PabloSoage/kv260-ias2rf/README.md

# KV260-IAS2RF — an RF front-end carrier for the AMD Kria KV260

**Status (12 November 2026): schematic and layout complete, on 8 layers. The board is fully routed, with zero
DRC errors and zero schematic-parity problems. It has not been fabricated, and no hardware has
been validated.** A few review items remain before an order (see [Status](#status)).

> **Rev06 (14 November 2026), now on `main`; Rev05 is tag `rev05`.** Rev06 gives Gigabit Ethernet its own FPGA pins, so the IAS1 link keeps
> both uplink lanes and its downlink and Ethernet adds about 1 Gb/s on top: either path works alone, both
> together carry about 3 Gb/s, with failover in the gateware ([CONTROL_SPEC §8](docs/CONTROL_SPEC.md),
> [fpga/eth/REV06.md](fpga/eth/REV06.md)). It also adds a 5 V fan header for enclosure v2
> ([ENCLOSURE §6](docs/ENCLOSURE.md)). Routed with zero DRC errors and zero parity problems. The full pre-order
> review (RF, power, ESD, thermal, routing, the enclosure's 3-D FEA with the boards, and the two-FPGA system
> simulation) is [docs/REV06_REVIEW.md](docs/REV06_REVIEW.md).

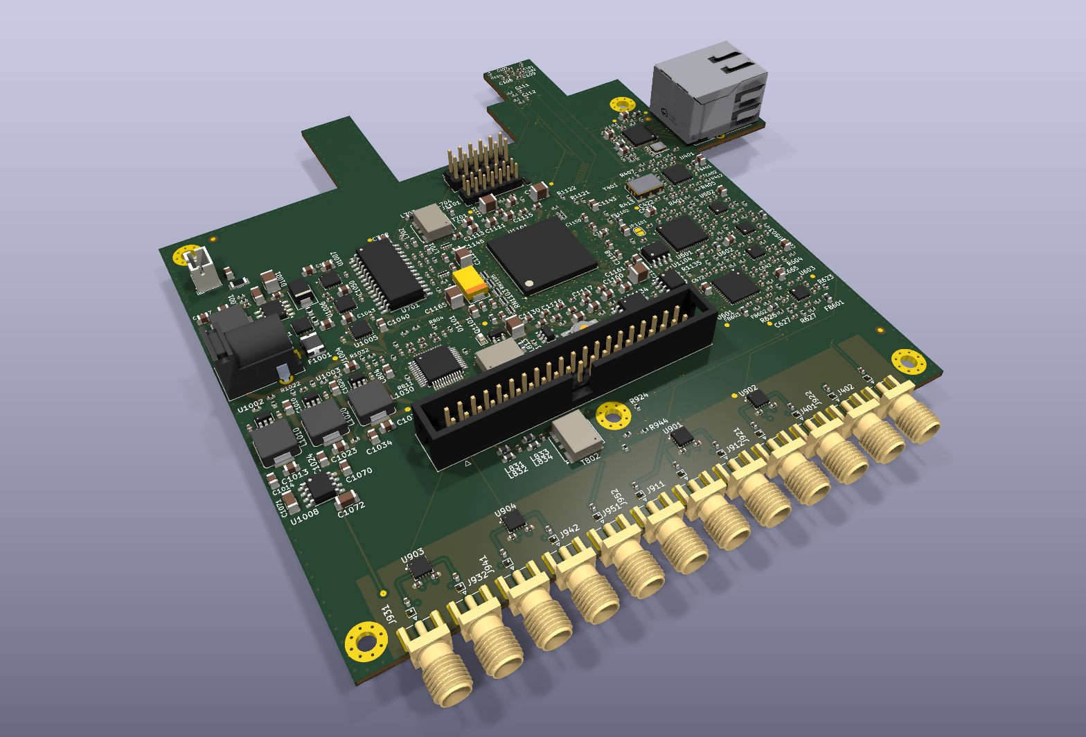
[picture p1: docs/img/board_iso.png]
The board, 3D render


An adapter board for the **AMD Kria KV260 Vision AI Starter Kit**. It plugs into the KV260's IAS1
camera connector and carries the converters, a common clock and a front-end FPGA. It serves two
signal chains:

- **Software-defined radio**: HF, AM, FM, airband, amateur bands and PMR446. Receive, and
  transmit on the bands a licence covers.
- **Radar at 10.5 GHz**: the IF of the X-band chain from the open
  [AERIS-10 / PLFM_RADAR](https://github.com/NawfalMotii79/PLFM_RADAR) project, with ADAR1000
  beamforming. The 10.5 GHz chain itself is reused from AERIS-10, not redesigned here. The board
  is sized for 8 ADAR1000s (32 channels), so it covers both the Nexus variant (4 chips) and the
  Extended one (8 chips).

> ### The finding that shapes the whole project
>
> The **IAS0 (J7) connector on the KV260 does not reach the programmable logic**: its MIPI lanes
> run into an AP1302 ISP soldered on the carrier card. Only **IAS1 (J8)** is wired straight to
> the SOM. On top of that, **the KV260 has no 40-pin Raspberry Pi header** (J9 is a 15-pin
> camera connector), and **the GTH transceivers are not exposed**.
>
> The real I/O budget between a KV260 and an external board is **8 differential pairs and about
> 14 single-ended signals**. That is why the board has its own FPGA. The evidence and sources are
> in [docs/BLOCKERS_AND_RISKS.md](docs/BLOCKERS_AND_RISKS.md).

---

## The board at a glance

| | |
|---|---|
| Size | 119 × 132 mm, 140 × 132 with the RJ45's tab. It mounts on the KV260's IAS connectors and corner holes and overhangs to one side ([INTERFACE_SPEC §5.3](docs/INTERFACE_SPEC.md)) |
| Stackup | 8 layers, JLCPCB JLC08161H-2116C: signal, GND, signal, split power, GND, signal, GND, signal ([LAYOUT §3](docs/LAYOUT.md); 6 layers until 12 Nov, [compared in EIGHT_LAYERS](docs/EIGHT_LAYERS.md)) |
| Parts | 534 fitted: the top face, plus 20 on the bottom face under the FPGA (LVDS terminations and VCCINT caps); 4 DNP for the Ethernet option |
| Front-end FPGA | Xilinx XC7A50T-2FTG256I (the same part as AERIS-10) with a 128 Mb QSPI flash, plus JTAG |
| Radar ADC | AD9484, 8 bit, 400 MSPS, driven by two cascaded AD8352s |
| SDR ADC | AD9253, 14 bit, two channels at 62.5 MSPS (one LVDS lane each) |
| Radar DAC | AD9708, with reconstruction filter and balun |
| SDR DAC | AD9767, dual 14 bit, two output chains |
| Clock | Si549 programmable XO (400 or 500 MHz, GPS-disciplinable) into an ADCLK948 LVPECL fan-out |
| RF routing | Four M3SWA2-34DR+ SPDT switches and ten edge SMAs, plus two clock SMAs |
| Link to the Kria | IAS1 (Hirose BM20B), five LVDS pairs at up to 1 Gb/s each, AC-coupled; the Pmod J2 for control |
| Ethernet (option) | Gigabit RJ45 through an RTL8211FSI SGMII PHY, which shares two of the link's pairs: fit C1218–C1221 and remove C101, C102, C107, C108 to use it ([CONTROL_SPEC §7](docs/CONTROL_SPEC.md)) |
| To AERIS-10 | 2×20 IDC ribbon for eight ADAR1000s |
| Power | 12 V in; buck and LDO tree for 5 V, 3.3 V, 2.5 V, 1.8 V and 1.0 V, plus −3.3 V for the switches |

```mermaid
flowchart LR
  KV260["Kria KV260<br/>(K26 SOM)"] <-- "IAS1: 5 LVDS pairs<br/>Pmod: control" --> FPGA["XC7A50T<br/>front-end FPGA"]
  FPGA <-- LVDS --> ADCR["AD9484<br/>radar ADC"]
  FPGA <-- LVDS --> ADCS["AD9253<br/>SDR ADC"]
  FPGA --> DACR["AD9708<br/>radar DAC"]
  FPGA --> DACS["AD9767<br/>SDR DAC"]
  CLK["Si549 + ADCLK948<br/>clock"] --> ADCR & ADCS & DACR & DACS & FPGA
  ADCR & ADCS & DACR & DACS <--> RF["RF switches<br/>10 SMAs"]
  FPGA <-- "IDC ribbon" --> AERIS["AERIS-10<br/>8 × ADAR1000"]
  RF <--> AERIS
```

| Top | Bottom |
|---|---|
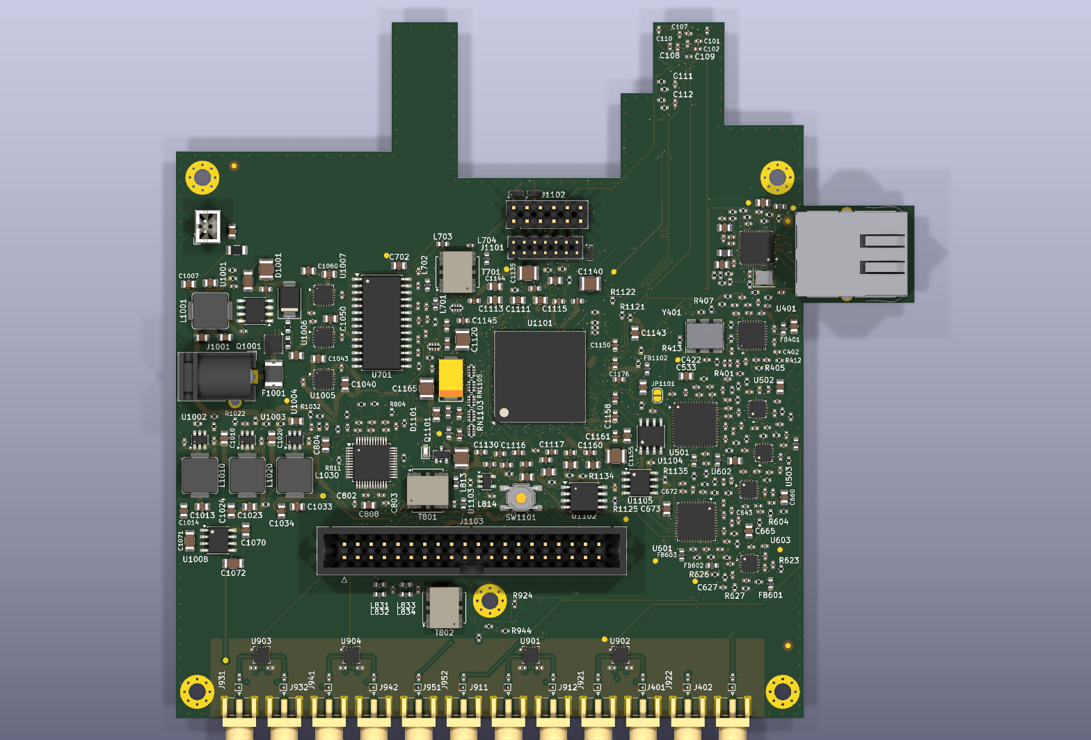
[picture p2: docs/img/board_top.png]
Top
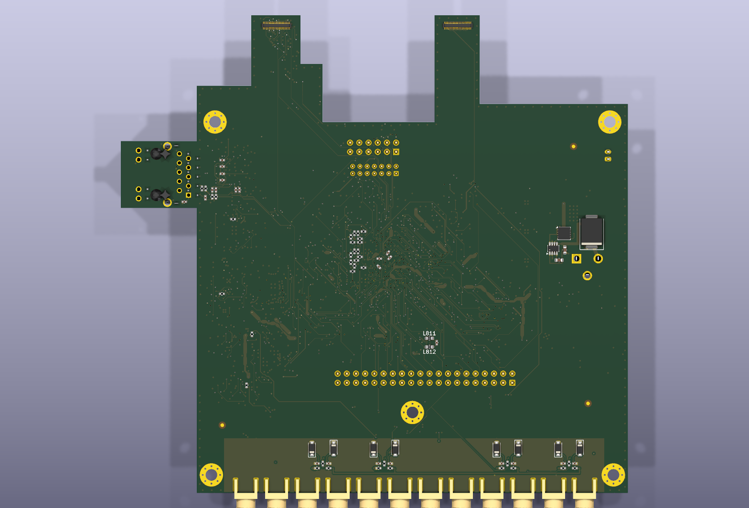
[picture p3: docs/img/board_bottom.png]
Bottom
|  |  |

The renders come from KiCad. Some parts have no 3D model, so they show only their pads (the FPGA's
BGA, for one).

---

## Schematics and layout

- **[Schematic, all 10 sheets (PDF)](docs/CSI2-KRIA-KV260_Rev04_schematic.pdf)**
- **[Layout, the eight copper layers and both silkscreens (PDF)](docs/CSI2-KRIA-KV260_Rev04_layout.pdf)**
- KiCad 10 sources: [`CSI2-KRIA-KV260_Rev01.kicad_pro`](CSI2-KRIA-KV260_Rev01.kicad_pro), the root
  schematic and [`rev03/`](rev03/) (the nine sheets), the board
  [`CSI2-KRIA-KV260_Rev01.kicad_pcb`](CSI2-KRIA-KV260_Rev01.kicad_pcb), and the project's own
  symbols and footprints in [`symbols/`](symbols/) and [`footprints/`](footprints/). The file names
  keep the Rev01 name of the board they started from, and the sheets sit in `rev03/` where they
  were drawn; the contents are Rev04 (the 8-layer board, 12 Nov 2026).

| Sheet | Contents | Specification |
|---|---|---|
| [Root](docs/img/sch/ROOT.png) | Sheet hierarchy and the interface nets | [ARCHITECTURE](ARCHITECTURE.md) |
| [IAS_LINK](docs/img/sch/IAS_LINK.png) | The Hirose connectors, AC coupling and terminations of the link | [IAS_LINK_SPEC](docs/IAS_LINK_SPEC.md) |
| [CLOCK](docs/img/sch/CLOCK.png) | Si549, reference select and LVPECL fan-out | [CLOCK_SPEC](docs/CLOCK_SPEC.md) |
| [ADC_RADAR](docs/img/sch/ADC_RADAR.png) | AD9484 and its two AD8352 drivers | [ADC_RADAR_SPEC](docs/ADC_RADAR_SPEC.md) |
| [ADC_SDR](docs/img/sch/ADC_SDR.png) | AD9253, two channels | [ADC_SDR_SPEC](docs/ADC_SDR_SPEC.md) |
| [DAC_RADAR](docs/img/sch/DAC_RADAR.png) | AD9708, filter and balun | [DAC_RADAR_SPEC](docs/DAC_RADAR_SPEC.md) |
| [DAC_SDR](docs/img/sch/DAC_SDR.png) | AD9767 in interleaved mode, two output chains | [DAC_SDR_SPEC](docs/DAC_SDR_SPEC.md) |
| [ROUTING](docs/img/sch/ROUTING.png) | Four RF switches and the SMAs | [ROUTING_SPEC](docs/ROUTING_SPEC.md) |
| [CONTROL](docs/img/sch/CONTROL.png) | The front-end FPGA: banks, configuration, Pmod, AERIS ribbon, housekeeping | [CONTROL_SPEC](docs/CONTROL_SPEC.md) |
| [POWER](docs/img/sch/POWER.png) | The power tree | [POWER_SPEC](docs/POWER_SPEC.md) |

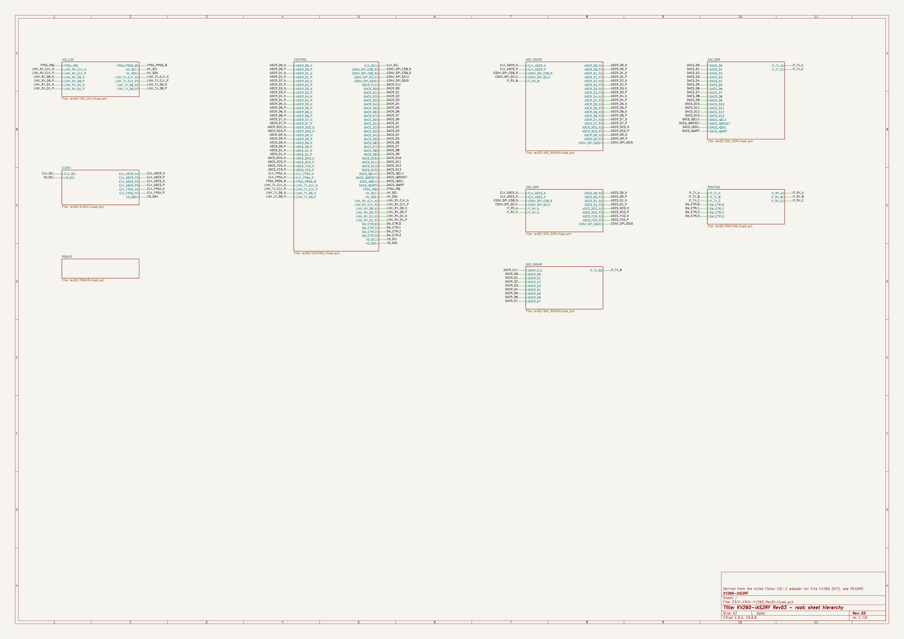
[picture p4: docs/img/sch/ROOT.png]
Root sheet


---

## Status

| Check | Result |
|---|---|
| ERC | 0 errors; 7 warnings, all explained: configuration and XADC pins tied to power on purpose ([CONTROL_SPEC §5](docs/CONTROL_SPEC.md)) |
| DRC, zones refilled | **0 violations, 0 unrouted connections, 0 schematic-parity problems** (12 Nov, on 8 layers) |
| Signal and power integrity | Reviewed on 11 Nov and re-run on 8 layers on 12 Nov, ideal / 6 / 8 layers side by side ([EIGHT_LAYERS.md](docs/EIGHT_LAYERS.md), [SIGNAL_INTEGRITY.md](docs/SIGNAL_INTEGRITY.md)): SMA launch in openEMS (S11 −30.9 dB at 1 GHz with the ESD diode), LVDS eyes within 1–26 mV of ideal except LINK_RX_D0 (−52 mV), worst intra-pair skew 9 ps, VCCINT under its target to 100 MHz with four caps under the BGA; ESD protection on every SMA, the Pmod and JTAG, a GND via within 3 mm of every LVDS layer change, exposed-pad vias and an edge fence |
| Planes | L2 and L5 carry only ground, no supply track (`_work/layout/planechk.py`); every supply pin reaches its island (the DRC's zero unrouted) |
| Mechanical fit | Registered on AMD's 3D model of the KV260: the mounting holes land within 5 µm ([INTERFACE_SPEC §5.3](docs/INTERFACE_SPEC.md)) |

**Open before ordering** ([docs/LAYOUT.md §6.2–6.3](docs/LAYOUT.md)):

1. **The rest of the board, reviewed on 12 Nov** ([SIGNAL_INTEGRITY §9](docs/SIGNAL_INTEGRITY.md)).
   - **Fixed.** The router had necked supply tracks and the bucks' switch nodes to 0.1 mm: 1.6 A
     through 0.1 mm at U1001, and a 251 mV drop on the ADCs' +1V8_A. The supply tracks are now
     widened (865 mm at ≥ 0.5 mm, against 119), and +1V8_A starts at 1.85 V to cover what is
     left of the drop.
   - **Analogue nodes.** Digital tracks beside the analogue nodes are down to 81 mm within
     0.3 mm, from 91. Most of what was left was where the SDR DAC's filters crossed the DAC bus.
     On 12 Nov DAC2's filter was re-placed next to its balun and DAC1's middle node re-routed as
     a pair: their digital neighbours went from 59 mm to 14 mm. DAC2's common mode at the balun
     fell by 9–21 dB. On 13 Nov DAC1's filter followed, onto the bottom face under T801 (its
     middle node 51 → 3 mm, common mode 1–6 dB lower), the reference oscillator's pair was
     coupled and matched, and the SDR ADC's input network was simulated: its copper costs
     nothing in band, so it stays.
   - **Thermal.** 7.5 W on 134 cm² in still air (with the Ethernet PHY): +27 °C mean and +51 °C at the clock buffer. Fine
     on the bench. A vehicle install needs airflow or a path to the enclosure.
2. **Ten of the 19 LVDS pairs are not coupled** (11 of 22 counting U401's three clock pairs:
   `CLK_ADCS` and `CLK_FPGA` were re-routed as coupled pairs on 12 Nov, `CLK_FPGA` after its
   four pad resistors were re-placed together; SIGNAL_INTEGRITY §9.4). Since 12 Nov the board has 8 layers and nine pairs
   run coupled at 100 Ω end to end ([EIGHT_LAYERS.md](docs/EIGHT_LAYERS.md)). The other ten are
   two 50 Ω legs matched to ±5 ps, within 1–26 mV of their ideal eye except LINK_RX_D0 (−52 mV).
   LINK_RX leaves bank 34, the only 2.5 V bank, in the BGA's south-east corner, and crosses every
   ADC pair to AC capacitors spread 9 mm apart; moving it to the bank's outer balls was tried on
   12 Nov and dropped (the corner has no room left for the vias). Coupling it would need the
   capacitors at J101 moved together first.
3. **ADCR data to DCO skew, −90 to +5 ps** (was −177 to −28). DCO's legs are swapped at the FPGA
   (N14 = DCO_N, P14 = DCO_P) so the pair reaches the AD9484 the right way round without going
   round the chip: 39 mm instead of 51. **The gateware must invert that clock** (ISERDESE2
   `IS_CLK_INVERTED`, or capture on the other edge) ([CONTROL_SPEC §1](docs/CONTROL_SPEC.md)).
   The rest is inside IDELAYE2's range and calibrated per bit.
4. **Order the 2116C stack explicitly** (JLC08161H-2116C): the widths are solved for it
   ([FABRICATION.md](docs/FABRICATION.md)). Five 8-layer bare boards: $287.96 at 140 × 132 mm with the Ethernet tab ($282.92 without it, $236.88 on 6 layers).
5. **The Kria side of the link is `DIFF_SSTL12`, not `LVDS_12`** (UG571 read on 12 Nov,
   [INTERFACE_SPEC §6.3](docs/INTERFACE_SPEC.md)). No `LVDS_12` exists. `LVDS` at 1.2 V is
   input-only with no internal termination. `DIFF_SSTL12` has on-die split termination
   (`RTT_48`, about 96 Ω biased at 0.6 V) and drives through `RDRV_60_60`. No change to the board.
   Still to confirm in DS925: its input threshold and the −2LV rate ceiling. The link carries 2 Gb/s towards the Kria and 1 Gb/s back (two of its five
   pairs are clocks), with a ceiling of about 1.25 Gb/s per pair set by the silicon
   ([IAS_LINK_SPEC §7](docs/IAS_LINK_SPEC.md)).
6. **3-D full-wave sub-models (openEMS), not yet inside the eye simulation.**
   - **Layer change L1 to L6.** The pair reflects under −29 dB up to 1.25 GHz, with or without
     ground vias. Without them 7 % of the common mode's power leaks into the plane cavity; with
     two, 1 %.
   - **BGA escape.** The 0.10 mm necks reflect under −24 dB at 1.25 GHz.
   - **Two pairs side by side.** The board's worst run couples 1.9 % of a 300 ps edge onto the
     nearest leg, not the 7 % the 2-D estimate gave.
   - **J101's footprint**, from the Hirose pins to the AC capacitors: reflection under −25 dB to 1.25 GHz,
     but the legs' different escapes turn 9 % of the differential wave into common mode.

   Done, in [SIGNAL_INTEGRITY §9.6](docs/SIGNAL_INTEGRITY.md):
   - **Receive budgets.** Radar: full scale −17.6 dBm, NF 26.8 dB. SDR: full scale −2.4 and
     −3.0 dBm, NF 22 dB. On both, the ADC is 80–92 % of the noise.
   - **Transmit levels** and **the DAC filters with their copper.**
   - **The board's thermal map**, with junctions for every part that has data. At 25 °C in still
     air, the hottest junction is the ADCLK948 at 84 °C and the FPGA is at 63 °C. A vehicle
     needs airflow: a heatsink on the ICs and the regulators, with a fan, keeps every junction
     under 92 °C at 70 °C ambient.

   The first boards are for evaluation.
7. **The AERIS-10 end of the ribbon does not exist yet.**
8. **No firmware.** The FPGA design for the front end and the Kria side of the link are not
   written yet.

**Cost** ([docs/JLCPCB_QUOTE.md](docs/JLCPCB_QUOTE.md), bare boards re-quoted on 8 layers on 12 Nov 2026): about **$2,070 for two
assembled boards** and $4,240 for five, three quarters of it parts. Seven parts are out of stock at
LCSC today (the ADCs, the RF switches, the clock buffer, the DAC, a balun and the drivers): JLCPCB's
global sourcing or consigned parts cover them.

---

## Documentation

| Document | Contents |
|---|---|
| **[docs/VEHICLE_PLATFORM.md](docs/VEHICLE_PLATFORM.md)** | **System view.** The whole vehicle project: LiDAR, SDR, radar, OBD2 |
| [docs/SHOPPING_LIST.md](docs/SHOPPING_LIST.md) | Parts and checklist per stage, with indicative costs |
| [ARCHITECTURE.md](ARCHITECTURE.md) | Master document for this board: the Rev03 architecture and BOM |
| [docs/BLOCKERS_AND_RISKS.md](docs/BLOCKERS_AND_RISKS.md) | The five blockers, closed, with evidence and sources, plus the open risks |
| [docs/INTERFACE_SPEC.md](docs/INTERFACE_SPEC.md) | Pin map for J8 and the Pmod, the mechanical envelope, the adapter registered on the KV260 model |
| [docs/POWER_AND_STACKUP.md](docs/POWER_AND_STACKUP.md) | Per-rail current budget and the original 6-layer stackup with computed trace widths |
| [docs/SYMBOLS.md](docs/SYMBOLS.md) | The project's symbols, each from its datasheet, cross-checked against a second source where one exists |
| Sheet specifications | One per schematic sheet, in the table above: every value and where it comes from |
| [docs/LAYOUT.md](docs/LAYOUT.md) | The board: outline, stackup, rules, the split power layer, placement, routing and the LVDS review |
| [docs/EIGHT_LAYERS.md](docs/EIGHT_LAYERS.md) | The 8-layer board against the 6-layer one: stacks, every check side by side, eyes, skew, PDN, SMA, and what the same corrections would give on 6 layers |
| [docs/SIGNAL_INTEGRITY.md](docs/SIGNAL_INTEGRITY.md) | The RF/high-speed review (11 Nov) and the 8-layer re-run (12 Nov, §8): impedance, SMA launch (openEMS), LVDS eyes (ngspice), PDN impedance and DC drop, crosstalk, return vias, what is still a compromise; figures and data in [docs/sim/](docs/sim/) |
| [docs/FABRICATION.md](docs/FABRICATION.md) | Ordering from JLCPCB: the output script, the order form, what is left for the day of the order |
| [docs/JLCPCB_QUOTE.md](docs/JLCPCB_QUOTE.md) | What the JLCPCB order would cost (10 Nov 2026, bare boards on 8 layers 12 Nov, re-quoted with the Ethernet tab 13 Nov): boards, assembly fees and every part with its LCSC link and price. About $2,125 for two assembled boards, $4,310 for five |
| [docs/ROADMAP.md](docs/ROADMAP.md) | Staged plan with verifiable exit criteria |
| [docs/AUDIT_Rev01.md](docs/AUDIT_Rev01.md), [docs/HISTORY_Rev01.md](docs/HISTORY_Rev01.md) | What the inherited files contained, and the record of the earlier work |

---

## Repository layout

| Path | Contents |
|---|---|
| `CSI2-KRIA-KV260_Rev01.*`, `rev03/` | The KiCad project: root schematic, nine sheets, board |
| `symbols/`, `footprints/` | The project's own libraries |
| `docs/` | Specifications, layout and fabrication notes, renders and the PDFs |
| `_work/` | The scripts behind every finding and every step of the layout: symbols and footprints, sheet checks, placement (`_work/layout/build_board.py`), plane and LVDS checks, fabrication outputs |
| `fab/` | Not tracked. `python _work/fab/make_fab.py` writes Gerbers, drill, BOM and CPL there for JLCPCB |
| `PCB/`, `Documents/` | The original Allied Vision sources (Altium) and their outputs, untouched |
| `_backup_original/`, `_deprecated/` | Snapshots of the inherited files and the sheets removed from the project |

Reproducing the checks and the outputs (KiCad 10):

```bash
kicad-cli sch erc --severity-all CSI2-KRIA-KV260_Rev01.kicad_sch
kicad-cli pcb drc --schematic-parity --refill-zones --severity-all CSI2-KRIA-KV260_Rev01.kicad_pcb
python _work/fab/make_fab.py                                   # fab/: Gerbers, drill, BOM, CPL
python _work/fab/quote.py                                      # today's LCSC prices and stock; refreshes docs/JLCPCB_QUOTE.md
python _work/layout/lvds_skew.py CSI2-KRIA-KV260_Rev01.kicad_pcb  # LVDS delays, skew and stubs; --stubs PS lists the branches (needs shapely)
```

---

## Related work

The DSP core this board will need already exists, runs on real silicon and is published
separately:

**[scanner64](https://github.com/PabloSoage/scanner64)**: a real-time multichannel DDC bank for
the KV260's PL. Measured on the board: 100.05 MSPS sustained, no samples dropped across
200 million, bit-exact against its Python model, 8.38 mW per channel, 169.9 MHz Fmax post-route.

That project answers, with hardware, the question this board is built around: whether the PL can
sustain a converter stream in real time. It can.

---

## Where the project came from, and attribution

This is a **fork** of the open hardware design
[Allied Vision Adapter Board CSI-2 for Kria KV260](https://github.com/alliedvision), published
under the MIT licence (see [LICENSE](LICENSE)). What is kept from that design:

- the board's mechanical fit to the KV260 (the outline was extended)
- the two Hirose BM20B(0.8)-34DP connectors (IAS0 / IAS1) and their wiring to the SOM

Everything else (the MIPI camera electronics, level shifters, USB power) was removed and replaced
by the RF chain described here. **This repository no longer produces an Allied Vision camera
adapter board.** If that is what you want, use the original project.

---

## Simulation results

Every figure compares three cases: an **ideal** line, the board on **6 layers** (JLC06161H-2116A,
11 November 2026) and on **8 layers** (JLC08161H-2116C, the board in this repository), all run
through the same scripts. The full comparison is in [docs/EIGHT_LAYERS.md](docs/EIGHT_LAYERS.md),
the method in [docs/SIGNAL_INTEGRITY.md](docs/SIGNAL_INTEGRITY.md).

| Check | 6 layers | 8 layers |
|---|---|---|
| Pairs routed coupled | 0 of 19 | 9 of 19 |
| Worst intra-pair \|P−N\| | 84 ps | 9 ps |
| Eye lost to routing (routed − ideal) | mean −22 mV, worst −113 mV | mean −8 mV, worst −52 mV |
| Zero-crossing spread added | mean 5 ps, worst 29 ps | mean 1 ps, worst 10 ps |
| Layer changes with no GND via within 3 mm | 1 of 186 | 0 of 89 |
| Other pairs' legs within 0.25 mm | 97.6 mm | 65.8 mm |
| Signal tracks on L4 under the BGA | 64 segments | 3 (supply stubs) |
| ADCR data − DCO | −88 … −23 ps | −90 … +5 ps (DCO re-routed 12 Nov; IDELAY absorbs it) |
| VCCINT impedance, max in band / at 100 MHz (target 120 mΩ) | 51 / 61 mΩ | 41 / 63 mΩ |
| DC drop +2V5 at 601 mA | 173–185 mV | 122–129 mV |
| SMA launch S11 at 1 / 3 GHz, with the ESD diode | −30.6 / −13.5 dB | −30.9 / −13.7 dB |

**LVDS eyes** (ngspice, PRBS7 at 1 Gb/s, each leg's copper by layer and width). The ideal line
depends on each board's pair length and termination, so each board is shown against its own ideal.

| Pair | 6 layers: ideal / routed | 8 layers: ideal / routed |
|---|---|---|
| LINK_RX_D1 | 575 / 559 mV, 75 / 77 ps | 385 / 372 mV, 41 / 51 ps |
| LINK_RX_D0 | 607 / 559 mV, 35 / 30 ps | 509 / 457 mV, 25 / 31 ps |
| LINK_RX_CLK | 548 / 516 mV, 12 / 14 ps | 395 / 392 mV, 10 / 10 ps |
| ADCS_FCO | 648 / 650 mV, 49 / 46 ps | 628 / 617 mV, 17 / 17 ps |
| ADCR_DCO | 626 / 581 mV, 24 / 35 ps | 609 / 610 mV, 17 / 18 ps |

Eye opening at the centre of the bit, then zero-crossing spread. The LINK_RX eyes end at the AC
capacitors, not at the Kria's receiver, so they are indicative only; the opening is in every case
several times the receiver's ±100 mV threshold.

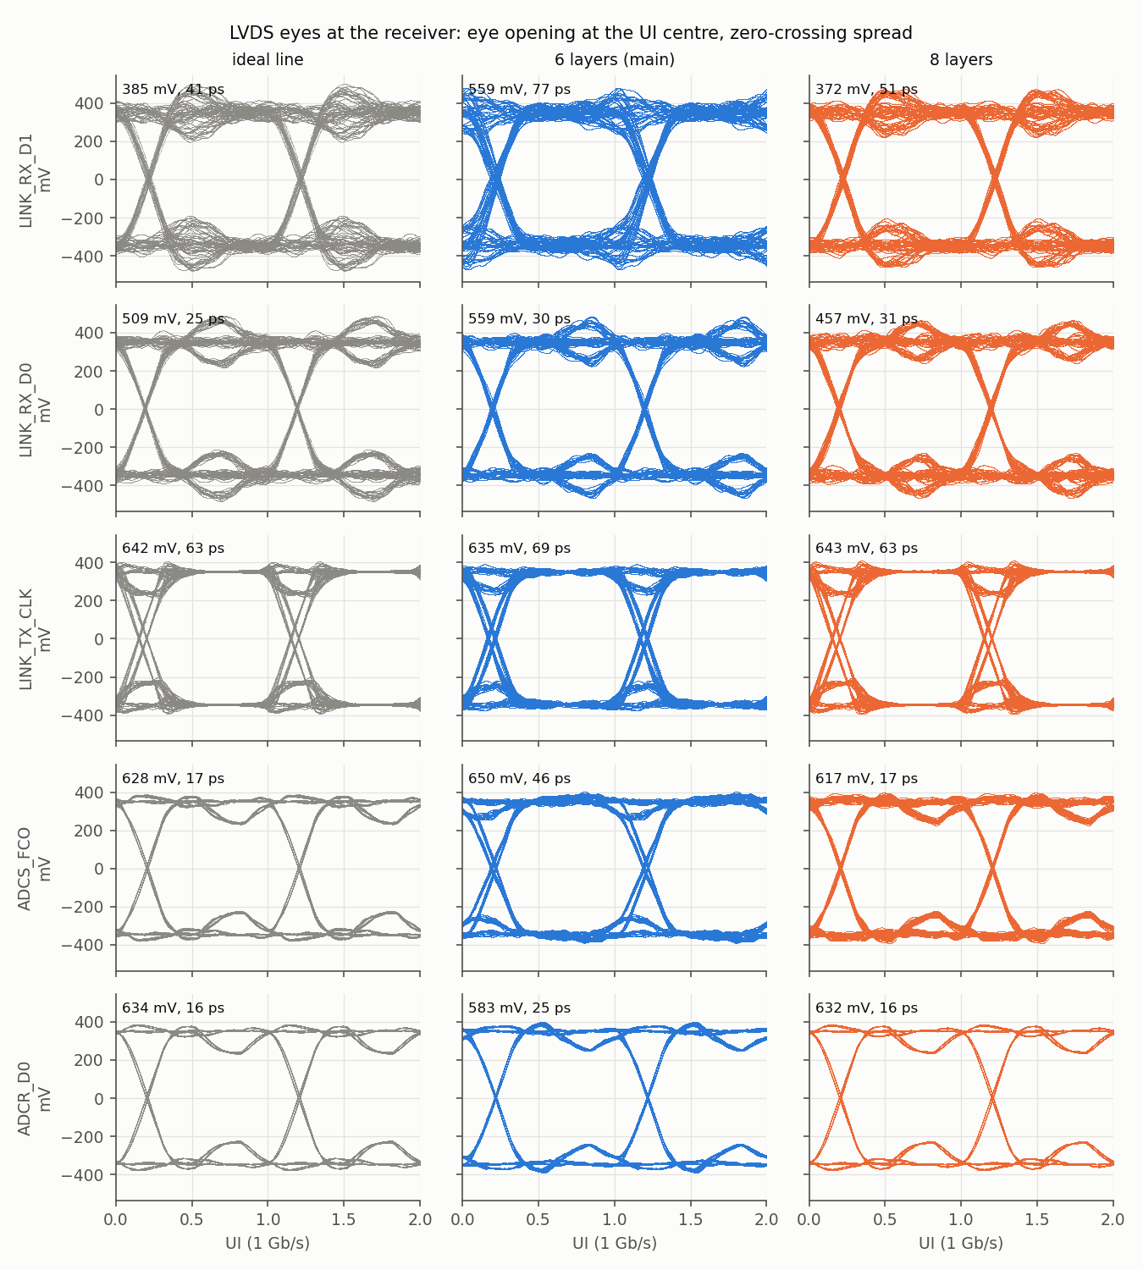
[picture p5: docs/sim/rev04_eyes.png]
Folded eyes: ideal, 6 layers, 8 layers


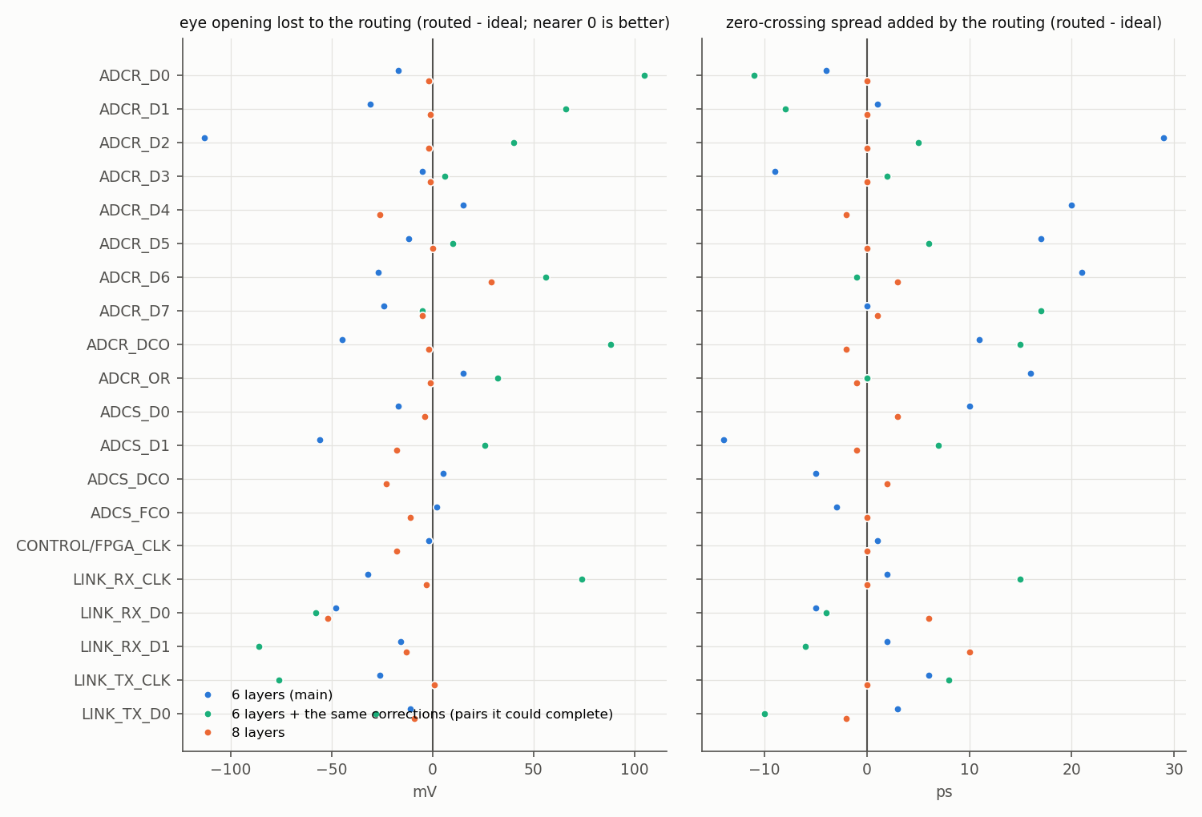
[picture p6: docs/sim/rev04_eye_penalty.png]
Eye penalty per pair


**Eye opening and zero-crossing spread** of every pair, three cases.

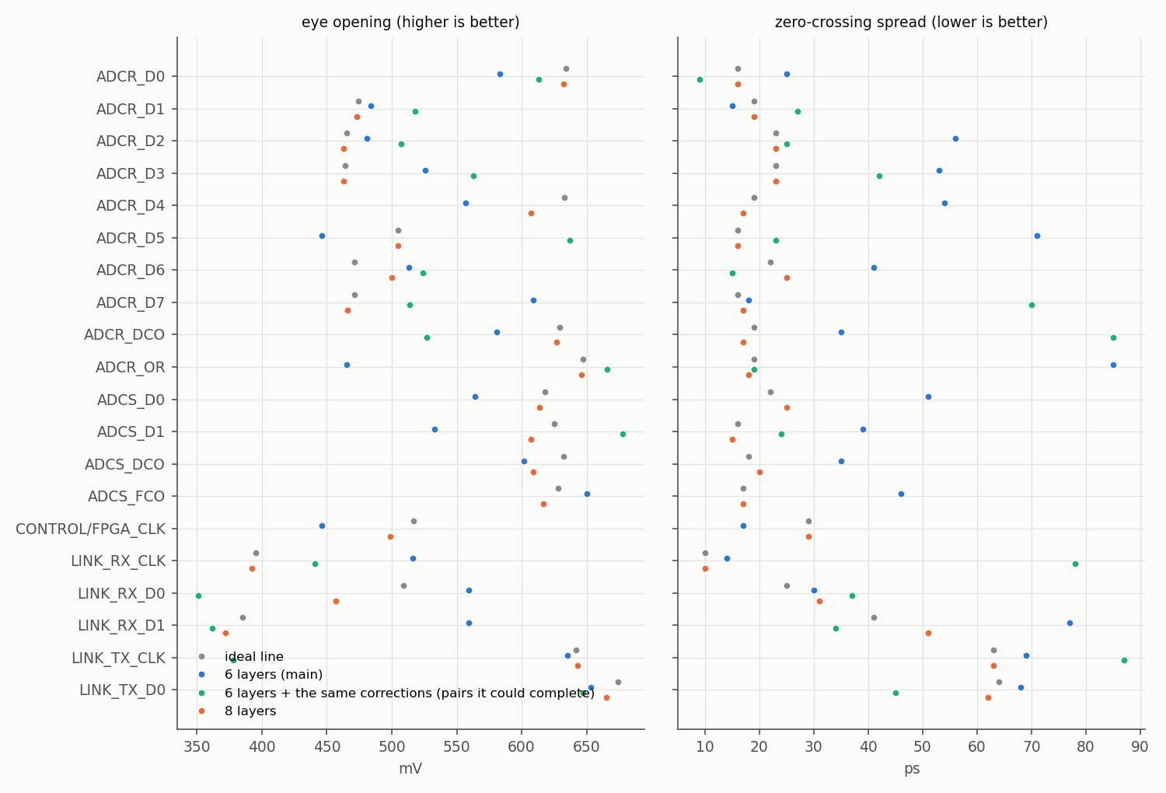
[picture p7: docs/sim/rev04_eye_open.png]
Eye opening per pair


**Intra-pair skew**, ball to pad, with the FPGA's package delay.

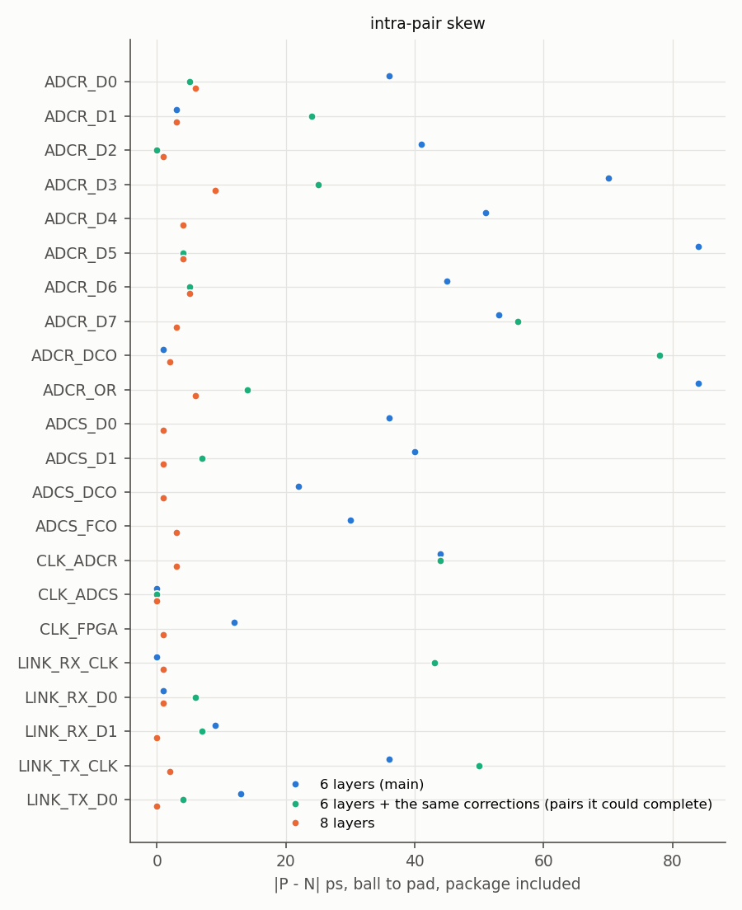
[picture p8: docs/sim/rev04_skew.png]
Intra-pair skew


**Power distribution** seen from the XC7A50T's balls. The L4/L5 plane pair keeps its spacing, so
the impedance barely moves.

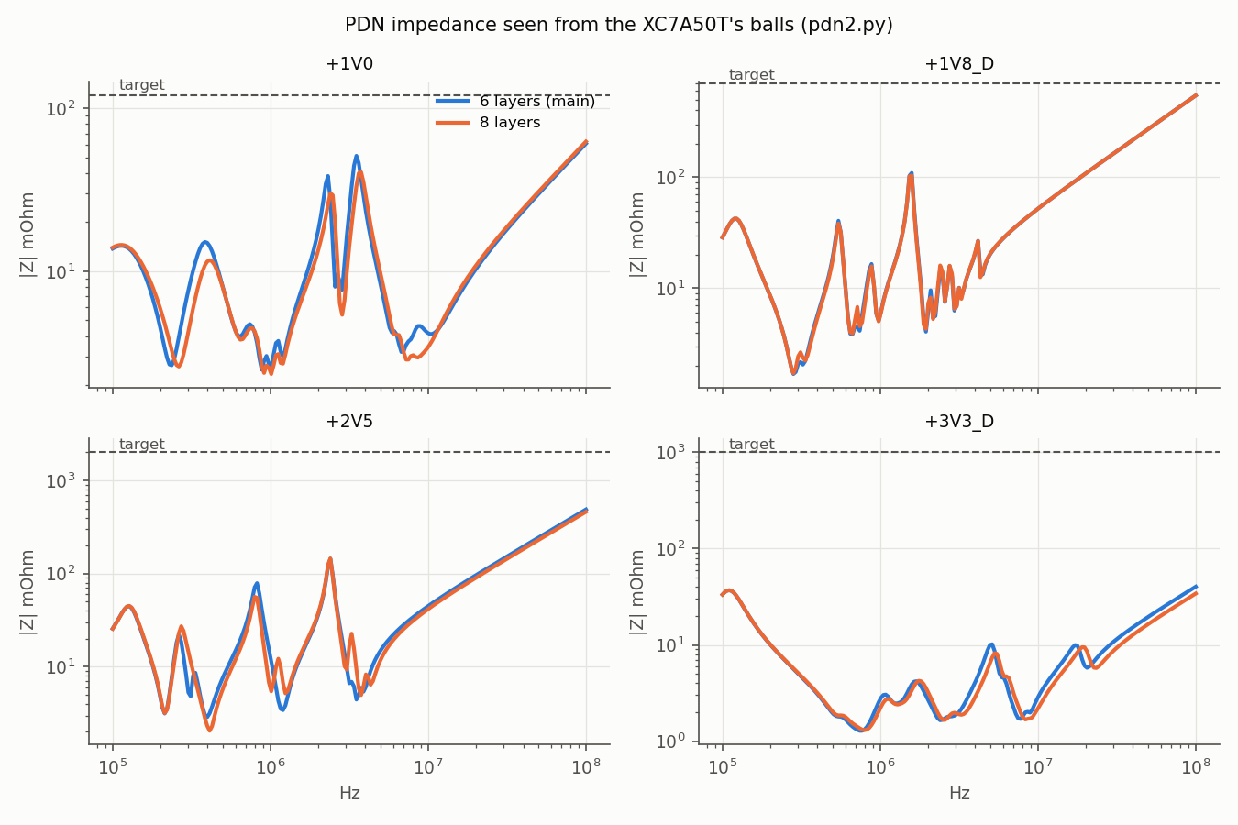
[picture p9: docs/sim/rev04_pdn.png]
PDN impedance


**Edge SMA launch** (openEMS FDTD) with its ESD diode. The outer prepreg is the same on both
stacks, and so is the launch.

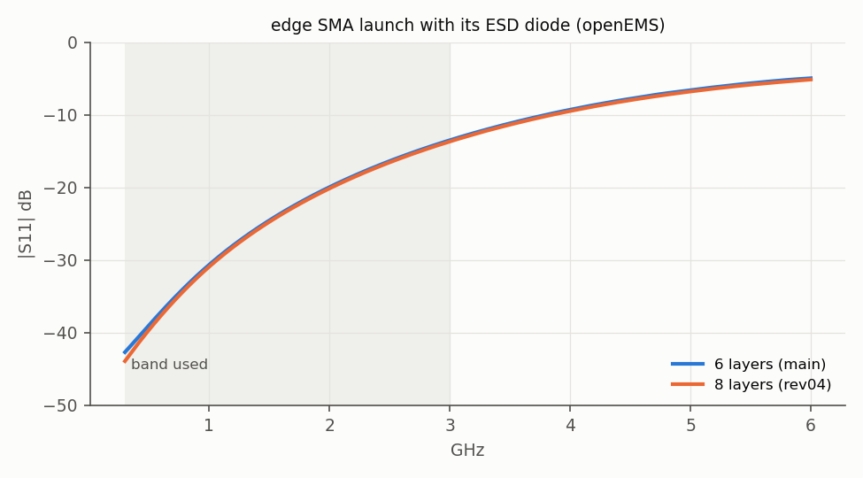
[picture p10: docs/sim/rev04_sma.png]
SMA launch


**DAC reconstruction filters** (ngspice), ideal and with each node's copper. The cut-off moves 4–9 %
down and the passband does not change. Below, the common mode at the balun before and after the
re-placement of 12 Nov ([SIGNAL_INTEGRITY §9.3](docs/SIGNAL_INTEGRITY.md)).

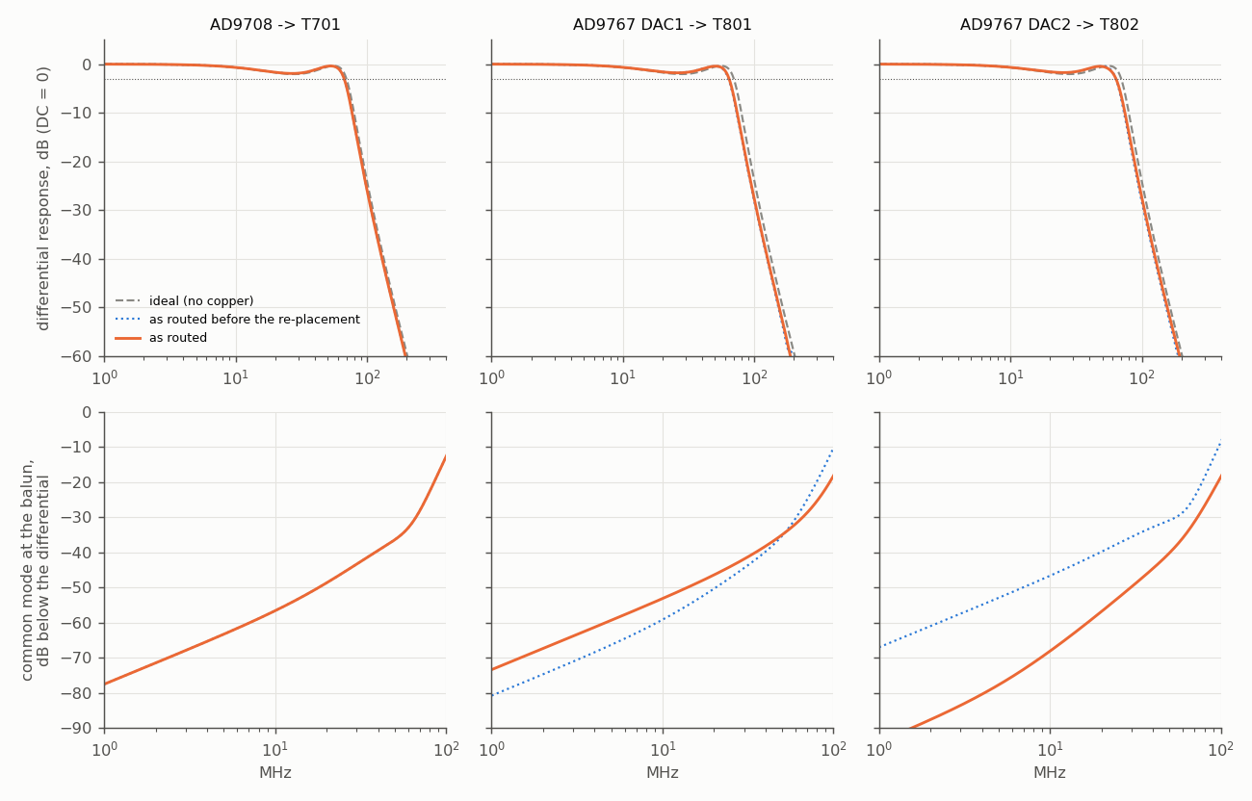
[picture p11: docs/sim/rev05_filters.png]
DAC reconstruction filters


**Board temperature** at 25 °C ambient in still air: a 2-D model with each layer's real copper,
convection from both faces, and the power budget's 7.5 W (re-run 13 Nov with the Ethernet PHY)
([SIGNAL_INTEGRITY §9.6](docs/SIGNAL_INTEGRITY.md)).

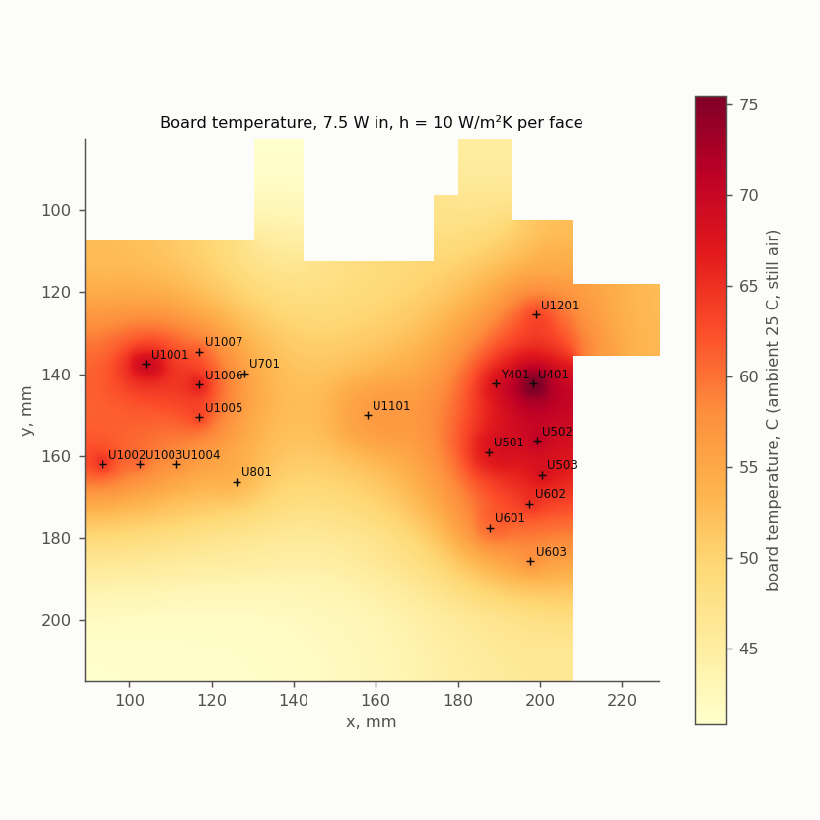
[picture p12: docs/sim/rev05_thermal.png]
Board temperature


**Five ways of cooling it**, on one colour scale: still air, a fan, a passive heatsink on the four
main ICs, the same with the regulators, and heatsink plus fan
([SIGNAL_INTEGRITY §9.6](docs/SIGNAL_INTEGRITY.md)).

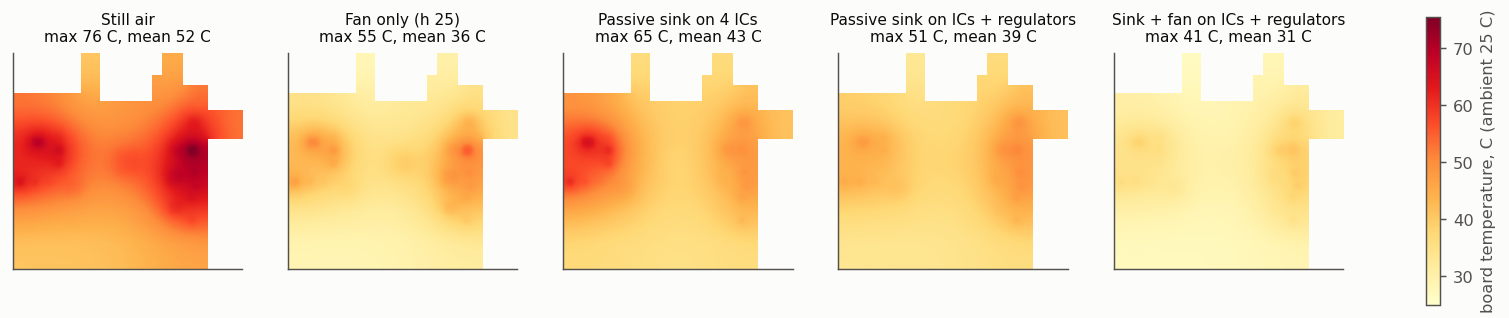
[picture p13: docs/sim/rev05_cooling.png]
Board temperature for five ways of cooling it


**An LVDS pair changing layer**, L1 to L6 through two vias, in 3-D (openEMS), four via
arrangements ([SIGNAL_INTEGRITY §9.6](docs/SIGNAL_INTEGRITY.md)).

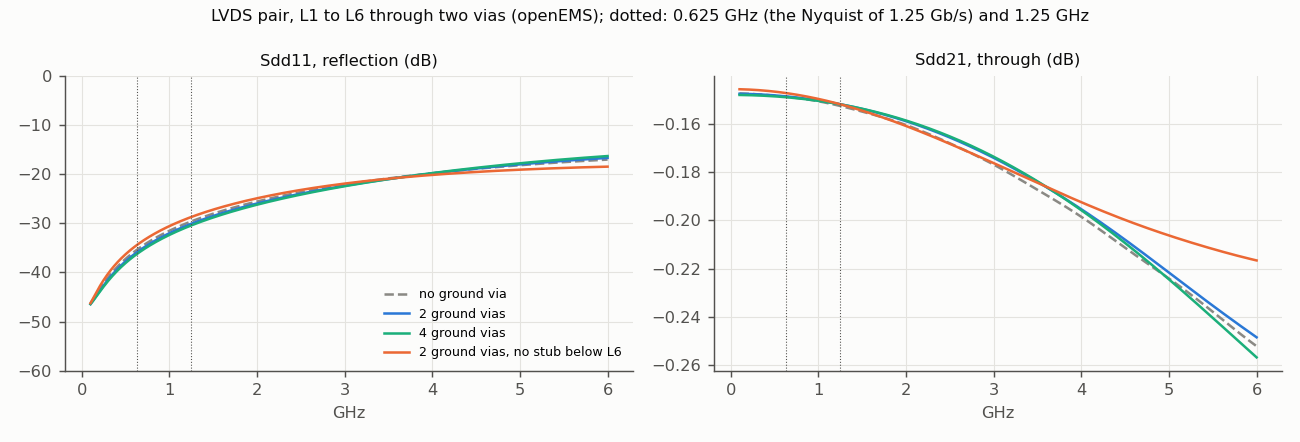
[picture p14: docs/sim/rev05_layer_change.png]
LVDS pair changing layer


**The other 3-D sub-models**: the BGA escape, J101's pins to the AC capacitors, two pairs side by
side, and the common mode through the layer change
([SIGNAL_INTEGRITY §9.6](docs/SIGNAL_INTEGRITY.md)).

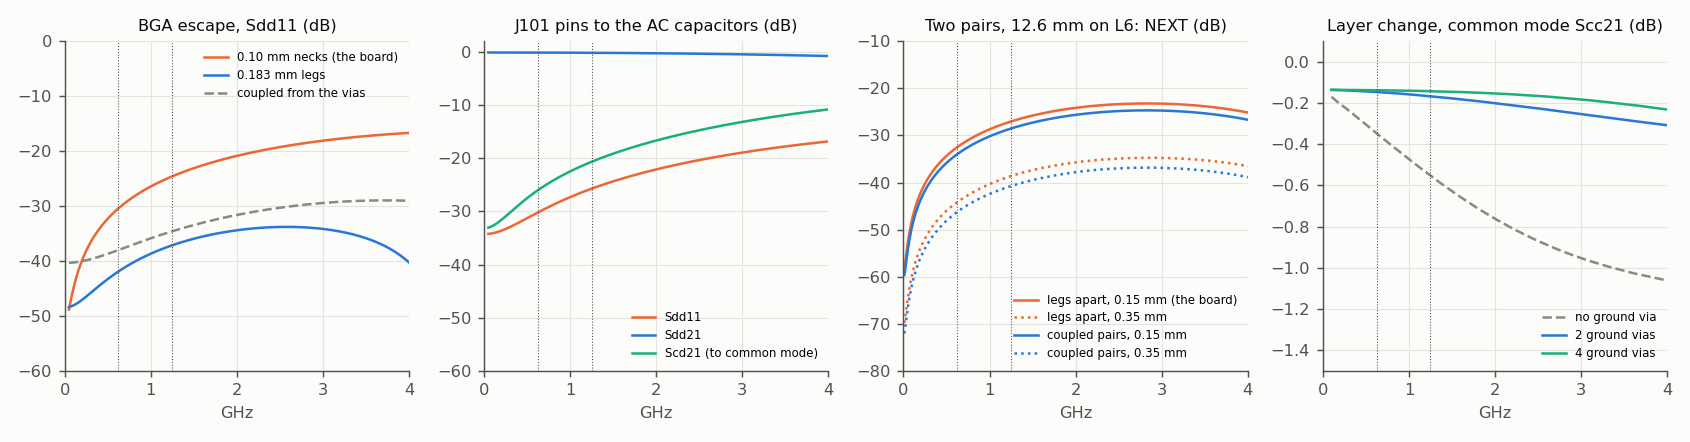
[picture p15: docs/sim/rev05_3d.png]
The other 3-D sub-models


**The Ethernet option** shares two link pairs through unfitted capacitors: what their branches cost
the IAS1 link, where C1218 went, and the Ethernet paths themselves
([SIGNAL_INTEGRITY §9.7](docs/SIGNAL_INTEGRITY.md)).

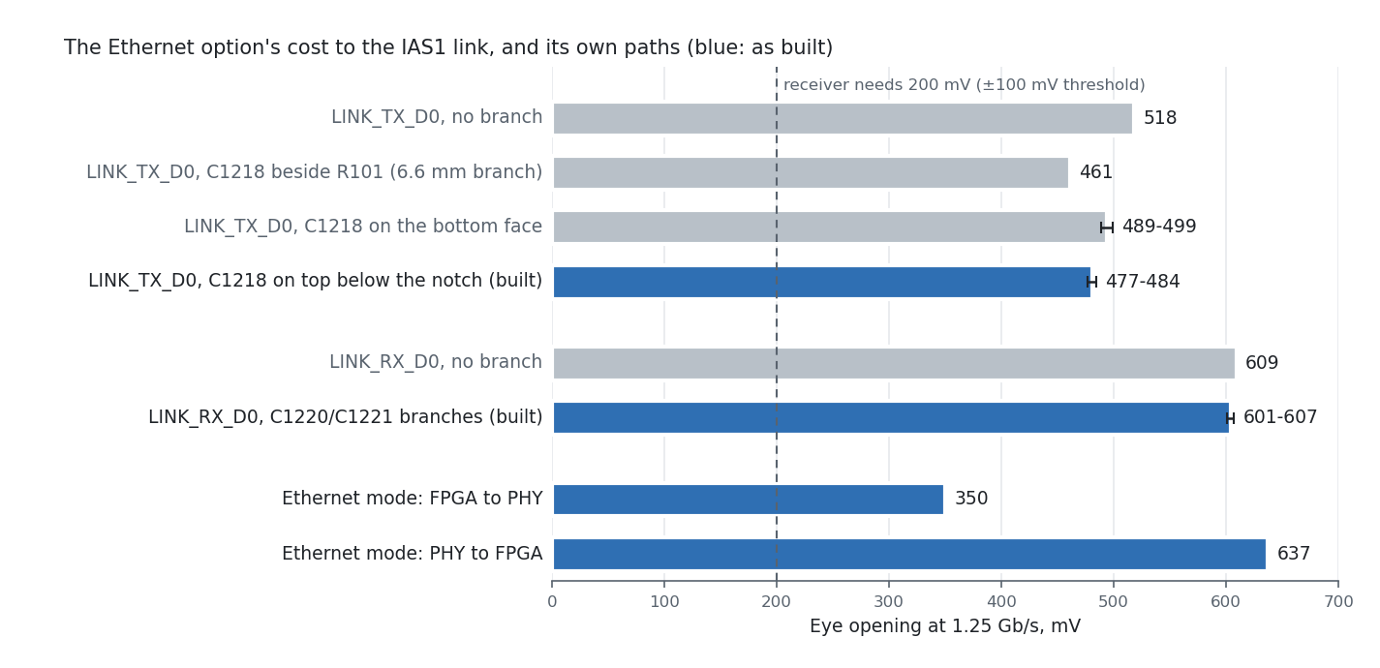
[picture p16: docs/sim/eth_branches.png]
Eye openings with the Ethernet option's branches


---

## Mounted on the KV260

A printed base holds the KV260 and the adapter together: posts in place of the carrier's rubber feet,
posts under the overhang, a wall that takes the SMA cables' torque, and a pedestal and strap that
carry the Ethernet tab ([MECHANICAL](docs/MECHANICAL.md); STLs in `mech/`). Rendered in Blender
(Cycles) with AMD's KV260 model.

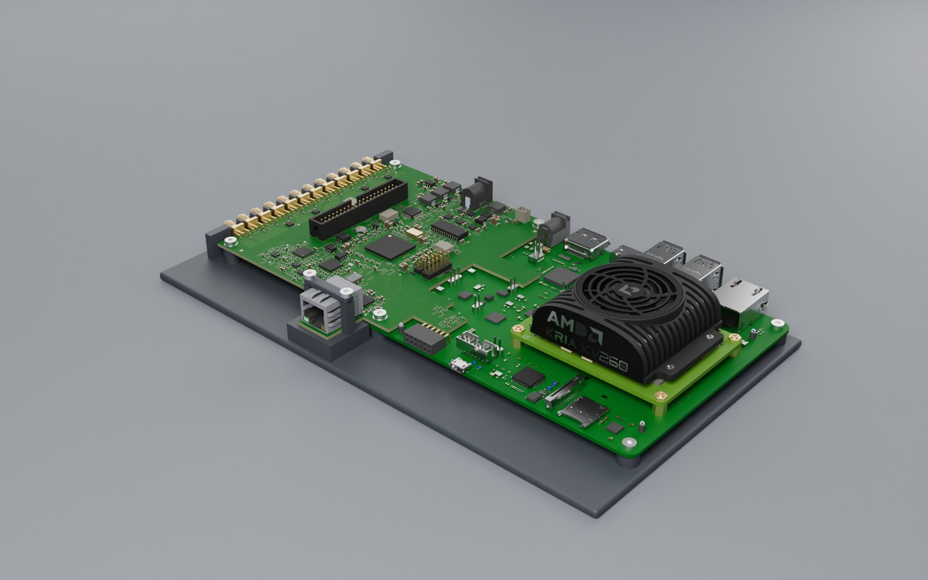
[picture p17: docs/img/mount_iso.jpg]
The KV260 and the adapter on the printed base


| The RJ45 tab, pedestal and strap | The SMA wall |
|---|---|
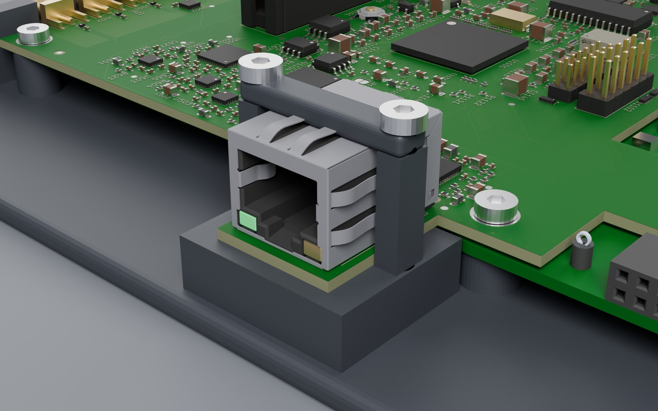
[picture p18: docs/img/mount_rj45.jpg]
RJ45
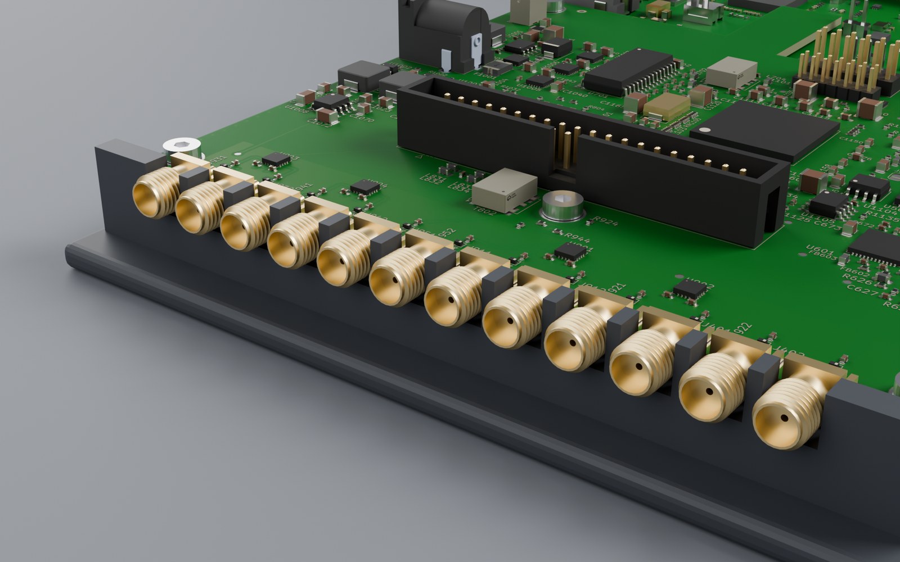
[picture p19: docs/img/mount_sma.jpg]
SMA wall
|  |  |

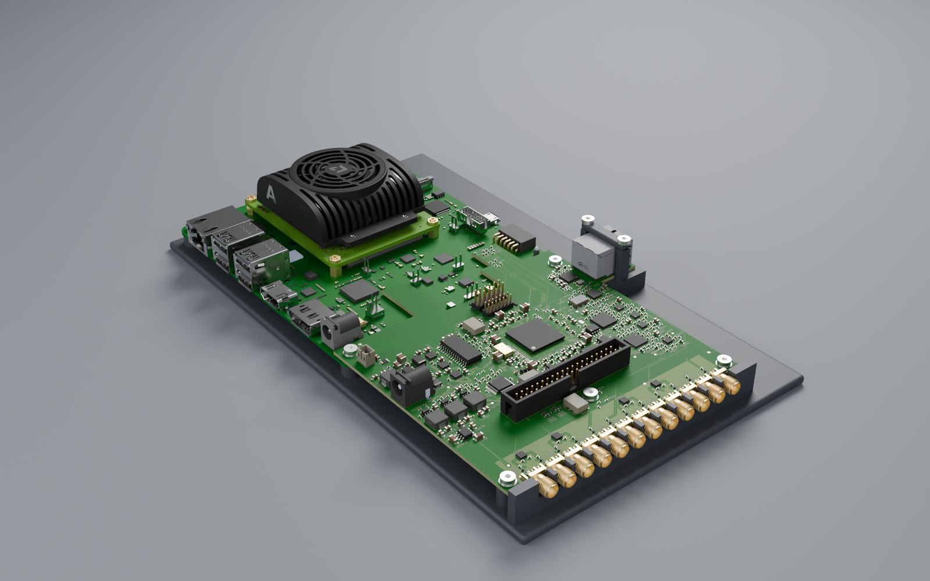
[picture p20: docs/img/mount_iso_back.jpg]
From the other side


---

## The enclosure

A closed printed case for vehicle use ([ENCLOSURE](docs/ENCLOSURE.md); STLs in `mech/`). It has a tray and a
lid that close on six lugs, with printed snap pins for a tool-free fit test or stainless M4 screws. The SMA
bodies are clamped in the split line. A honeycomb floor and TPU-padded clamp posts hold both boards without
play. Optional TPU 95A corner bumpers are for handling. It prints on a Bambu A1 in PETG-CF, ASA or PAHT-CF.

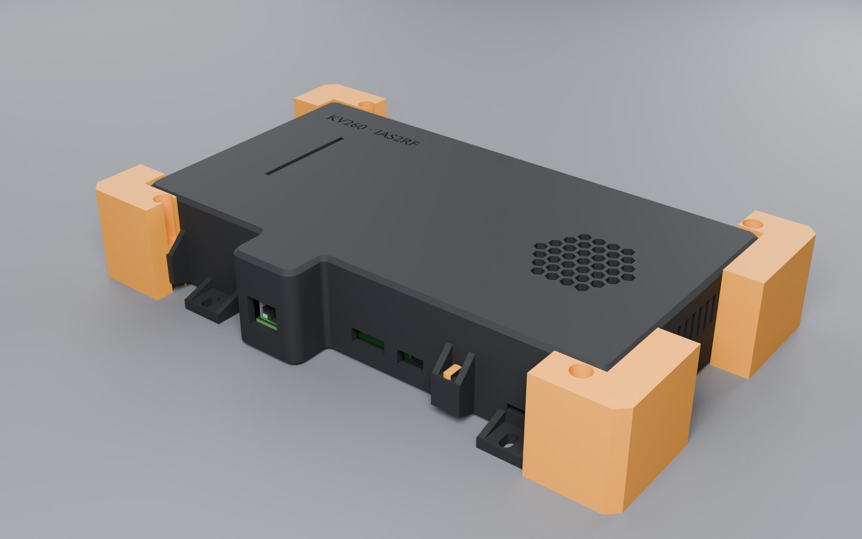
[picture p21: docs/img/case_closed.jpg]
Closed, with the TPU bumpers


| Opened | Section through the boards |
|---|---|
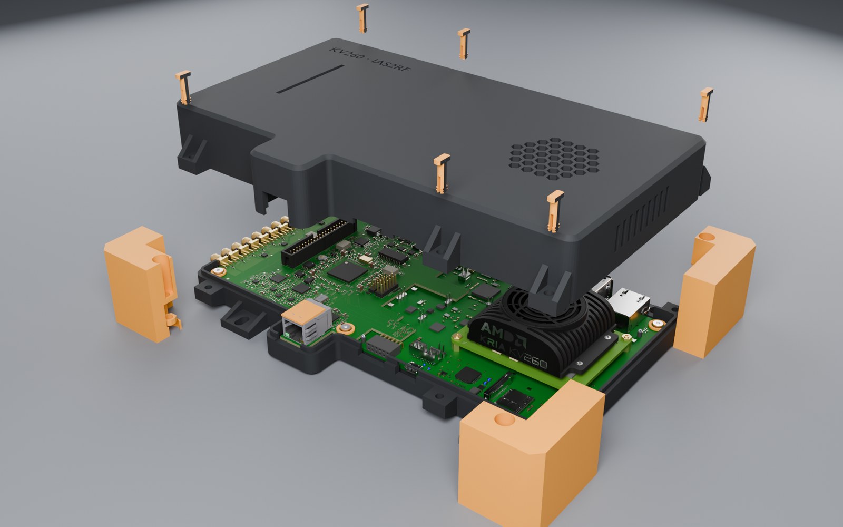
[picture p22: docs/img/case_open.jpg]
Open
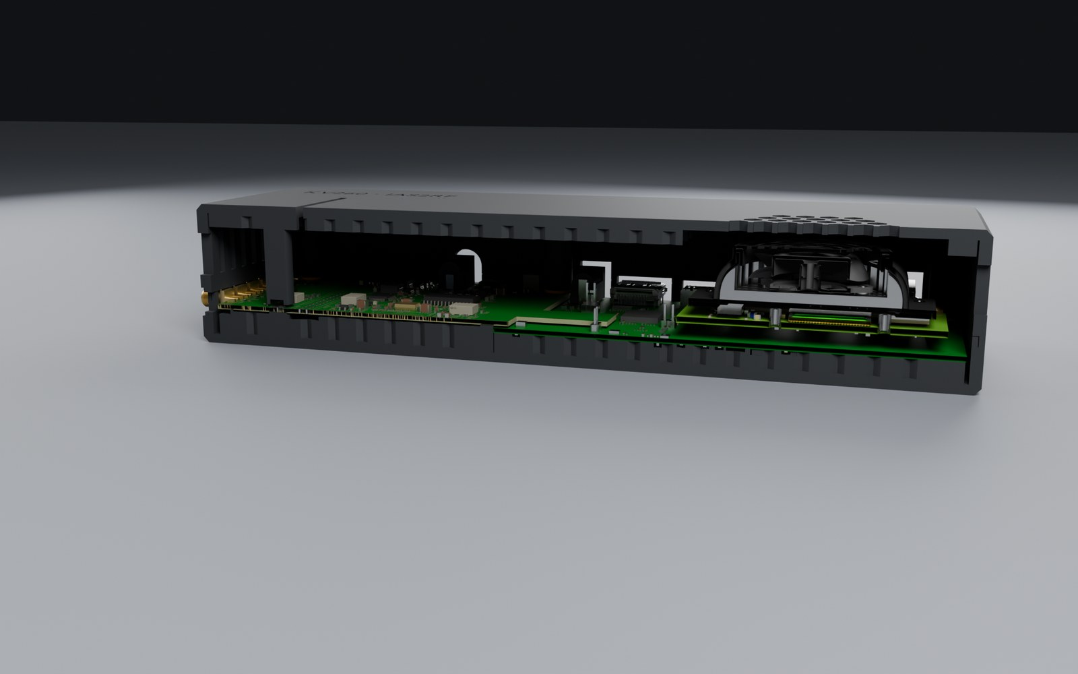
[picture p23: docs/img/case_section.jpg]
Section
|  |  |
| **The tray: honeycomb, posts, pockets** | **The lid from inside: clamp posts and pads** |
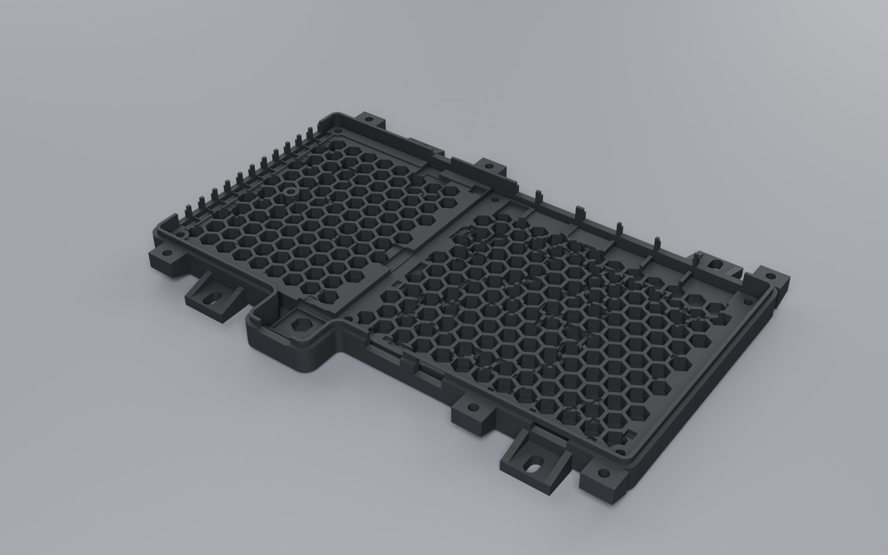
[picture p24: docs/img/case_tray.jpg]
Tray
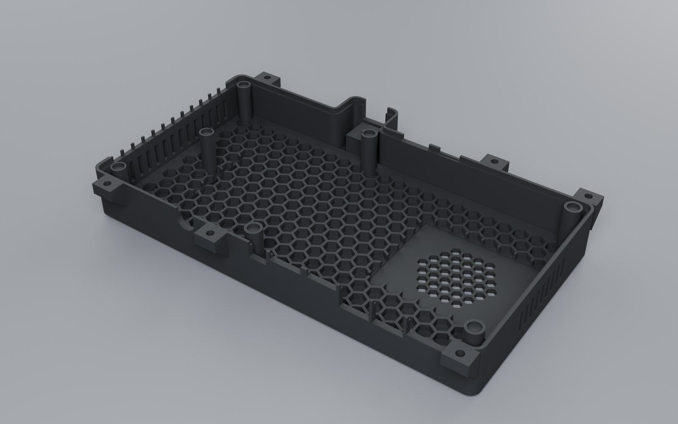
[picture p25: docs/img/case_lid.jpg]
Lid
|  |  |
| **The KV260 side: one cut-out per connector** | **The SMA side** |
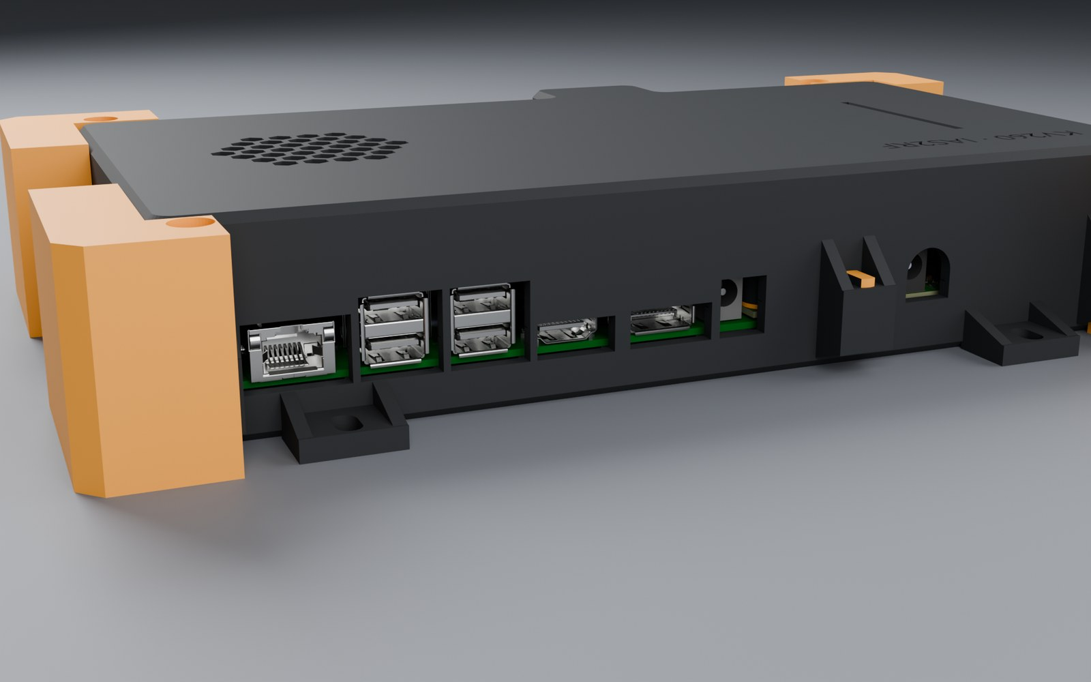
[picture p26: docs/img/case_kria.jpg]
KV260 side
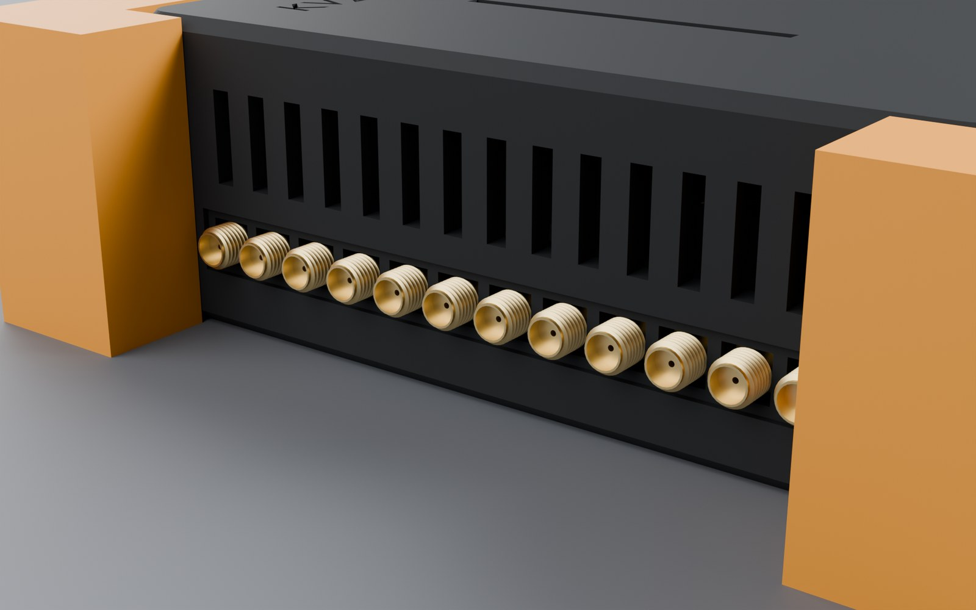
[picture p27: docs/img/case_sma.jpg]
SMA side
|  |  |

### Version 2: with a fan, for hot vehicles

Version 2 adds a 50 × 50 × 10 mm 5 V fan in the lid. It blows through a removable
100-mesh filter onto the adapter's hot strip, where the clock, the converters and the Ethernet PHY sit. The board's
fan header J1002 powers it. The SMA-side vents are closed, so the fan pressurises the case and the air leaves through
17 slots in the right wall. With the three small heatsinks on the clock chips and the ADC, every adapter IC stays
within its limit even at 70 °C ambient, according to a 3-D CFD of the case as built
([ENCLOSURE §6](docs/ENCLOSURE.md), [thermal study](docs/ENCLOSURE_V2_THERMAL.md#verification-of-the-built-v2)).

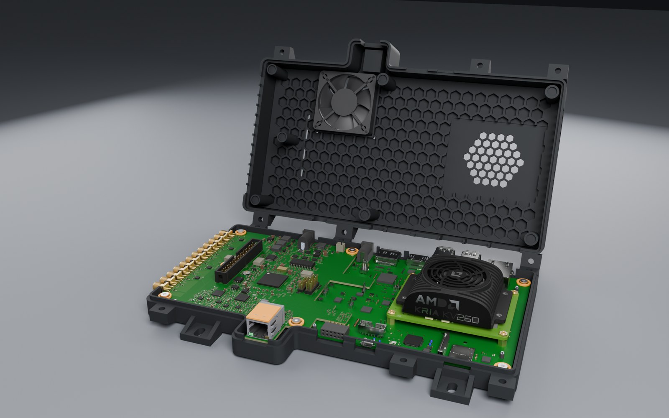
[picture p28: docs/img/case_v2_fan.jpg]
Version 2, the lid lifted: the fan over the adapter


| Closed: the filtered fan grille on the lid | The lid from inside: fan, duct and screw bosses |
|---|---|
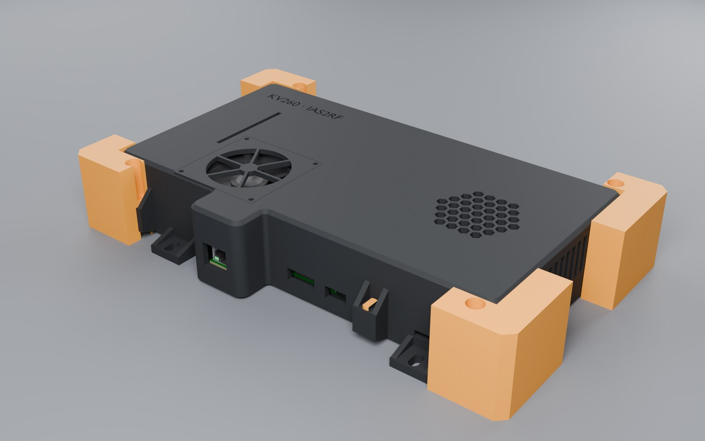
[picture p29: docs/img/case_v2_closed.jpg]
v2 closed
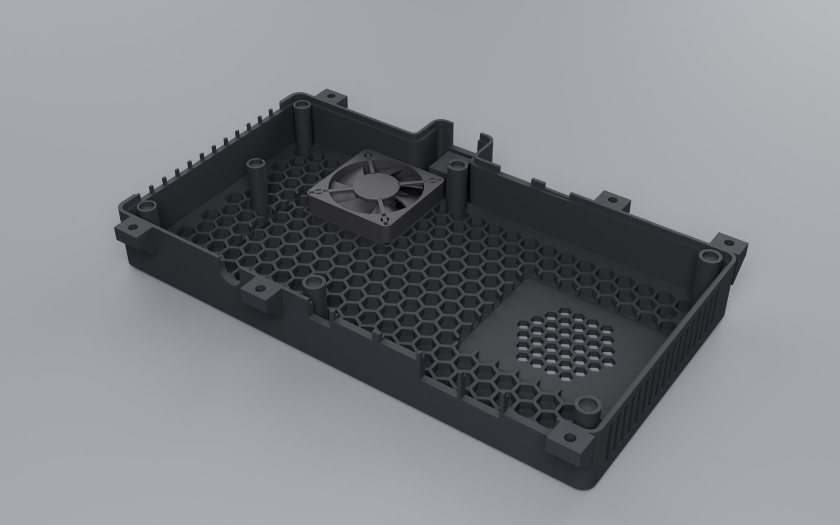
[picture p30: docs/img/case_v2_lid.jpg]
v2 lid
|  |  |

### Strength: 3-D finite elements, case and boards together

The printed case with both boards inside, meshed in 3-D (197 k tetrahedra) and loaded with 50 g, held at its four
ears ([ENCLOSURE §5.3](docs/ENCLOSURE.md)). The case stays below 3.6 MPa nearly everywhere. Its peak is 9.2 MPa, on
the rib above the right rear ear, still a factor 1.9 under the material's strength at 70 °C. The boards bow by
0.16 mm and see at most 162 µε at the BGAs, against a 500 µε guide for solder joints under shock.

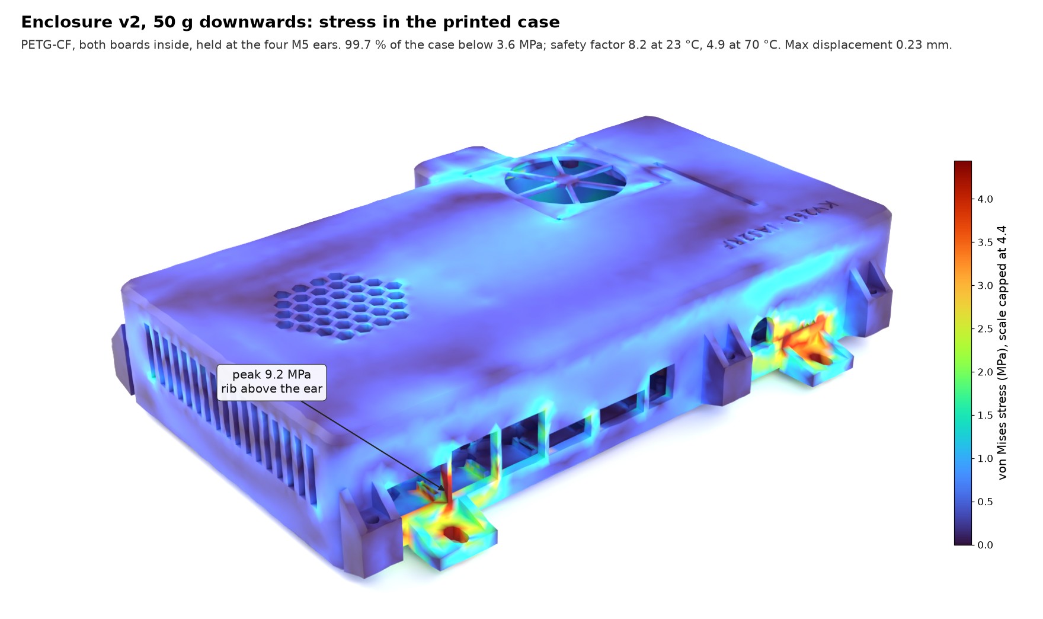
[picture p31: docs/img/case3d_v2_stress.jpg]
Stress in the case, 50 g


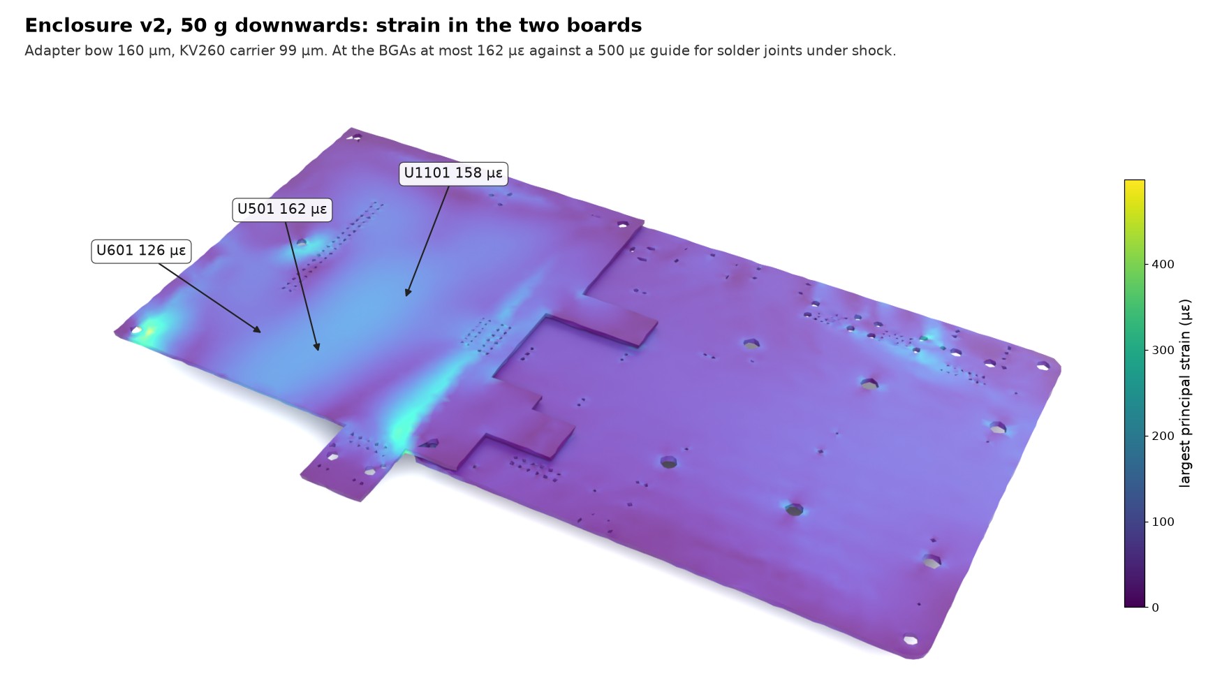
[picture p32: docs/img/case3d_v2_boards.jpg]
Strain in the boards, 50 g


Earlier beam-and-plate FEA of the case with the boards in it, per material, at 23 °C and 70 °C:
- first mode;
- a 50 g shock;
- a 1 m corner drop, bare and with the bumpers;
- off-road vibration fatigue.

Method, assumptions and the full table are in [ENCLOSURE §5](docs/ENCLOSURE.md#5-simulation-calculix). The
case passes shock and vibration in PETG-CF, ASA and PAHT-CF. A bare 1 m drop needs the bumpers.

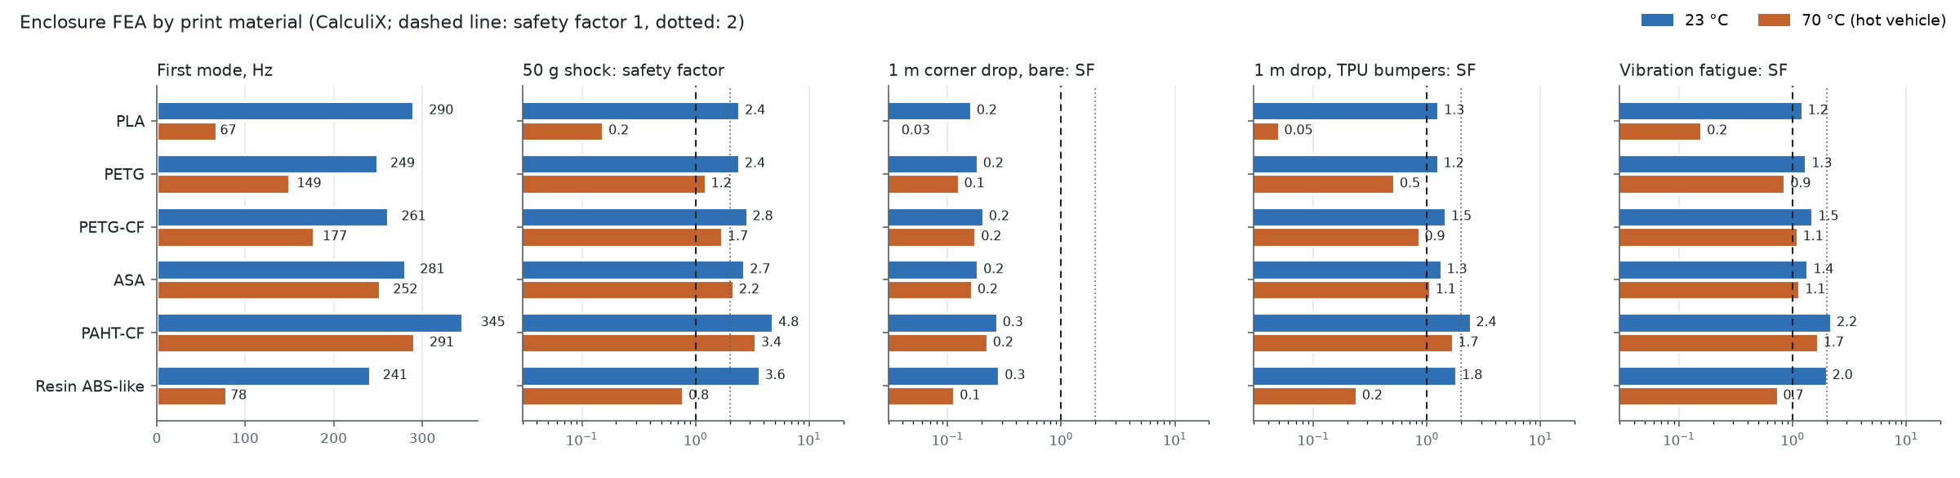
[picture p33: docs/sim/case_materials.png]
FEA by material


---

## Legal notice

This design transmits on regulated bands. Operating the SDR transmitter requires an amateur radio
licence or equivalent authorisation, and emission in 10.4–10.6 GHz is subject to national
allocations that are **not** free to use in every country. See the compliance section of
[ARCHITECTURE.md](ARCHITECTURE.md). Staying within the applicable law is the responsibility of
whoever builds and operates the equipment.

## Licence

MIT — see [LICENSE](LICENSE). The licence and attribution of the original Allied Vision project
are preserved.
