PabloSoage/kv260-ias2rf/_work/pinouts.txt

===== PINOUTS EasyEDA =====

=== AD9268BCPZ-125 ===
  lines 5..468
  Total pins: 65
  Pin      Nombre                           Dir            (x,y)
  1        CLK+                             ?              (-20.32,38.10)
  2        CLK–                             ?              (-20.32,35.56)
  3        SYNC                             ?              (-20.32,33.02)
  4        D0B(LSB)                         ?              (-20.32,30.48)
  5        D1B                              ?              (-20.32,27.94)
  6        D2B                              ?              (-20.32,25.40)
  7        D3B                              ?              (-20.32,22.86)
  8        D4B                              ?              (-20.32,20.32)
  9        D5B                              ?              (-20.32,17.78)
  10       DRVDD                            ?              (-20.32,15.24)
  11       D6B                              ?              (-20.32,12.70)
  12       D7B                              ?              (-20.32,10.16)
  13       D8B                              ?              (-20.32,7.62)
  14       D9B                              ?              (-20.32,5.08)
  15       D10B                             ?              (-20.32,2.54)
  16       D11B                             ?              (-20.32,-0.00)
  17       D12B                             ?              (-20.32,-2.54)
  18       D13B                             ?              (-20.32,-5.08)
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
  1        E/D/NC                           ?              (-17.78,1.27)
  2        GND                              ?              (-17.78,-1.27)
  3        OUTPUT_RF                        ?              (17.78,-1.27)
  4        VCC                              ?              (17.78,1.27)

=== HMC547ALC3TR ===
  lines 1243..1418
  Total pins: 17
  Pin      Nombre                           Dir            (x,y)
  1        NC                               ?              (-11.43,3.81)
  2        GND                              ?              (-11.43,1.27)
  3        RFC                              ?              (-11.43,-1.27)
  4        GND                              ?              (-11.43,-3.81)
  5        NC                               ?              (-1.27,-12.70)
  6        GND                              ?              (1.27,-12.70)
  7        RF1                              ?              (3.81,-12.70)
  8        GND                              ?              (6.35,-12.70)
  9        NC                               ?              (11.43,-3.81)
  10       B                                ?              (11.43,-1.27)
  11       A                                ?              (11.43,1.27)
  12       NC                               ?              (11.43,3.81)
  13       GND                              ?              (6.35,12.70)
  14       RF2                              ?              (3.81,12.70)
  15       GND                              ?              (1.27,12.70)
  16       NC                               ?              (-1.27,12.70)
  17       EP                               ?              (-3.81,12.70)

=== ADL5801ACPZ ===
  lines 1420..1643
  Total pins: 25
  Pin      Nombre                           Dir            (x,y)
  1        GND                              ?              (-11.43,12.70)
  2        GND                              ?              (-11.43,10.16)
  3        LOIP                             ?              (-11.43,7.62)
  4        LOIN                             ?              (-11.43,5.08)
  5        GND                              ?              (-11.43,2.54)
  6        GND                              ?              (-11.43,-0.00)
  7        VPLO                             ?              (-11.43,-2.54)
  8        GND                              ?              (-11.43,-5.08)
  9        ENBL                             ?              (-11.43,-7.62)
  10       VSET                             ?              (-11.43,-10.16)
  11       DETO                             ?              (-11.43,-12.70)
  12       GND                              ?              (-11.43,-15.24)
  13       VPDT                             ?              (11.43,-15.24)
  14       GND                              ?              (11.43,-12.70)
  15       RFIN                             ?              (11.43,-10.16)
  16       RFIP                             ?              (11.43,-7.62)
  17       GND                              ?              (11.43,-5.08)
  18       VPRF                             ?              (11.43,-2.54)
  19       GND                              ?              (11.43,-0.00)
  20       IFOP                             ?              (11.43,2.54)
  21       IFON                             ?              (11.43,5.08)
  22       NC                               ?              (11.43,7.62)
  23       GND                              ?              (11.43,10.16)
  24       VPLO                             ?              (11.43,12.70)
  25       EP                               ?              (11.43,15.24)

=== ADAR1000ACCZN ===
  lines 1645..2125
  Total pins: 89
  Pin      Nombre                           Dir            (x,y)
  89       GND                              ?              (?,?)
  A1       DET3                             ?              (?,?)
  A3       TR_SW_NEG                        ?              (?,?)
  A4       PA_BIAS4                         ?              (?,?)
  A5       PA_BIAS3                         ?              (?,?)
  A7       RF_IO                            ?              (?,?)
  A9       PA_BIAS2                         ?              (?,?)
  A10      PA_BIAS1                         ?              (?,?)
  A11      LNA_BIAS                         ?              (?,?)
  B3       PA_ON                            ?              (?,?)
  B4       TR_POL                           ?              (?,?)
  B5       TR_SW_POS                        ?              (?,?)
  C1       TX3                              ?              (?,?)
  C13      RX2                              ?              (?,?)
  E1       RX3                              ?              (?,?)
  E13      TX2                              ?              (?,?)
  G1       DET4                             ?              (?,?)
  G13      DET2                             ?              (?,?)
  J1       TX4                              ?              (?,?)
  J13      RX1                              ?              (?,?)
  L1       RX4                              ?              (?,?)
  L13      TX1                              ?              (?,?)
  M3       CSB                              ?              (?,?)
  M4       SDO                              ?              (?,?)
  M5       SDIO                             ?              (?,?)
  M6       SCLK                             ?              (?,?)
  N2       RX_LOAD                          ?              (?,?)
  N3       TX_LOAD                          ?              (?,?)
  N4       ADDR0                            ?              (?,?)
  N5       ADDR1                            ?              (?,?)
  N6       TR                               ?              (?,?)
  N13      DET1                             ?              (?,?)
  B11      AVDD                             ?              (?,?)
  M8       CREG1                            ?              (?,?)
  M9       CREG2                            ?              (?,?)
  M10      AVDD3                            ?              (?,?)
  M11      AVDD3                            ?              (?,?)
  N9       CREG4                            ?              (?,?)
  N10      CREG3                            ?              (?,?)
  N11      AVDD3                            ?              (?,?)
  A2       GND                              ?              (?,?)
  A6       GND                              ?              (?,?)
  A8       GND                              ?              (?,?)
  A12      GND                              ?              (?,?)
  A13      GND                              ?              (?,?)
  B1       GND                              ?              (?,?)
  B2       GND                              ?              (?,?)
  B6       GND                              ?              (?,?)
  B7       GND                              ?              (?,?)
  B8       GND                              ?              (?,?)
  B9       GND                              ?              (?,?)
  B10      GND                              ?              (?,?)
  B12      GND                              ?              (?,?)
  B13      GND                              ?              (?,?)
  C2       GND                              ?              (?,?)
  C12      GND                              ?              (?,?)
  D1       GND                              ?              (?,?)
  D2       GND                              ?              (?,?)
  D12      GND                              ?              (?,?)
  D13      GND                              ?              (?,?)
  E2       GND                              ?              (?,?)
  E12      GND                              ?              (?,?)
  F1       GND                              ?              (?,?)
  F2       GND                              ?              (?,?)
  F12      GND                              ?              (?,?)
  F13      GND                              ?              (?,?)
  G2       GND                              ?              (?,?)
  G12      GND                              ?              (?,?)
  H1       GND                              ?              (?,?)
  H2       GND                              ?              (?,?)
  H12      GND                              ?              (?,?)
  H13      GND                              ?              (?,?)
  J2       GND                              ?              (?,?)
  J12      GND                              ?              (?,?)
  K1       GND                              ?              (?,?)
  K2       GND                              ?              (?,?)
  K12      GND                              ?              (?,?)
  K13      GND                              ?              (?,?)
  L2       GND                              ?              (?,?)
  L12      GND                              ?              (?,?)
  M1       GND                              ?              (?,?)
  M2       GND                              ?              (?,?)
  M7       GND                              ?              (?,?)
  M12      GND                              ?              (?,?)
  M13      GND                              ?              (?,?)
  N1       GND                              ?              (?,?)
  N7       GND                              ?              (?,?)
  N8       GND                              ?              (?,?)
  N12      GND                              ?              (?,?)

=== ADCLK944BCPZ-R2 ===
  lines 2127..2302
  Total pins: 17
  Pin      Nombre                           Dir            (x,y)
  1        CLK                              ?              (-10.16,7.62)
  2        VT                               ?              (-10.16,5.08)
  3        VREF                             ?              (-10.16,2.54)
  4        ~{CLK}                           ?              (-10.16,-0.00)
  5        VEE                              ?              (-10.16,-2.54)
  6        ~{Q3}                            ?              (-10.16,-5.08)
  7        Q3                               ?              (-10.16,-7.62)
  8        VCC                              ?              (-10.16,-10.16)
  9        ~{Q2}                            ?              (10.16,-10.16)
  10       Q2                               ?              (10.16,-7.62)
  11       ~{Q1}                            ?              (10.16,-5.08)
  12       Q1                               ?              (10.16,-2.54)
  13       VCC                              ?              (10.16,-0.00)
  14       ~{Q0}                            ?              (10.16,2.54)
  15       Q0                               ?              (10.16,5.08)
  16       VEE                              ?              (10.16,7.62)
  17       EP                               ?              (10.16,10.16)

=== AD9253BCPZ-125 ===
  lines 2304..2664
  Total pins: 49
  Pin      Nombre                           Dir            (x,y)
  1        VIN+D                            ?              (-16.51,30.48)
  2        VIN–D                            ?              (-16.51,27.94)
  3        AVDD                             ?              (-16.51,25.40)
  4        AVDD                             ?              (-16.51,22.86)
  5        CLK–                             ?              (-16.51,20.32)
  6        CLK+                             ?              (-16.51,17.78)
  7        AVDD                             ?              (-16.51,15.24)
  8        DRVDD                            ?              (-16.51,12.70)
  9        D1–D                             ?              (-16.51,10.16)
  10       D1+D                             ?              (-16.51,7.62)
  11       D0–D                             ?              (-16.51,5.08)
  12       D0+D                             ?              (-16.51,2.54)
  13       D1–C                             ?              (-16.51,-0.00)
  14       D1+C                             ?              (-16.51,-2.54)
  15       D0–C                             ?              (-16.51,-5.08)
  16       D0+C                             ?              (-16.51,-7.62)
  17       DCO–                             ?              (-16.51,-10.16)
  18       DCO+                             ?              (-16.51,-12.70)
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
  36       DB0P2(LSB)                       ?              (17.78,-1.27)
  37       SLEEP                            ?              (17.78,1.27)
  38       ACOM                             ?              (17.78,3.81)
  39       IOUTA2                           ?              (17.78,6.35)
  40       IOUTB2                           ?              (17.78,8.89)
  41       FSADJ2                           ?              (17.78,11.43)
  42       GAINCTRL                         ?              (17.78,13.97)
  43       REFIO                            ?              (17.78,16.51)
  44       FSADJ1                           ?              (17.78,19.05)
  45       IOUTB1                           ?              (17.78,21.59)
  46       IOUTA1                           ?              (17.78,24.13)
  47       AVDD                             ?              (17.78,26.67)
  48       MODE                             ?              (17.78,29.21)
