PabloSoage/kv260-ias2rf/docs/ROADMAP.md

# Work plan

*21 September 2026 · Rev03 architecture*

Every phase has a **verifiable exit criterion**. A phase is not finished because files were
touched; it is finished when its criterion is met. Rev01 was declared complete with no exit
criteria, and that is where all of it came from.

---

## Phase 0 — Close the blockers ✅ COMPLETE

| Blocker | Outcome |
|---|---|
| **B-01** — Interface to the Kria | ⛔ **Against.** IAS0 ends at the AP1302 ISP; there is no 40-pin RPi header; the GTHs are not reachable. Real budget: **8 pairs + ~14 loose signals** |
| **B-02** — AD9253 1-lane mode | ⛔ **Against.** Capped at **62.5 MSPS** |
| **B-03** — RF switches | ⛔ **Against, after a first wrong closure.** The M3SWA2-34DR+ has positive control logic but needs VDD +3.3 V **and VEE −3.3 V** |
| **B-04** — AERIS-10 IF | ✅ **In favour.** 120 MHz; the `BPF2` filters are unspecified placeholders |
| **B-05** — Extended variant | ⚠️ **Partial.** Not published. Sized for 8 chips |

Evidence and sources in [BLOCKERS_AND_RISKS.md](BLOCKERS_AND_RISKS.md). Consequence: the Rev02
architecture was not realisable and has been replaced by **Rev03, with a front-end FPGA**.

Still outstanding — not blocking the decision, but blocking schematic sign-off:

| Task | Source |
|---|---|
| ~~Exact `VCCO` of the HPA bank as the KV260 sets it~~ | ✅ 1.2 V, from XTP682 — [INTERFACE_SPEC.md](INTERFACE_SPEC.md) §6 |
| Confirm the AERIS Extended variant (B-05) | The project's author |
| ~~Measure the mechanical envelope on the KV260~~ | ✅ from the official 3D model, no hardware needed — [INTERFACE_SPEC.md](INTERFACE_SPEC.md) §5 |

---

## Phase 0.5 — Architecture decision ✅ DECIDED (21 September 2026)

**The front-end FPGA is accepted.** The reason is the one in phase 0: the KV260 does not expose
enough pins for a converter to connect directly.

**The radar is AERIS-10**, for surveillance at range, understood as a project rather than
something that will be operated (see the licensing position in
[BLOCKERS_AND_RISKS.md](BLOCKERS_AND_RISKS.md) R-06).

**Obstacle detection leaves this board.** It will be a commercial automotive radar connected over
USB — cheaper, licence-free at 76–77 GHz, and purpose-built. It is therefore **not** a subsystem of
this adapter, and nothing in the schematic has to account for it.

The comparison that led here:

| | With front-end FPGA | Without |
|---|---|---|
| Radar resolution | **0.75 m** | 3.0 – 6.0 m |
| RX channels | 2 at 400 MSPS + 2 for SDR | 2 at 62.5 MSPS |
| Direction finding | **4 coherent channels** | 2, with ambiguity |
| Transmission | 14 bits, local bus | 8 bits split across 2 connectors |
| ADAR1000 control | Trivial, with a synchronous strobe | Unsolved for 8 chips |
| AERIS firmware | **Front-end modules run unported**; the back end (pulse compression, Doppler, CFAR) moves to the Kria | Has to be rewritten |
| Connectors used | J8 + Pmod | J8 + J9 (FFC) + Pmod |
| Board complexity | **An FPGA board**: boot, sequencing, JTAG | Passive board |
| Second toolchain | Yes (Vivado for the front-end FPGA) | No |

**Exit criterion:** decision taken and recorded. Without it, any schematic is wasted work.

> **Note:** the DSP core for the "with FPGA" branch already exists and is measured on silicon —
> [scanner64](https://github.com/PabloSoage/scanner64). That removes a large part of the risk from
> this decision: the hard question (can the PL sustain a converter stream in real time?) has been
> answered with hardware.

---

## Phase 1 — Frozen specification

| Task | Deliverable |
|---|---|
| Fix the ADC sample rate and lane mode | Update §4.1 of the master document |
| Fix the DAC bus width, rate and part | Update §5.1 |
| Freeze the pin-by-pin map of IAS1, J9 and the Pmod | Complete assignment table, with physical pins |
| Freeze the control connector to AERIS-10 | IDC 2×20 pinout, with levels and directions |
| Per-rail current budget from datasheet figures | Replace the `[E]` estimates in §10.1 |
| Define the 6-layer stackup with computed impedances | Stackup sheet for the fabricator |

**Status (21 September 2026):** partly done — see [INTERFACE_SPEC.md](INTERFACE_SPEC.md).

| Item | State |
|---|---|
| Pin map of J8 and the Pmod | ✅ frozen |
| Mechanical envelope | ✅ measured from the official 3D model |
| Growth direction within that envelope | ✅ registered on the STEP model — outward, off the carrier's side ([INTERFACE_SPEC.md](INTERFACE_SPEC.md) §5.3) |
| `VCCO` of the HPA bank | ❌ **needs XTP682**, the carrier card schematic |
| Power tree topology and regulator sizing | ✅ [POWER_AND_STACKUP.md](POWER_AND_STACKUP.md) §1 |
| Per-rail load figures | ⚠️ **16 of 25 verified from datasheets**; the rest need Vivado or parts not yet chosen |
| 6-layer stackup and trace widths | ✅ §2; JLC06161H-2116A and field-solver widths in §2.6 |

**Exit criterion:** the master document with no `[?]` marks left in sections 4, 5, 6 and 10, and
the power `[E]` marks replaced by datasheet values.

---

## Phase 2 — Schematic ⬅ **STARTED**

### Done: the hierarchy skeleton

`_work/rev03_build_hierarchy.py` created six sheets under `rev03/` and wired their interfaces into
the root, **108 interface signals** in total:

| Sheet | Signals | Contents |
|---|---|---|
| `IAS_LINK` | 14 | Hirose IAS1, AC coupling, link terminations |
| `CONTROL` | 40 | **Drawn** (25 Sep) — XC7A50T, flash, JTAG, Pmod, AERIS ribbon. [CONTROL_SPEC.md](CONTROL_SPEC.md) |
| `CONVERTERS` | 37 | AD9484, AD9253, AD9708, AD9767, AD8352 drivers — **split in four on 24 Sep**, below |
| `CLOCK` | 9 | **Drawn** (23 Sep), **reviewed and accepted** (24 Sep) — Si549 XO, ADCLK948 select + fan-out. [CLOCK_SPEC.md](CLOCK_SPEC.md) |
| `ROUTING` | 9 | 4× SPDT channel routing, IF and clock SMAs |
| `POWER` | 0 | 12 V input, protection, buck/LDO tree — rails are global symbols |

**Why this is not what §8 of the audit warns against.** That warning is about generating
*circuits* by script: untyped symbols wired with auto-generated labels, which cannot be reviewed
by eye and which ERC cannot check because the pins carry no electrical type. This skeleton contains
**no symbols and no wires** — only sheets and the hierarchical labels that define what crosses
between them. There is nothing to mis-type, and ERC verifies exactly the property that matters:
that every sheet pin matches a hierarchical label by name and direction. All six sheets came out
with 0 orphan, 0 missing and 0 wrong-direction pins. The circuit gets drawn in the GUI.

Power rails are deliberately **not** hierarchical labels. They travel as global power symbols, the
way the inherited design already does, which keeps sheet interfaces to signals.

### Done: hierarchy made consistent

`_work/sync_sheet_pins.py` did from the command line what *Synchronize Hierarchical Labels* does in
the GUI, and closed the last 36 structural errors:

- **2 orphan pins removed** — `CLK_KRIA_P` / `CLK_KRIA_N` on the IAS0 block, sheet pins for a label
  that does not exist. Remains of the Rev01 idea of sending a 125 MHz LVPECL clock back into a MIPI
  pin on the SOM, which Rev03 dropped.
- **34 missing pins added** — the shared sheet exposes 25 hierarchical labels; IAS0 declared only
  16 of them and IAS1 only 2.
- **9 pin directions corrected** on IAS0.

**Result: `hier_label_mismatch` 36 → 0.**

### Done: symbol libraries with correct pin types

See [SYMBOLS.md](SYMBOLS.md). The hardest symbol in the design turned out to be free:
**`XC7A50T-FTG256` ships in KiCad's own `FPGA_Xilinx_Artix7`** — 256 pins, 4 units, correctly
typed, exactly the package AERIS-10 uses. `AD9708AR` and `ADF4351` are likewise in the official
libraries.

Ten more are generated into `symbols/kv260-ias2rf.kicad_sym` by `_work/make_symbols.py`.
**Eight are built from manufacturer datasheets**: four from the AERIS-10 component folder, and four
(`AD9523`, `AD9253`, `AD9767`, `ADCLK944`; later `ADCLK948` and `Si549`) from the Internet Archive's copies of analog.com, fetched
by `_work/fetch_datasheets.py`. Only `ADAR1000ACCZN` and `ADF4382A`, both AERIS-10 reference parts,
remain on the Eagle library.

Each datasheet table is cross-checked against an independent second source by
`_work/crosscheck_pinouts.py`. The result: no conflicts, and ten disagreements, every one of them an
error in the second source. The same work found three real errors: exposed pads numbered 0 instead
of N+1, the M3SWA2's missing paddle, and an erratum in the LTC5552 datasheet. See
[SYMBOLS.md](SYMBOLS.md) §5.

**Retyping the M3SWA2 uncovered a design error:** blocker B-03 had been closed wrongly and the
charge-pump inverter struck from the power tree. The part needs VEE −3.3 V. See
[BLOCKERS_AND_RISKS.md](BLOCKERS_AND_RISKS.md) B-03.

### Done: CONVERTERS split in four (24 Sep)

One converter sheet would have held about 200 parts, too many to review in one sitting.
`_work/rev03_split_converters.py` replaced it with `ADC_RADAR`, `ADC_SDR`, `DAC_RADAR` and
`DAC_SDR`, each the size of CLOCK, and made two interface changes on the way
([ADC_RADAR_SPEC.md](ADC_RADAR_SPEC.md) §1): the radar ADC's data bus became one label per line,
and the four IF signals became single-ended, matching the SPDT switches and SMAs that carry them.
`hier_label_mismatch` stays at 0.

### How the sheets are drawn

Generated, and checked, one sheet at a time: a connection list written by hand from the
datasheets (`_work/sheets/<sheet>_spec.py`), a drawing made from coordinates
(`_work/sheets/<sheet>.py`), and `_work/check_sheet.py`, which compares KiCad's own netlist of the
drawing against the list, pin by pin. Then a human review against the datasheets. Once a sheet is
accepted, its `.kicad_sch` is the source and is edited in KiCad.

---

## Phase 2 — Schematic: requirements

Start from `CSI2-KRIA-KV260_Rev01-2.kicad_sch` (the purge, which is valid work). The two
script-generated sheets have already been **removed** from the project and moved to
`_deprecated/`.

> **No unreviewable generated circuits.** See the [method note](AUDIT_Rev01.md#8-method-note).
> What the note rules out is Rev01's kind: untyped symbols joined by auto-generated labels. The
> sheets now drawn by script use typed symbols and real wires, are verified against a separate
> connection list, and are reviewed by a person before they are accepted (§ *How the sheets are
> drawn*, above).

| Sheet | Contents |
|---|---|
| Root | Hierarchy, every sheet pin labelled by net (**wired 25 Sep**, `_work/check_root.py`) |
| `IAS_LINK` | ✅ Drawn and verified: `check_sheet.py ias_link` PASS. Awaiting review — [IAS_LINK_SPEC.md](IAS_LINK_SPEC.md) |
| `ADC_RADAR` | ✅ Drawn and verified: `check_sheet.py adc_radar` PASS. **Awaiting your review** — [ADC_RADAR_SPEC.md](ADC_RADAR_SPEC.md) §5 |
| `ADC_SDR` | ✅ Drawn and verified: `check_sheet.py adc_sdr` PASS. Awaiting review — [ADC_SDR_SPEC.md](ADC_SDR_SPEC.md) |
| `DAC_RADAR` | ✅ Drawn and verified: `check_sheet.py dac_radar` PASS. Awaiting review — [DAC_RADAR_SPEC.md](DAC_RADAR_SPEC.md) |
| `DAC_SDR` | ✅ Drawn and verified: `check_sheet.py dac_sdr` PASS. Awaiting review — [DAC_SDR_SPEC.md](DAC_SDR_SPEC.md) |
| `CLOCK` | ✅ Drawn, verified, **reviewed and accepted** (24 Sep) — [CLOCK_SPEC.md](CLOCK_SPEC.md) |
| `ROUTING` | ✅ Drawn and verified: `check_sheet.py routing` PASS. Awaiting review — [ROUTING_SPEC.md](ROUTING_SPEC.md) |
| `CONTROL` | Pmod header, front-end FPGA (if adopted), level translators, IDC to AERIS and the SDR board |
| `POWER` | ✅ Drawn and verified: `check_sheet.py power` PASS. Awaiting review — [POWER_SPEC.md](POWER_SPEC.md) |

**Non-negotiable quality requirements:**

- Symbols with **correct electrical types** on every pin. If an EasyEDA symbol arrives with
  everything marked `Unspecified`, fix it before using it: otherwise ERC checks nothing.
- Connections with **wires**, not labels alone. Labels are fine for buses and rails; RF and power
  topology has to be visible.
- An explicit `no_connect` on every deliberately unused pin.

**Prerequisite — multi-channel annotation.** ✅ **Done** (21 September 2026). It had two causes:
duplicate instance references on the shared sheet, and a root schematic whose declared UUID did not
match its own instance paths. Both fixed by `_work/fix_multichannel_annotation.py`. The netlist now
exports with 48 components and 61 nets, so `Update PCB from Schematic` is unblocked and phase 3 can
start once the schematic is done.

**Exit criteria:**

1. ERC with **zero errors** and warnings justified one by one in an exclusions file.
2. `kicad-cli sch export netlist` succeeds.
3. Visual review sheet by sheet against the master document.
4. Every BOM item with a real part number, package and checked availability.

---

## Phase 3 — Layout

| Task | Note |
|---|---|
| Extend the board outline | Keeping the two Hirose positions fixed |
| Define the 6-layer stackup in KiCad | With the fabricator's real dielectrics and thicknesses |
| Placement | Converters and clock as close to the Hirose as possible |
| Route the IAS pairs | 100 Ω differential, length-matched, continuous reference plane |
| Route the DAC bus | Series termination at source, close return path |
| Power planes | Real separation between analogue and digital, ferrites at the junctions |
| Route the IF lines | 50 Ω to the SMAs |

**Status (26 September 2026)** — [LAYOUT.md](LAYOUT.md), [FABRICATION.md](FABRICATION.md):

| Task | State |
|---|---|
| Extend the board outline | ✅ 119 × 120 mm; Hirose positions and the two corner holes kept exactly |
| 6-layer stackup in KiCad | ✅ JLCPCB JLC06161H-2116A, the fabricator's real dielectrics (POWER_AND_STACKUP §2.6) |
| Trace widths | ✅ by field solver on that stack, solder mask included: 117 / 150 µm at 100 Ω, 183 µm at 50 Ω. To confirm in JLCPCB's calculator |
| Net classes and rules | ✅ LVDS100, RF50, Power |
| Placement | ✅ every passive at its pin; POWER laid out along the power flow; 2.5 mm escape ring round the BGA. To adjust by hand while routing |
| Power planes | ✅ L4 split drawn (+3V3_D background, islands); vias to place |
| Fabrication outputs | ✅ `_work/fab/make_fab.py`: Gerbers, drill, BOM, CPL; a DRAFT until routed |
| Routing | ❌ next, in KiCad |

**Exit criteria:**

1. DRC with zero errors **and the correct rules enabled** (not inherited from the import).
2. Zero unconnected pads — and this time with actual pads.
3. Impedances verified with the fabricator's stackup calculator.
4. Manufacturability review with the chosen fabricator before ordering.

---

## Phase 4 — Prototype and bring-up

Deliberate order: each step validates the previous one and does not depend on the next.

| Step | What it validates | How |
|---|---|---|
| 1 | Power | Voltages and ripple on every rail, with no converters fitted |
| 2 | Clock | ADCLK948 outputs on the scope via J402: levels, jitter, terminations; Si549 at 400 and 500 MHz |
| 3 | **IAS1 link to the PL** | Inject a known sine at the ADC input and recover it in the PL. **This is the critical validation of the whole project** (it closes B-01 in practice) |
| 4 | **PL to DAC link** | Generate a sine from the PL and see it at the DAC output |
| 5 | DAC bus crosstalk | Sweep the sample rate until the real limit appears |
| 6 | Switches and routing | The 3 operating modes |
| 7 | Integration with AERIS-10 | Common clock, IF both ways, beam control |

**Exit criterion:** a closed loop DAC → switch → switch → ADC working, with the signal generated by
the PL recovered by the PL.

---

## Phase 5 — Gateware

Can overlap phases 2 and 3.

| Task | Note |
|---|---|
| ADC serial LVDS receiver | `ISERDESE3` + frame alignment |
| DAC bus generator | |
| SPI master and beam control | |
| Port the AERIS-10 radar processing | Adapt clock (400 → 80/125 MHz), bits (8 → 14), host (USB → AXI/DMA) |
| SDR chain | DDC, decimation, demodulation. **Reuse [scanner64](https://github.com/PabloSoage/scanner64)** |
| Host application | |

**Exit criterion:** ADC capture and DAC generation working on real hardware, with the AERIS firmware
regressions passing in the new clock domain.

---

## Later phases

- **SDR front-end board.** Independent. Can start as soon as phase 1 freezes the IF interface.
- **Integration with AERIS-10X.** Depends on the author publishing the Extended variant (B-05).

---

## Current state

**Phase 0 complete. Blocked at phase 0.5**, awaiting the front-end FPGA decision.

### Work done on the KiCad files

| Action | State |
|---|---|
| Removed the **34 empty footprints** Rev01 had inserted in the `.kicad_pcb` | ✅ Done. Prior copy in `_backup_original/CSI2-KRIA-KV260_Rev01_preRev02cleanup.kicad_pcb` |
| Verified file integrity after the edit | ✅ Balanced parentheses; **488 pads untouched**, none belonged to the deleted footprints |
| Kept the 5 pad-less footprints that **are** original to the import (`LA1`, `T1`, `T2`, `J5_IAS0`, `J5_IAS1`) | ✅ |
| **Removed the two dead sheets from the project** (`FRONTEND`, `PHASED_ARRAY`) | ✅ Done by `_work/rev03_drop_dead_sheets.py`. Moved to `_deprecated/` |
| **ERC measured before and after** with `kicad-cli 10.0.1` | ✅ **1130 → 427 violations.** All the serious electrical categories at zero |
| Repository cleaned for publication | ✅ Broken `.history` gitlinks, autosave zips and `.kicad_prl` untracked. 67 MB → 25 MB |

**What has deliberately not been done, and why:**

- **No new schematic drawn.** The architecture changed when B-01 closed and the phase 0.5 decision
  is open. Drawing now would be wasted work.
- **No placement or routing.** Same reason, and because doing it by hand-writing S-expressions
  would produce exactly the kind of unreviewable artefact that caused the Rev01 problems.
- **The board outline has not been extended** and the 6-layer stackup is not defined: both depend on
  the architecture decision and on the mechanical envelope, which is still unmeasured.
- **No pinouts invented.** Symbols for the new parts will be built from their datasheets, with
  correct electrical types, not copied from untyped third-party libraries.
