PabloSoage/kv260-ias2rf/docs/img/sch/ADC_RADAR.png

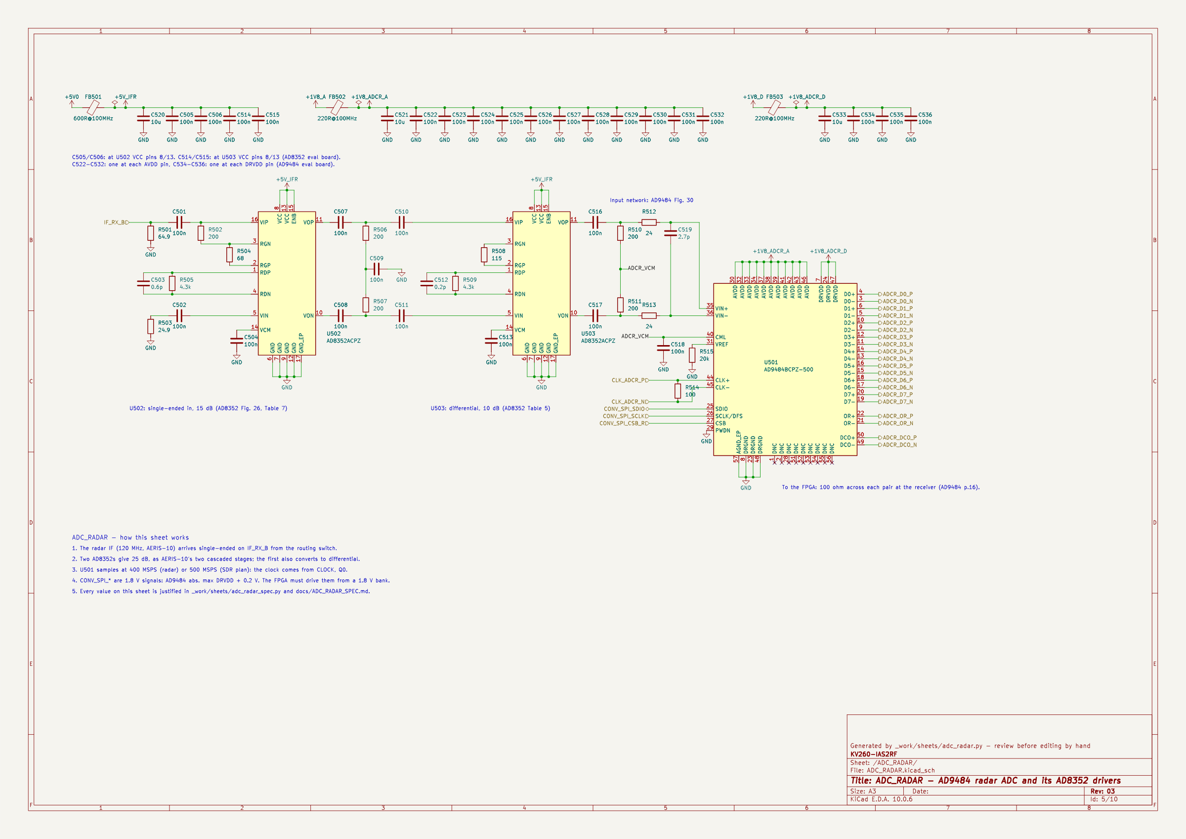
docs/img/sch/ADC_RADAR.png
