PabloSoage/kv260-ias2rf/docs/img/sch/ADC_SDR.png

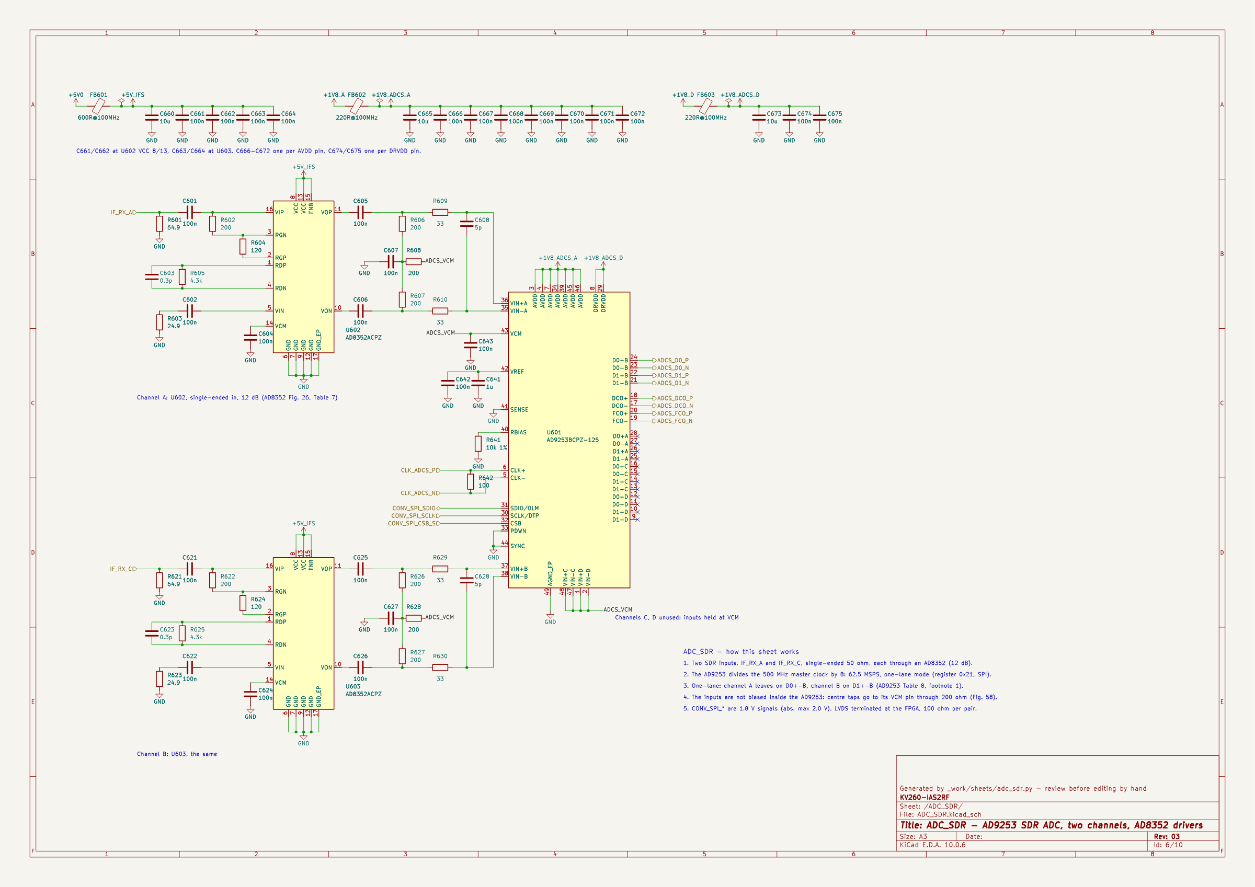
docs/img/sch/ADC_SDR.png
