PabloSoage/kv260-ias2rf/docs/img/sch/CLOCK.png

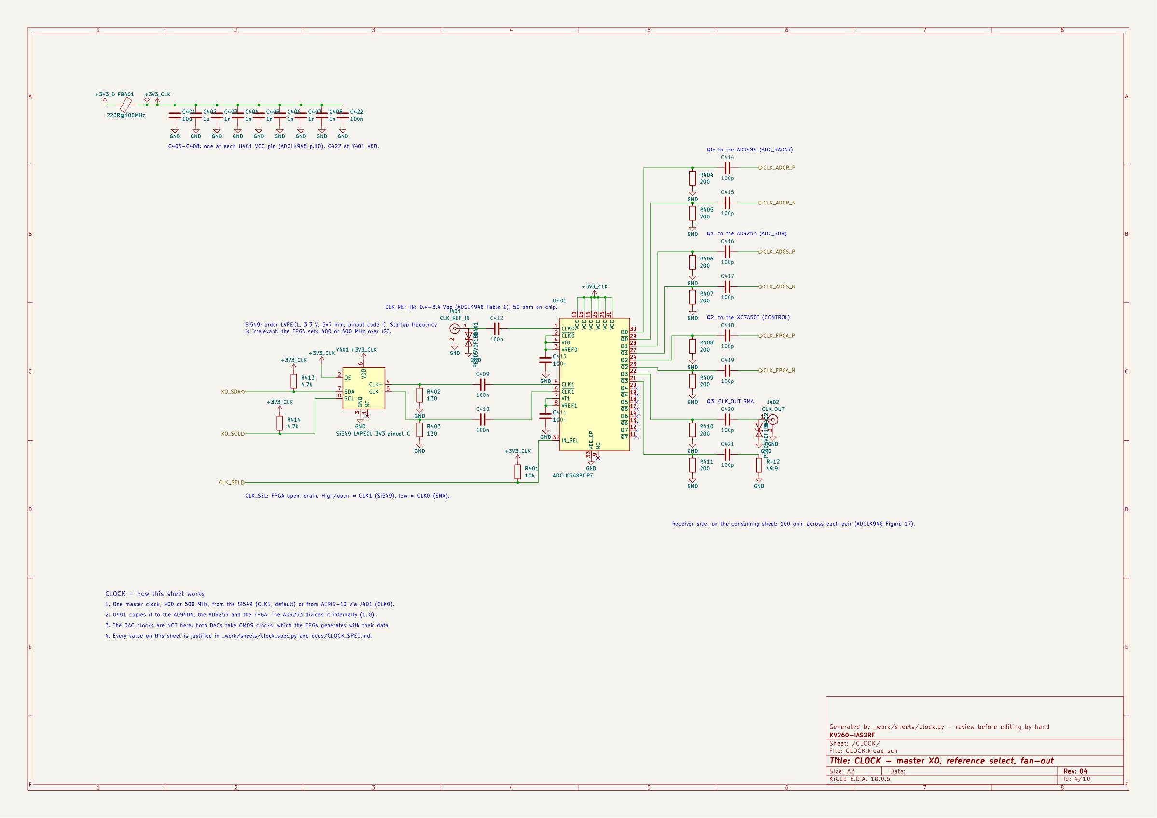
docs/img/sch/CLOCK.png
