PabloSoage/kv260-ias2rf/docs/img/sch/CONTROL.png

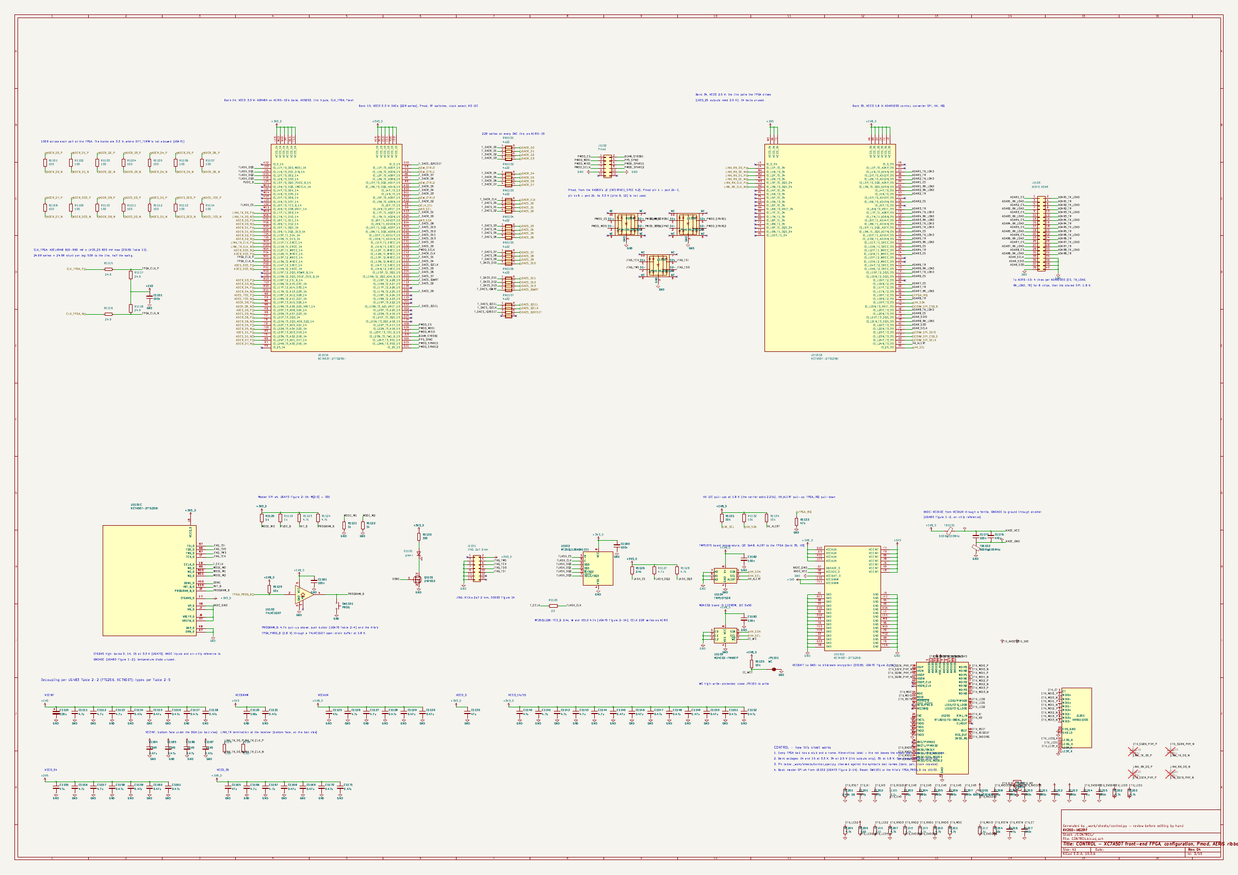
docs/img/sch/CONTROL.png
