PabloSoage/kv260-ias2rf/docs/img/sch/DAC_RADAR.png

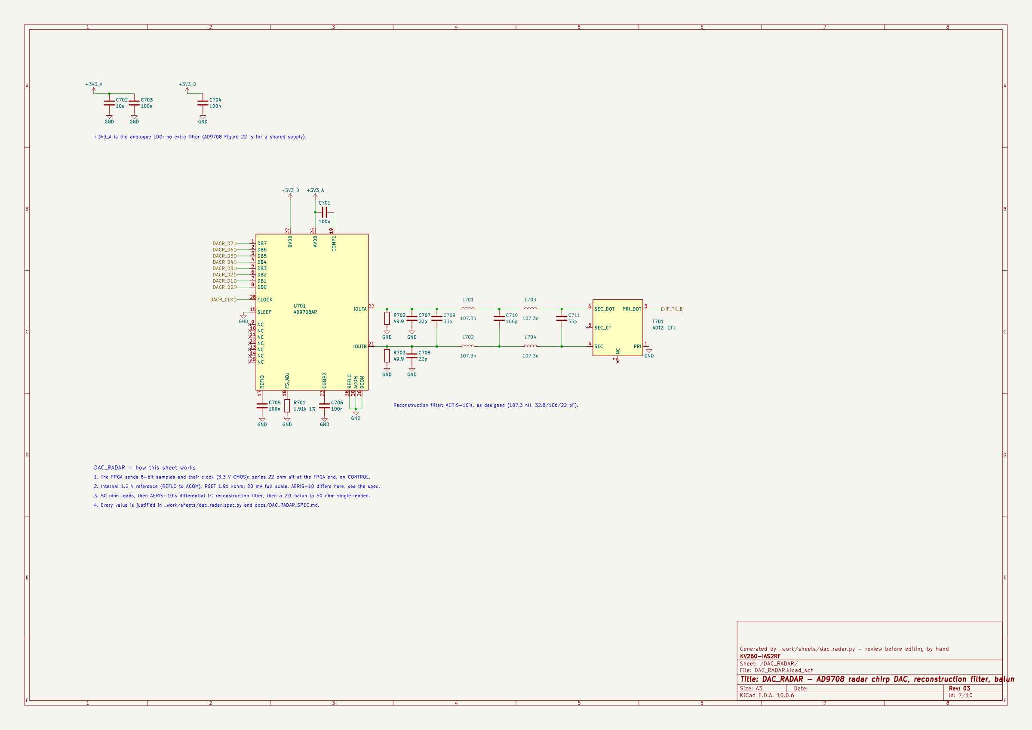
docs/img/sch/DAC_RADAR.png
