PabloSoage/kv260-ias2rf/docs/img/sch/DAC_SDR.png

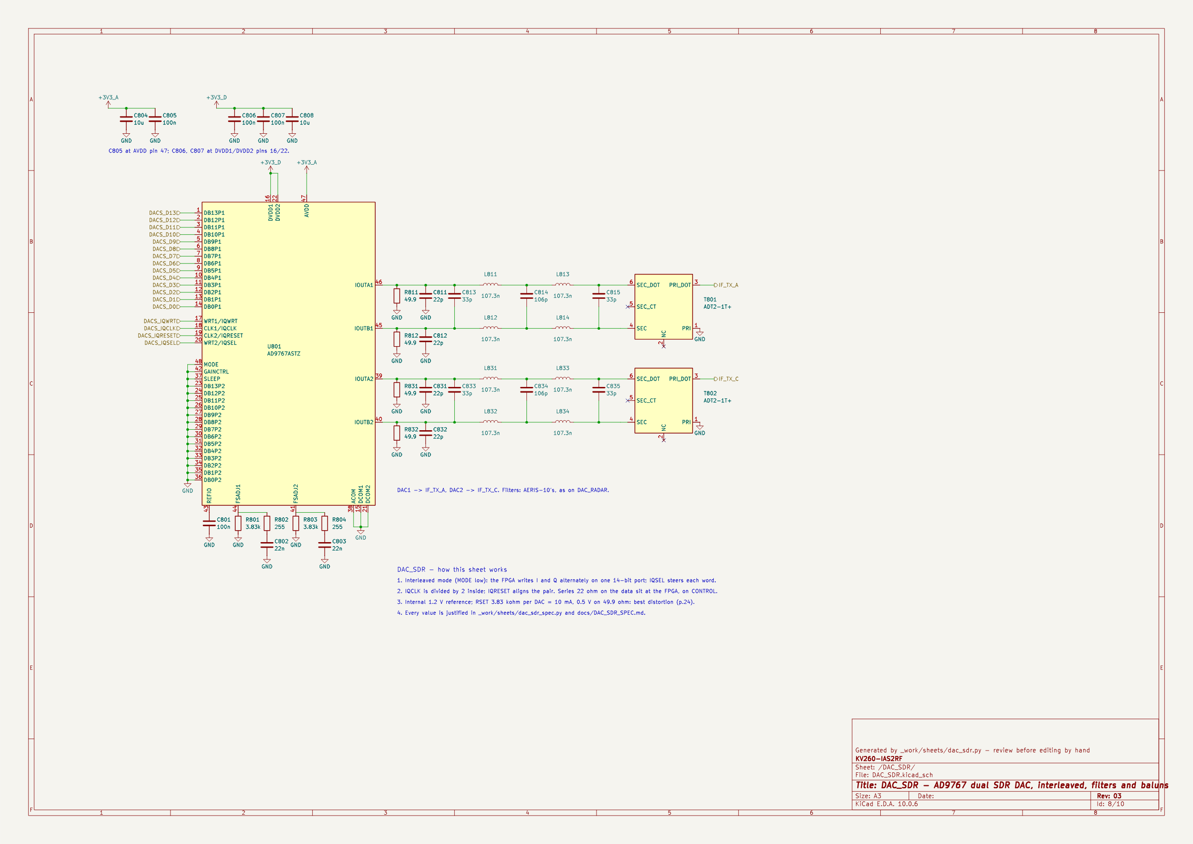
docs/img/sch/DAC_SDR.png
