PabloSoage/kv260-ias2rf/docs/img/sch/IAS_LINK.png

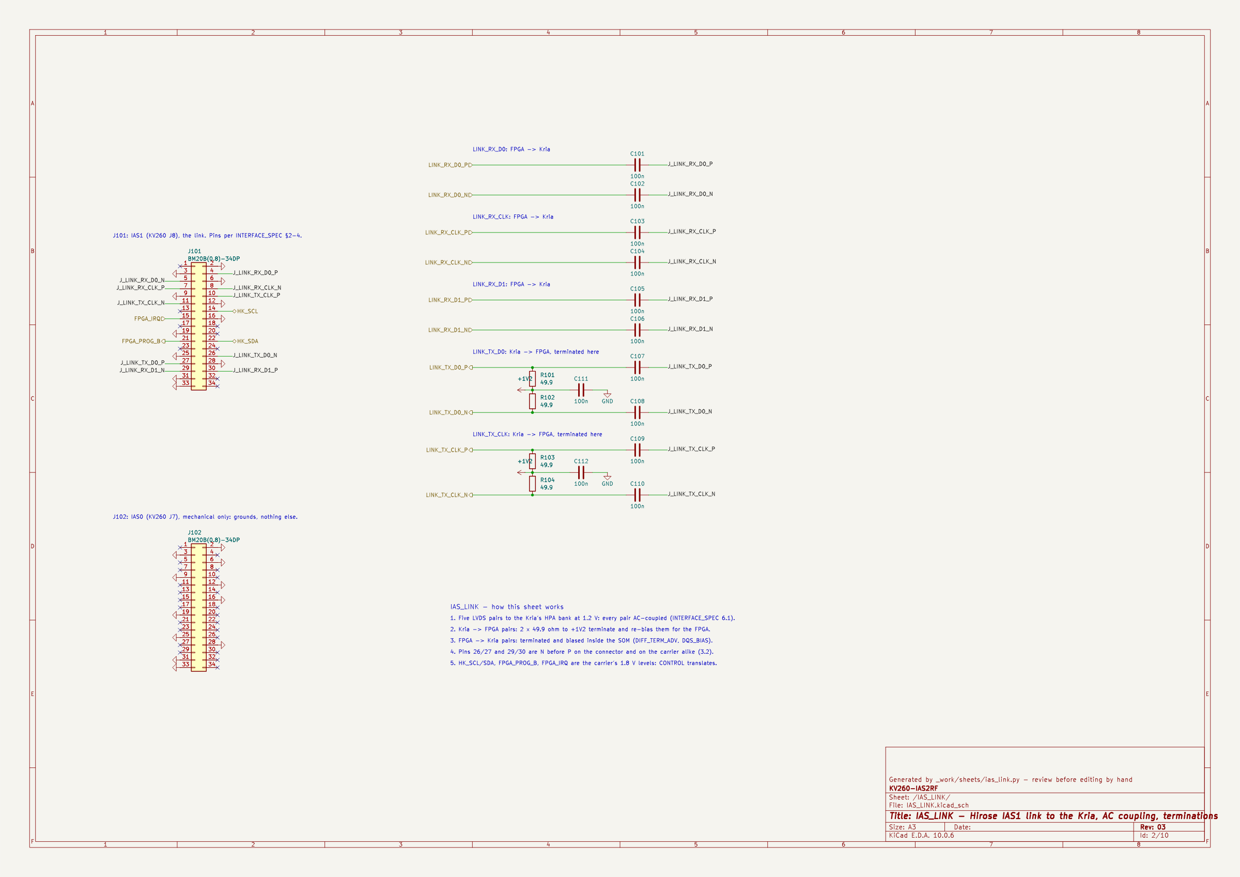
docs/img/sch/IAS_LINK.png
