PabloSoage/kv260-ias2rf/docs/img/sch/POWER.png

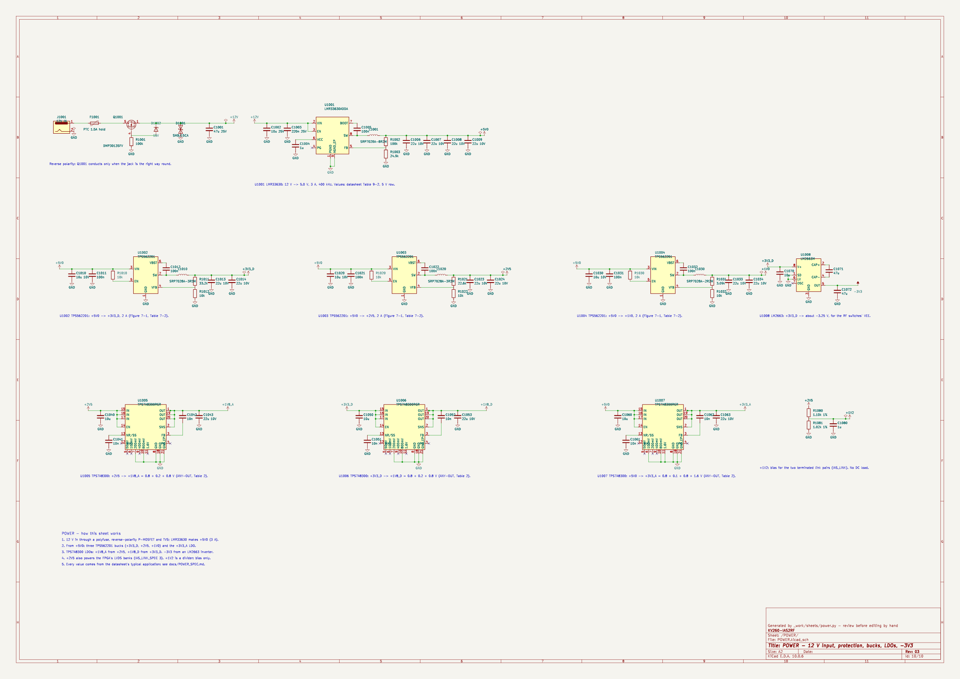
docs/img/sch/POWER.png
