PabloSoage/kv260-ias2rf/docs/img/sch/ROUTING.png

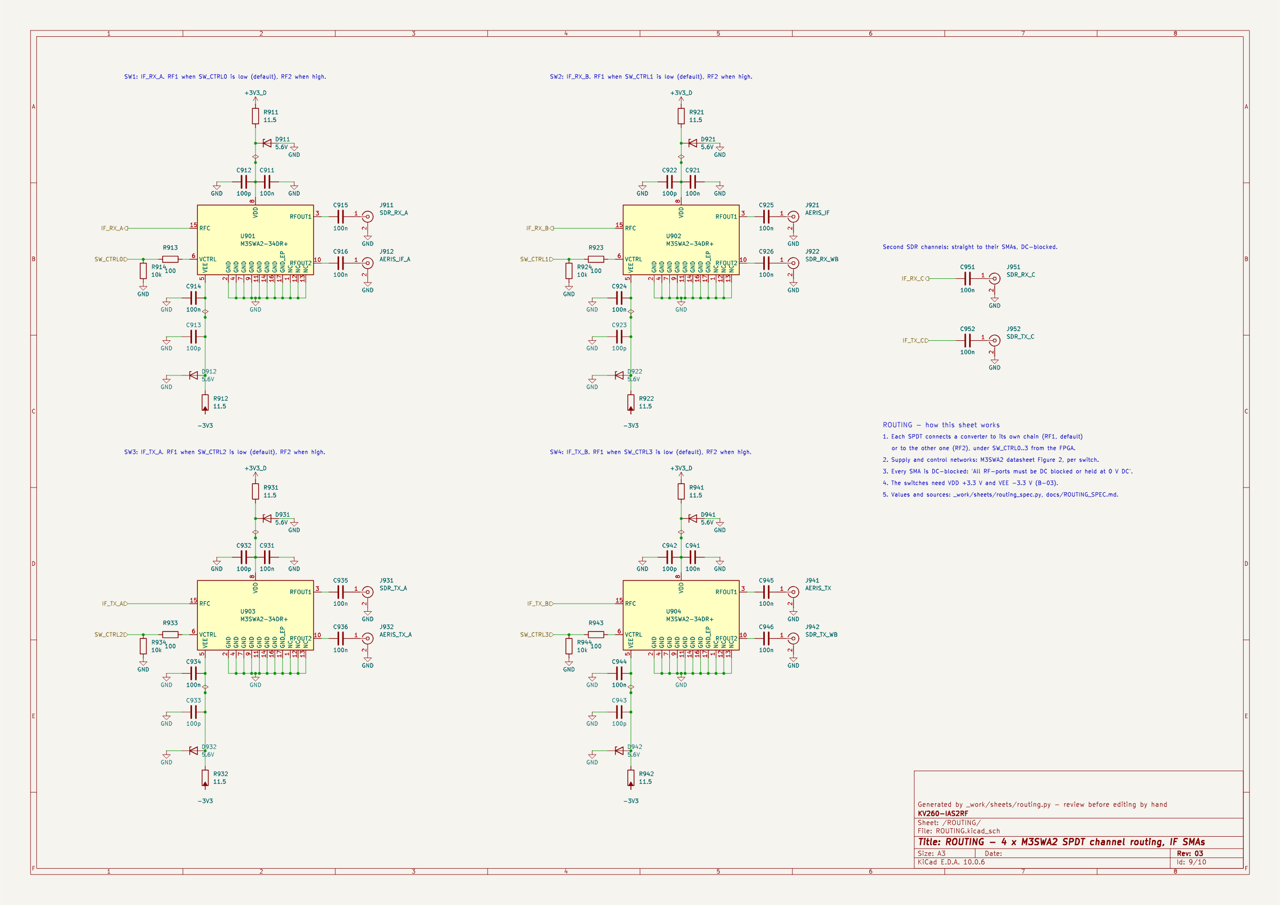
docs/img/sch/ROUTING.png
