PabloSoage/kv260-ias2rf/docs/sim/case3d_v1_Yp.png

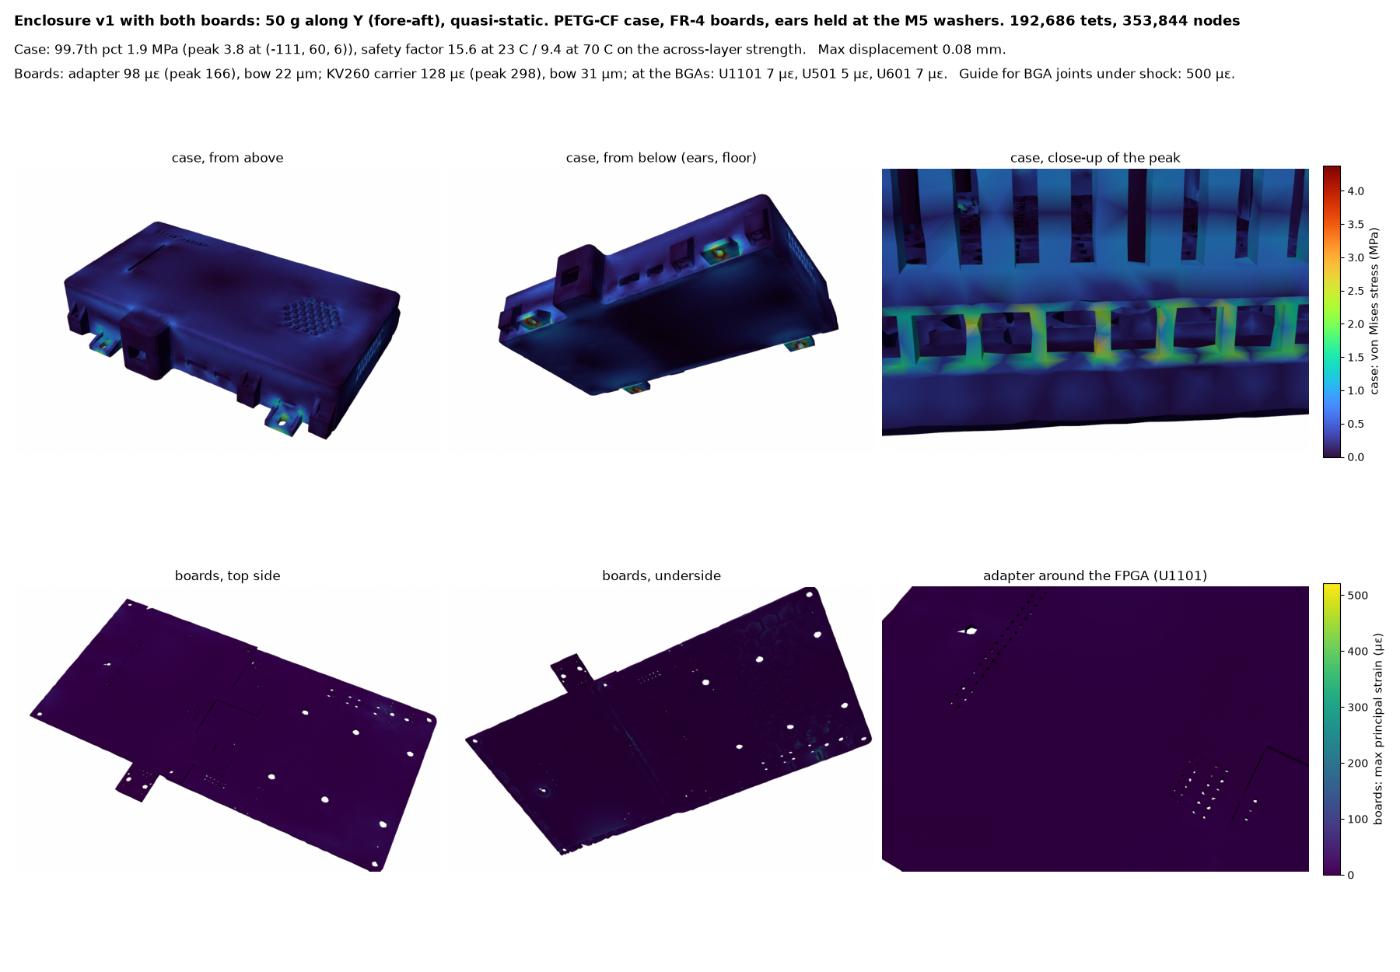
docs/sim/case3d_v1_Yp.png
