PabloSoage/kv260-ias2rf/docs/sim/eye_ADCS_FCO_1G.png

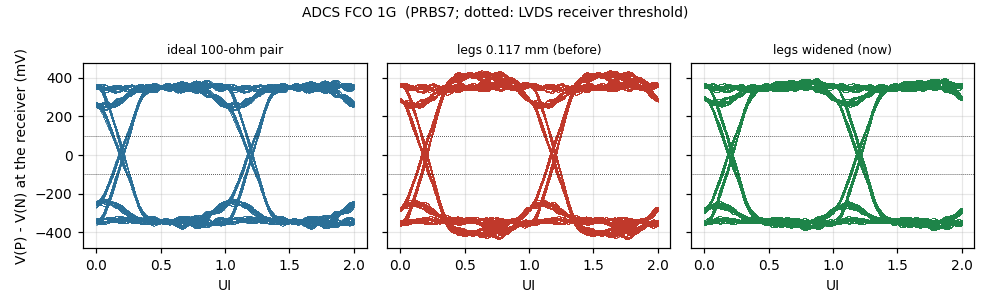
docs/sim/eye_ADCS_FCO_1G.png
