PabloSoage/kv260-ias2rf/docs/sim/eye_LINK_RX_CLK_1G.png

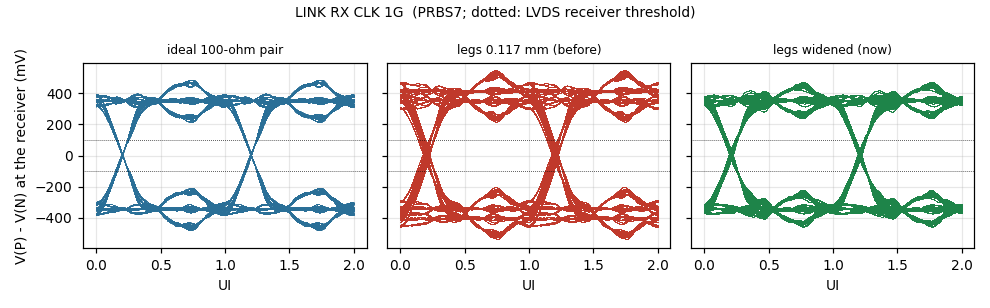
docs/sim/eye_LINK_RX_CLK_1G.png
