PabloSoage/kv260-ias2rf/docs/sim/fb401_filter.png

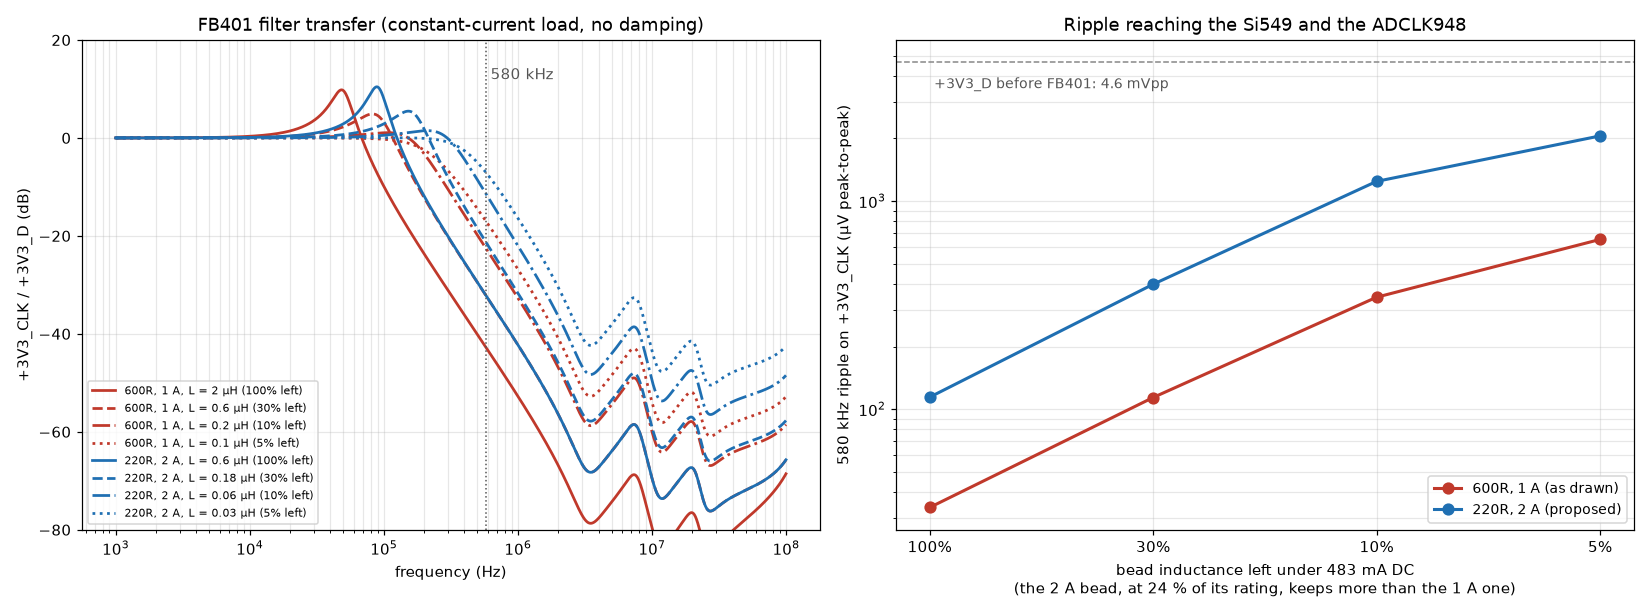
docs/sim/fb401_filter.png
