PabloSoage/kv260-ias2rf/docs/sim/pdn_1V8_D.png

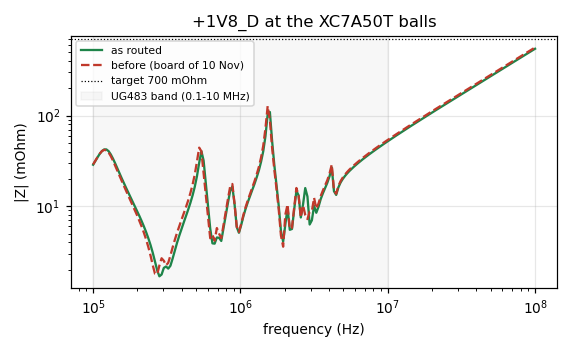
docs/sim/pdn_1V8_D.png
