PabloSoage/kv260-ias2rf/docs/sim/pdn_2V5.png

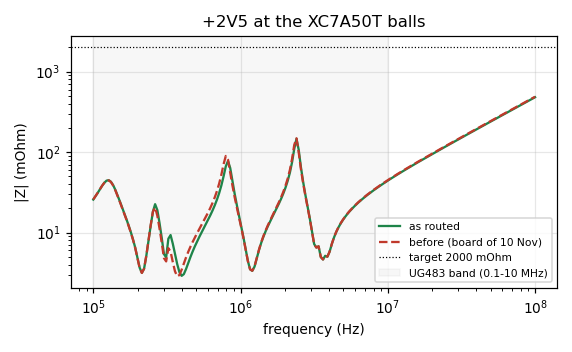
docs/sim/pdn_2V5.png
