PabloSoage/kv260-ias2rf/docs/sim/pdn_3V3_D.png

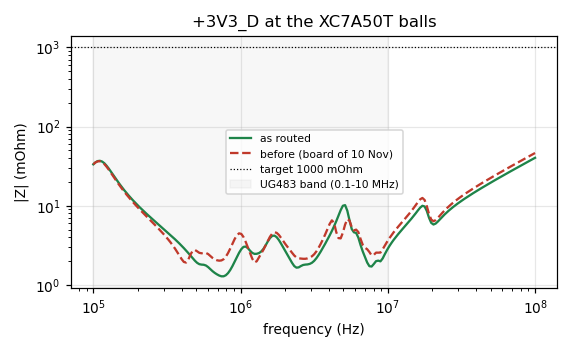
docs/sim/pdn_3V3_D.png
