PabloSoage/kv260-ias2rf/Documents/CSI2-KRIA-KV260_Rev01(standard)_BOM.xlsx

 | Bill of Materials | CSI2-KRIA-KV260_Rev01
 | Project : | Leonardo
 | PCBA : |  | Revision : | 01
 | PCB : |  | Revision : | 01
 | Variant : | standard
 | Schematic : | CSI2-KRIA-KV260_Rev01 | Schematic.pdf
 | Placement : | CSI2-KRIA-KV260_Rev01 | Overlay.pdf
 | Report Date : | 25.05.2023 | 10:11
 | Alternative Parts :
Quantity | Designator | Comment | Footprint | Description | Manufacturer | Manufacturer Part Number | KHK Part Number
4 | C1_IAS0, C1_IAS1, C2_IAS0, C2_IAS1 | NL | C-0402_0.55 | Capacitor Ceramic SMD/0402/50V/X7R/10% | several | several
4 | C3_IAS0, C3_IAS1, C4_IAS0, C4_IAS1 | 10u | C-0805_1.4 | Capacitor Ceramic SMD/0805/16V/X5R/10% | several | several | K8340151
8 | C5_IAS0, C5_IAS1, C6_IAS0, C6_IAS1, C8_IAS0, C8_IAS1, C9_IAS0, C9_IAS1 | 100n | C-0402_0.55 | Capacitor Ceramic SMD/0402/16V/X7R/10% | several | several | K8340114
2 | C7_IAS0, C7_IAS1 | 100p | C-0402_0.55 | Capacitor Ceramic SMD/0402/50V/X7R/10% | several | several | K8340145
2 | C10_IAS0, C10_IAS1 | NL | C-0603_1.0 | Capacitor Ceramic SMD/0603/50V/X7R/10% | several | several
10 | C11_IAS0, C11_IAS1, C12_IAS0, C12_IAS1, C50_IAS0, C50_IAS1, C51_IAS0, C51_IAS1, C52_IAS0, C52_IAS1 | 4u7 | C-0603_1.0 | Capacitor Ceramic SMD/0603/10V/X5R/10% | several | several | 1431
2 | D1_IAS0, D1_IAS1 | ESD9B5.0ST5G | D-SOD923 | DIODE TVS; 400W; 5.8-7.8V; BIDIRECT | ON Semiconductor | ESD9B5.0ST5G | 7250
2 | D2_IAS0, D2_IAS1 | NL | D-0603-LED | Chip LED red 250mcd | Würth | 150060RS75000
2 | D3_IAS0, D3_IAS1 | GREEN | D-0603-LED | Chip LED green 430mcd | Würth | 150060GS75000 | 8172
2 | J1_IAS0, J1_IAS1 | USB 2.0 Typ B 90° | J-629105150521 | Micro USB 2.0 Typ B 90° | WE | 629 105 150 521 | 14360
2 | J2_IAS0, J2_IAS1 | CON1x2 | CON 1x2 RM2.54 | Header Vertical, 1x2 Pos, Pitch 2.54mm, Contact Length Mating 6.00mm, Contact Length Post 3.00mm, Insulation Height 2.54mm, Gold Plating | several | several | 15337
2 | J5_IAS0, J5_IAS1 | Jumper | J-JUMPER-2.54 | CON/JUMPER/STC02SYAN; 2-pin; 2.54mm; 3A; FEMALE; VERTICAL; BLACK | several | several | 13444
2 | J6_IAS0, J6_IAS1 | CON1x3 | CON 1x3 RM2.54 | Header Vertical, 1x3 Pos, Pitch 2.54mm, Contact Length Mating 6.00mm, Contact Length Post 3.00mm, Insulation Height 2.54mm, Gold Plating | several | several | 15338
2 | J7_IAS0, J7_IAS1 | CON FFC22_Inverted | J-FH55-22S-0.5SH - Inverted Pins | FFC Connector 0.5mm shielded | Hirose | FH55-22S-0.5SH | 10357
2 | J8_IAS0, J8_IAS1 | BM20B(0.8)-34DP-0.4V(51) | J-BM20B(0.8)-34DP | CON/B2B/BM20B;34-pin;0.4;SMT;HEADER;VERTICAL | HiRose | BM20B(0.8)-34DP-0.4V(51) | 18690
2 | J9_IAS0, J9_IAS1 | NL | CON 1x4 RM2.54 | Header Vertical, 1x4 Pos, Pitch 2.54mm, Contact Length Mating 6.00mm, Contact Length Post 3.00mm, Insulation Height 2.54mm, Gold Plating | several | several
2 | J10_IAS0, J10_IAS1 | CON1x4 | CON 1x4 RM2.54 | Header Vertical, 1x4 Pos, Pitch 2.54mm, Contact Length Mating 6.00mm, Contact Length Post 3.00mm, Insulation Height 2.54mm, Gold Plating | several | several | 15343
1 | LA1 | LABEL 7x7mm | PCB LABEL 7x7 | LABEL 7x7mm | several | several
6 | MRK1, MRK2, MRK3, MRK4, MRK5, MRK6 | Marker Single Layer | PCB_Marker_Pad_top | Position Marker for PCBs
1 | PCB1 | CSI2-KRIA-KV260 |  | PCB ML06 | several | 17269-01 | 17269-01
12 | R1_IAS0, R1_IAS1, R3_IAS0, R3_IAS1, R9_IAS0, R9_IAS1, R15_IAS0, R15_IAS1, R16_IAS0, R16_IAS1, R24_IAS0, R24_IAS1 | 0R0 | R-0603_0.6 | Standard Resistor SMD/0603/1%/100mW/TK200 | several | several | K8250041
28 | R2_IAS0, R2_IAS1, R4_IAS0, R4_IAS1, R5_IAS0, R5_IAS1, R6_IAS0, R6_IAS1, R7_IAS0, R7_IAS1, R8_IAS0, R8_IAS1, R10_IAS0, R10_IAS1, R17_IAS0, R17_IAS1, R18_IAS0, R18_IAS1, R72_IAS0, R72_IAS1, R73_IAS0, R73_IAS1, R74_IAS0, R74_IAS1, R75_IAS0, R75_IAS1, R101_IAS0, R101_IAS1 | NL | R-0603_0.6 | Standard Resistor SMD/0603/1%/100mW/TK200
2 | R11_IAS0, R11_IAS1 | NL | R-0402_0.4 | Standard Resistor SMD/0402/1%/63mW/TK200
2 | R12_IAS0, R12_IAS1 | 270K | R-0402_0.4 | Standard Resistor SMD/0402/1%/63mW/TK100 | several | several | 3875
2 | R13_IAS0, R13_IAS1 | 3k3 | R-0402_0.4 | Standard Resistor SMD/0402/1%/63mW/TK100 | several | several | K8250347
2 | R14_IAS0, R14_IAS1 | 51k | R-0402_0.4 | Standard Resistor SMD/0402/1%/63mW/TK100 | several | several | K8250273
2 | R19_IAS0, R19_IAS1 | 200k | R-0402_0.4 | Standard Resistor SMD/0402/1%/63mW/TK100 | several | several | K8250280
8 | R20_IAS0, R20_IAS1, R21_IAS0, R21_IAS1, R22_IAS0, R22_IAS1, R23_IAS0, R23_IAS1 | 2k0 | R-0402_0.4 | Standard Resistor SMD/0402/1%/63mW/TK100 | several | several | K8250311
2 | R27_IAS0, R27_IAS1 | 0R0 | R-0603_0.6 | Standard Resistor SMD/0603/1%/100mW/TK100 | several | several | K8250041
2 | U1_IAS0, U1_IAS1 | NL | IC-TSSOP16 6.4x5.1x1.2 | IC/PWR/CURR SHUNT MONITOR/2.7-5.5V;4.5mR/TSSOP16/5.0x4.4x1.2mm | TI | INA260AIPWR
2 | U2_IAS0, U2_IAS1 | TPS25200DRVT | IC-DFN06_2.0x2.0x0.8 | IC/PWR/LOADSW;2V5-6V5;2A5;0R099/6-WDFN/2x2x0.8mm | Texas Instruments | TPS25200DRVT | 14277
2 | U3_IAS0, U3_IAS1 | PCA9306DCTR | IC-TSSOP8_3.15x4.25x1.3 | IC/LOGIC/LEVELSHIFTER;I2C;AUTO-DIR;1V2-5V/SSOP-8/4.25x3.15x1.3mm | TI | PCA9306DCTR | 9555
2 | U4_IAS0, U4_IAS1 | NTB0104GU12,115 | IC-XQFN12_1.7x2x0.5 | IC/LOGIC/Levelshifter;Auto-Dir;Bidirectional;Push-Pull;-40-+125°C/ | NXP | NTB0104GU12,115 | 14383
2 | U5_IAS0, U5_IAS1 | NCP114AMX330TCG | IC-XDFN4_1.0x1.0x0.6 | IC/PWR/LDO;1V7-5V5;3V3;0A3/XDFN4/1x1x0.6mm | ON Semi | NCP114AMX330TCG | 20303
