PabloSoage/kv260-ias2rf/_work/fab/lcsc_parts.csv

Comment | Footprint | Qty | LCSC | MPN | Manufacturer | Description | Library | Stock | Searched | Note
100n | C_0402_1005Metric | 130 | C1525 | CL05B104KO5NNNC | Samsung Electro-Mechanics | 100nF 16V X7R ±10% 0402 Multilayer Ceramic Capacitors MLCC - SMD/SMT ROHS | basic | 21630309 | 2026-10-02
10u | C_0805_2012Metric | 18 | C15850 | CL21A106KAYNNNE | Samsung Electro-Mechanics | 10uF 25V X5R ±10% 0805 Multilayer Ceramic Capacitors MLCC - SMD/SMT ROHS | basic | 4953088 | 2026-10-02
1u | C_0402_1005Metric | 5 | C52923 | CL05A105KA5NQNC | Samsung Electro-Mechanics | 1uF 25V X5R ±10% 0402 Multilayer Ceramic Capacitors MLCC - SMD/SMT ROHS | basic | 5627764 | 2026-10-02
1n | C_0402_1005Metric | 6 | C1523 | 0402B102K500NT | FH (Guangdong Fenghua Advanced Tech) | 1nF 50V X7R ±10% 0402 Multilayer Ceramic Capacitors MLCC - SMD/SMT ROHS | basic | 3302753 | 2026-10-02
100p | C_0402_1005Metric | 16 | C106200 | CC0402JRNPO9BN101 | YAGEO | 100pF 50V NP0 ±5% 0402 Multilayer Ceramic Capacitors MLCC - SMD/SMT ROHS | extended | 656891 | 2026-10-02
0.6p | C_0402_1005Metric | 1 | C577389 | CQ0402BRNPO9BNR60 | YAGEO | 0.6pF 50V NP0 0402 Multilayer Ceramic Capacitors MLCC - SMD/SMT ROHS | extended | 9103 | 2026-10-02
0.2p | C_0402_1005Metric | 1 | C326067 | CQ0402ARNPO9BNR20 | YAGEO | 0.2pF 50V NP0 0402 Multilayer Ceramic Capacitors MLCC - SMD/SMT ROHS | extended | 7560 | 2026-10-02
2.7p | C_0402_1005Metric | 1 | C326937 | CC0402BRNPO9BN2R7 | YAGEO | 2.7pF 50V NP0 0402 Multilayer Ceramic Capacitors MLCC - SMD/SMT ROHS | extended | 77039 | 2026-10-02
0.3p | C_0402_1005Metric | 2 | C1855147 | CQ0402ARNPO0BNR30 | YAGEO | 0.3pF 100V NP0 0402 Multilayer Ceramic Capacitors MLCC - SMD/SMT ROHS | extended | 8510 | 2026-10-02
5p | C_0402_1005Metric | 2 | C541339 | CC0402BRNPO9BN5R0 | YAGEO | 50V 5pF NP0 0402 Multilayer Ceramic Capacitors MLCC - SMD/SMT ROHS | extended | 95531 | 2026-10-02
22p | C_0402_1005Metric | 6 | C106203 | CC0402JRNPO9BN220 | YAGEO | 22pF 50V NP0 ±5% 0402 Multilayer Ceramic Capacitors MLCC - SMD/SMT ROHS | extended | 3035421 | 2026-10-02
8.2p | C_0402_1005Metric | 3 | C327205 | CC0402BRNPO9BN8R2 | YAGEO | 50V 8.2pF NP0 0402 Multilayer Ceramic Capacitors MLCC - SMD/SMT ROHS | extended | 398758 | 2026-11-13
62p | C_0402_1005Metric | 3 | C281763 | CC0402JRNPO9BN620 | YAGEO | 50V 62pF NP0 ±5% 0402 Multilayer Ceramic Capacitors MLCC - SMD/SMT ROHS | extended | 54560 | 2026-11-13
20p | C_0402_1005Metric | 3 | C107000 | CC0402JRNPO9BN200 | YAGEO | 20pF 50V NP0 ±5% 0402 Multilayer Ceramic Capacitors MLCC - SMD/SMT ROHS | extended | 1438156 | 2026-11-13
22n | C_0402_1005Metric | 2 | C1532 | 0402B223K500NT | FH (Guangdong Fenghua Advanced Tech) | 22nF 50V X7R ±10% 0402 Multilayer Ceramic Capacitors MLCC - SMD/SMT ROHS | basic | 609483 | 2026-10-02
47u 25V | C_1210_3225Metric | 1 | C7432791 | HGC1210R5476M250NSVK | Chinocera | 25V 47uF X5R ±20% 1210 Multilayer Ceramic Capacitors MLCC - SMD/SMT ROHS | extended | 98420 | 2026-10-02
10u 25V | C_1206_3216Metric | 1 | C13585 | CL31A106KBHNNNE | Samsung Electro-Mechanics | 10uF 50V X5R ±10% 1206 Multilayer Ceramic Capacitors MLCC - SMD/SMT ROHS | basic | 2393713 | 2026-10-02
220n 25V | C_0603_1608Metric | 2 | C21120 | CL10B224KA8NNNC | Samsung Electro-Mechanics | 220nF 25V X7R ±10% 0603 Multilayer Ceramic Capacitors MLCC - SMD/SMT ROHS | basic | 705706 | 2026-10-02
22u 10V | C_0805_2012Metric | 13 | C45783 | CL21A226MAQNNNE | Samsung Electro-Mechanics | 22uF 25V X5R ±20% 0805 Multilayer Ceramic Capacitors MLCC - SMD/SMT ROHS | basic | 3994427 | 2026-10-02
10u 10V | C_0805_2012Metric | 3 | C15850 | CL21A106KAYNNNE | Samsung Electro-Mechanics | 10uF 25V X5R ±10% 0805 Multilayer Ceramic Capacitors MLCC - SMD/SMT ROHS | basic | 4953088 | 2026-10-02
10n | C_0402_1005Metric | 6 | C15195 | CL05B103KB5NNNC | Samsung Electro-Mechanics | 10nF 50V X7R ±10% 0402 Multilayer Ceramic Capacitors MLCC - SMD/SMT ROHS | basic | 4050742 | 2026-10-02
47u | C_1206_3216Metric | 2 | C96123 | CL31A476MPHNNNE | Samsung Electro-Mechanics | 10V 47uF X5R ±20% 1206 Multilayer Ceramic Capacitors MLCC - SMD/SMT ROHS | basic | 301047 | 2026-10-02
100n 100V | C_0603_1608Metric | 1 | C88219 | 0603B104K101NT | FH (Guangdong Fenghua Advanced Tech) | 100V 100nF X7R ±10% 0603 Multilayer Ceramic Capacitors MLCC - SMD/SMT ROHS | extended | 1514411 | 2026-11-13
330u | CP_EIA-7343-20_Kemet-V | 1 | C136150 | T520V337M006ATE025 | KEMET | -55℃~+105℃ 25mΩ@100kHz 330uF 6.3V ±20% CASE-V-7343-19(mm) Tantalum Capacitors ROHS | extended | 1021 | 2026-10-02 | UG483 names T520V337M2R5ATE025 (2.5 V); the 6.3 V of the same series and case is what JLCPCB stocks
4.7u | C_0805_2012Metric | 13 | C1779 | CL21A475KAQNNNE | Samsung Electro-Mechanics | 25V 4.7uF X5R ±10% 0805 Multilayer Ceramic Capacitors MLCC - SMD/SMT ROHS | basic | 3048113 | 2026-10-02
0.47u | C_0603_1608Metric | 25 | C1623 | CL10B474KA8NNNC | Samsung Electro-Mechanics | 25V 470nF X7R ±10% 0603 Multilayer Ceramic Capacitors MLCC - SMD/SMT ROHS | basic | 927281 | 2026-10-02
100u | C_1210_3225Metric | 1 | C90143 | EMK325ABJ107MM-P | Taiyo Yuden | 100uF 16V X5R ±20% 1210 Multilayer Ceramic Capacitors MLCC - SMD/SMT ROHS | extended | 49157 | 2026-10-02
47u | C_1210_3225Metric | 5 | C77101 | GRM32ER61C476KE15L | Murata Electronics | 16V 47uF X5R ±10% 1210 Multilayer Ceramic Capacitors MLCC - SMD/SMT ROHS | extended | 237828 | 2026-10-02
470n | C_0603_1608Metric | 1 | C1623 | CL10B474KA8NNNC | Samsung Electro-Mechanics | 25V 470nF X7R ±10% 0603 Multilayer Ceramic Capacitors MLCC - SMD/SMT ROHS | basic | 927281 | 2026-10-02
0.47u | C_0402_1005Metric | 4 | C47339 | CL05A474KP5NNNC | Samsung Electro-Mechanics | 10V 470nF X5R ±10% 0402 Multilayer Ceramic Capacitors MLCC - SMD/SMT ROHS | extended | 577801 | 2026-11-11 | VCCINT bottom side under the BGA (C1184-C1187)
27p | C_0402_1005Metric | 2 | C107002 | CC0402JRNPO9BN270 | YAGEO | 27pF 50V NP0 ±5% 0402 Multilayer Ceramic Capacitors MLCC - SMD/SMT ROHS | extended | 1035493 | 2026-11-13
4.7u | C_0402_1005Metric | 1 | C23733 | CL05A475MP5NRNC | Samsung Electro-Mechanics | 10V 4.7uF X5R ±20% 0402 Multilayer Ceramic Capacitors MLCC - SMD/SMT ROHS | basic | 645594 | 2026-11-13
PESD5V0F1BL | D_SOD-882 | 12 | C45961 | PESD5V0F1BL,315 | Nexperia | -40℃~+125℃ 0.4pF 1 100nA 15V 2.5A 5.5V 6V Bidirectional ESD IEC 61000-4-2 DFN1006-2 ESD and Surge Protection (TVS/ESD) ROHS | extended | 141358 | 2026-11-11 | SMA ESD (D961-D970, D401, D402)
5.6V | D_SOD-123 | 8 | C19077423 | MMSZ5232B | hongjiacheng | -55℃~+150℃ 1 Independent 11Ω 5.32V~5.88V 5.4V 500mW 5uA@3V SOD-123 Zener Diodes ROHS | extended | 50902 | 2026-10-02
SMBJ18CA | D_SMB | 1 | C78413 | SMBJ18CA/TR13 | Brightking | 18V 1uA 20.6A 20V 29.2V 600W Bidirectional TVS SMB(DO-214AA) ESD and Surge Protection (TVS/ESD) ROHS | extended | 479934 | 2026-11-13
SMCJ33CA | D_SMC | 1 | C310048 | SMCJ33CA/TR13 | Brightking | -65℃~+150℃ 1.5kW 1uA 28.2A 33V 36.7V 53.3V Bidirectional TVS SMC(DO-214AB) ESD and Surge Protection (TVS/ESD) ROHS | extended | 93791 | 2026-11-13
green | LED_0603_1608Metric | 1 | C12624 | KT-0603G | Hubei KENTO Elec | -40℃~+85℃ 1.6mm x 0.8mm square LED 100mW 120° 3.1V 430mcd 513nm~528nm 525nm 5mA Discrete Diode Emerald Green Water Clear 0603 LED Indication - Discrete ROHS | extended | 308338 | 2026-10-02
PTC 1.5A hold | Fuse_1812_4532Metric | 1 | C369174 | JK-MSMD150-24V | Jinrui Electronic Materials Co. | -40℃~+85℃ 1.5A 1.7mm 100A 160mΩ 24V 3.41mm 3A 4.73mm 40mΩ 500ms 1812 Resettable Fuses ROHS | extended | 32930 | 2026-10-02
PTC 0.5A hold | Fuse_1206_3216Metric | 1 | C43379 | SMD1206P050TF/13.2 | RUILON(Shenzhen Ruilongyuan Elec) | -40℃~+85℃ 0.8mm 1.9mm 100ms 13.2V 150mΩ 1A 3.6mm 35A 500mA 600mW 700mΩ 1206 Resettable Fuses ROHS | extended | 13007 | 2026-11-14
600R@100MHz | L_0603_1608Metric | 5 | C108301 | PBY160808T-601Y-N | Chilisin Elec | 1 1A 200mΩ 600Ω@100MHz ±25% 0603 Ferrite Beads ROHS | extended | 1123927 | 2026-10-02
220R@100MHz | L_0603_1608Metric | 5 | C304314 | HCB1608KF-221T20 | TAI-TECH | -55℃~+125℃ 1 100mΩ 220Ω@100MHz 2A ±25% 0603 Ferrite Beads ROHS | extended | 886510 | 2026-10-02
BM20B(0.8)-34DP | J-BM20B(0.8)-34DP | 2 | C424540 | BM20B(0.8)-34DP-0.4V(51) | HRS(Hirose) | -35℃~+85℃ 0.4mm 2 300mA 30V 34P Gold Phosphor bronze Surface Mount,Vertical SMD,P=0.4mm Board-to-Board and Backplane Connector ROHS | extended | 8785 | 2026-10-02
CLK_REF_IN | SMA_Samtec_SMA-J-P-H-ST-EM1_EdgeMount | 1 | C5199907 | SMA-J-P-H-ST-EM1 | Samtec | -65℃~+125℃ 1 20GHz 335V 50Ω Board Side Inner pin Positive Pin SMA SMD Coaxial Connectors (RF) ROHS | extended | 905 | 2026-10-02
CLK_OUT | SMA_Samtec_SMA-J-P-H-ST-EM1_EdgeMount | 1 | C5199907 | SMA-J-P-H-ST-EM1 | Samtec | -65℃~+125℃ 1 20GHz 335V 50Ω Board Side Inner pin Positive Pin SMA SMD Coaxial Connectors (RF) ROHS | extended | 905 | 2026-10-02
SDR_RX_A | SMA_Samtec_SMA-J-P-H-ST-EM1_EdgeMount | 1 | C5199907 | SMA-J-P-H-ST-EM1 | Samtec | -65℃~+125℃ 1 20GHz 335V 50Ω Board Side Inner pin Positive Pin SMA SMD Coaxial Connectors (RF) ROHS | extended | 905 | 2026-10-02
AERIS_IF_A | SMA_Samtec_SMA-J-P-H-ST-EM1_EdgeMount | 1 | C5199907 | SMA-J-P-H-ST-EM1 | Samtec | -65℃~+125℃ 1 20GHz 335V 50Ω Board Side Inner pin Positive Pin SMA SMD Coaxial Connectors (RF) ROHS | extended | 905 | 2026-10-02
AERIS_IF | SMA_Samtec_SMA-J-P-H-ST-EM1_EdgeMount | 1 | C5199907 | SMA-J-P-H-ST-EM1 | Samtec | -65℃~+125℃ 1 20GHz 335V 50Ω Board Side Inner pin Positive Pin SMA SMD Coaxial Connectors (RF) ROHS | extended | 905 | 2026-10-02
SDR_RX_WB | SMA_Samtec_SMA-J-P-H-ST-EM1_EdgeMount | 1 | C5199907 | SMA-J-P-H-ST-EM1 | Samtec | -65℃~+125℃ 1 20GHz 335V 50Ω Board Side Inner pin Positive Pin SMA SMD Coaxial Connectors (RF) ROHS | extended | 905 | 2026-10-02
SDR_TX_A | SMA_Samtec_SMA-J-P-H-ST-EM1_EdgeMount | 1 | C5199907 | SMA-J-P-H-ST-EM1 | Samtec | -65℃~+125℃ 1 20GHz 335V 50Ω Board Side Inner pin Positive Pin SMA SMD Coaxial Connectors (RF) ROHS | extended | 905 | 2026-10-02
AERIS_TX_A | SMA_Samtec_SMA-J-P-H-ST-EM1_EdgeMount | 1 | C5199907 | SMA-J-P-H-ST-EM1 | Samtec | -65℃~+125℃ 1 20GHz 335V 50Ω Board Side Inner pin Positive Pin SMA SMD Coaxial Connectors (RF) ROHS | extended | 905 | 2026-10-02
AERIS_TX | SMA_Samtec_SMA-J-P-H-ST-EM1_EdgeMount | 1 | C5199907 | SMA-J-P-H-ST-EM1 | Samtec | -65℃~+125℃ 1 20GHz 335V 50Ω Board Side Inner pin Positive Pin SMA SMD Coaxial Connectors (RF) ROHS | extended | 905 | 2026-10-02
SDR_TX_WB | SMA_Samtec_SMA-J-P-H-ST-EM1_EdgeMount | 1 | C5199907 | SMA-J-P-H-ST-EM1 | Samtec | -65℃~+125℃ 1 20GHz 335V 50Ω Board Side Inner pin Positive Pin SMA SMD Coaxial Connectors (RF) ROHS | extended | 905 | 2026-10-02
SDR_RX_C | SMA_Samtec_SMA-J-P-H-ST-EM1_EdgeMount | 1 | C5199907 | SMA-J-P-H-ST-EM1 | Samtec | -65℃~+125℃ 1 20GHz 335V 50Ω Board Side Inner pin Positive Pin SMA SMD Coaxial Connectors (RF) ROHS | extended | 905 | 2026-10-02
SDR_TX_C | SMA_Samtec_SMA-J-P-H-ST-EM1_EdgeMount | 1 | C5199907 | SMA-J-P-H-ST-EM1 | Samtec | -65℃~+125℃ 1 20GHz 335V 50Ω Board Side Inner pin Positive Pin SMA SMD Coaxial Connectors (RF) ROHS | extended | 905 | 2026-10-02
12V IN | BarrelJack_CUI_PJ-102AH_Horizontal | 1 | C3096093 | PJ-102AH | CUI | -25℃~+85℃ 24V 2mm 5A 6.5mm DC Power Jack Right Angle Plugin DC Power Connectors ROHS | extended | 1066 | 2026-10-02
FAN 5V | JST_PH_B2B-PH-K_1x02_P2.00mm_Vertical | 1 | C131337 | B2B-PH-K-S(LF)(SN) | JST | -25℃~+85℃ 1 100V 1x2P 2 2A 2P 2mm 4.5mm 5.9mm 6mm Brass K Pin PA66 PH Through Hole Tin UL94V-0 White 插件,P=2mm Wire To Board Connector ROHS | extended | 290465 | 2026-11-14
JTAG 2x7 2mm | PinHeader_2x07_P2.00mm_Vertical | 1 | C492354 | 878321420 | MOLEX | -55℃~+105℃ 125V 14P 2 2A 2mm 2mm 2x7P 7 Black Gold PA Phosphor bronze Surface Mount,Vertical UL94V-0 SMD,P=2mm Wire To Board Connector ROHS | extended | 4382 | 2026-10-02
Pmod | PinHeader_2x06_P2.54mm_Vertical | 1 | C32713279 | HX PZ2.54-2x6P ZZ | hanxia | -40℃~+105℃ 12P 1kV 2 2.54mm 2.54mm 2.5mm 2x6P 3A 3mm 6mm Black Copper alloy Gold Square pin Through Hole Plugin,P=2.54mm Pin Headers ROHS | extended | 27903 | 2026-10-02
AERIS ADAR | IDC-Header_2x20_P2.54mm_Vertical | 1 | C132439 | B-3000S40P-0110 | Ckmtw(Shenzhen Cankemeng) | 2 2.54mm 2.54mm 20 2x20P Brass Gold IDC Header Through Hole 插件,P=2.54mm IDC Connectors ROHS | extended | 2004 | 2026-10-02
HR911130C | RJ45_Hanrun_HR911130C | 1 | C50933 | HR911130C | HANRUN(Zhongshan HanRun Elec) | 0℃~+70℃ 1 Gold Non-PoE Phosphor bronze RJ45 Jack Right Angle Shielded With LED 弯插 Ethernet Connectors / Modular Connectors (RJ45 RJ11) ROHS | extended | 7247 | 2026-11-13
270n | L_0603_1608Metric | 12 | C98092 | LQW18ANR27G00D | Murata Electronics | 110mA 270nH 3.4Ω Consumer grade Unshielded Inductor ±2% 0603 Inductors (SMD) ROHS | extended | 8740 | 2026-11-13
SRP7028A-8R2M | L_Bourns_SRP7028A_7.3x6.6mm | 1 | C2041815 | SRP7028A-8R2M | BOURNS | 4A 64mΩ 7.5A 8.2uH ±20% SMD,7.3x6.6mm Power Inductors ROHS | extended | 73 | 2026-10-02
SRP7028A-3R3M | L_Bourns_SRP7028A_7.3x6.6mm | 2 | C913186 | SRP7028A-3R3M | BOURNS | 12A 3.3uH 30mΩ 6A ±20% SMD,7.3x6.6mm Power Inductors ROHS | extended | 2246 | 2026-10-02
SRP7028A-2R2M | L_Bourns_SRP7028A_7.3x6.6mm | 1 | C1329579 | SRP7028A-2R2M | BOURNS | 14A 18mΩ 2.2uH 8A ±20% SMD,7.3x6.6mm Power Inductors ROHS | extended | 1852 | 2026-10-02
2.2u | L_0805_2012Metric | 1 | C2049745 | DFE201210U-2R2M=P2 | Murata Electronics | 1.2A 2.2uH 228mΩ 2A ±20% 0805 Power Inductors ROHS | extended | 5386 | 2026-11-13
DMT10H015LFG | Diodes_PowerDI3333-8 | 2 | C5245407 | DMT10H015LFG-7 | Diodes Incorporated | -55℃~+150℃ 1 N-channel 1.871nF 100V 13.5mΩ@10V 3.5V 33.3nC@10V 35W 42A PowerDI3333-8 MOSFETs ROHS | extended | 65 | 2026-11-13
2N7002 | SOT-23 | 1 | C8545 | 2N7002 | Jiangsu Changjing Electronics Technology Co., Ltd. | 1 N-channel 115mA 2.5V 225mW 25pF 50pF 5pF 5Ω@10V 60V N-Channel ±20V SOT-23 MOSFETs ROHS | basic | 1620052 | 2026-10-02
10k | R_0402_1005Metric | 24 | C25744 | 0402WGF1002TCE | UNI-ROYAL(Uniroyal Elec) | -55℃~+155℃ 10kΩ 50V 62.5mW Thick Film Resistor ±1% ±100ppm/℃ 0402 Chip Resistor - Surface Mount ROHS | basic | 21756154 | 2026-10-02
100 | R_0402_1005Metric | 22 | C25076 | 0402WGF1000TCE | UNI-ROYAL(Uniroyal Elec) | -55℃~+155℃ 100Ω 50V 62.5mW Thick Film Resistor ±1% ±100ppm/℃ 0402 Chip Resistor - Surface Mount ROHS | basic | 4083312 | 2026-10-02
130 | R_0402_1005Metric | 2 | C477610 | RC0402FR-07130RL | YAGEO | -55℃~+155℃ 130Ω 50V 62.5mW Thick Film Resistor ±1% ±100ppm/℃ 0402 Chip Resistor - Surface Mount ROHS | extended | 175149 | 2026-10-02
200 | R_0402_1005Metric | 21 | C25087 | 0402WGF2000TCE | UNI-ROYAL(Uniroyal Elec) | -55℃~+155℃ 200Ω 50V 62.5mW Thick Film Resistor ±1% ±100ppm/℃ 0402 Chip Resistor - Surface Mount ROHS | basic | 2605677 | 2026-10-02
49.9 | R_0402_1005Metric | 7 | C25120 | 0402WGF499JTCE | UNI-ROYAL(Uniroyal Elec) | -55℃~+155℃ 49.9Ω 50V 62.5mW Thick Film Resistor ±1% ±100ppm/℃ 0402 Chip Resistor - Surface Mount ROHS | basic | 1403830 | 2026-10-02
4.7k | R_0402_1005Metric | 14 | C25900 | 0402WGF4701TCE | UNI-ROYAL(Uniroyal Elec) | -55℃~+155℃ 4.7kΩ 50V 62.5mW Thick Film Resistor ±1% ±100ppm/℃ 0402 Chip Resistor - Surface Mount ROHS | basic | 15493637 | 2026-10-02
64.9 | R_0402_1005Metric | 3 | C3013184 | FRC0402F64R9TS | FOJAN | -55℃~+155℃ 50V 62.5mW 64.9Ω Thick Film Resistor ±1% ±100ppm/℃ 0402 Chip Resistor - Surface Mount ROHS | extended | 60214 | 2026-10-02
24.9 | R_0402_1005Metric | 7 | C226372 | AC0402FR-0724R9L | YAGEO | -55℃~+155℃ 24.9Ω 50V 62.5mW Thick Film Resistor ±1% ±100ppm/℃ 0402 Chip Resistor - Surface Mount ROHS | extended | 138585 | 2026-10-02
68 | R_0402_1005Metric | 1 | C2909380 | FRC0402F68R0TS | FOJAN | -55℃~+155℃ 50V 62.5mW 68Ω Thick Film Resistor ±1% ±100ppm/℃ 0402 Chip Resistor - Surface Mount ROHS | extended | 1167625 | 2026-10-02
4.3k | R_0402_1005Metric | 4 | C2930008 | FRC0402F4301TS | FOJAN | -55℃~+155℃ 4.3kΩ 50V 62.5mW Thick Film Resistor ±1% ±100ppm/℃ 0402 Chip Resistor - Surface Mount ROHS | extended | 303633 | 2026-10-02
115 | R_0402_1005Metric | 1 | C7467414 | FRC0402F1150TS | FOJAN | -55℃~+155℃ 115Ω 50V 62.5mW Thick Film Resistor ±1% ±100ppm/℃ 0402 Chip Resistor - Surface Mount ROHS | extended | 22787 | 2026-10-02
24 | R_0402_1005Metric | 2 | C270625 | 0402WGF240JTCE | UNI-ROYAL(Uniroyal Elec) | -55℃~+155℃ 24Ω 50V 62.5mW Thick Film Resistor ±1% ±100ppm/℃ 0402 Chip Resistor - Surface Mount ROHS | extended | 66748 | 2026-10-02
20k | R_0402_1005Metric | 1 | C25765 | 0402WGF2002TCE | UNI-ROYAL(Uniroyal Elec) | -55℃~+155℃ 20kΩ 50V 62.5mW Thick Film Resistor ±1% ±100ppm/℃ 0402 Chip Resistor - Surface Mount ROHS | basic | 3010668 | 2026-10-02
120 | R_0402_1005Metric | 2 | C25079 | 0402WGF1200TCE | UNI-ROYAL(Uniroyal Elec) | -55℃~+155℃ 120Ω 50V 62.5mW Thick Film Resistor ±1% ±100ppm/℃ 0402 Chip Resistor - Surface Mount ROHS | basic | 789699 | 2026-10-02
33 | R_0402_1005Metric | 4 | C25105 | 0402WGF330JTCE | UNI-ROYAL(Uniroyal Elec) | -55℃~+155℃ 33Ω 50V 62.5mW Thick Film Resistor ±1% ±100ppm/℃ 0402 Chip Resistor - Surface Mount ROHS | basic | 1830814 | 2026-10-02
10k 1% | R_0402_1005Metric | 1 | C25744 | 0402WGF1002TCE | UNI-ROYAL(Uniroyal Elec) | -55℃~+155℃ 10kΩ 50V 62.5mW Thick Film Resistor ±1% ±100ppm/℃ 0402 Chip Resistor - Surface Mount ROHS | basic | 21756134 | 2026-10-02
1.91k 1% | R_0402_1005Metric | 1 | C2998115 | FRC0402F1911TS | FOJAN | -55℃~+155℃ 1.91kΩ 50V 62.5mW Thick Film Resistor ±1% ±100ppm/℃ 0402 Chip Resistor - Surface Mount ROHS | extended | 102704 | 2026-10-02
3.83k | R_0402_1005Metric | 2 | C5159686 | FRC0402F3831TS | FOJAN | -55℃~+155℃ 3.83kΩ 50V 62.5mW Thick Film Resistor ±1% ±100ppm/℃ 0402 Chip Resistor - Surface Mount ROHS | extended | 45159 | 2026-10-02
255 | R_0402_1005Metric | 2 | C226375 | AC0402FR-07255RL | YAGEO | -55℃~+155℃ 255Ω 50V 62.5mW Thick Film Resistor ±1% ±100ppm/℃ 0402 Chip Resistor - Surface Mount ROHS | extended | 8888 | 2026-10-02
11.5 | R_0402_1005Metric | 8 | C3015726 | SCR0402F11R5 | VO | -55℃~+155℃ 11.5Ω 50V 62.5mW Thick Film Resistor ±1% ±100ppm/℃ 0402 Chip Resistor - Surface Mount ROHS | extended | 9218 | 2026-10-02
100k | R_0402_1005Metric | 1 | C25741 | 0402WGF1003TCE | UNI-ROYAL(Uniroyal Elec) | -55℃~+155℃ 100kΩ 50V 62.5mW Thick Film Resistor ±1% ±100ppm/℃ 0402 Chip Resistor - Surface Mount ROHS | basic | 8237793 | 2026-10-02
24.9k | R_0402_1005Metric | 1 | C138027 | RC0402FR-0724K9L | YAGEO | -55℃~+155℃ 24.9kΩ 50V 62.5mW Thick Film Resistor ±1% ±100ppm/℃ 0402 Chip Resistor - Surface Mount ROHS | extended | 146446 | 2026-10-02
100k | R_0603_1608Metric | 1 | C25803 | 0603WAF1003T5E | UNI-ROYAL(Uniroyal Elec) | -55℃~+155℃ 100kΩ 100mW 75V Thick Film Resistor ±1% ±100ppm/℃ 0603 Chip Resistor - Surface Mount ROHS | basic | 14896836 | 2026-11-13
7.32k | R_0603_1608Metric | 1 | C2933256 | FRC0603F7321TS | FOJAN | -55℃~+155℃ 100mW 7.32kΩ 75V Thick Film Resistor ±1% ±100ppm/℃ 0603 Chip Resistor - Surface Mount ROHS | extended | 429920 | 2026-11-13
33.2k | R_0402_1005Metric | 1 | C122548 | 0402WGF3322TCE | UNI-ROYAL(Uniroyal Elec) | -55℃~+155℃ 33.2kΩ 50V 62.5mW Thick Film Resistor ±1% ±100ppm/℃ 0402 Chip Resistor - Surface Mount ROHS | extended | 350208 | 2026-10-02
22.6k | R_0402_1005Metric | 1 | C100316 | CR0402FF2262G | LIZ Elec | -55℃~+125℃ 22.6kΩ 50V 62.5mW Thick Film Resistor ±1% ±200ppm/℃ 0402 Chip Resistor - Surface Mount ROHS | extended | 19420 | 2026-11-10
3.09k | R_0402_1005Metric | 1 | C11460 | 0402WGF3091TCE | UNI-ROYAL(Uniroyal Elec) | -55℃~+155℃ 3.09kΩ 50V 62.5mW Thick Film Resistor ±1% ±100ppm/℃ 0402 Chip Resistor - Surface Mount ROHS | extended | 17015 | 2026-10-02
1.10k 1% | R_0402_1005Metric | 1 | C25860 | 0402WGF1101TCE | UNI-ROYAL(Uniroyal Elec) | -55℃~+155℃ 1.1kΩ 50V 62.5mW Thick Film Resistor ±1% ±100ppm/℃ 0402 Chip Resistor - Surface Mount ROHS | extended | 156737 | 2026-10-02
1.02k 1% | R_0402_1005Metric | 1 | C49653224 | GR0402F1K02TAG00 | GiantOhm | -55℃~+155℃ 1.02kΩ 50V 62.5mW Thick Film Resistor ±1% ±100ppm/℃ 0402 Chip Resistor - Surface Mount ROHS | extended | 8237 | 2026-10-02
1k | R_0402_1005Metric | 4 | C11702 | 0402WGF1001TCE | UNI-ROYAL(Uniroyal Elec) | -55℃~+155℃ 1kΩ 50V 62.5mW Thick Film Resistor ±1% ±100ppm/℃ 0402 Chip Resistor - Surface Mount ROHS | basic | 7176769 | 2026-10-02
22 | R_0402_1005Metric | 1 | C25092 | 0402WGF220JTCE | UNI-ROYAL(Uniroyal Elec) | -55℃~+155℃ 22Ω 50V 62.5mW Thick Film Resistor ±1% ±100ppm/℃ 0402 Chip Resistor - Surface Mount ROHS | basic | 4618023 | 2026-10-02
2.4k | R_0402_1005Metric | 1 | C25882 | 0402WGF2401TCE | UNI-ROYAL(Uniroyal Elec) | -55℃~+155℃ 2.4kΩ 50V 62.5mW Thick Film Resistor ±1% ±100ppm/℃ 0402 Chip Resistor - Surface Mount ROHS | extended | 67760 | 2026-10-02
330 | R_0402_1005Metric | 1 | C25104 | 0402WGF3300TCE | UNI-ROYAL(Uniroyal Elec) | -55℃~+155℃ 330Ω 50V 62.5mW Thick Film Resistor ±1% ±100ppm/℃ 0402 Chip Resistor - Surface Mount ROHS | basic | 1195444 | 2026-10-02
47k | R_0402_1005Metric | 1 | C25792 | 0402WGF4702TCE | UNI-ROYAL(Uniroyal Elec) | -55℃~+155℃ 47kΩ 50V 62.5mW Thick Film Resistor ±1% ±100ppm/℃ 0402 Chip Resistor - Surface Mount ROHS | basic | 5558066 | 2026-10-02
2.49k 1% | R_0402_1005Metric | 1 | C2933083 | FRC0402F2491TS | FOJAN | -55℃~+155℃ 2.49kΩ 50V 62.5mW Thick Film Resistor ±1% ±100ppm/℃ 0402 Chip Resistor - Surface Mount ROHS | extended | 1747393 | 2026-11-13
510 | R_0402_1005Metric | 2 | C25123 | 0402WGF5100TCE | UNI-ROYAL(Uniroyal Elec) | -55℃~+155℃ 50V 510Ω 62.5mW Thick Film Resistor ±1% ±100ppm/℃ 0402 Chip Resistor - Surface Mount ROHS | basic | 2558428 | 2026-11-13
1.5k | R_0402_1005Metric | 1 | C25867 | 0402WGF1501TCE | UNI-ROYAL(Uniroyal Elec) | -55℃~+155℃ 1.5kΩ 50V 62.5mW Thick Film Resistor ±1% ±100ppm/℃ 0402 Chip Resistor - Surface Mount ROHS | basic | 1287261 | 2026-11-13
5.6k | R_0402_1005Metric | 1 | C25908 | 0402WGF5601TCE | UNI-ROYAL(Uniroyal Elec) | -55℃~+155℃ 5.6kΩ 50V 62.5mW Thick Film Resistor ±1% ±100ppm/℃ 0402 Chip Resistor - Surface Mount ROHS | extended | 265868 | 2026-11-14
4x22 | R_Array_Convex_4x0402 | 7 | C25499 | 4D02WGJ0220TCE | UNI-ROYAL(Uniroyal Elec) | 22Ω 4 62.5mW 8 ±200ppm/℃ ±5% 0402x4 Resistor Networks, Arrays ROHS | extended | 777988 | 2026-10-02
PROG | SW_SPST_TL3342 | 1 | C2886897 | TL3342F450QG | E-Switch | -20℃~+70℃ 1.54mm 100,000 cycles 12V 4.5N 5.2mm 50mA Gull Wing Round Button SPST-NO Surface Mount,Vertical SMD-4P,5.2x5.2mm Tactile Switches ROHS | extended | 751 | 2026-11-10
ADT2-1T+ | Mini-Circuits_CD542_H2.84mm | 3 | C5223988 | ADT2-1T+ | Mini-Circuits | -20℃~+85℃ 0.2dB 18dB 1:2 1° 400kHz~450MHz SMD-6P Balun ROHS | extended | 7 | 2026-10-02
ADCLK948BCPZ | LFCSP-32-1EP_5x5mm_P0.5mm_EP2.7x2.7mm | 1 | C578960 | ADCLK948BCPZ | Analog Devices | -40℃~+85℃ 2 2.97V~3.63V 4.8GHz 8 LFCSP-32(5x5) Clock Buffers, Drivers, Distributors ROHS | extended | 0 | 2026-10-02
AD9484BCPZ-500 | LFCSP-56-1EP_8x8mm_P0.5mm_EP5.1x5.1mm | 1 | C653480 | AD9484BCPZ-500 | Analog Devices | -40℃~+85℃ 0.1LSB 1 1.5V 1.8V 47dB 500MHz 500MHz 8 Built-in LVDS Support Yes LFCSP-56(8x8) Analog to Digital Converters (ADC) ROHS | extended | 0 | 2026-10-02
AD8352ACPZ | LFCSP-16-1EP_3x3mm_P0.5mm_EP1.6x1.6mm | 4 | C578707 | AD8352ACPZ-R7 | Analog Devices | -40℃~+85℃ 15.7dBm 250dB 2GHz 37mA 3V~5.5V 41dBm Low-power mode、Linearization design、Variable gain control LFCSP-16(3x3) Differential Amplifiers ROHS | extended | 9 | 2026-10-02
AD9253BCPZ-125 | QFN-48-1EP_7x7mm_P0.5mm_EP5.6x5.6mm | 1 | C514282 | AD9253BCPZ-125 | Analog Devices | -40℃~+85℃ 1.7V~1.9V 125MHz 125MHz 14 2LSB 4 74.2dB Built-in Multi-chip synchronization、Soft reset、Programmable output clock and data alignment Serial port Yes LFCSP-48(7x7) Analog to Digital Converters (ADC) ROHS | extended | 2 | 2026-10-02
AD9708AR | SOIC-28W_7.5x17.9mm_P1.27mm | 1 | C653734 | AD9708ARZ | Analog Devices | -40℃~+85℃ 0.25LSB 1 2.7V~5.5V 35ns 8 Current-Non-buffered Parallel SOIC-28-300mil Digital to Analog Converters (DAC) ROHS | extended | 0 | 2026-10-02
AD9767ASTZ | LQFP-48_7x7mm_P0.5mm | 1 | C653820 | AD9767ASTZRL | Analog Devices | -40℃~+85℃ 1.5LSB 125MHz 14 2 3.3V~5V 35ns 8mA Parallel LQFP-48(7x7) Digital to Analog Converters (DAC) ROHS | extended | 147 | 2026-10-02
M3SWA2-34DR+ | MiniCircuits_DQ3005 | 4 | C33062043 | M3SWA2-34DR+ | Mini-Circuits | -3.6V~-3.3V、3.3V~3.6V -55℃~+105℃ 0GHz~30GHz 2.2dB 27.8dBm 44dB Hot-switch capability SPDT QFN-16(3x3) RF Switches ROHS | extended | 0 | 2026-10-02
LMR33630ADDA | Texas_HSOP-8-1EP_3.9x4.9mm_P1.27mm | 1 | C841384 | LMR33630ADDAR | Texas Instruments | -40℃~+125℃@(TJ) 1 1V~24V 24uA 3.8V~36V 3A 400kHz Adjustable Buck Buck Built-in Yes ESOP-8 DC-DC Converters ROHS | extended | 44019 | 2026-10-02
TPS562201 | SOT-23-6 | 3 | C90061 | TPS562201DDCR | Texas Instruments | -40℃~+125℃@(TJ) 1 2A 380uA 4.5V~17V 580kHz 768mV~7V Adjustable Buck Built-in Overcurrent Protection、Light load efficient mode、Cycle-by-cycle current limiting、Hiccup current limiting Step-down type Yes TSOT-23-6 DC-DC Converters ROHS | extended | 309344 | 2026-10-02
TPS7A8300RGR | QFN-20-1EP_3.5x3.5mm_P0.5mm_EP2x2mm | 3 | C544500 | TPS7A8300RGRR | Texas Instruments | -40℃~+125℃ 200mV@(2A) 2A 40dB@(1MHz) 6.5V 6uVrms 800mV~5V Adjustable PG Pin、Over Current Protection、Over Temperature Protection、Soft Start、Thermal Shutdown VQFN-20-EP(3.5x3.5) Voltage Regulators - Linear, Low Drop Out (LDO) Regulators ROHS | extended | 4997 | 2026-10-02
LM2663M | SOIC-8_3.9x4.9mm_P1.27mm | 1 | C544380 | LM2663M/NOPB | Texas Instruments | -40℃~+85℃ 2.5V~5.5V 200mA 3.5Ω 75kHz 800uA 96% Inverted、boost converter Not supported SOIC-8 Charge Pumps ROHS | extended | 3271 | 2026-10-02
LM74502-Q1 | SOT-23-8 | 1 | C5219206 | LM74502QDDFRQ1 | Texas Instruments | -40℃~+125℃ 1 3.2V~65V Active High Load Switch Over Voltage Protection SOT-23-8-THIN Power Distribution Switches ROHS | extended | 630 | 2026-11-13
XC7A50T-2FTG256I | Xilinx_FTG256 | 1 | C2976033 | XC7A50T-2FTG256I | AMD/XILINX | -40℃~+100℃ 52160 FTBGA-256(17x17) Programmable Logic Device (CPLDs/FPGAs) ROHS | extended | 73 | 2026-10-02
MT25QL128ABA1ESE | SOIC-8_5.3x5.3mm_P1.27mm | 1 | C41359590 | MT25QL128ABA1ESE-0SIT | Micron Tech | -40℃~+85℃ 100,000 cycles 128Mbit 133MHz 2.7V~3.6V 20 Years Power-on reset、Hardware write protection、Software write protection、Write enable latch、Absolute write protection SPI SOP-8-208mil NOR FLASH ROHS | extended | 504 | 2026-10-02
74LVC1G07 | SOT-23-5 | 1 | C7829 | SN74LVC1G07DBVR | Texas Instruments | -40℃~+125℃ 1 1 1.65V~5.5V 10uA 32mA 4.2ns@3.3V,50pF 74LVC Open-drain Power-off isolation、Level shifting Unidirectional SOT-23-5 Buffers, Drivers, Receivers, Transceivers ROHS | extended | 72111 | 2026-10-02
TMP1075DR | SOIC-8_3.9x4.9mm_P1.27mm | 1 | C2878381 | TMP1075DR | Texas Instruments | -55℃~+125℃ 1.7V~5.5V 12bit 3.5uA 7ms Factory temperature calibration、Temperature threshold monitoring I2C、SMBus ±1℃ SOIC-8 Temperature Sensors ROHS | extended | 1530 | 2026-10-02
M24C02-FMN6TP | SOIC-8_3.9x4.9mm_P1.27mm | 1 | C114502 | M24C02-FMN6TP | STMicroelectronics | -40℃~+85℃ 1.7V~5.5V 200 Years 2Kbit 4,000,000 Cycles 400kHz 5ms Hardware write protection function、Noise suppression function、Built-in power-on reset (POR) I2C SOIC-8 EEPROM ROHS | extended | 19490 | 2026-10-02
TPD4E05U06DQAR | USON-10_2.5x1.0mm_P0.5mm | 3 | C138714 | TPD4E05U06DQAR | Texas Instruments | -40℃~+125℃ 0.5pF 10nA 14V 2.5A@8/20us 40W@8/20us 5.5V 6.5V ESD Four channels IEC 61000-4-2、IEC 61000-4-5、IEC 61000-4-4 Unidirectional USON-10(1x2.5) ESD and Surge Protection (TVS/ESD) ROHS | extended | 10136 | 2026-11-11 | Pmod and JTAG ESD (U1108-U1110)
RTL8211FSI-CG | QFN-48-1EP_6x6mm_P0.4mm_EP4.4x4.4mm | 1 | C2904132 | RTL8211FSI-CG | Realtek Semicon | QFN-48 Ethernet Transceivers ROHS | extended | 3236 | 2026-11-13
Si549 LVPECL 3V3 pinout C | Oscillator_SMD_SI570_SI571_Standard | 1 |  |  |  |  |  |  | 2026-10-02 | Si549 ordering codes are built per configuration at Skyworks; not a catalogue part
25MHz | Crystal_SMD_3225-4Pin_3.2x2.5mm | 1 | C9006 | X322525MOB4SI | YXC Crystal Oscillators | -40℃~+85℃ 12pF 25MHz 50Ω Crystal Oscillator ±10ppm ±20ppm SMD3225-4P Crystals ROHS | basic | 343157 | 2026-11-13
