PabloSoage/kv260-ias2rf/_work/layout/xc7a50t_ftg256_pkg_delays.csv

pin | pin_func | bank | diff_pair | min_delay_fs | max_delay_fs
J7 | VN_0 | 0 | H8 | 81126 | 81941
H8 | VP_0 | 0 | J7 | 70383 | 71090
K12 | IO_0_14 | 14 |  | 46285 | 46750
J13 | IO_L1P_T0_D00_MOSI_14 | 14 | J14 | 63696 | 64336
J14 | IO_L1N_T0_D01_DIN_14 | 14 | J13 | 71068 | 71782
K15 | IO_L2P_T0_D02_14 | 14 | K16 | 84236 | 85083
K16 | IO_L2N_T0_D03_14 | 14 | K15 | 76624 | 77394
L15 | IO_L3P_T0_DQS_PUDC_B_14 | 14 | M15 | 89401 | 90299
M15 | IO_L3N_T0_DQS_EMCCLK_14 | 14 | L15 | 89688 | 90590
L14 | IO_L4P_T0_D04_14 | 14 | M14 | 78214 | 79000
M14 | IO_L4N_T0_D05_14 | 14 | L14 | 78014 | 78798
K13 | IO_L5P_T0_D06_14 | 14 | L13 | 53747 | 54287
L13 | IO_L5N_T0_D07_14 | 14 | K13 | 56070 | 56634
L12 | IO_L6P_T0_FCS_B_14 | 14 | M12 | 65461 | 66119
M12 | IO_L6N_T0_D08_VREF_14 | 14 | L12 | 65910 | 66572
M16 | IO_L7P_T1_D09_14 | 14 | N16 | 101941 | 102965
N16 | IO_L7N_T1_D10_14 | 14 | M16 | 92614 | 93545
P15 | IO_L8P_T1_D11_14 | 14 | P16 | 90564 | 91474
P16 | IO_L8N_T1_D12_14 | 14 | P15 | 86501 | 87370
R15 | IO_L9P_T1_DQS_14 | 14 | R16 | 82783 | 83615
R16 | IO_L9N_T1_DQS_D13_14 | 14 | R15 | 84941 | 85794
T14 | IO_L10P_T1_D14_14 | 14 | T15 | 95054 | 96010
T15 | IO_L10N_T1_D15_14 | 14 | T14 | 97373 | 98351
N13 | IO_L11P_T1_SRCC_14 | 14 | P13 | 111359 | 112478
P13 | IO_L11N_T1_SRCC_14 | 14 | N13 | 115781 | 116945
N14 | IO_L12P_T1_MRCC_14 | 14 | P14 | 111487 | 112607
P14 | IO_L12N_T1_MRCC_14 | 14 | N14 | 111502 | 112622
N11 | IO_L13P_T2_MRCC_14 | 14 | N12 | 113825 | 114969
N12 | IO_L13N_T2_MRCC_14 | 14 | N11 | 112398 | 113528
P10 | IO_L14P_T2_SRCC_14 | 14 | P11 | 129189 | 130487
P11 | IO_L14N_T2_SRCC_14 | 14 | P10 | 123906 | 125151
R12 | IO_L15P_T2_DQS_RDWR_B_14 | 14 | T12 | 111094 | 112210
T12 | IO_L15N_T2_DQS_DOUT_CSO_B_14 | 14 | R12 | 109534 | 110635
R13 | IO_L16P_T2_CSI_B_14 | 14 | T13 | 101375 | 102393
T13 | IO_L16N_T2_A15_D31_14 | 14 | R13 | 95348 | 96306
R10 | IO_L17P_T2_A14_D30_14 | 14 | R11 | 113455 | 114595
R11 | IO_L17N_T2_A13_D29_14 | 14 | R10 | 108385 | 109475
N9 | IO_L18P_T2_A12_D28_14 | 14 | P9 | 106122 | 107189
P9 | IO_L18N_T2_A11_D27_14 | 14 | N9 | 105847 | 106910
M6 | IO_L19P_T3_A10_D26_14 | 14 | N6 | 130784 | 132099
N6 | IO_L19N_T3_A09_D25_VREF_14 | 14 | M6 | 129127 | 130425
P8 | IO_L20P_T3_A08_D24_14 | 14 | R8 | 121717 | 122940
R8 | IO_L20N_T3_A07_D23_14 | 14 | P8 | 116230 | 117399
T7 | IO_L21P_T3_DQS_14 | 14 | T8 | 111091 | 112208
T8 | IO_L21N_T3_DQS_A06_D22_14 | 14 | T7 | 108755 | 109848
T9 | IO_L22P_T3_A05_D21_14 | 14 | T10 | 108168 | 109255
T10 | IO_L22N_T3_A04_D20_14 | 14 | T9 | 106715 | 107787
R5 | IO_L23P_T3_A03_D19_14 | 14 | T5 | 104334 | 105383
T5 | IO_L23N_T3_A02_D18_14 | 14 | R5 | 107930 | 109015
R6 | IO_L24P_T3_A01_D17_14 | 14 | R7 | 118895 | 120090
R7 | IO_L24N_T3_A00_D16_14 | 14 | R6 | 118734 | 119927
P6 | IO_25_14 | 14 |  | 104903 | 105958
D10 | IO_0_15 | 15 |  | 63649 | 64289
C8 | IO_L1P_T0_AD0P_15 | 15 | C9 | 99876 | 100880
C9 | IO_L1N_T0_AD0N_15 | 15 | C8 | 98492 | 99482
A8 | IO_L2P_T0_AD8P_15 | 15 | A9 | 131782 | 133106
A9 | IO_L2N_T0_AD8N_15 | 15 | A8 | 130539 | 131851
B9 | IO_L3P_T0_DQS_AD1P_15 | 15 | A10 | 121350 | 122570
A10 | IO_L3N_T0_DQS_AD1N_15 | 15 | B9 | 121430 | 122650
B10 | IO_L4P_T0_15 | 15 | B11 | 129751 | 131055
B11 | IO_L4N_T0_15 | 15 | B10 | 128752 | 130046
B12 | IO_L5P_T0_AD9P_15 | 15 | A12 | 108717 | 109810
A12 | IO_L5N_T0_AD9N_15 | 15 | B12 | 107477 | 108557
D8 | IO_L6P_T0_15 | 15 | D9 | 97247 | 98224
D9 | IO_L6N_T0_VREF_15 | 15 | D8 | 95699 | 96661
A13 | IO_L7P_T1_AD2P_15 | 15 | A14 | 106776 | 107849
A14 | IO_L7N_T1_AD2N_15 | 15 | A13 | 107938 | 109023
C14 | IO_L8P_T1_AD10P_15 | 15 | B14 | 95407 | 96366
B14 | IO_L8N_T1_AD10N_15 | 15 | C14 | 100913 | 101927
B15 | IO_L9P_T1_DQS_AD3P_15 | 15 | A15 | 104438 | 105488
A15 | IO_L9N_T1_DQS_AD3N_15 | 15 | B15 | 104224 | 105271
C16 | IO_L10P_T1_AD11P_15 | 15 | B16 | 100144 | 101151
B16 | IO_L10N_T1_AD11N_15 | 15 | C16 | 105922 | 106987
C11 | IO_L11P_T1_SRCC_15 | 15 | C12 | 122291 | 123520
C12 | IO_L11N_T1_SRCC_15 | 15 | C11 | 124802 | 126057
D13 | IO_L12P_T1_MRCC_15 | 15 | C13 | 89507 | 90407
C13 | IO_L12N_T1_MRCC_15 | 15 | D13 | 89690 | 90591
E12 | IO_L13P_T2_MRCC_15 | 15 | E13 | 89171 | 90068
E13 | IO_L13N_T2_MRCC_15 | 15 | E12 | 92493 | 93422
E11 | IO_L14P_T2_SRCC_15 | 15 | D11 | 106880 | 107954
D11 | IO_L14N_T2_SRCC_15 | 15 | E11 | 104113 | 105160
D14 | IO_L15P_T2_DQS_15 | 15 | D15 | 90859 | 91772
D15 | IO_L15N_T2_DQS_ADV_B_15 | 15 | D14 | 93349 | 94287
F12 | IO_L16P_T2_A28_15 | 15 | F13 | 95161 | 96117
F13 | IO_L16N_T2_A27_15 | 15 | F12 | 84537 | 85387
E16 | IO_L17P_T2_A26_15 | 15 | D16 | 97515 | 98495
D16 | IO_L17N_T2_A25_15 | 15 | E16 | 96965 | 97940
F15 | IO_L18P_T2_A24_15 | 15 | E15 | 96978 | 97952
E15 | IO_L18N_T2_A23_15 | 15 | F15 | 97569 | 98549
H11 | IO_L19P_T3_A22_15 | 15 | G12 | 86679 | 87550
G12 | IO_L19N_T3_A21_VREF_15 | 15 | H11 | 83620 | 84461
H12 | IO_L20P_T3_A20_15 | 15 | H13 | 71483 | 72201
H13 | IO_L20N_T3_A19_15 | 15 | H12 | 63127 | 63762
G14 | IO_L21P_T3_DQS_15 | 15 | F14 | 68090 | 68774
F14 | IO_L21N_T3_DQS_A18_15 | 15 | G14 | 68746 | 69437
H16 | IO_L22P_T3_A17_15 | 15 | G16 | 80286 | 81093
G16 | IO_L22N_T3_A16_15 | 15 | H16 | 81598 | 82418
J15 | IO_L23P_T3_FOE_B_15 | 15 | J16 | 70483 | 71191
J16 | IO_L23N_T3_FWE_B_15 | 15 | J15 | 78181 | 78967
H14 | IO_L24P_T3_RS1_15 | 15 | G15 | 80030 | 80834
G15 | IO_L24N_T3_RS0_15 | 15 | H14 | 85826 | 86689
G11 | IO_25_15 | 15 |  | 68224 | 68910
L5 | IO_0_34 | 34 |  | 35268 | 35622
L4 | IO_L1P_T0_34 | 34 | M4 | 50711 | 51221
M4 | IO_L1N_T0_34 | 34 | L4 | 54819 | 55370
M2 | IO_L2P_T0_34 | 34 | M1 | 78939 | 79732
M1 | IO_L2N_T0_34 | 34 | M2 | 72850 | 73582
N3 | IO_L3P_T0_DQS_34 | 34 | N2 | 63626 | 64265
N2 | IO_L3N_T0_DQS_34 | 34 | N3 | 62629 | 63258
N1 | IO_L4P_T0_34 | 34 | P1 | 76884 | 77657
P1 | IO_L4N_T0_34 | 34 | N1 | 74512 | 75261
P4 | IO_L5P_T0_34 | 34 | P3 | 64703 | 65354
P3 | IO_L5N_T0_34 | 34 | P4 | 69530 | 70229
M5 | IO_L6P_T0_34 | 34 | N4 | 47508 | 47985
N4 | IO_L6N_T0_VREF_34 | 34 | M5 | 46277 | 46742
R2 | IO_L7P_T1_34 | 34 | R1 | 82922 | 83756
R1 | IO_L7N_T1_34 | 34 | R2 | 85957 | 86820
R3 | IO_L8P_T1_34 | 34 | T2 | 85490 | 86349
T2 | IO_L8N_T1_34 | 34 | R3 | 86915 | 87788
T4 | IO_L9P_T1_DQS_34 | 34 | T3 | 84047 | 84892
T3 | IO_L9N_T1_DQS_34 | 34 | T4 | 84595 | 85445
P5 | IO_L10P_T1_34 | 34 |  | 57533 | 58111
E6 | IO_0_35 | 35 |  | 43687 | 44126
B7 | IO_L1P_T0_AD4P_35 | 35 | A7 | 97043 | 98018
A7 | IO_L1N_T0_AD4N_35 | 35 | B7 | 95890 | 96853
B6 | IO_L2P_T0_AD12P_35 | 35 | B5 | 86096 | 86962
B5 | IO_L2N_T0_AD12N_35 | 35 | B6 | 86188 | 87054
A5 | IO_L3P_T0_DQS_AD5P_35 | 35 | A4 | 91187 | 92103
A4 | IO_L3N_T0_DQS_AD5N_35 | 35 | A5 | 89870 | 90773
B4 | IO_L4P_T0_35 | 35 | A3 | 90710 | 91622
A3 | IO_L4N_T0_35 | 35 | B4 | 88585 | 89475
C7 | IO_L5P_T0_AD13P_35 | 35 | C6 | 84151 | 84997
C6 | IO_L5N_T0_AD13N_35 | 35 | C7 | 87345 | 88222
D6 | IO_L6P_T0_35 | 35 | D5 | 69168 | 69864
D5 | IO_L6N_T0_VREF_35 | 35 | D6 | 66411 | 67079
C3 | IO_L7P_T1_AD6P_35 | 35 | C2 | 99047 | 100042
C2 | IO_L7N_T1_AD6N_35 | 35 | C3 | 95835 | 96799
B2 | IO_L8P_T1_AD14P_35 | 35 | A2 | 90162 | 91068
A2 | IO_L8N_T1_AD14N_35 | 35 | B2 | 98885 | 99879
C1 | IO_L9P_T1_DQS_AD7P_35 | 35 | B1 | 89258 | 90155
B1 | IO_L9N_T1_DQS_AD7N_35 | 35 | C1 | 90260 | 91167
E2 | IO_L10P_T1_AD15P_35 | 35 | D1 | 84557 | 85407
D1 | IO_L10N_T1_AD15N_35 | 35 | E2 | 93654 | 94595
E3 | IO_L11P_T1_SRCC_35 | 35 | D3 | 87421 | 88299
D3 | IO_L11N_T1_SRCC_35 | 35 | E3 | 91030 | 91945
D4 | IO_L12P_T1_MRCC_35 | 35 | C4 | 113999 | 115144
C4 | IO_L12N_T1_MRCC_35 | 35 | D4 | 119471 | 120672
F5 | IO_L13P_T2_MRCC_35 | 35 | E5 | 80798 | 81610
E5 | IO_L13N_T2_MRCC_35 | 35 | F5 | 81536 | 82356
F4 | IO_L14P_T2_SRCC_35 | 35 | F3 | 81499 | 82318
F3 | IO_L14N_T2_SRCC_35 | 35 | F4 | 82127 | 82952
F2 | IO_L15P_T2_DQS_35 | 35 | E1 | 87896 | 88780
E1 | IO_L15N_T2_DQS_35 | 35 | F2 | 89537 | 90437
G5 | IO_L16P_T2_35 | 35 | G4 | 63429 | 64066
G4 | IO_L16N_T2_35 | 35 | G5 | 57431 | 58008
G2 | IO_L17P_T2_35 | 35 | G1 | 65387 | 66044
G1 | IO_L17N_T2_35 | 35 | G2 | 66278 | 66944
H5 | IO_L18P_T2_35 | 35 | H4 | 81575 | 82395
H4 | IO_L18N_T2_35 | 35 | H5 | 71569 | 72288
J5 | IO_L19P_T3_35 | 35 | J4 | 70404 | 71111
J4 | IO_L19N_T3_VREF_35 | 35 | J5 | 67393 | 68070
H2 | IO_L20P_T3_35 | 35 | H1 | 62018 | 62641
H1 | IO_L20N_T3_35 | 35 | H2 | 62898 | 63530
J3 | IO_L21P_T3_DQS_35 | 35 | H3 | 81780 | 82601
H3 | IO_L21N_T3_DQS_35 | 35 | J3 | 84274 | 85121
K1 | IO_L22P_T3_35 | 35 | J1 | 74227 | 74973
J1 | IO_L22N_T3_35 | 35 | K1 | 69152 | 69846
L3 | IO_L23P_T3_35 | 35 | L2 | 69591 | 70291
L2 | IO_L23N_T3_35 | 35 | L3 | 71894 | 72616
K3 | IO_L24P_T3_35 | 35 | K2 | 48203 | 48688
K2 | IO_L24N_T3_35 | 35 | K3 | 59199 | 59794
K5 | IO_25_35 | 35 |  | 41441 | 41857
H10 | DONE_0 | 0 |  | 63410 | 64048
K8 | DXP_0 | 0 | K7 | 73742 | 74483
G7 | GNDADC_0 | 0
G8 | VCCADC_0 | 0
J8 | VREFP_0 | 0 | H7 | 105745 | 106808
F8 | VCCBATT_0 | 0
L7 | TCK_0 | 0 |  | 115831 | 116995
K7 | DXN_0 | 0 | K8 | 131898 | 133224
H7 | VREFN_0 | 0 | J8 | 106174 | 107241
E8 | CCLK_0 | 0 |  | 79663 | 80464
M9 | M0_0 | 0 |  | 79844 | 80647
M10 | M1_0 | 0 |  | 67063 | 67737
K10 | INIT_B_0 | 0 |  | 89901 | 90805
N7 | TDI_0 | 0 |  | 66859 | 67531
N8 | TDO_0 | 0 |  | 68806 | 69498
M11 | M2_0 | 0 |  | 43525 | 43963
E7 | CFGBVS_0 | 0 |  | 128101 | 129389
L9 | PROGRAM_B_0 | 0 |  | 56656 | 57225
M7 | TMS_0 | 0 |  | 42444 | 42871
A1 | GND
A11 | GND
B8 | GND
C5 | GND
C15 | GND
D2 | GND
D12 | GND
E9 | GND
F6 | GND
F10 | GND
F16 | GND
G3 | GND
G9 | GND
G13 | GND
H6 | GND
J9 | GND
J11 | GND
K4 | GND
K6 | GND
K14 | GND
L1 | GND
L11 | GND
M8 | GND
N5 | GND
N15 | GND
P2 | GND
P12 | GND
R9 | GND
T6 | GND
T16 | GND
F7 | VCCINT
F9 | VCCINT
G6 | VCCINT
H9 | VCCINT
J6 | VCCINT
K9 | VCCINT
L8 | VCCINT
G10 | VCCAUX
J10 | VCCAUX
K11 | VCCAUX
L10 | VCCAUX
L6 | VCCO_0 | 0
L16 | VCCO_14 | 14
M13 | VCCO_14 | 14
N10 | VCCO_14 | 14
P7 | VCCO_14 | 14
R14 | VCCO_14 | 14
T11 | VCCO_14 | 14
A16 | VCCO_15 | 15
B13 | VCCO_15 | 15
C10 | VCCO_15 | 15
E14 | VCCO_15 | 15
H15 | VCCO_15 | 15
J12 | VCCO_15 | 15
M3 | VCCO_34 | 34
R4 | VCCO_34 | 34
T1 | VCCO_34 | 34
A6 | VCCO_35 | 35
B3 | VCCO_35 | 35
D7 | VCCO_35 | 35
E4 | VCCO_35 | 35
F1 | VCCO_35 | 35
J2 | VCCO_35 | 35
E10 | VCCBRAM
F11 | VCCBRAM
