PabloSoage/kv260-ias2rf/mech/case_v2_lid.stl

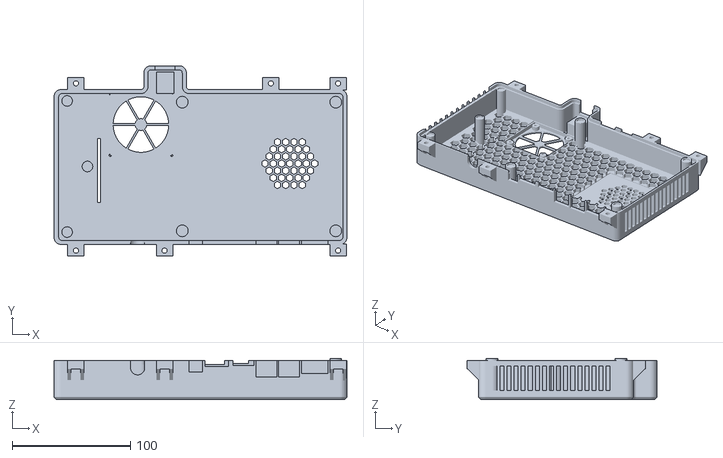
[picture p74: CAD file, 2026-11-14]
mech/case_v2_lid.stl
248.1 x 161.3 x 34.8
