PabloSoage/kv260-ias2rf/mech/models3d/Crystal_SMD_3225-4Pin_3.2x2.5mm.step

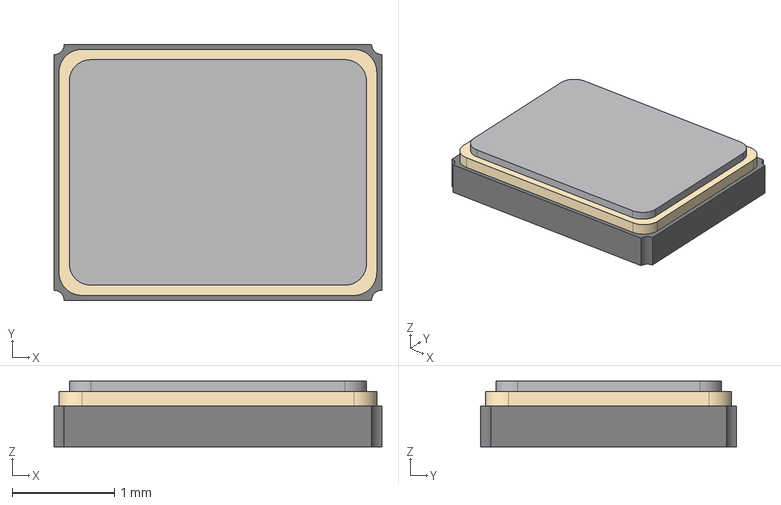
[picture p75: CAD file, 2026-11-14]
mech/models3d/Crystal_SMD_3225-4Pin_3.2x2.5mm.step
3.20 x 2.50 x 0.64 mm
