PabloSoage/kv260-ias2rf/mech/case_v2_filter_frame.stl

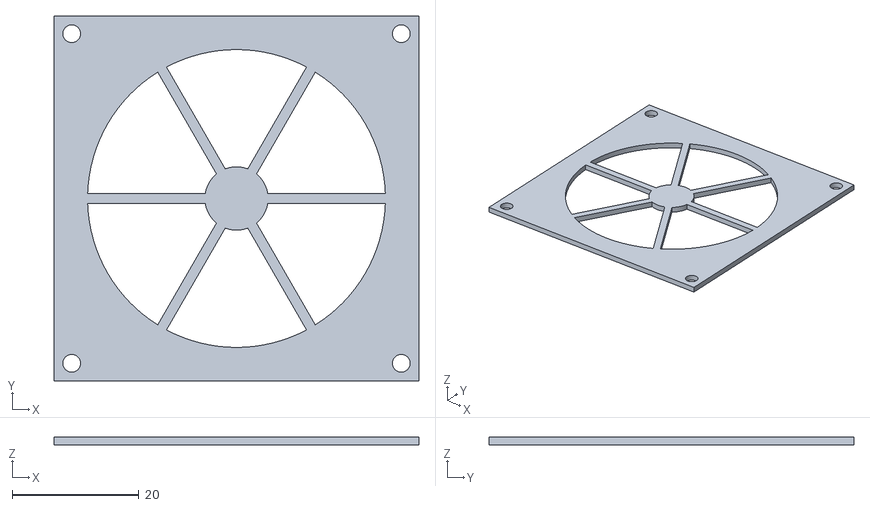
[picture p76: CAD file, 2026-11-14]
mech/case_v2_filter_frame.stl
57.6 x 57.6 x 1.20
