PabloSoage/kv260-ias2rf/mech/models3d/UQFN-48-1EP_6x6mm_P0.4mm_EP4.45x4.45mm.step

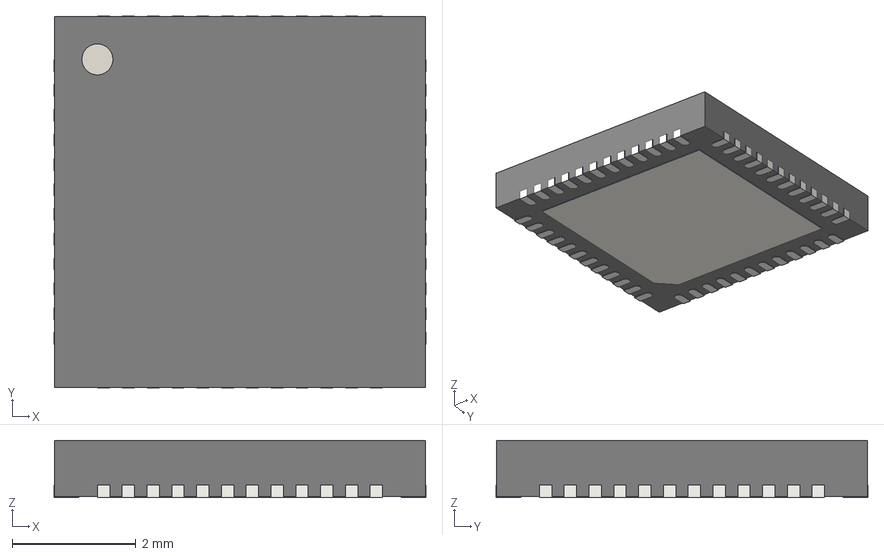
[picture p77: CAD file, 2026-11-14]
mech/models3d/UQFN-48-1EP_6x6mm_P0.4mm_EP4.45x4.45mm.step
6.00 x 6.00 x 0.92 mm
