PabloSoage/kv260-ias2rf/mech/case_bottom.stl

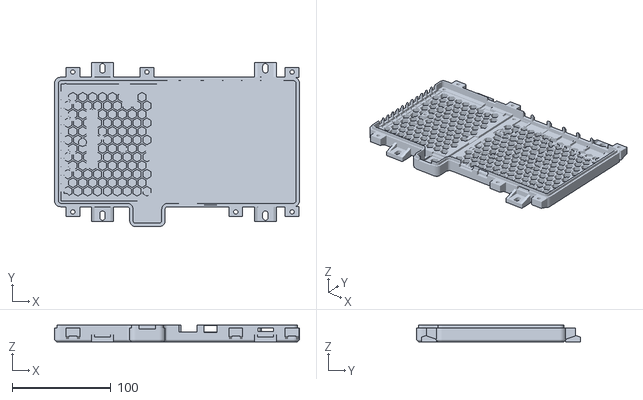
[picture p78: CAD file, 2026-11-14]
mech/case_bottom.stl
248.1 x 166.3 x 16.8
