PabloSoage/kv260-ias2rf/mech/models3d/Texas_VQFN-RGR-20-1EP_3.5x3.5mm_Pitch0.5mm.step

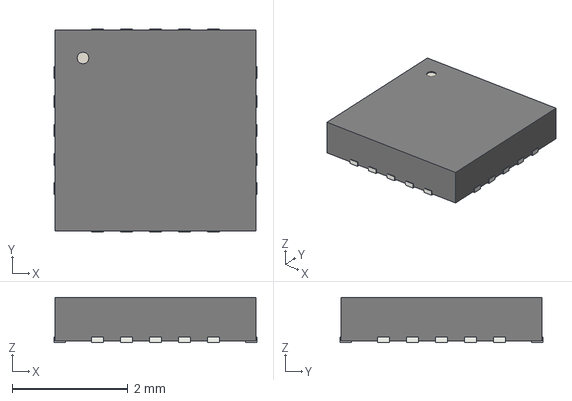
[picture p79: CAD file, 2026-11-14]
mech/models3d/Texas_VQFN-RGR-20-1EP_3.5x3.5mm_Pitch0.5mm.step
3.50 x 3.50 x 0.78 mm
