PabloSoage/kv260-ias2rf/mech/models3d/HSOP-8-1EP_3.9x4.9mm_P1.27mm_EP2.41x3.1mm.step

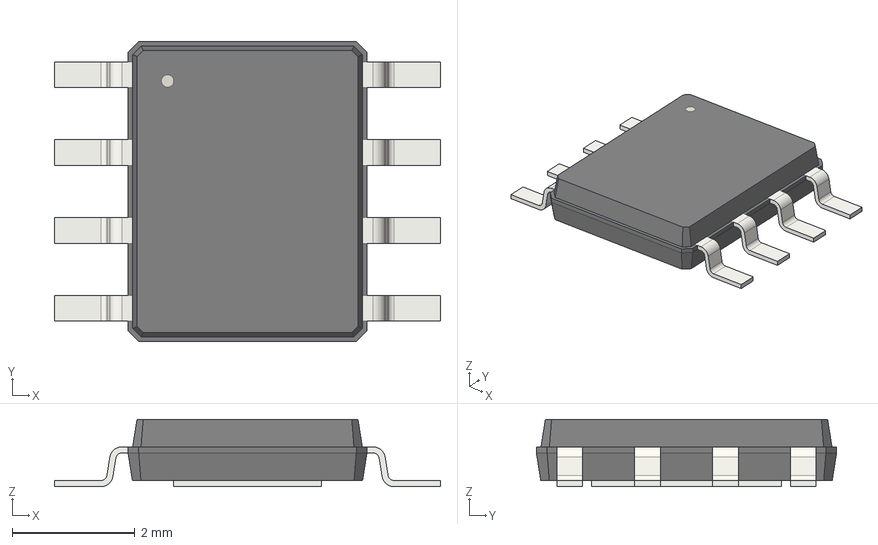
[picture p80: CAD file, 2026-11-14]
mech/models3d/HSOP-8-1EP_3.9x4.9mm_P1.27mm_EP2.41x3.1mm.step
6.30 x 4.90 x 1.10 mm
