PabloSoage/kv260-ias2rf/mech/models3d/WQFN-16-1EP_3x3mm_P0.5mm_EP1.6x1.6mm.step

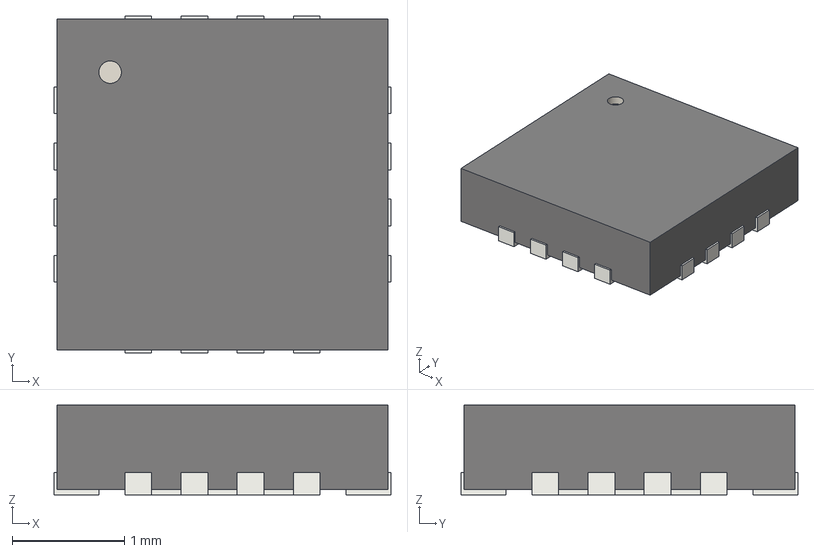
[picture p81: CAD file, 2026-11-14]
mech/models3d/WQFN-16-1EP_3x3mm_P0.5mm_EP1.6x1.6mm.step
3.00 x 3.00 x 0.8 mm
