PabloSoage/kv260-ias2rf/mech/case_bumper_rback.stl

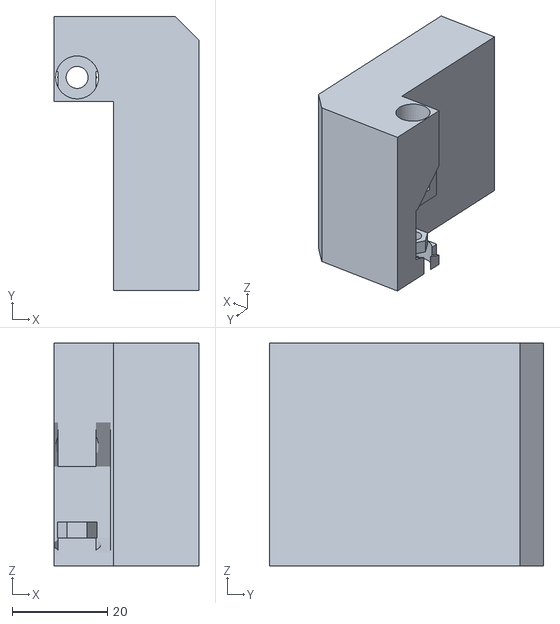
[picture p82: CAD file, 2026-11-14]
mech/case_bumper_rback.stl
30.3 x 57.5 x 46.8
