PabloSoage/kv260-ias2rf/mech/models3d/LFCSP-32-1EP_5x5mm_P0.5mm_EP3.6x3.6mm.step

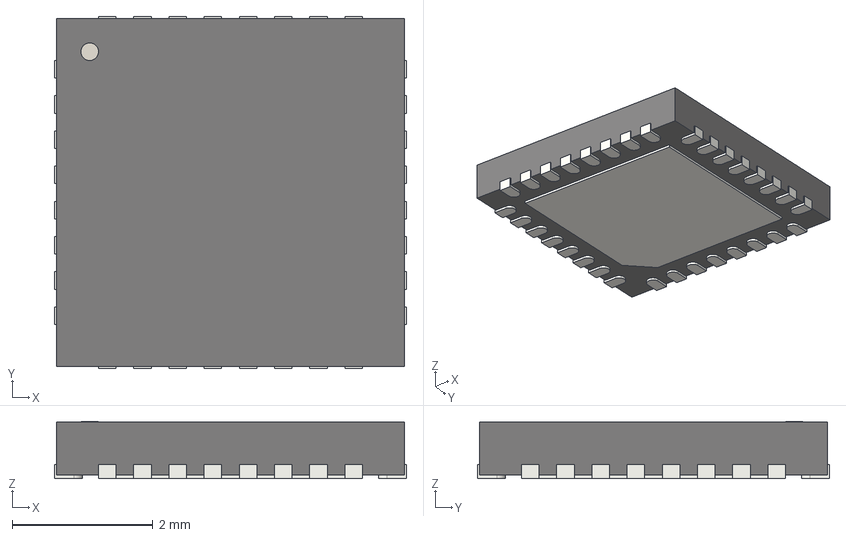
[picture p83: CAD file, 2026-11-14]
mech/models3d/LFCSP-32-1EP_5x5mm_P0.5mm_EP3.6x3.6mm.step
5.00 x 5.00 x 0.81 mm
2728c7a2-7f7d-11ed-bbe7-acde48001122_part
2728ca22-7f7d-11ed-bbe7-acde48001122_part
2728cb12-7f7d-11ed-bbe7-acde48001122_part
2728cba8-7f7d-11ed-bbe7-acde48001122_part
