PabloSoage/kv260-ias2rf/mech/case_bumper_lback.stl

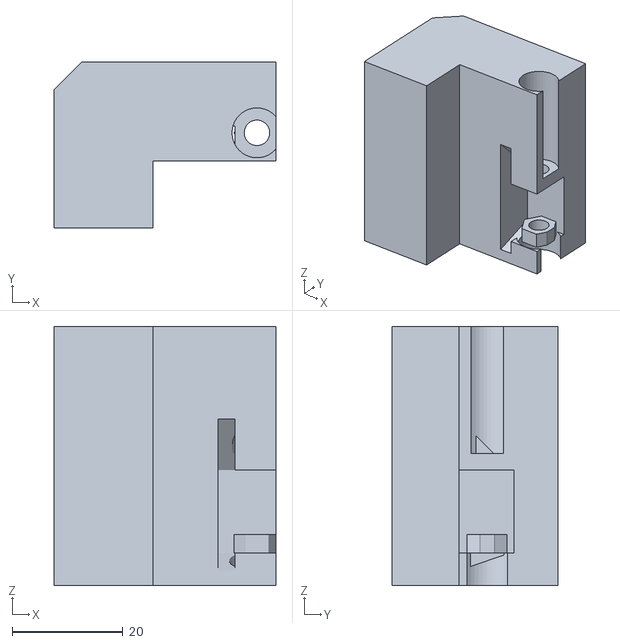
[picture p84: CAD file, 2026-11-13]
mech/case_bumper_lback.stl
40.0 x 30.0 x 46.8
