PabloSoage/kv260-ias2rf/mech/models3d/BGA-256_17.0x17.0mm_Layout16x16_P1.0mm_Ball0.5mm_Pad0.4mm_NSMD.step

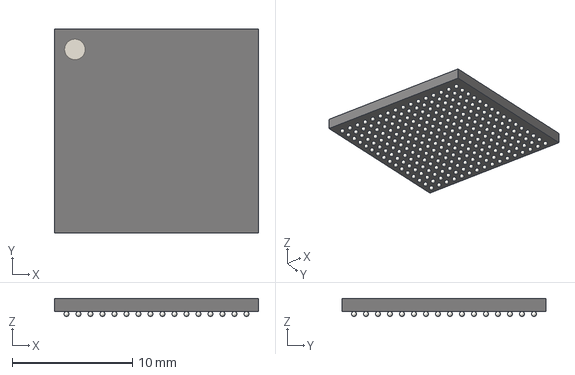
[picture p85: CAD file, 2026-11-14]
mech/models3d/BGA-256_17.0x17.0mm_Layout16x16_P1.0mm_Ball0.5mm_Pad0.4mm_NSMD.step
17.0 x 17.0 x 1.51 mm
