PabloSoage/kv260-ias2rf/mech/case_bumper_lfront.stl

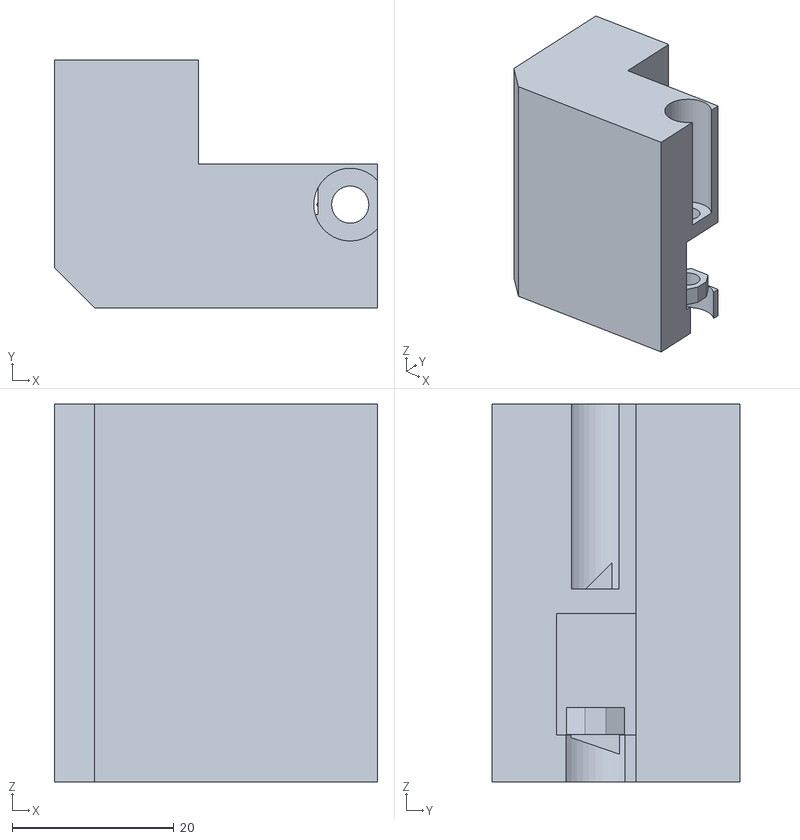
[picture p86: CAD file, 2026-11-13]
mech/case_bumper_lfront.stl
40.0 x 30.7 x 46.8
