PabloSoage/kv260-ias2rf/mech/models3d/QFN-56-1EP_8x8mm_P0.5mm_EP4.5x5.2mm.step

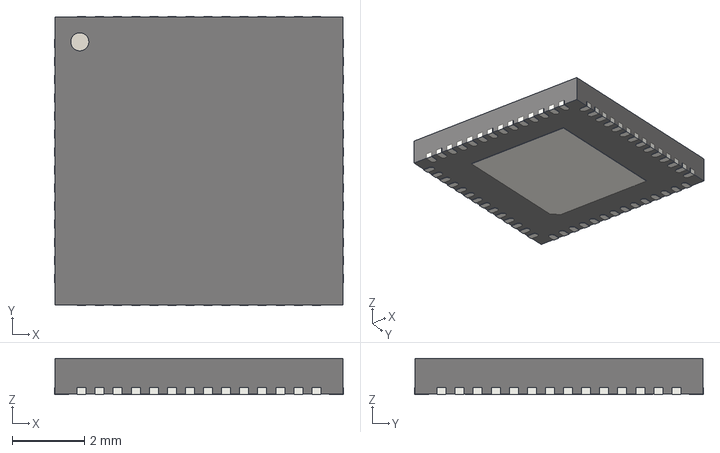
[picture p87: CAD file, 2026-11-14]
mech/models3d/QFN-56-1EP_8x8mm_P0.5mm_EP4.5x5.2mm.step
8.00 x 8.00 x 1.00 mm
