PabloSoage/kv260-ias2rf/mech/case_pin.stl

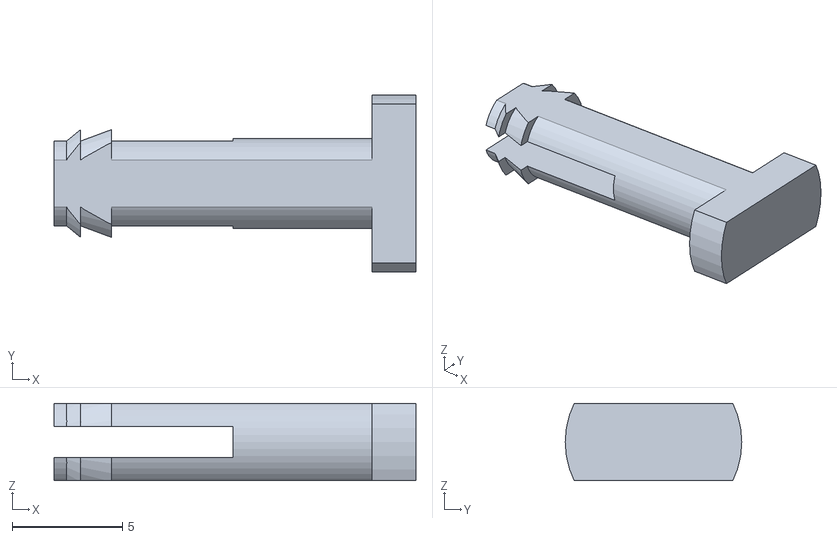
[picture p88: CAD file, 2026-11-13]
mech/case_pin.stl
16.4 x 8.00 x 3.50
