PabloSoage/kv260-ias2rf/mech/models3d/TQFN-48-1EP_7x7mm_P0.5mm_EP5.1x5.1mm.step

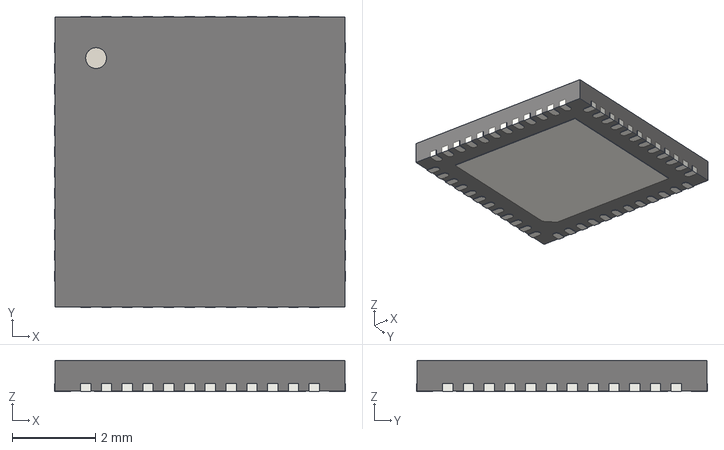
[picture p89: CAD file, 2026-11-14]
mech/models3d/TQFN-48-1EP_7x7mm_P0.5mm_EP5.1x5.1mm.step
7.00 x 7.00 x 0.75 mm
