PabloSoage/kv260-ias2rf/mech/case_bumper_rfront.stl

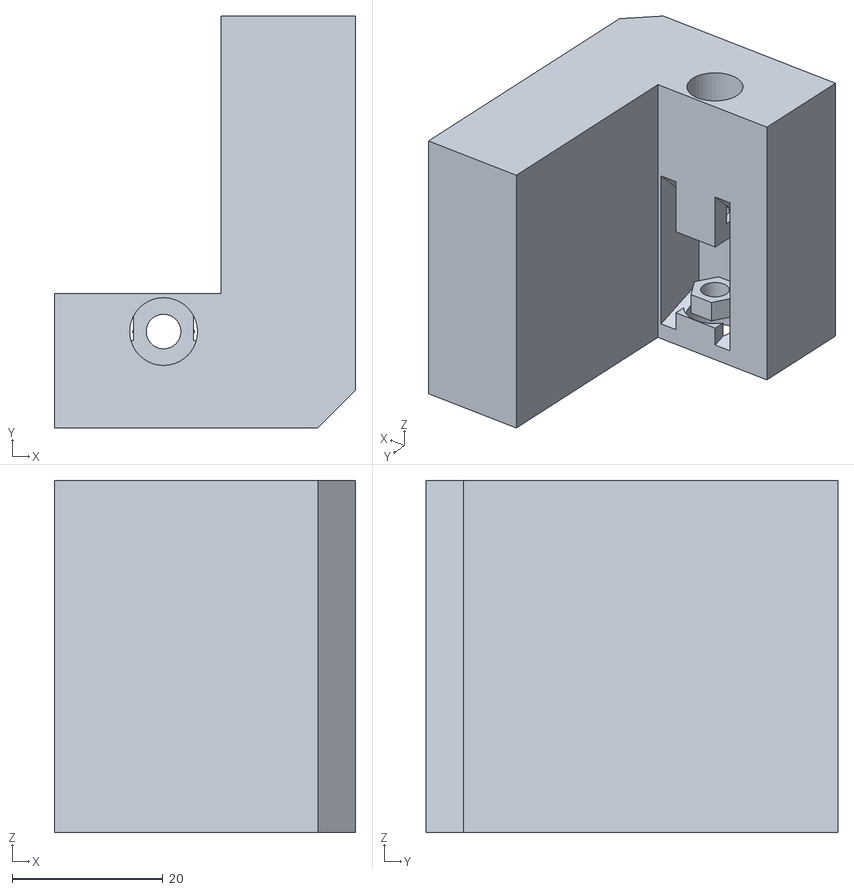
[picture p90: CAD file, 2026-11-13]
mech/case_bumper_rfront.stl
40.0 x 54.7 x 46.8
