PabloSoage/kv260-ias2rf/mech/case_pad_rj45.stl

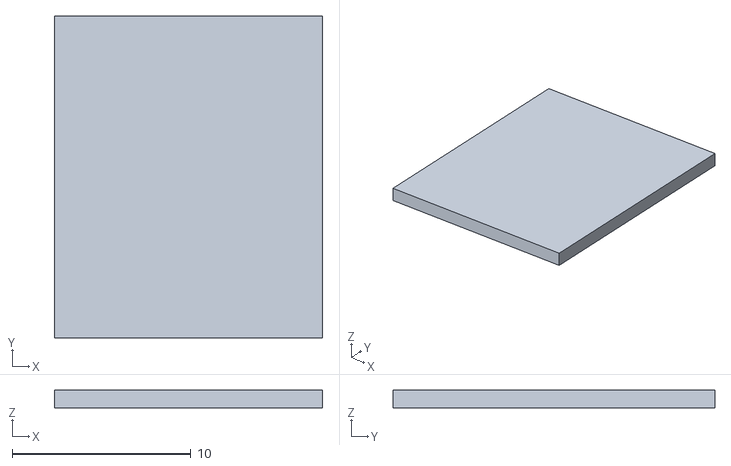
[picture p91: CAD file, 2026-11-13]
mech/case_pad_rj45.stl
15.0 x 18.0 x 1
