PabloSoage/kv260-ias2rf/mech/case_pad_ring.stl

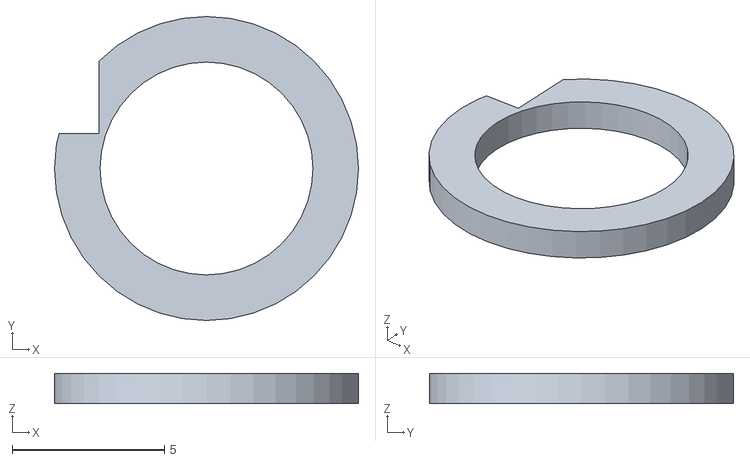
[picture p92: CAD file, 2026-11-13]
mech/case_pad_ring.stl
10.0 x 10.0 x 1.00
