PabloSoage/kv260-ias2rf/mech/mount_base.stl

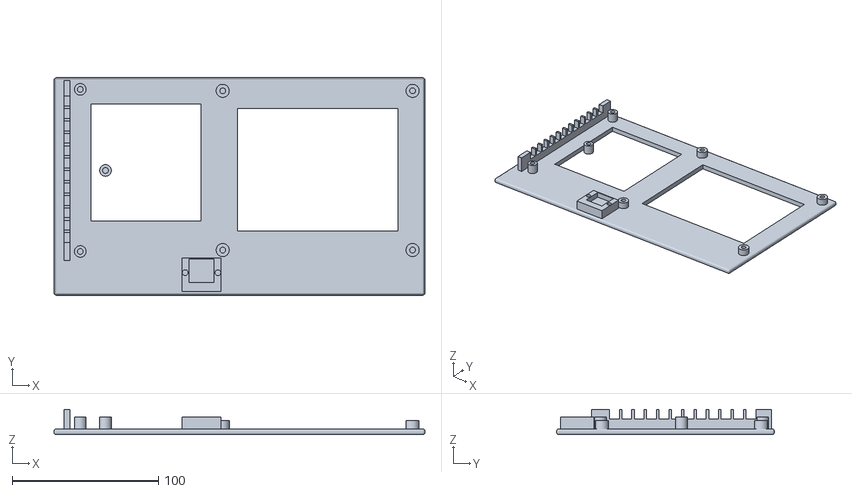
[picture p93: CAD file, 2026-11-13]
mech/mount_base.stl
254.0 x 149.0 x 17.3
