PabloSoage/kv260-ias2rf/mech/mount_rj45_strap.stl

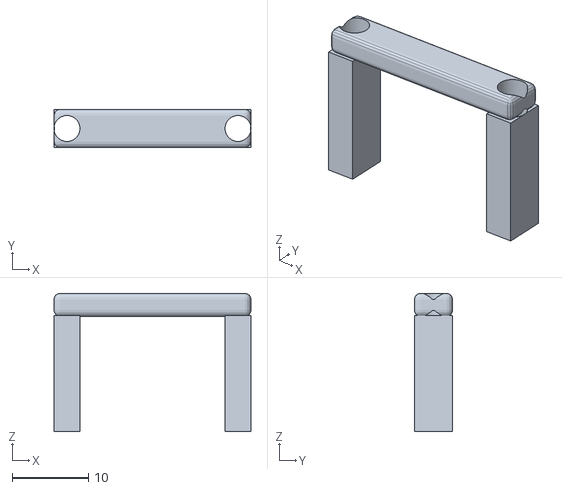
[picture p94: CAD file, 2026-11-13]
mech/mount_rj45_strap.stl
25.8 x 5.00 x 18.1
