PabloSoage/kv260-ias2rf/(list of files, cad)

Other CAD files:
mech/case_lid.stl
