PabloSoage/kv260-ias2rf/docs/CSI2-KRIA-KV260_Rev04_schematic.pdf

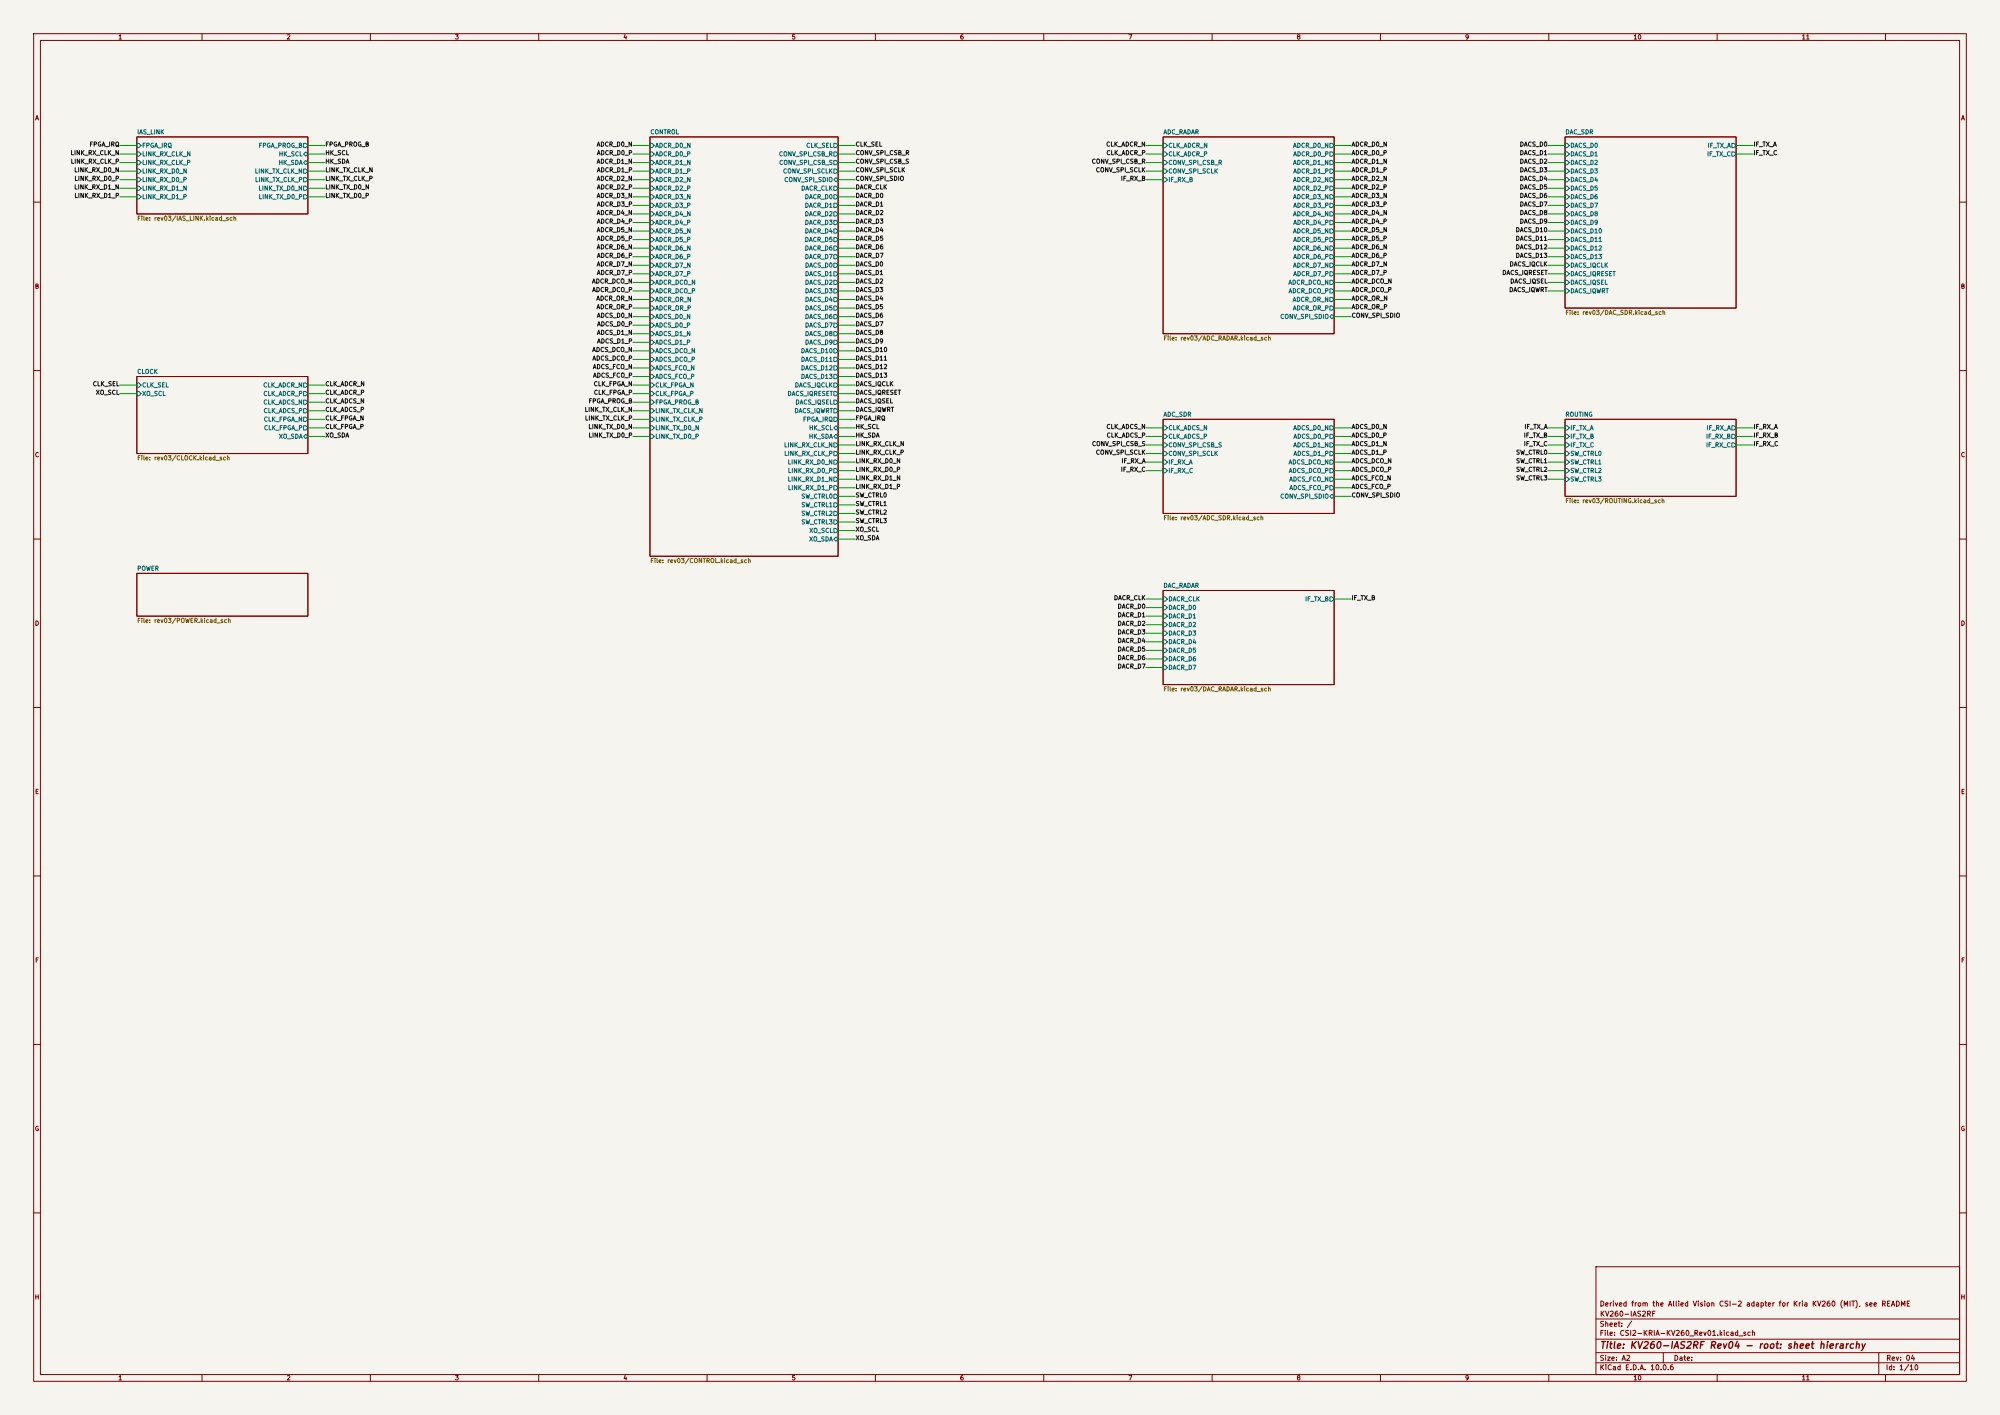
[picture p95: page 1]

Derived from the Allied Vision CSI-2 adapter for Kria KV260 (MIT), see README
KV260-IAS2RF
Sheet: /
File: CSI2-KRIA-KV260_Rev01.kicad_sch
Title: KV260-IAS2RF Rev04 - root: sheet hierarchy

Size: A2 | Rev: 04
KiCad E.D.A. 10.0.6 | Id: 1/10

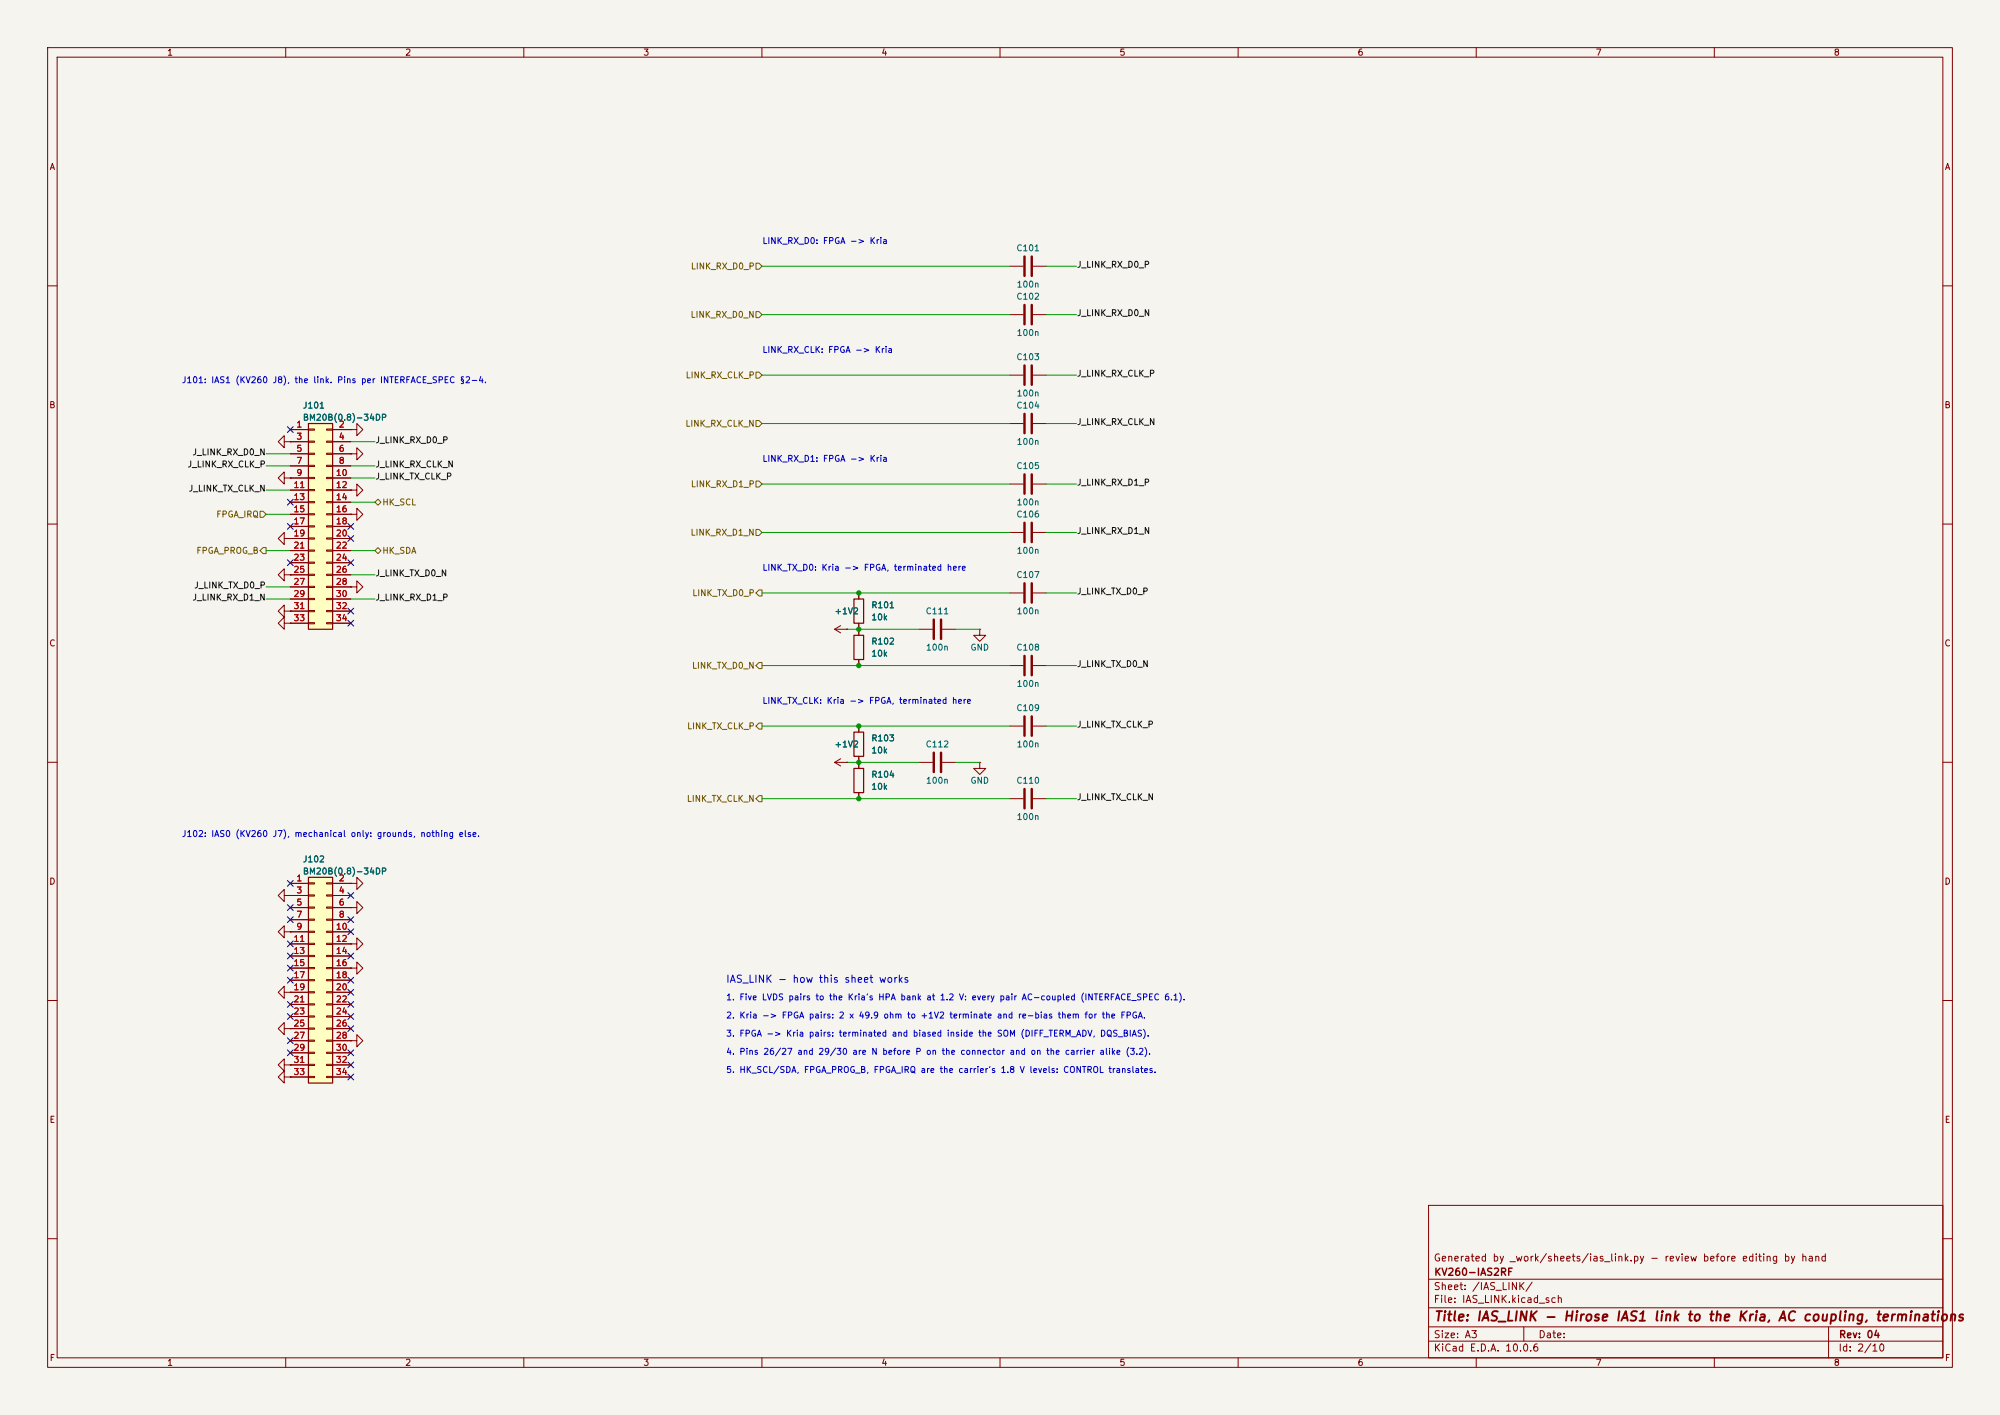
[picture p96: page 2]

LINK_TX_D0: Kria -> FPGA, terminated here

LINK_TX_CLK: Kria -> FPGA, terminated here 3. FPGA -> Kria pairs: terminated and biased inside the SOM (DIFF_TERM_ADV, DQS_BIAS). 5. HK_SCL/SDA, FPGA_PROG_B, FPGA_IRQ are the carrier's 1.8 V levels: CONTROL translates.

Generated by _work/sheets/ias_link.py - review before editing by hand
KV260-IAS2RF
Sheet: /IAS_LINK/
File: IAS_LINK.kicad_sch
Title: IAS_LINK - Hirose IAS1 link to the Kria, AC coupling, terminations

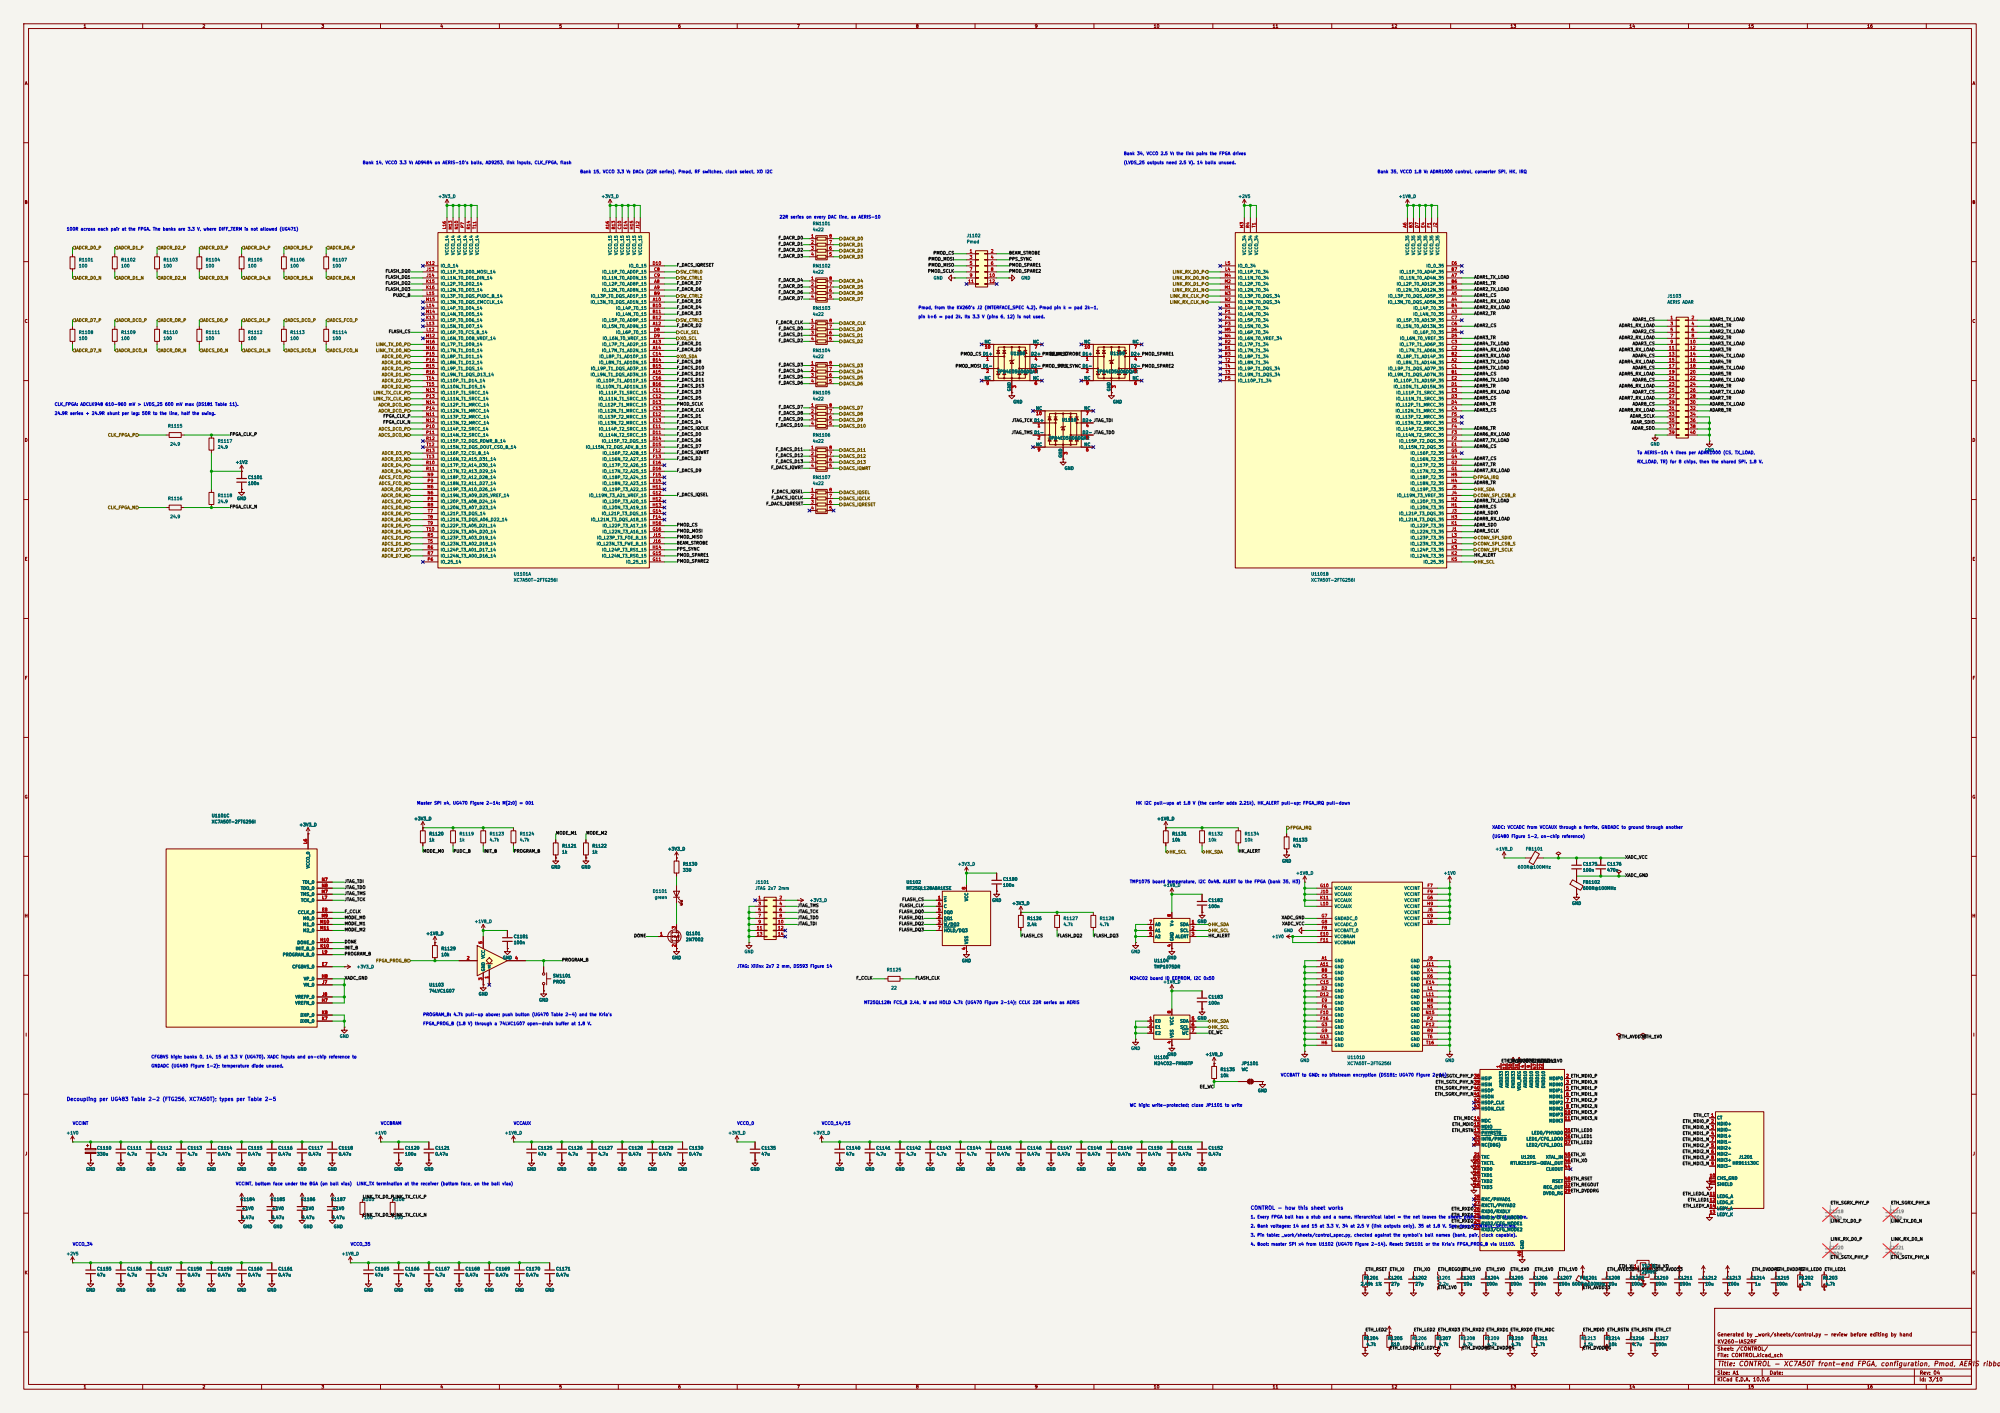
[picture p97: page 3]

Bank 34, VCCO 2.5 V: the link pairs the FPGA drives

Bank 14, VCCO 3.3 V: AD9484 on AERIS-10's balls, AD9253, link inputs, CLK_FPGA, flash 24.9R series + 24.9R shunt per leg: 50R to the line, half the swing.

(LVDS_25 outputs need 2.5 V). 14 balls unused. 22R series on every DAC line, as AERIS-10

Pmod, from the KV260's J2 (INTERFACE_SPEC 4.2). Pmod pin k = pad 2k-1,

pin k+6 = pad 2k. Its 3.3 V (pins 6, 12) is not used.

CLK_FPGA: ADCLK948 610-960 mV > LVDS_25 600 mV max (DS181 Table 11).

GND
RX_LOAD, TR) for 8 chips, then the shared SPI. 1.8 V. To AERIS-10: 4 lines per ADAR1000 (CS, TX_LOAD,

M24C02 board ID EEPROM, I2C 0x50 HK I2C pull-ups at 1.8 V (the carrier adds 2.21k), HK_ALERT pull-up; FPGA_IRQ pull-down

(UG480 Figure 1-2, on-chip reference)

TMP1075 board temperature, I2C 0x48. ALERT to the FPGA (bank 35, H3) JTAG: Xilinx 2x7 2 mm, DS593 Figure 14 Decoupling per UG483 Table 2-2 (FTG256, XC7A50T); types per Table 2-5

VCCO_14/15 PROGRAM_B: 4.7k pull-up above; push button (UG470 Table 2-4) and the Kria's

CONTROL - how this sheet works WC high: write-protected; close JP1101 to write

VCCINT, bottom face under the BGA (on ball vias)

Generated by _work/sheets/control.py - review before editing by hand
KV260-IAS2RF
Sheet: /CONTROL/
File: CONTROL.kicad_sch
Title: CONTROL - XC7A50T front-end FPGA, configuration, Pmod, AERIS ribbon

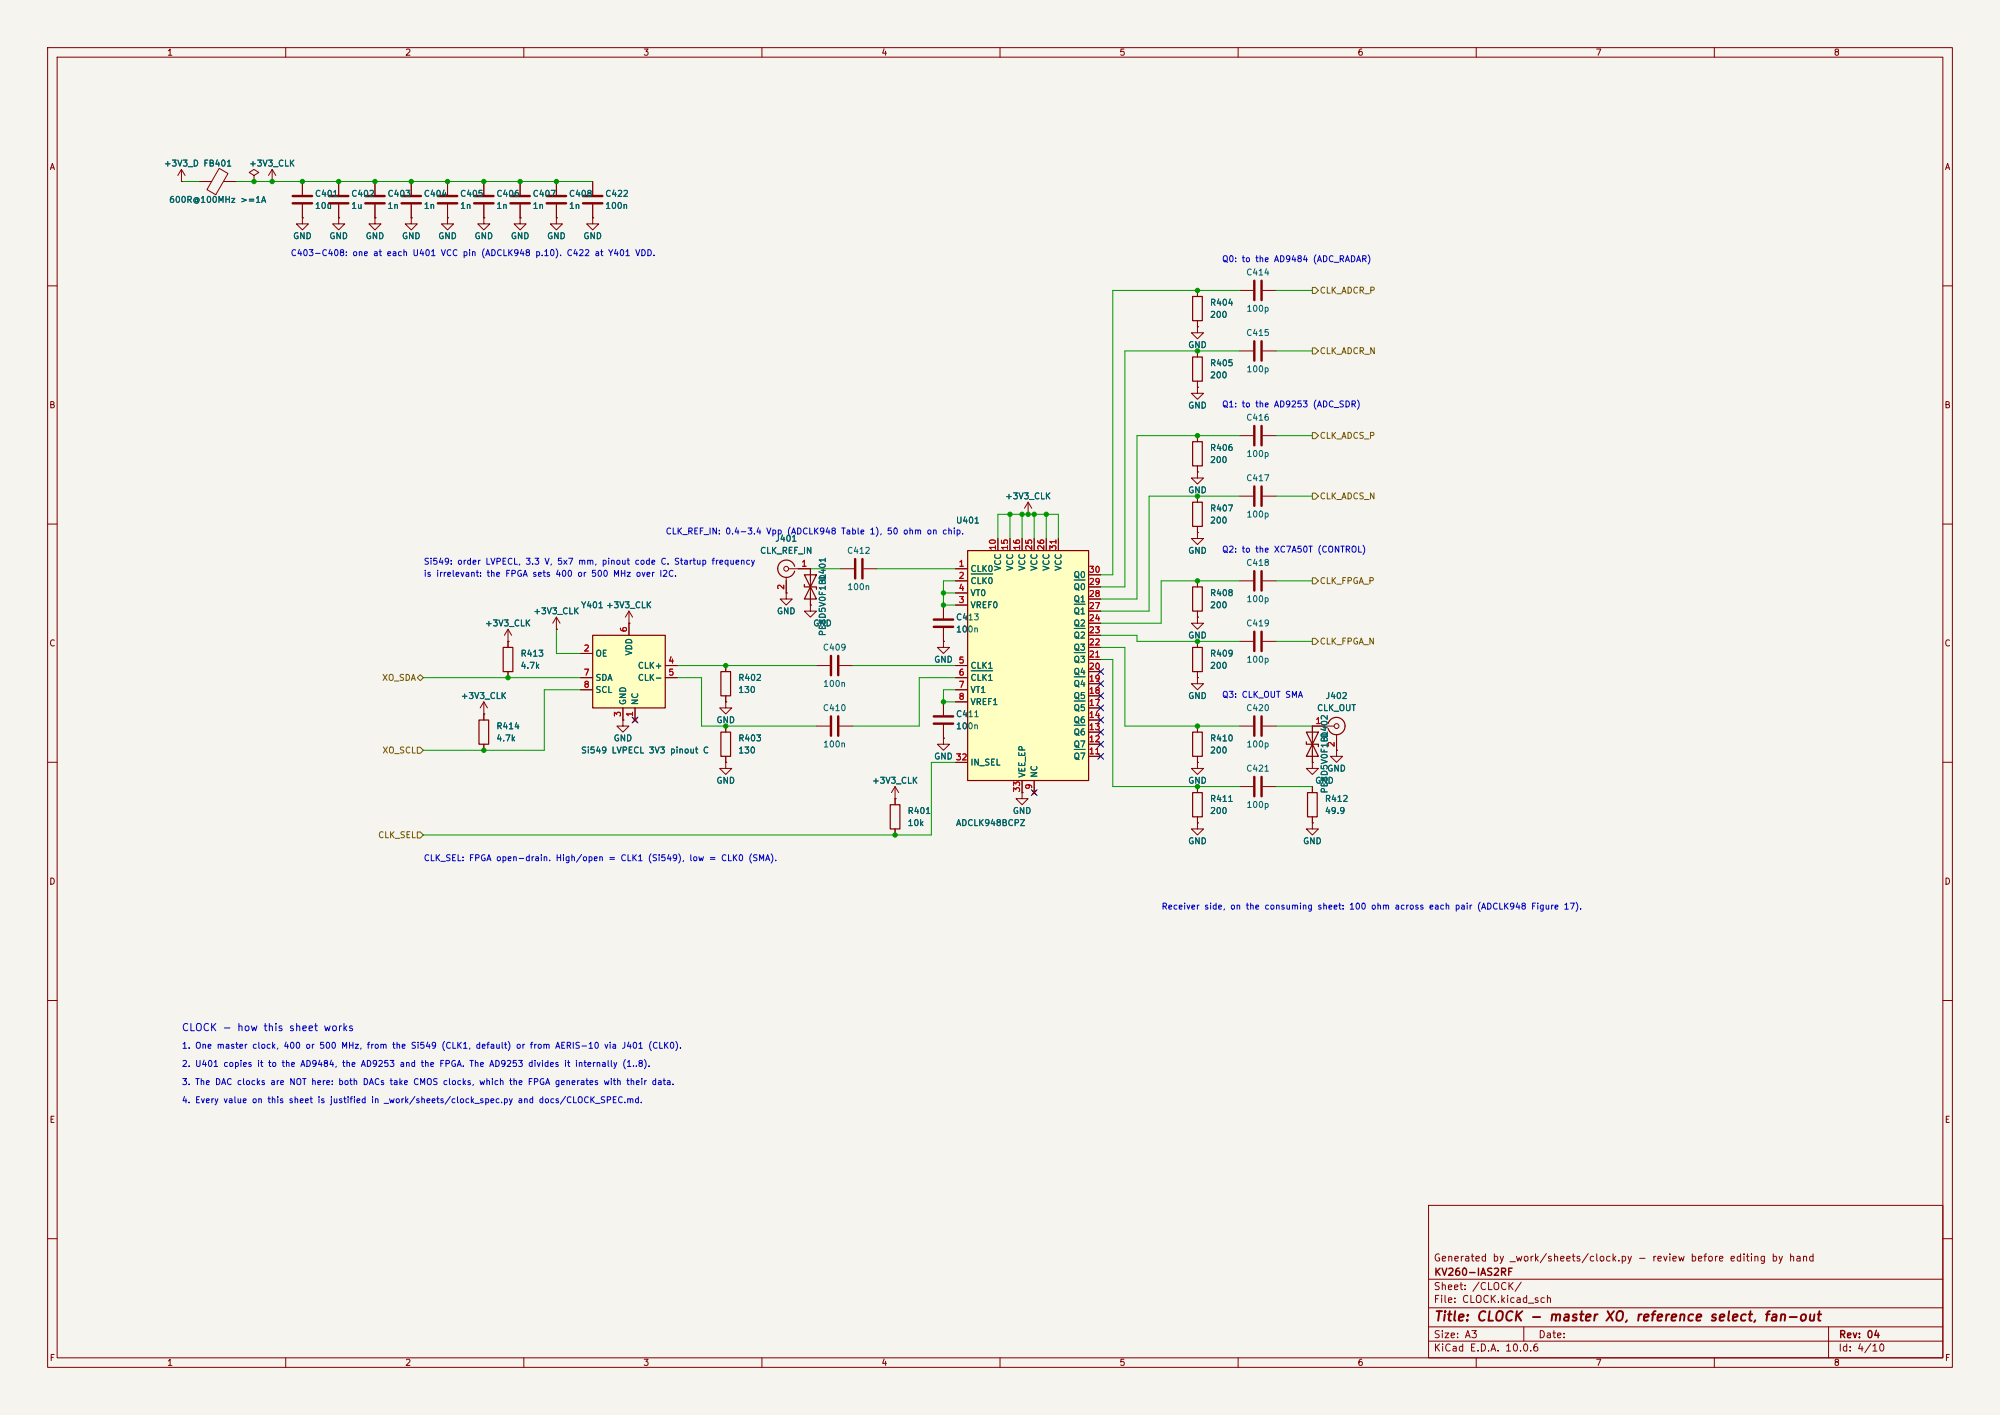
[picture p98: page 4]

Generated by _work/sheets/clock.py - review before editing by hand D401 PESD5V0F1BL GND

Q3: CLK_OUT SMA CLK_REF_IN: 0.4-3.4 Vpp (ADCLK948 Table 1), 50 ohm on chip. CLK_SEL: FPGA open-drain. High/open = CLK1 (Si549), low = CLK0 (SMA). 3. The DAC clocks are NOT here: both DACs take CMOS clocks, which the FPGA generates with their data.

9 VCC 10 Q7 11 Q7 12 Q6 13 Q6 14 VCC 15 VCC 16 Q5 17 Q5 18 Q4 19 Q4 20 Q3 21 Q3 22 Q2 23 Q2 24 VCC 25 VCC 26 Q1 27 Q1 28 Q0 29 Q0 VCC 30 31

Si549: order LVPECL, 3.3 V, 5x7 mm, pinout code C. Startup frequency

2. U401 copies it to the AD9484, the AD9253 and the FPGA. The AD9253 divides it internally (1..8).

KV260-IAS2RF
Sheet: /CLOCK/
File: CLOCK.kicad_sch
Title: CLOCK - master XO, reference select, fan-out

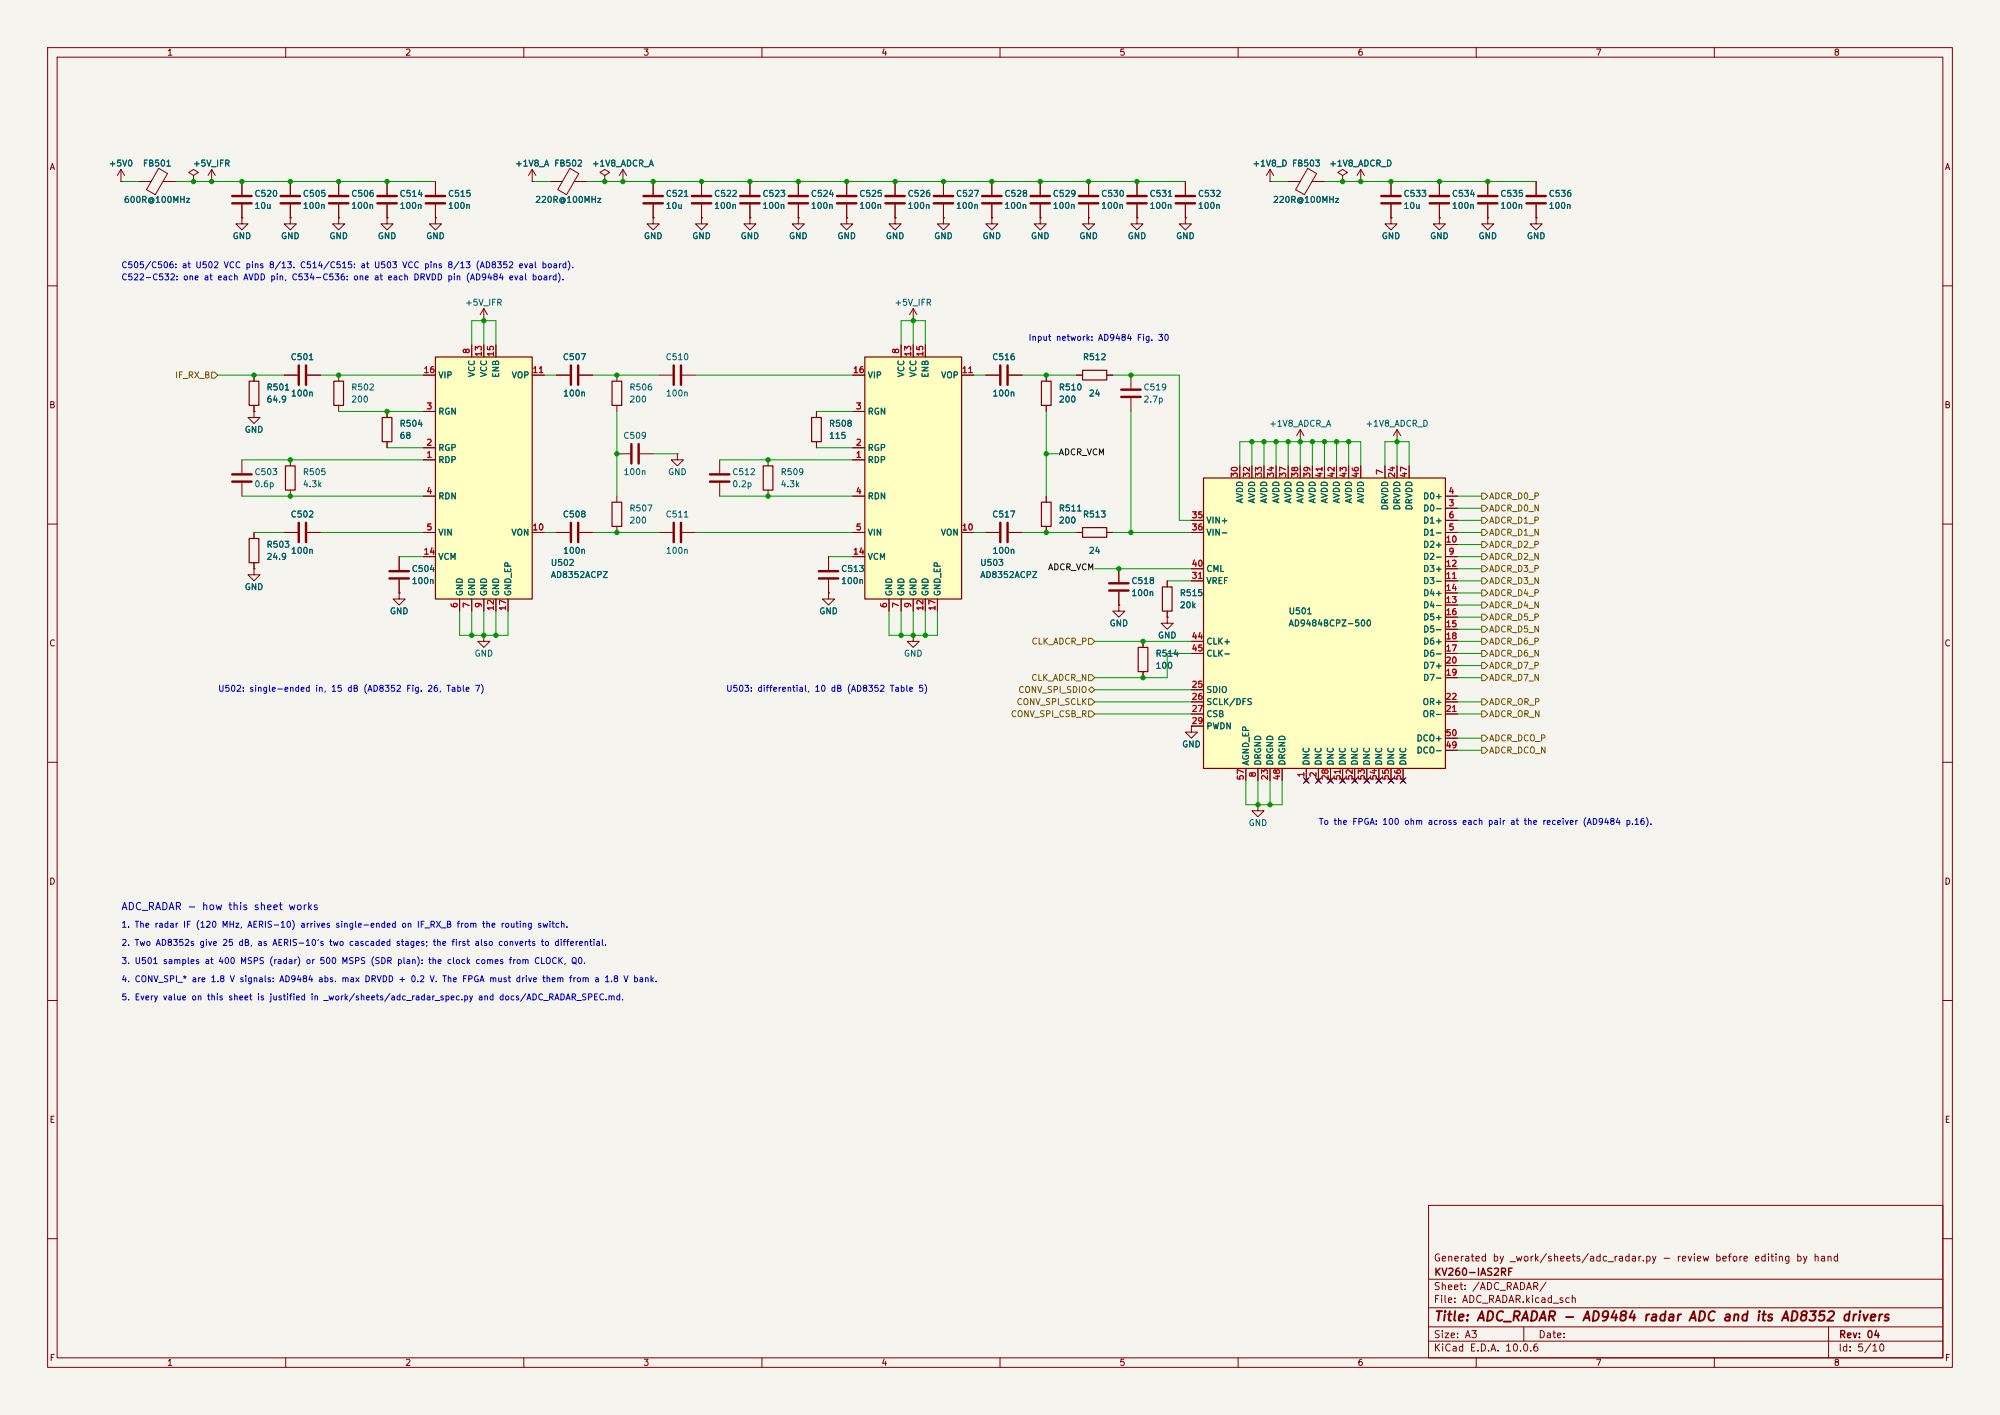
[picture p99: page 5]

C505/C506: at U502 VCC pins 8/13. C514/C515: at U503 VCC pins 8/13 (AD8352 eval board). C522-C532: one at each AVDD pin, C534-C536: one at each DRVDD pin (AD9484 eval board).

8 D2- 9 D2+ 10 D3- 11 D3+ 12 D4- 13 D4+ 14 D5- 15 D5+ 16 D6- 17 D6+ 18 D7- 19 D7+ 20 OR- 21 OR+ 22 DRGND 23 DRVDD 24

To the FPGA: 100 ohm across each pair at the receiver (AD9484 p.16).

5. Every value on this sheet is justified in _work/sheets/adc_radar_spec.py and docs/ADC_RADAR_SPEC.md. 4. CONV_SPI_* are 1.8 V signals: AD9484 abs. max DRVDD + 0.2 V. The FPGA must drive them from a 1.8 V bank.

Generated by _work/sheets/adc_radar.py - review before editing by hand
KV260-IAS2RF
Sheet: /ADC_RADAR/
File: ADC_RADAR.kicad_sch
Title: ADC_RADAR - AD9484 radar ADC and its AD8352 drivers

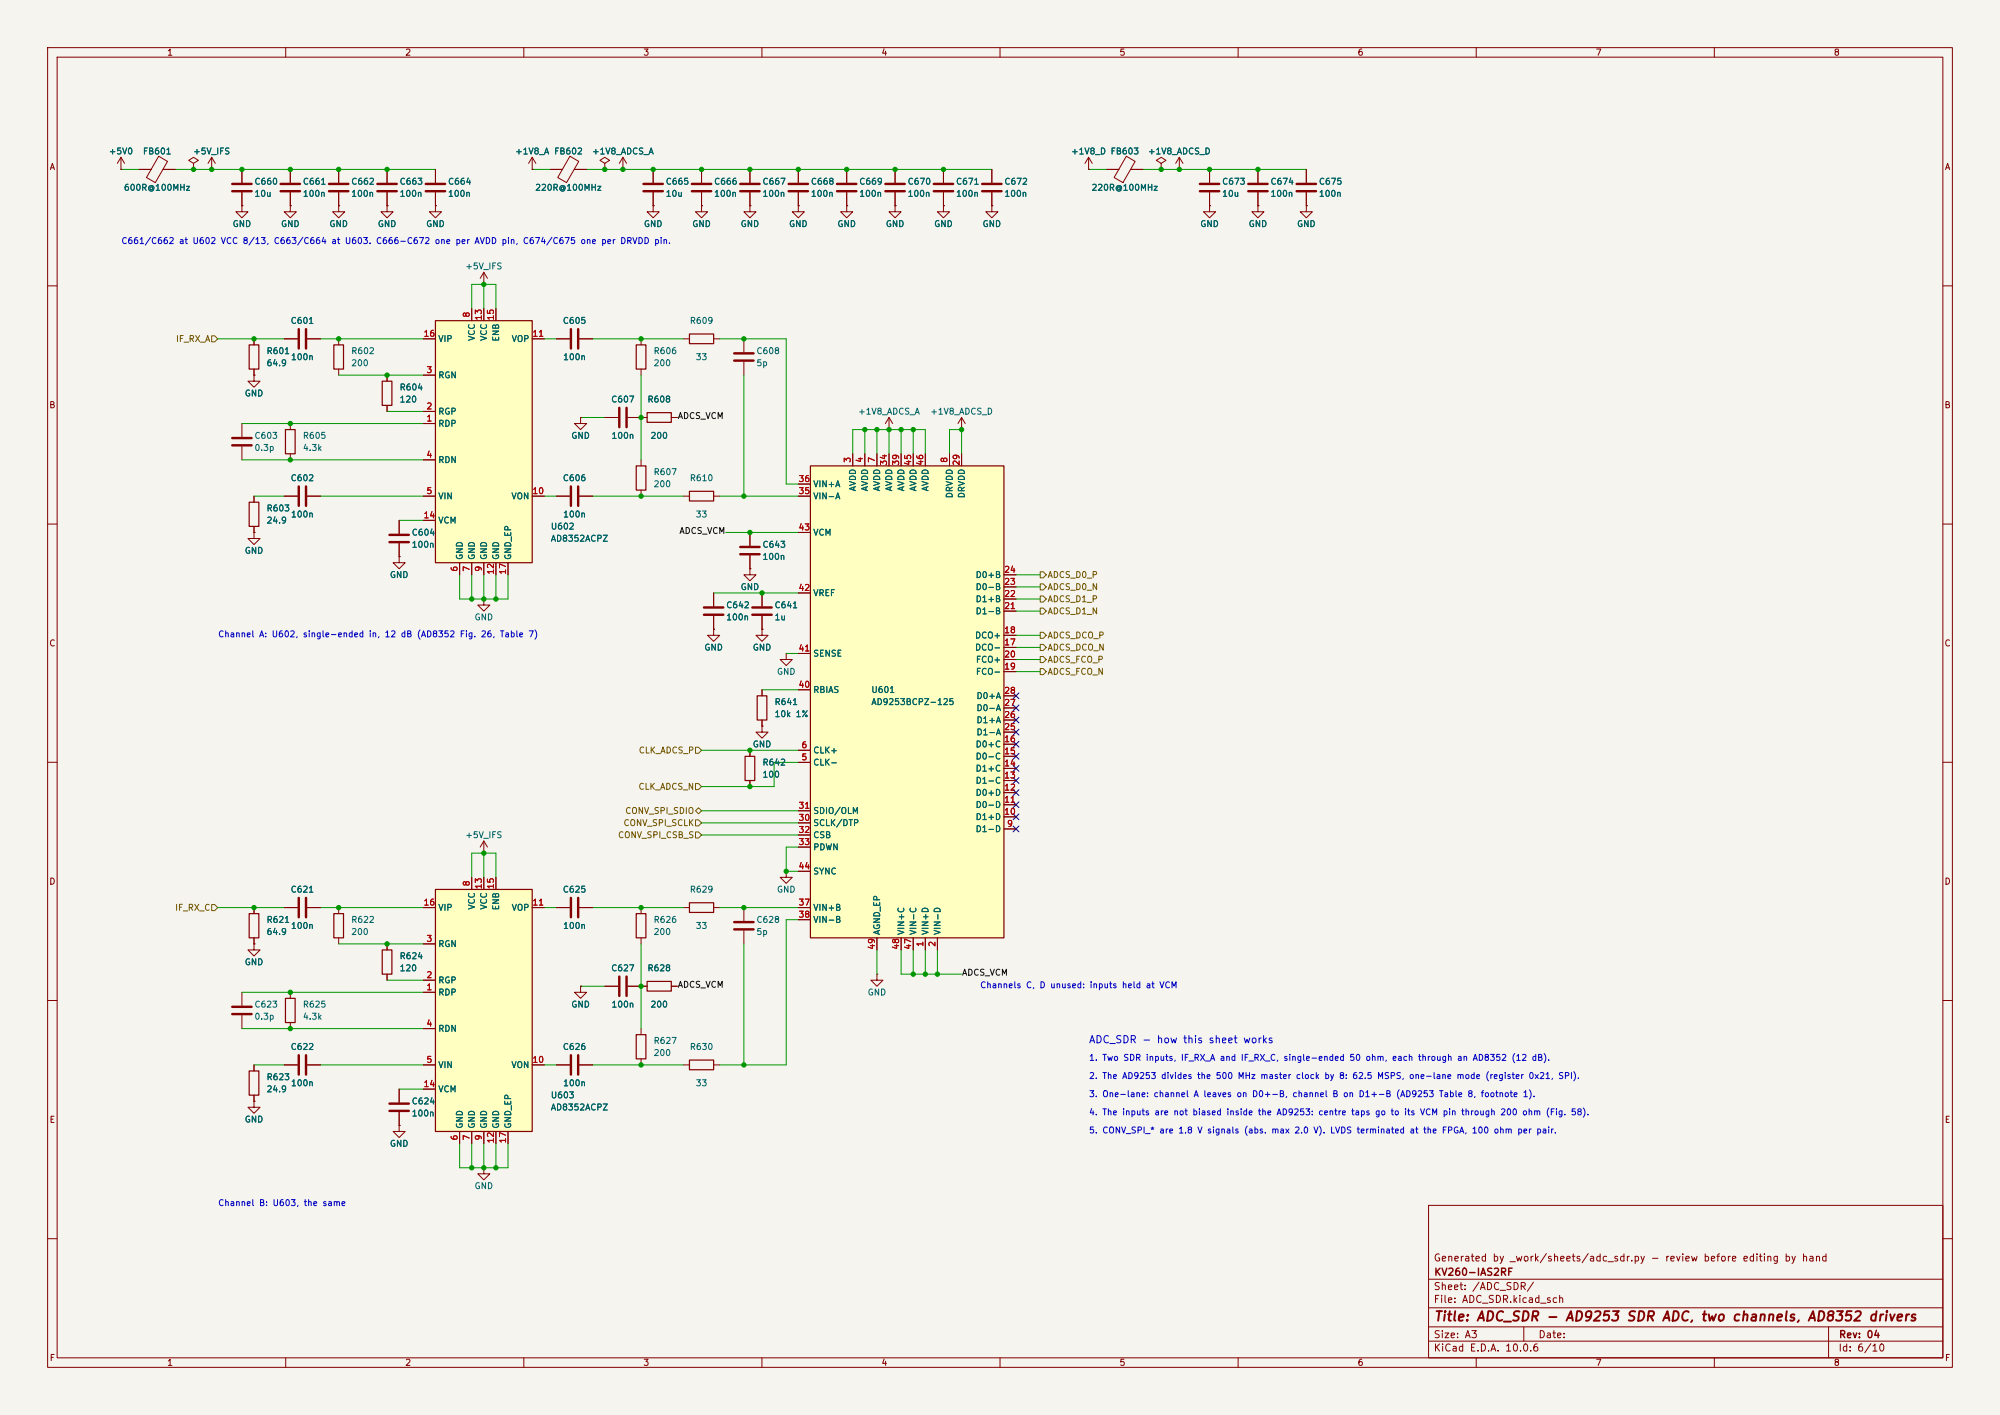
[picture p100: page 6]

C661/C662 at U602 VCC 8/13, C663/C664 at U603. C666-C672 one per AVDD pin, C674/C675 one per DRVDD pin.

Channel A: U602, single-ended in, 12 dB (AD8352 Fig. 26, Table 7)

ADCS_VCM
Channels C, D unused: inputs held at VCM

ADC_SDR - how this sheet works

1. Two SDR inputs, IF_RX_A and IF_RX_C, single-ended 50 ohm, each through an AD8352 (12 dB). 2. The AD9253 divides the 500 MHz master clock by 8: 62.5 MSPS, one-lane mode (register 0x21, SPI). 3. One-lane: channel A leaves on D0+-B, channel B on D1+-B (AD9253 Table 8, footnote 1).

4. The inputs are not biased inside the AD9253: centre taps go to its VCM pin through 200 ohm (Fig. 58). 5. CONV_SPI_* are 1.8 V signals (abs. max 2.0 V). LVDS terminated at the FPGA, 100 ohm per pair. Channel B: U603, the same
GND

Generated by _work/sheets/adc_sdr.py - review before editing by hand
KV260-IAS2RF
Sheet: /ADC_SDR/
File: ADC_SDR.kicad_sch
Title: ADC_SDR - AD9253 SDR ADC, two channels, AD8352 drivers

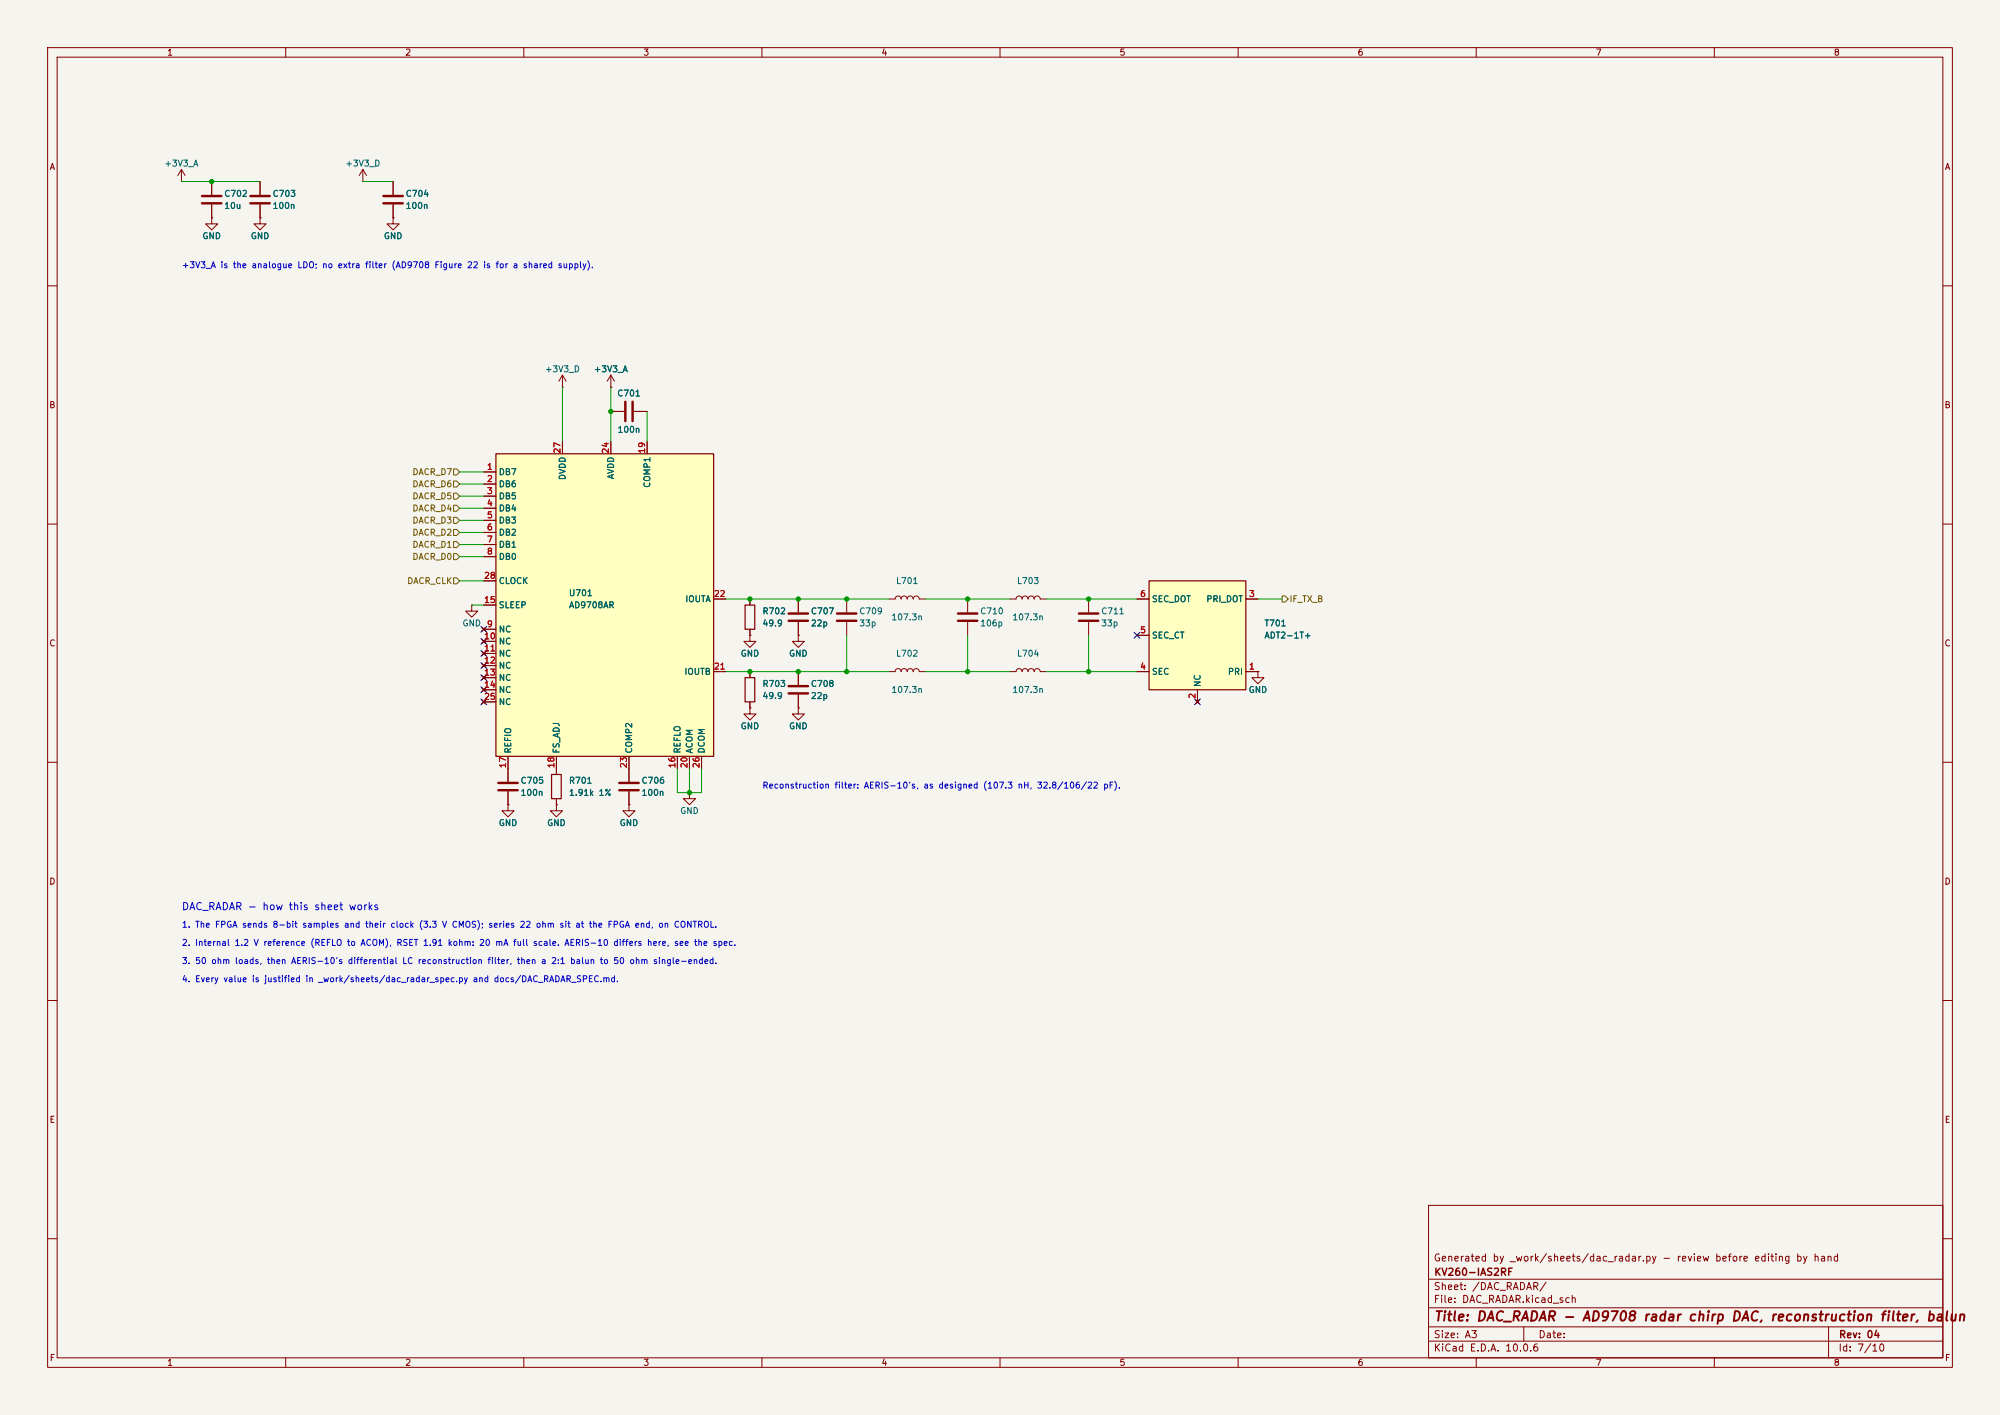
[picture p101: page 7]

DAC_RADAR - how this sheet works

4. Every value is justified in _work/sheets/dac_radar_spec.py and docs/DAC_RADAR_SPEC.md. 3. 50 ohm loads, then AERIS-10's differential LC reconstruction filter, then a 2:1 balun to 50 ohm single-ended.

Generated by _work/sheets/dac_radar.py - review before editing by hand
KV260-IAS2RF
Sheet: /DAC_RADAR/
File: DAC_RADAR.kicad_sch
Title: DAC_RADAR - AD9708 radar chirp DAC, reconstruction filter, balun

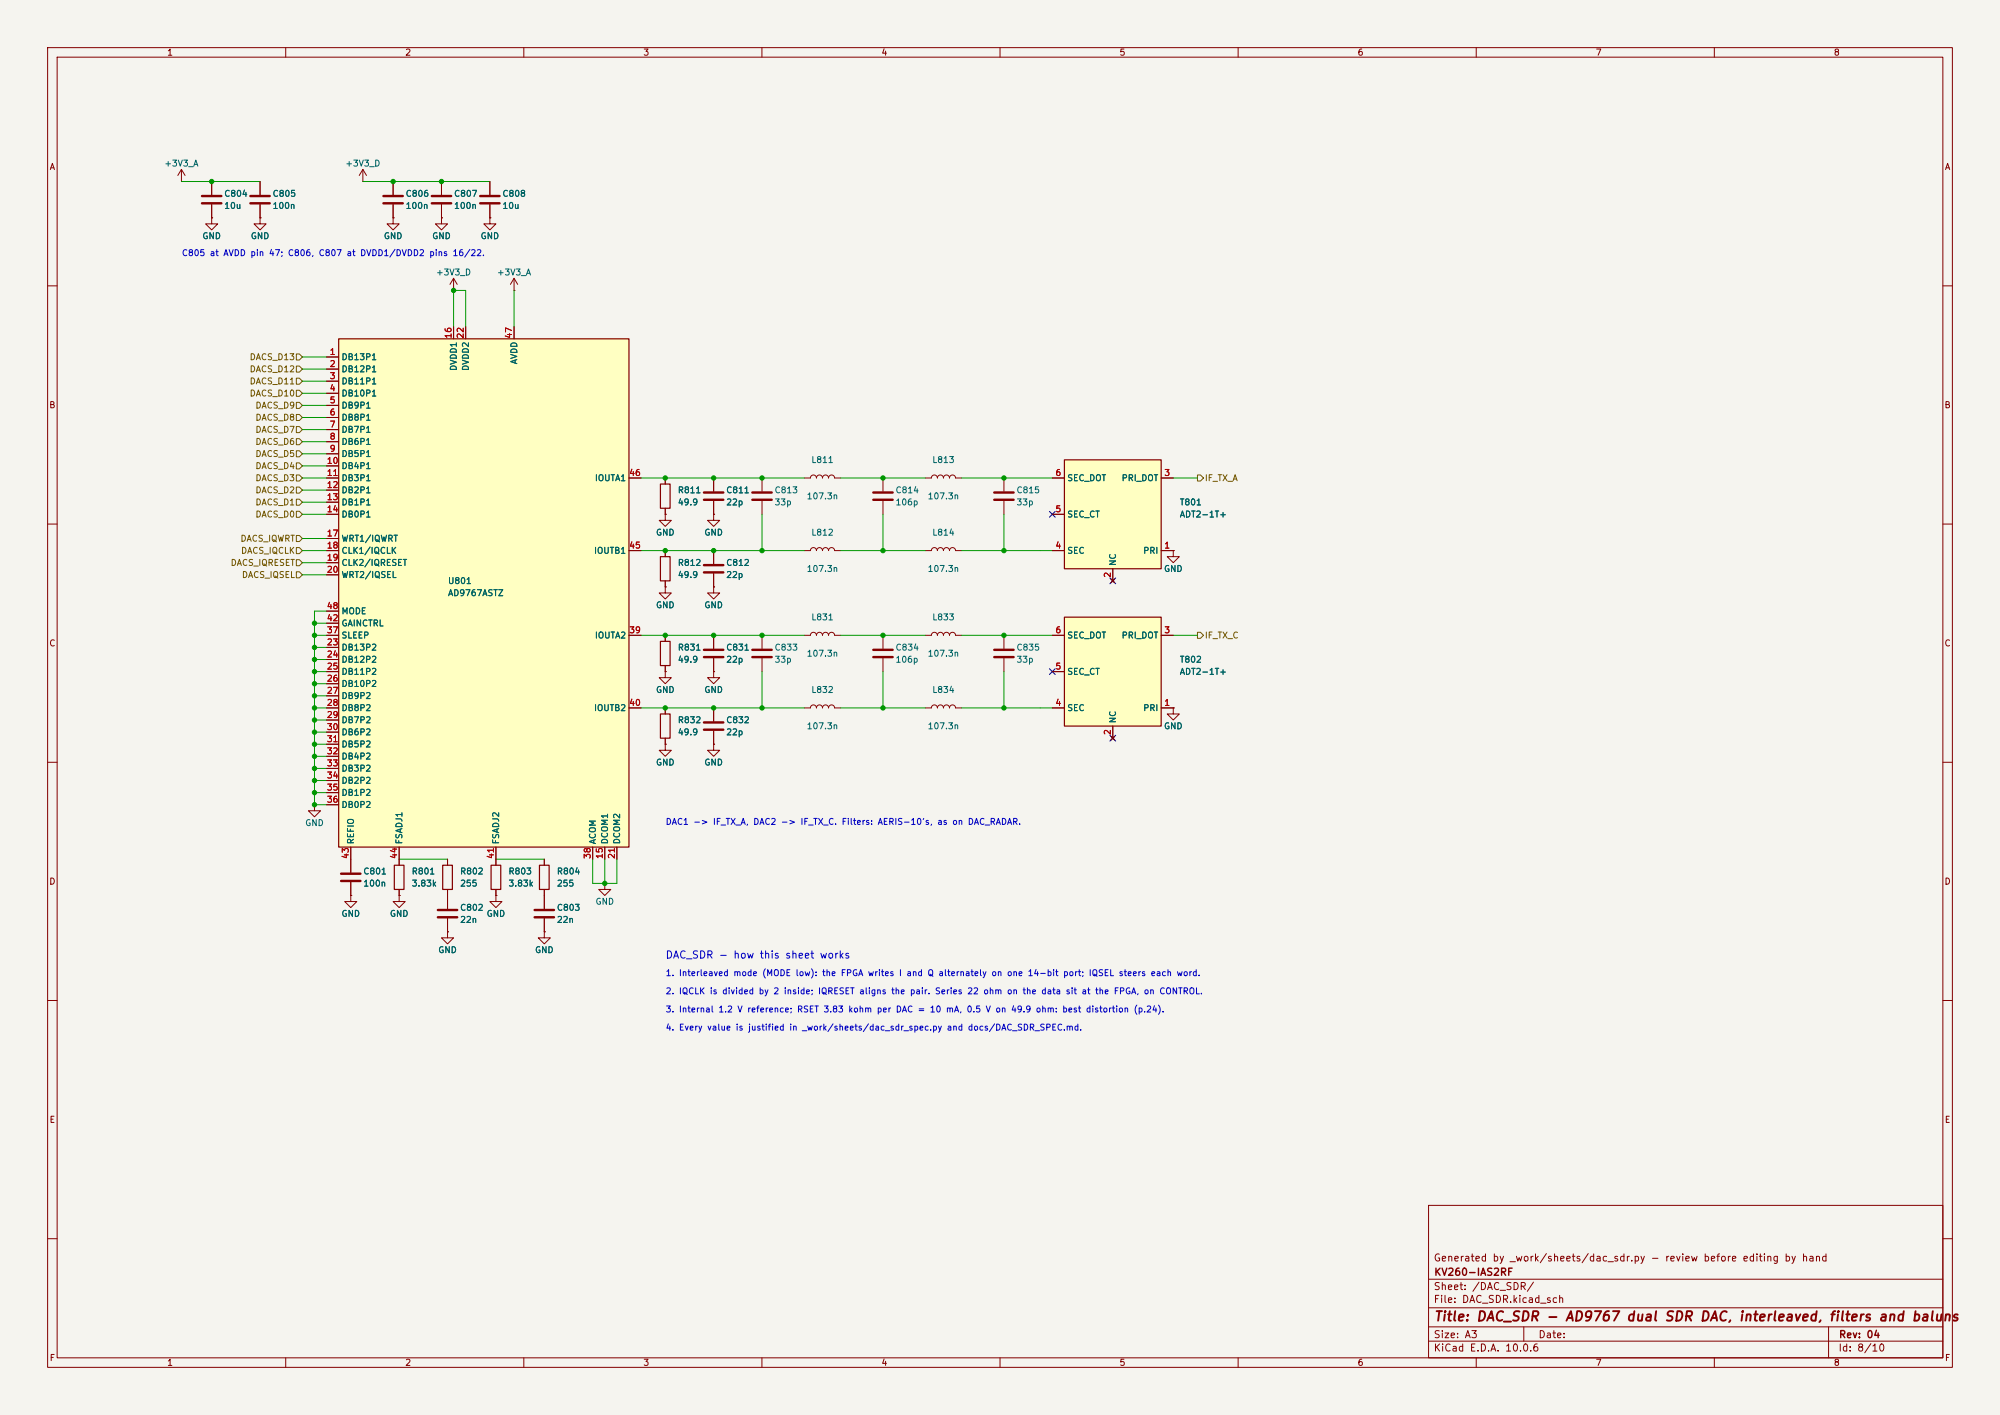
[picture p102: page 8]

1. Interleaved mode (MODE low): the FPGA writes I and Q alternately on one 14-bit port; IQSEL steers each word. 2. IQCLK is divided by 2 inside; IQRESET aligns the pair. Series 22 ohm on the data sit at the FPGA, on CONTROL. 3. Internal 1.2 V reference; RSET 3.83 kohm per DAC = 10 mA, 0.5 V on 49.9 ohm: best distortion (p.24). 4. Every value is justified in _work/sheets/dac_sdr_spec.py and docs/DAC_SDR_SPEC.md.

Generated by _work/sheets/dac_sdr.py - review before editing by hand
KV260-IAS2RF
Sheet: /DAC_SDR/
File: DAC_SDR.kicad_sch
Title: DAC_SDR - AD9767 dual SDR DAC, interleaved, filters and baluns

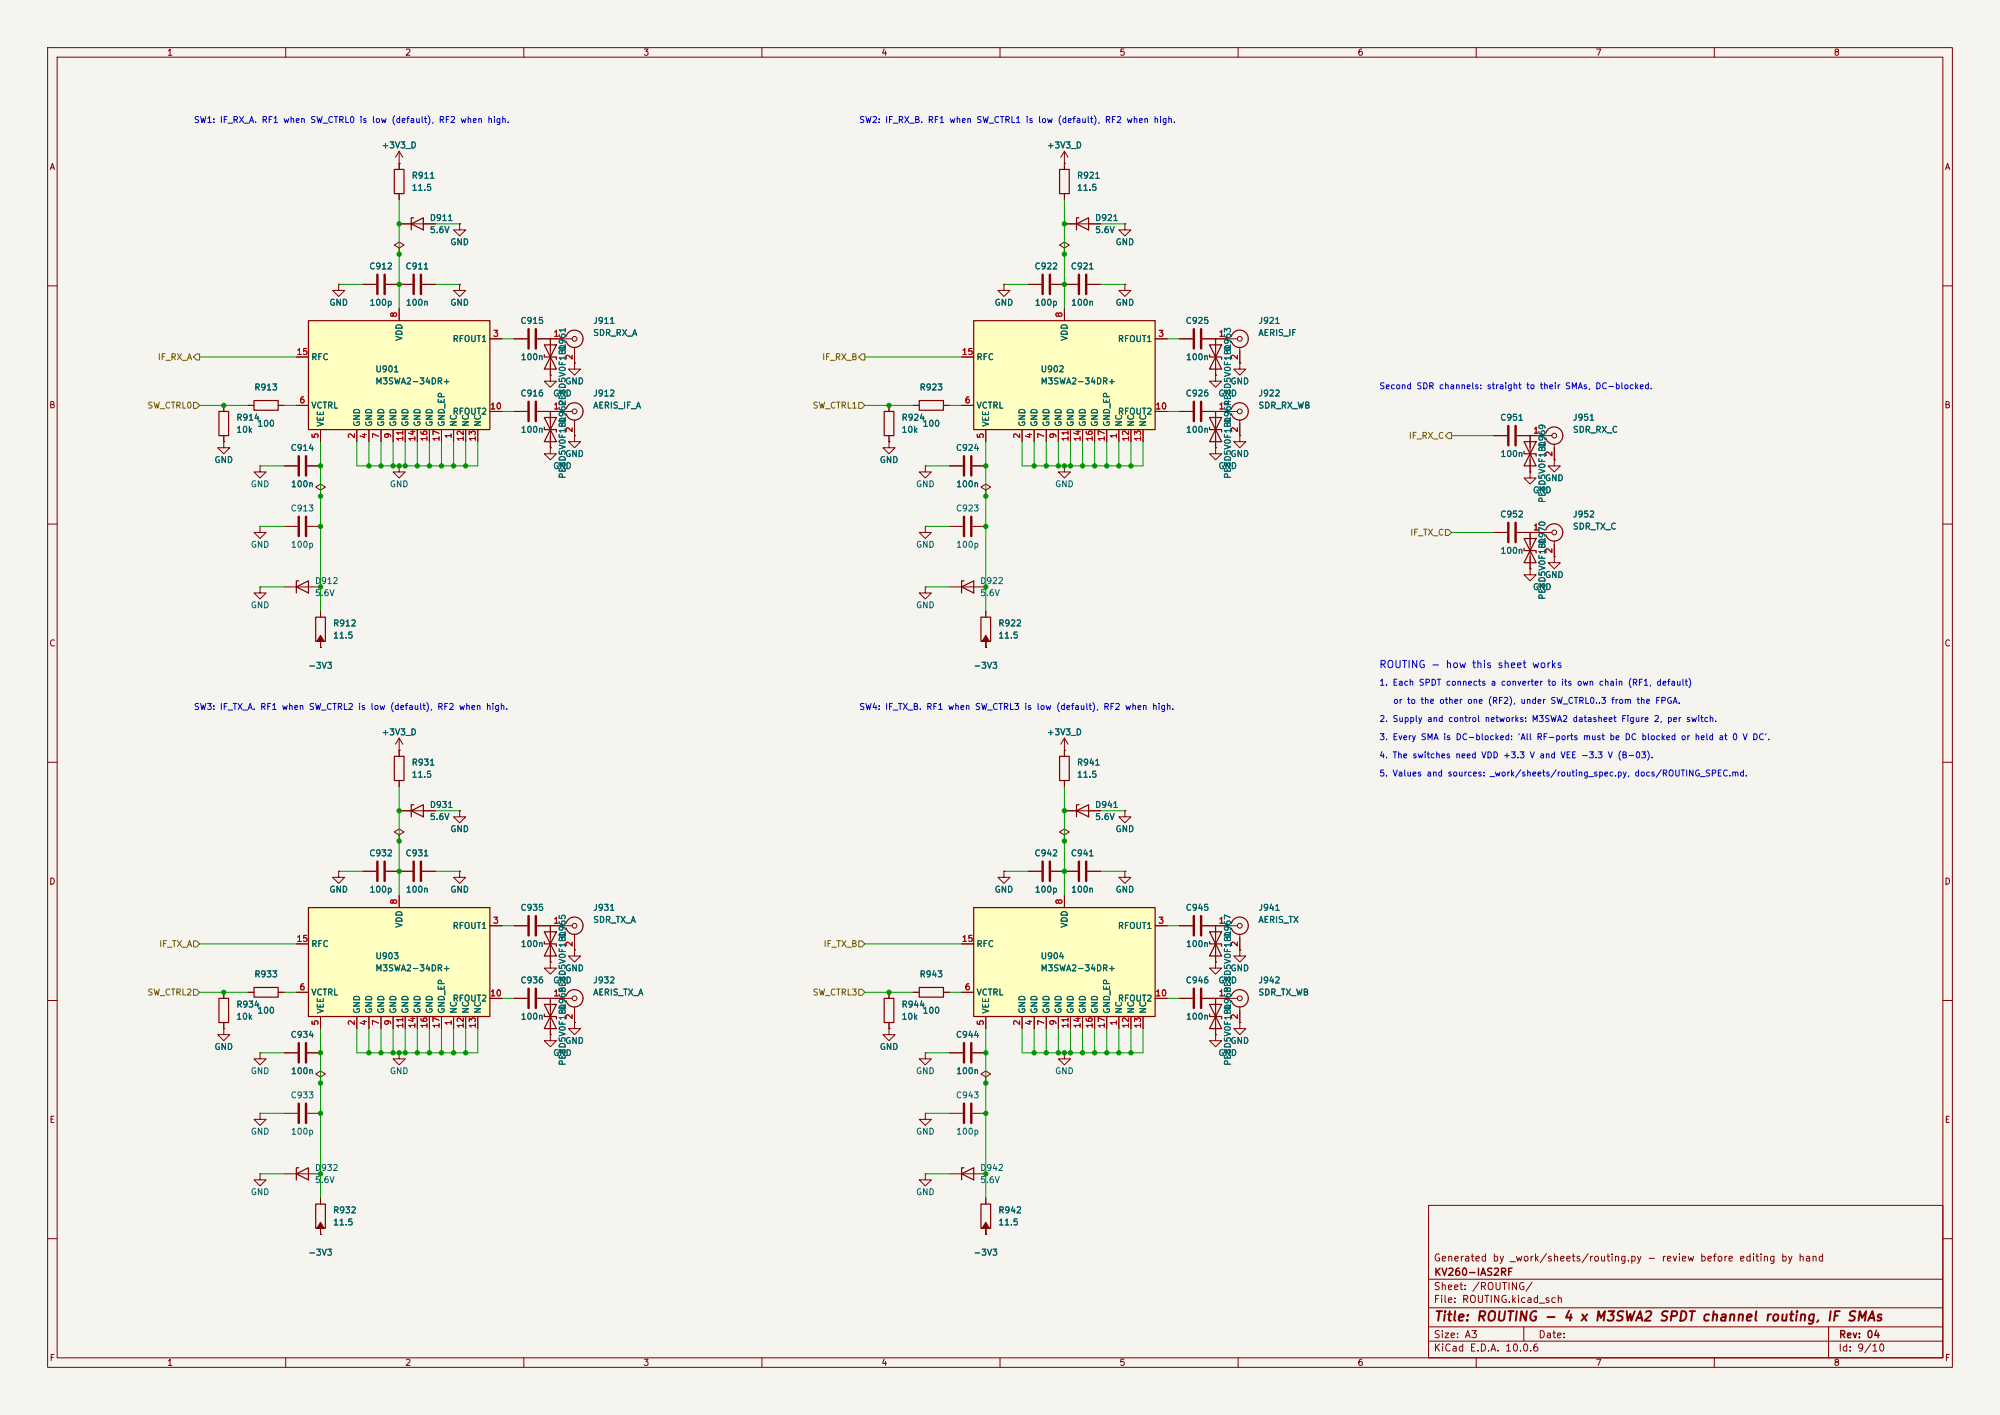
[picture p103: page 9]

SW2: IF_RX_B. RF1 when SW_CTRL1 is low (default), RF2 when high. SW3: IF_TX_A. RF1 when SW_CTRL2 is low (default), RF2 when high.

9 RFOUT2 10 GND 11 NC 12 NC 13 GND 14 RFC 15 GND 16 GND_EP 17 GND

9 RFOUT2 10 GND 11 NC 12 NC 13 GND 14 RFC 15 GND 16 GND_EP 17 U901 M3SWA2-34DR+

9 RFOUT2 10 GND 11 NC 12 NC 13 GND 14 RFC 15 GND 16 GND_EP 17 U902 M3SWA2-34DR+

Second SDR channels: straight to their SMAs, DC-blocked. SW4: IF_TX_B. RF1 when SW_CTRL3 is low (default), RF2 when high.

ROUTING - how this sheet works

2. Supply and control networks: M3SWA2 datasheet Figure 2, per switch. 3. Every SMA is DC-blocked: 'All RF-ports must be DC blocked or held at 0 V DC'. 4. The switches need VDD +3.3 V and VEE -3.3 V (B-03). 5. Values and sources: _work/sheets/routing_spec.py, docs/ROUTING_SPEC.md.

9 RFOUT2 10 GND 11 NC 12 NC 13 GND 14 RFC 15 GND 16 GND_EP 17 U903 M3SWA2-34DR+ NC

9 RFOUT2 10 GND 11 NC 12 NC 13 GND 14 RFC 15 GND 16 GND_EP 17 U904 M3SWA2-34DR+

9 RFOUT2 10 GND 11 NC 12 NC 13 GND 14 RFC 15 GND 16 GND_EP 17 GNDD968 PESD5V0F1BL GND

Generated by _work/sheets/routing.py - review before editing by hand
KV260-IAS2RF
Sheet: /ROUTING/
File: ROUTING.kicad_sch
Title: ROUTING - 4 x M3SWA2 SPDT channel routing, IF SMAs

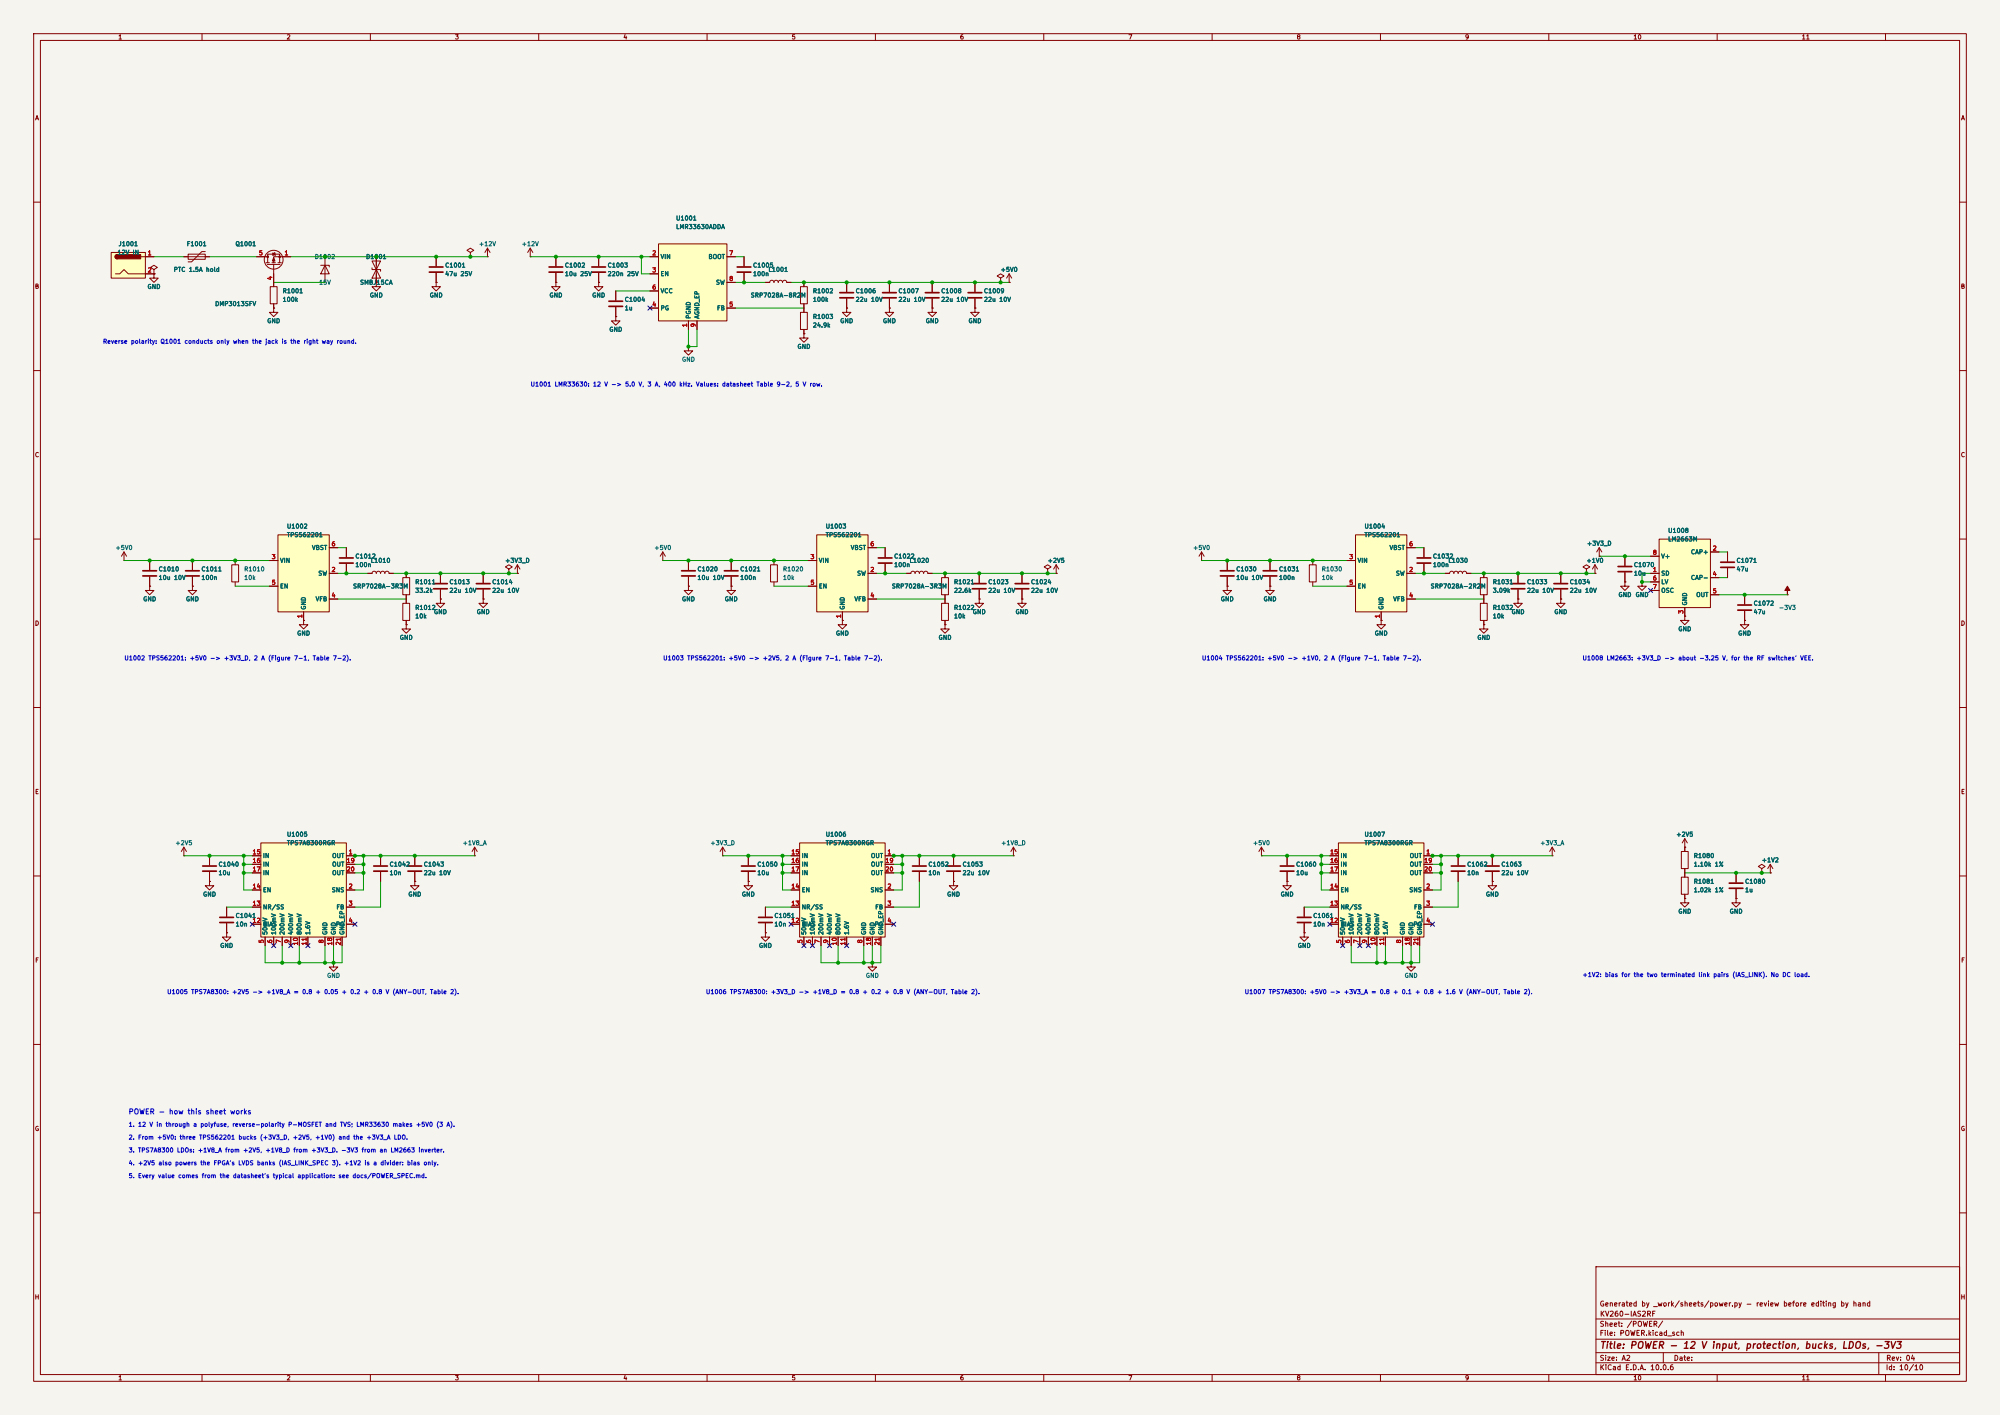
[picture p104: page 10]

Reverse polarity: Q1001 conducts only when the jack is the right way round.

U1001 LMR33630: 12 V -> 5.0 V, 3 A, 400 kHz. Values: datasheet Table 9-2, 5 V row.

+1V2: bias for the two terminated link pairs (IAS_LINK). No DC load. 3. TPS7A8300 LDOs: +1V8_A from +2V5, +1V8_D from +3V3_D. -3V3 from an LM2663 inverter.

1. 12 V in through a polyfuse, reverse-polarity P-MOSFET and TVS; LMR33630 makes +5V0 (3 A).

2. From +5V0: three TPS562201 bucks (+3V3_D, +2V5, +1V0) and the +3V3_A LDO.

4. +2V5 also powers the FPGA's LVDS banks (IAS_LINK_SPEC 3). +1V2 is a divider: bias only.

Generated by _work/sheets/power.py - review before editing by hand
KV260-IAS2RF
Sheet: /POWER/
File: POWER.kicad_sch
Title: POWER - 12 V input, protection, bucks, LDOs, -3V3
