PabloSoage/kv260-ias2rf/Documents/CSI2-KRIA-KV260_Rev01_Schematic.PDF

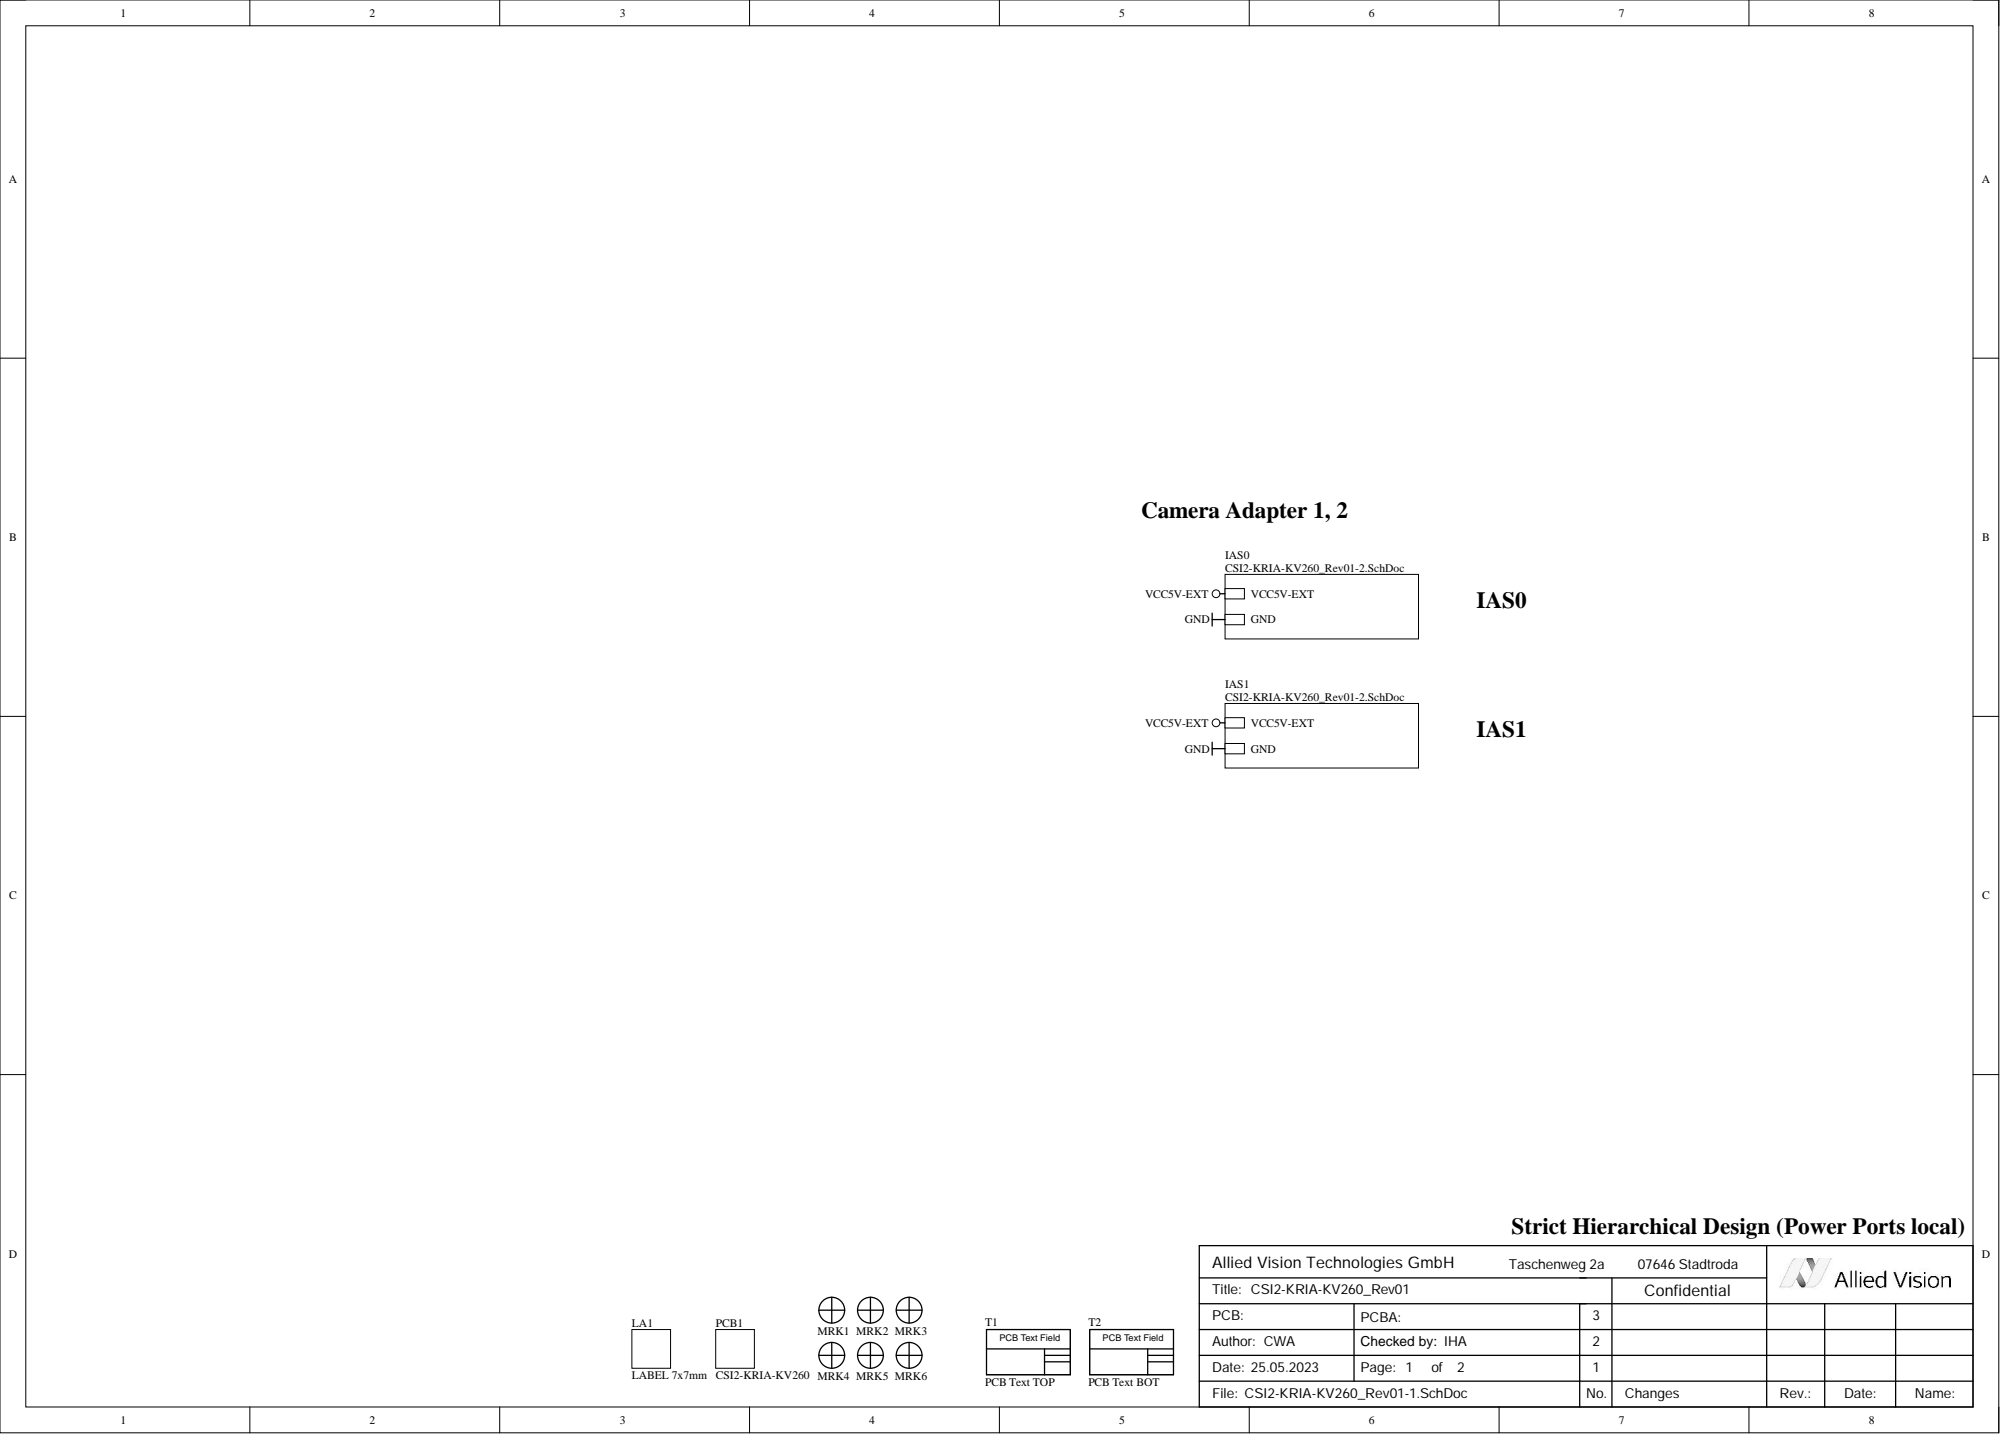
[picture p105: page 1]

Strict Hierarchical Design (Power Ports local)

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

Title: CSI2-KRIA-KV260_ Rev01 | Co n fi d e n ti a l

PC B : | PCB A :

Date: 25.05.2023 | Page: 1 of 2

File: CSI2-KRIA-KV260_Rev01-1. S chDoc | | No. | Changes | Rev . : | Date: | Name:

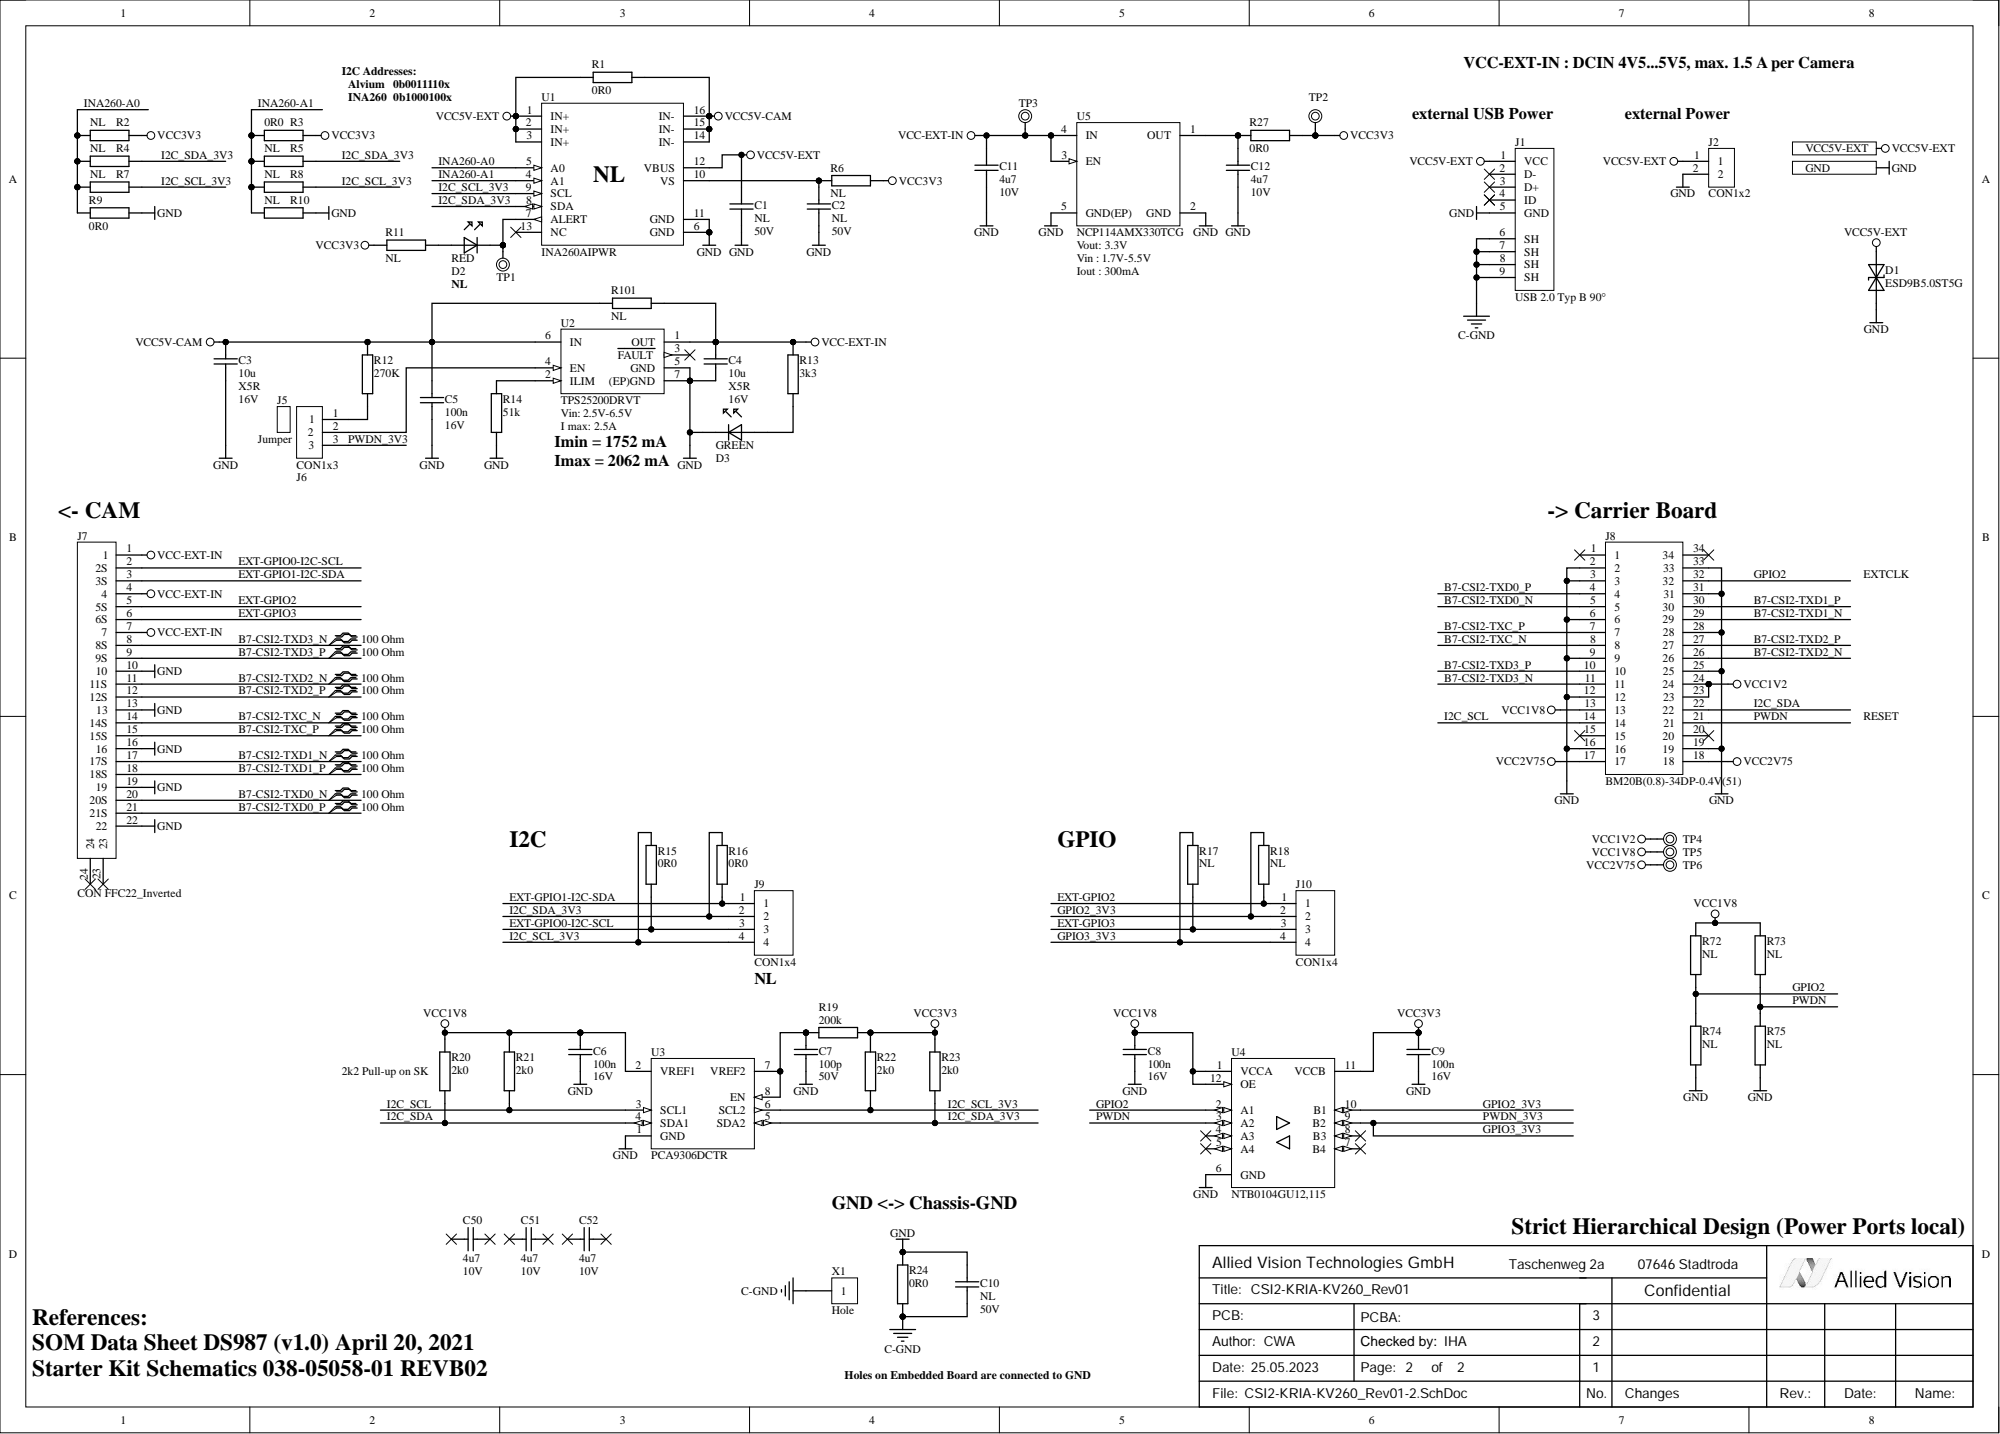
[picture p106: page 2]

VCC-EXT-IN : DCIN 4V5...5V5, max. 1.5 A per Camera

SH 7
SH 8
SH 9

2k2 Pull-up on SK

Strict Hierarchical Design (Power Ports local)

Allied Vision Technologies GmbH

References:
SOM Data Sheet DS987 (v1.0) April 20, 2021
Starter Kit Schematics 038-05058-01 REVB02

PCB: | PCBA: | 3

Author: CWA | Checked by: IHA | 2

Holes on Embedded Board are connected to GND

Date: 25.05.2023 | | 1

File: CSI2-KRIA-KV260_Rev01-2.SchDoc | | No. | Changes | Rev.: | Date: | Name:
