PabloSoage/kv260-ias2rf/docs/CSI2-KRIA-KV260_Rev04_layout.pdf

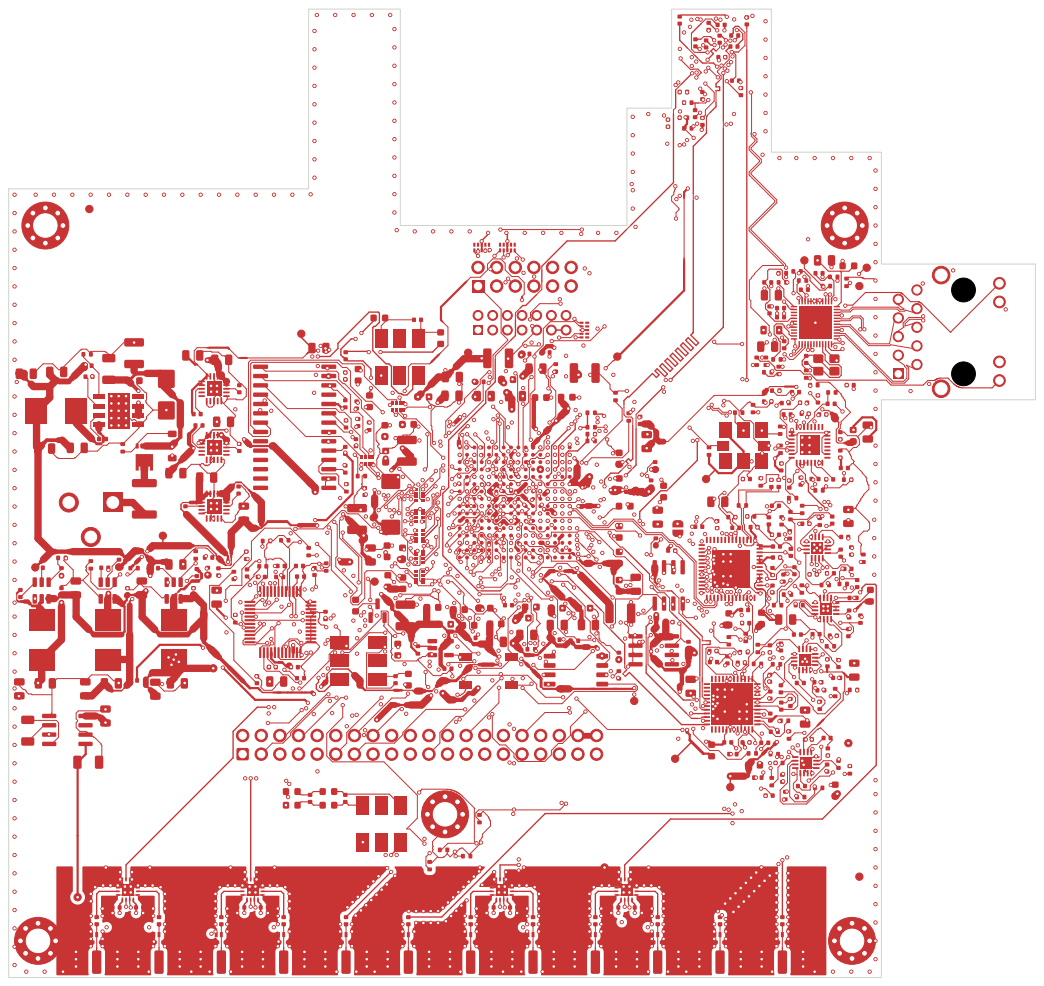
[picture p107: page 1]

Size: A3 | Rev: 04 | F Date:
KiCad E.D.A. 10.0.6 | Id: 1/10

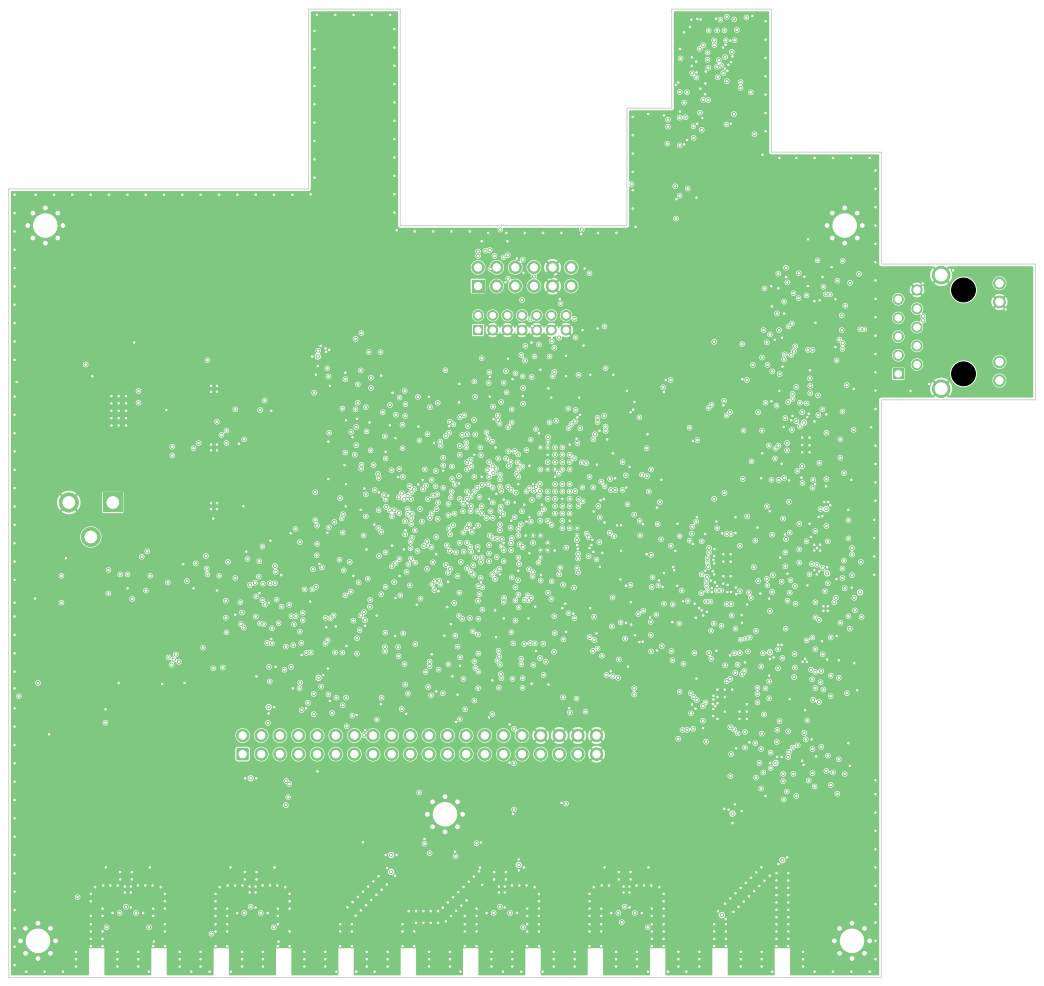
[picture p108: page 2]

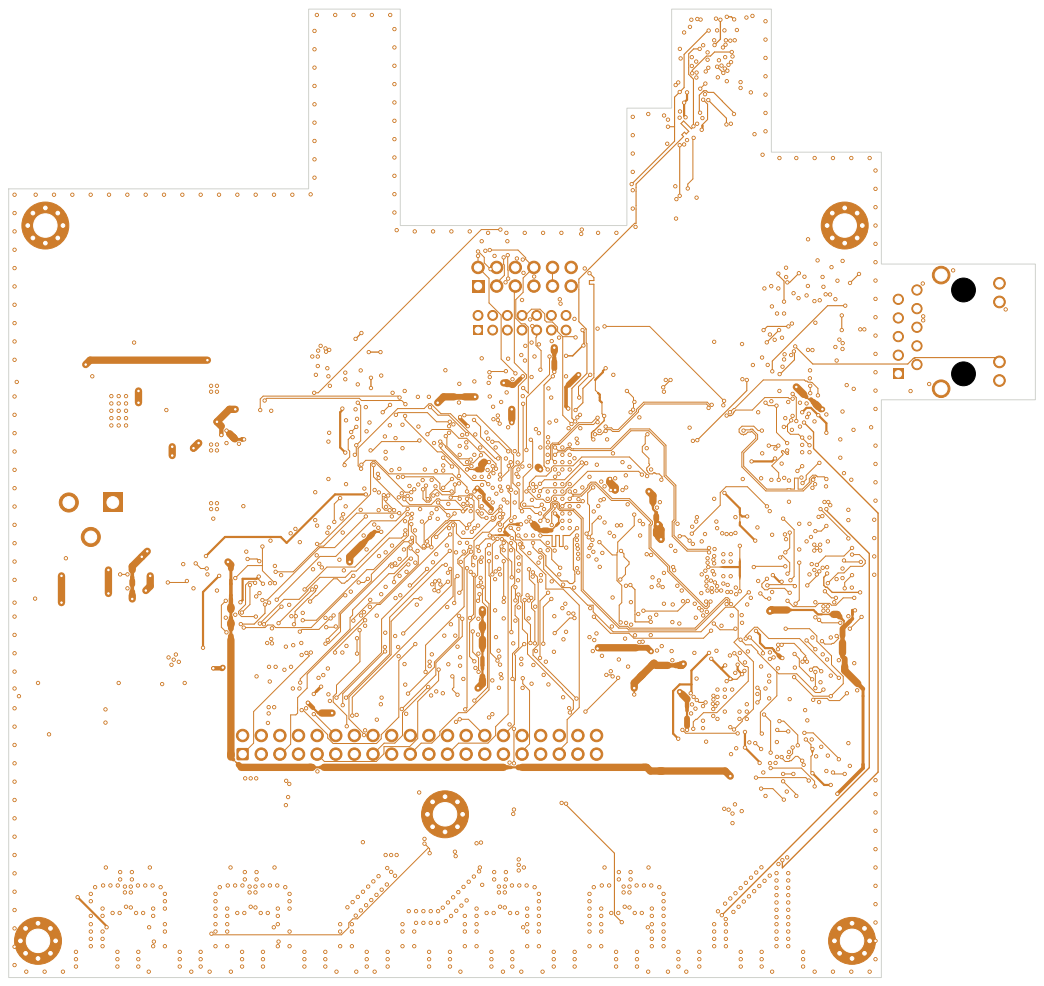
[picture p109: page 3]

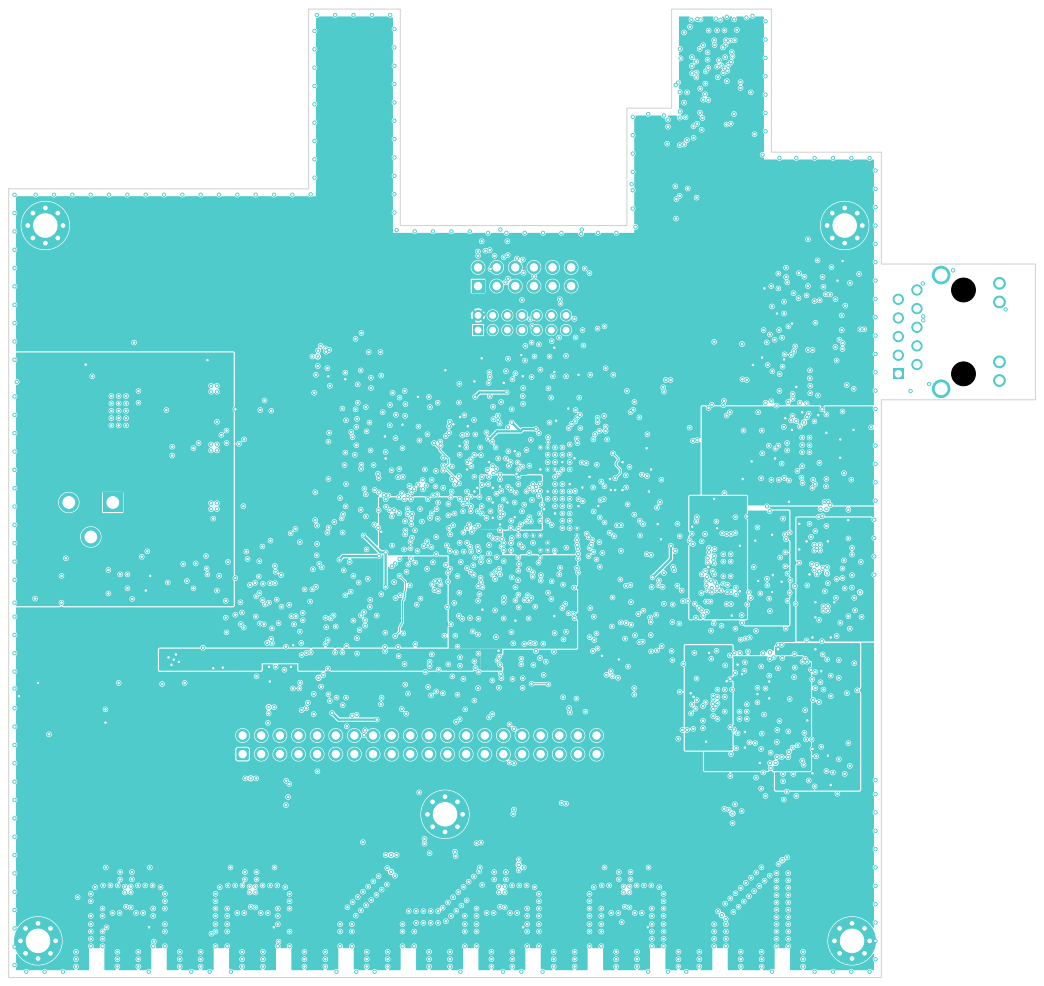
[picture p110: page 4]

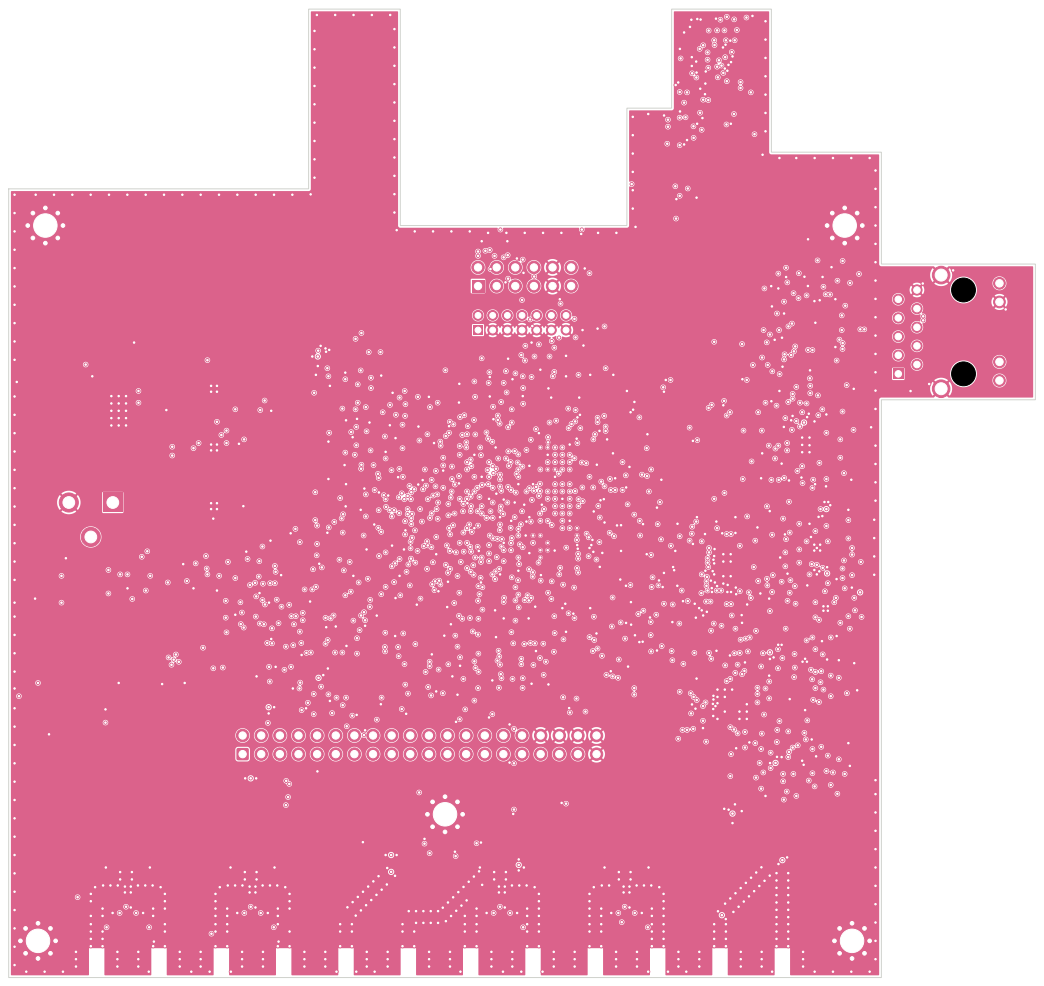
[picture p111: page 5]

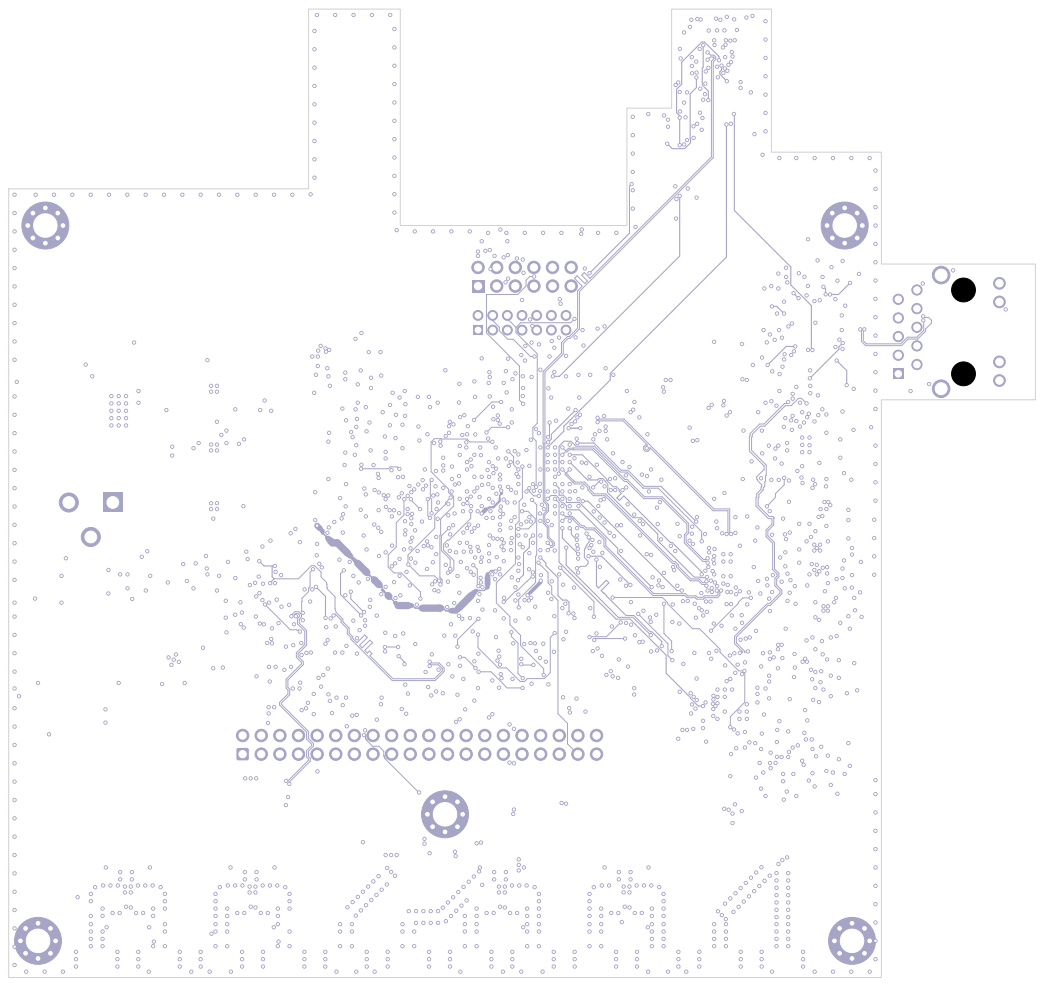
[picture p112: page 6]

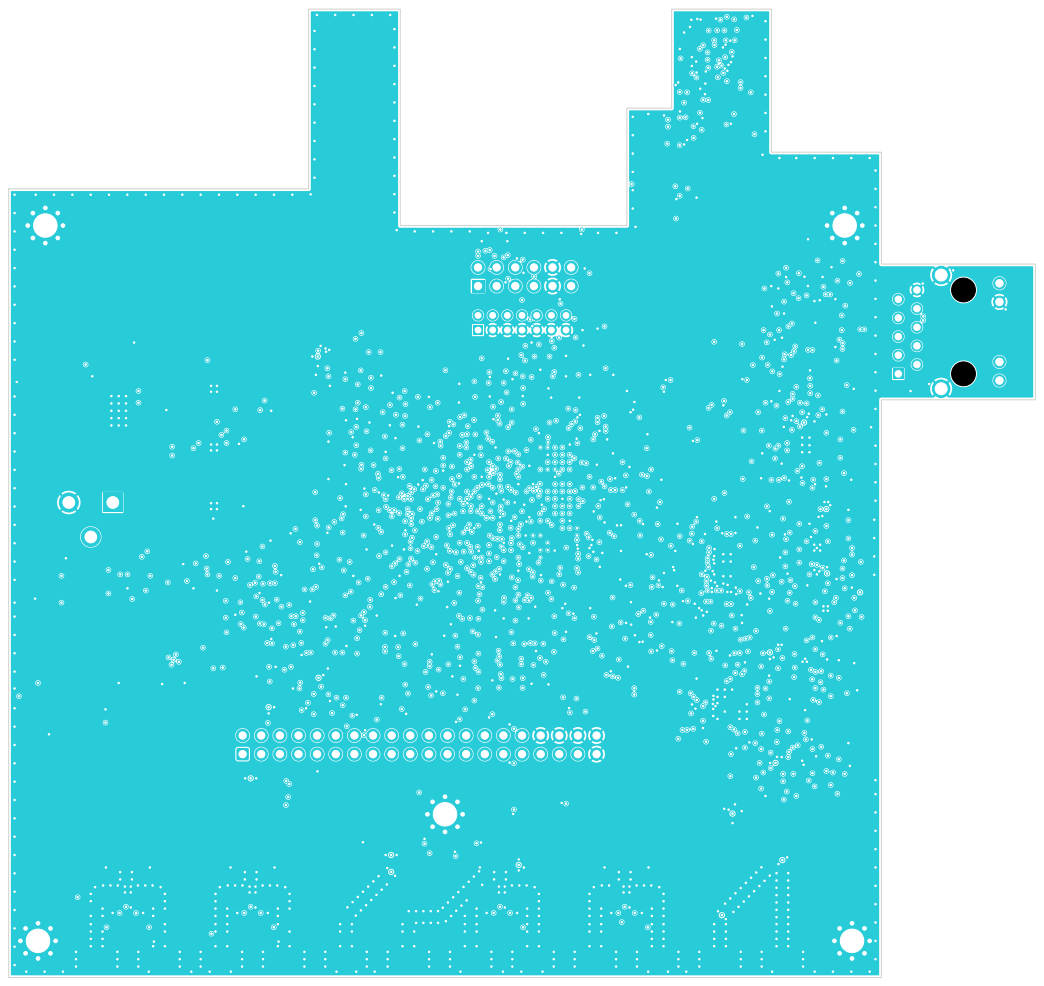
[picture p113: page 7]

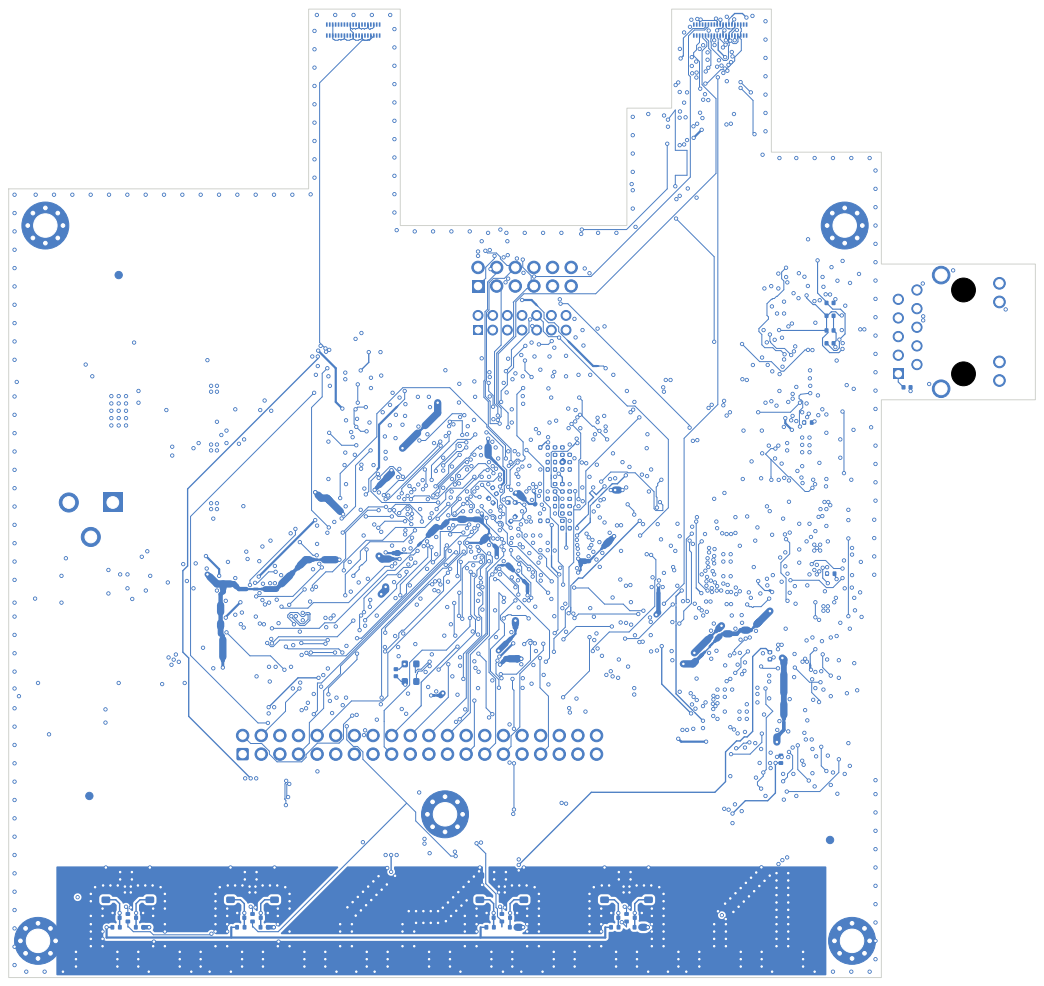
[picture p114: page 8]

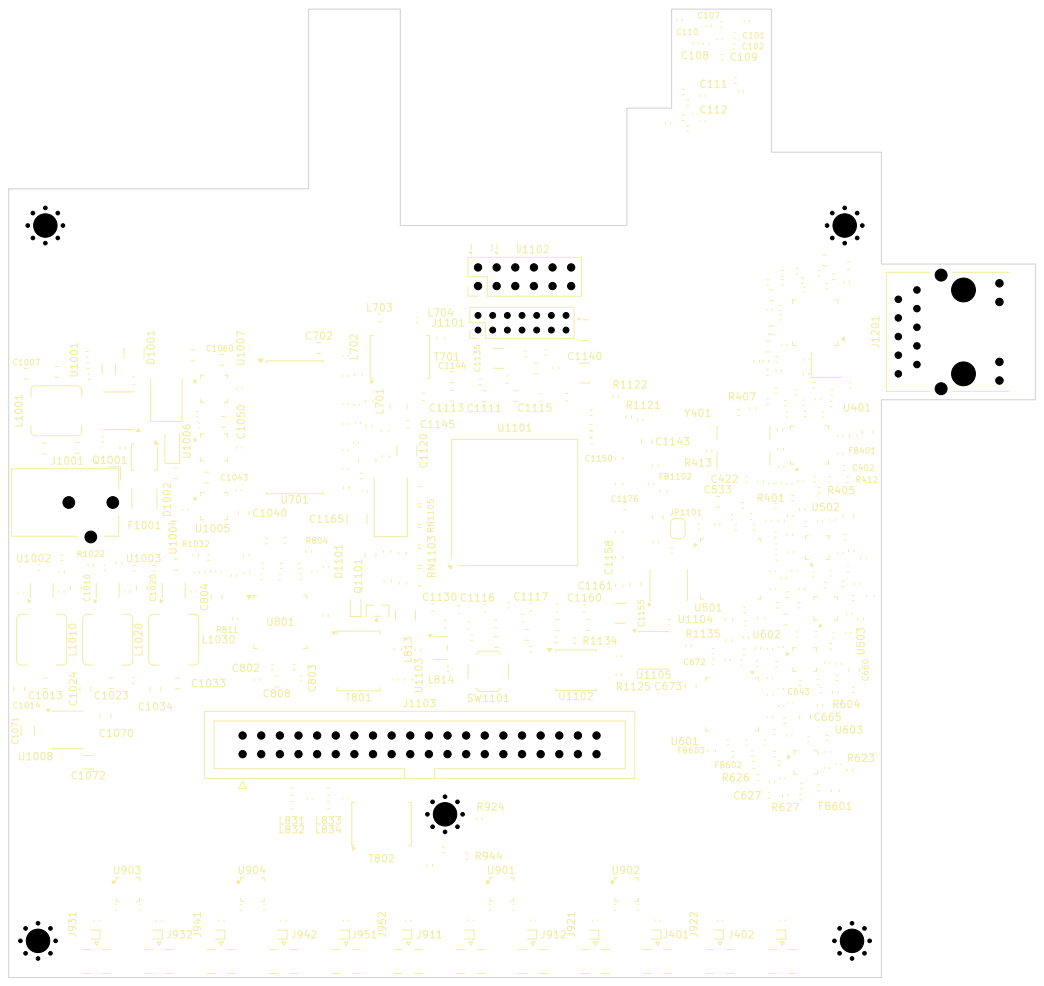
[picture p115: page 9]

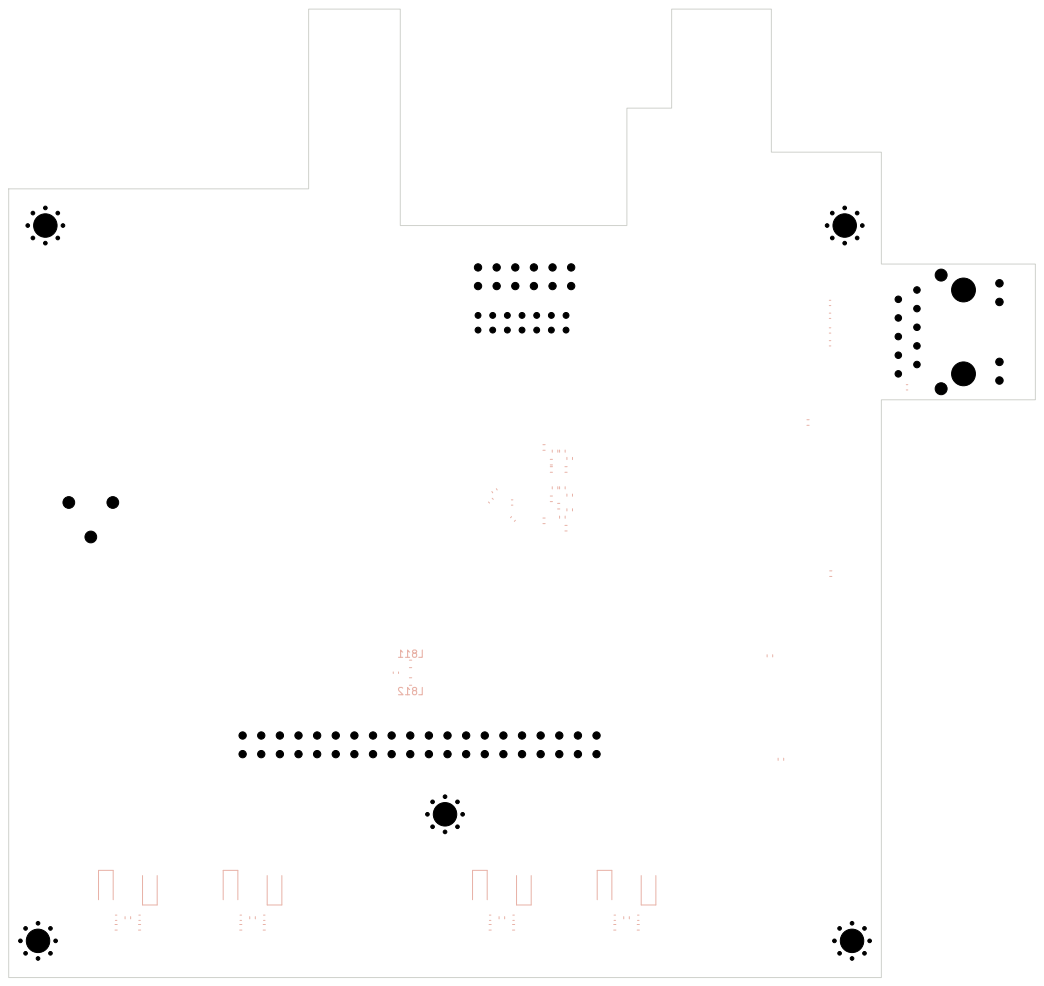
[picture p116: page 10]
