PabloSoage/kv260-ias2rf/(list of files, drawings)

Other design files:
PCB/CSI2-KRIA-KV260_Rev01-1.SchDoc
PCB/CSI2-KRIA-KV260_Rev01-2.SchDoc
PCB/CSI2-KRIA-KV260_Rev01.PcbDoc
PCB/CSI2-KRIA-KV260_Rev01.PrjPcb
