PabloSoage/kv260-ias2rf/CSI2-KRIA-KV260_Rev01.kicad_pcb

## KiCad design CSI2-KRIA-KV260_Rev01.kicad_pcb (2026-11-14)

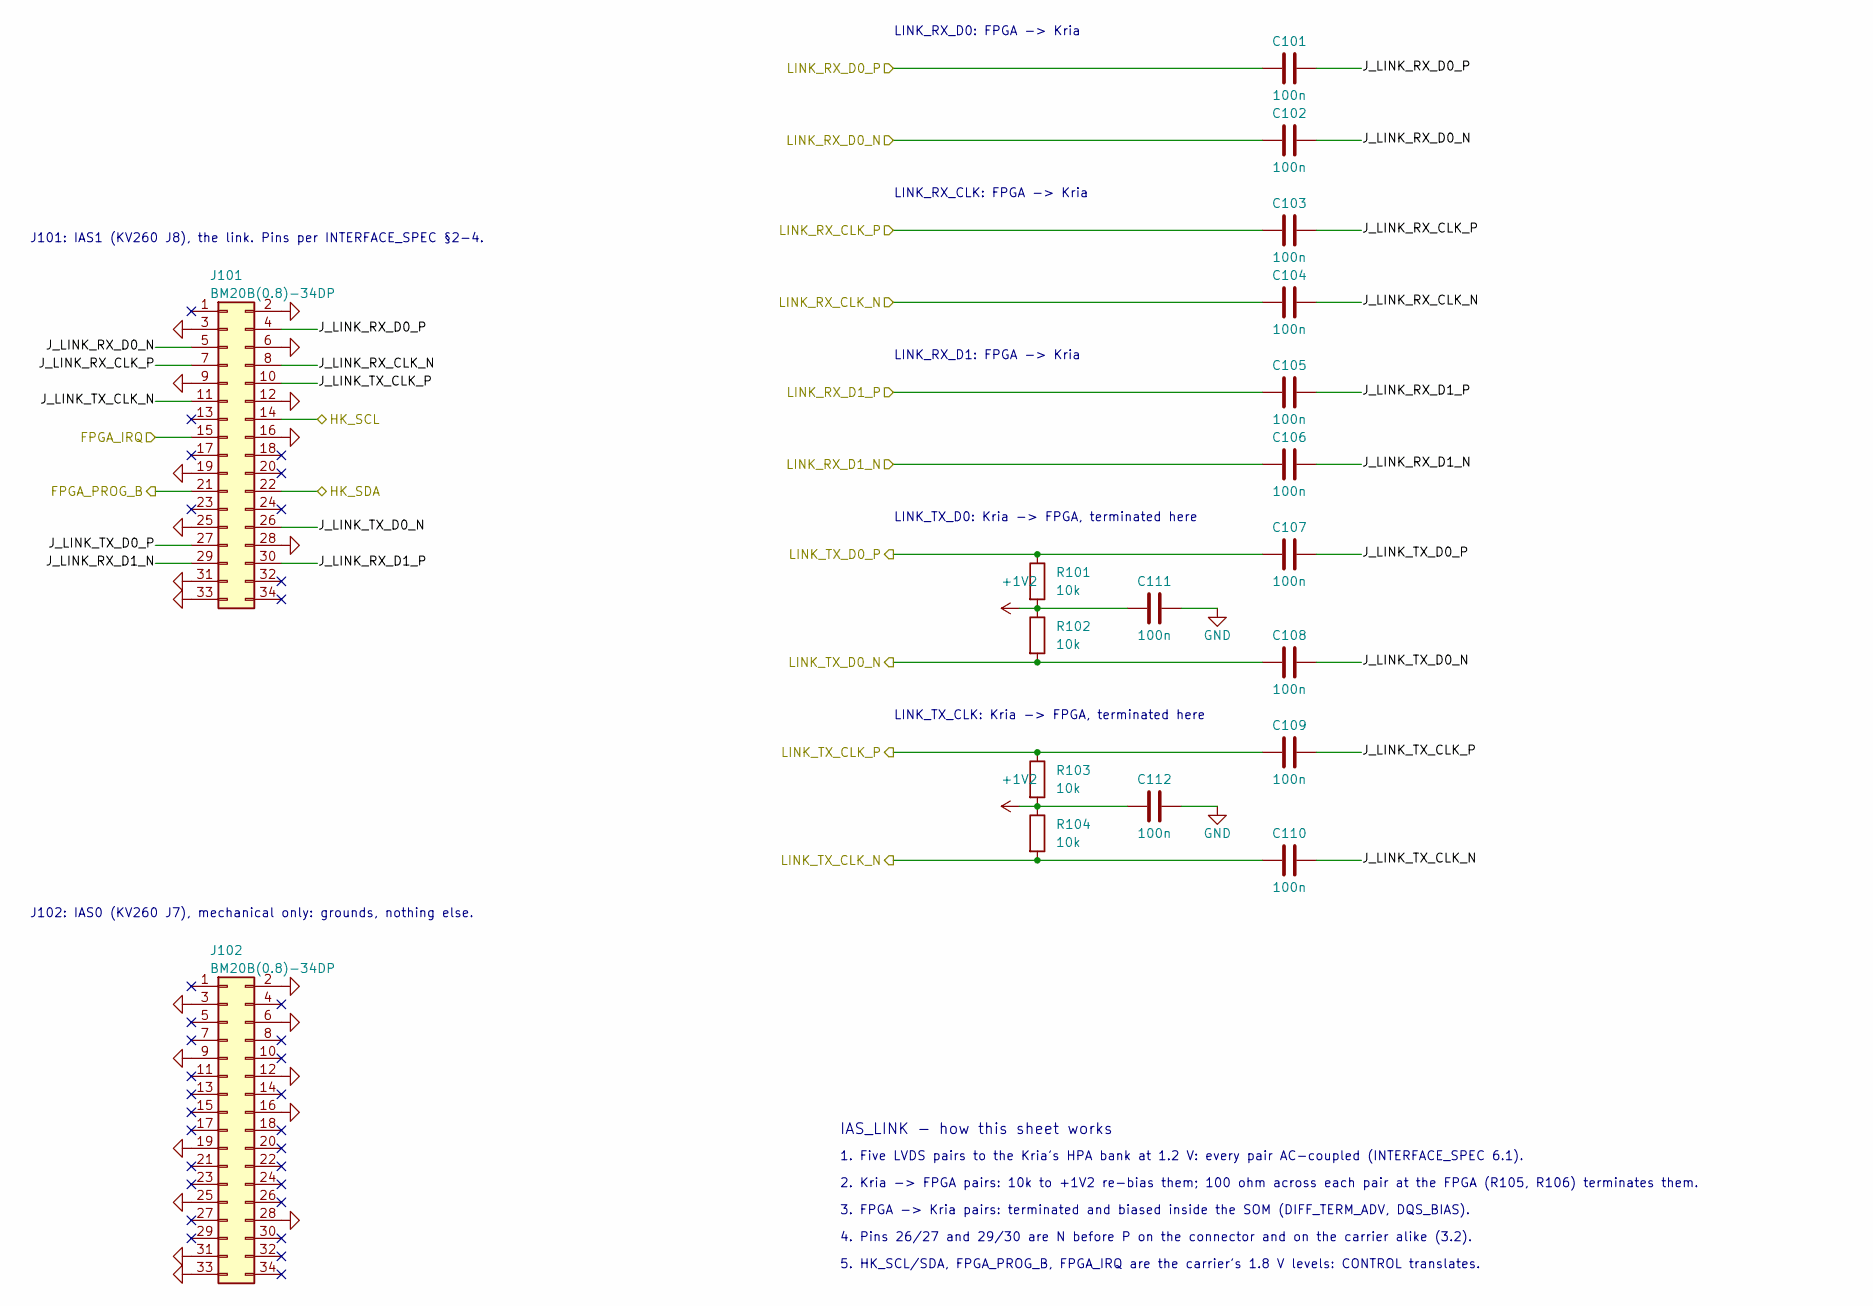
[picture p117: schematic IAS_LINK.kicad_sch, IAS_LINK - Hirose IAS1 link to the Kria, AC coupling, termi…]

Parts:
C101, C102, C103, C104, C105, C106, C107, C108, C109, C110, C111, C112: 100n; C_0402_1005Metric
J101, J102: BM20B(0.8)-34DP; J-BM20B(0.8)-34DP
R101, R102, R103, R104: 10k; R_0402_1005Metric

Connections:
+1V2: C111.1, C112.1, R101.2, R102.1, R103.2, R104.1; also elsewhere on the board
/FPGA_IRQ: J101.15; also elsewhere on the board
/FPGA_PROG_B: J101.21; also elsewhere on the board
/HK_SCL: J101.14; also elsewhere on the board
/HK_SDA: J101.22; also elsewhere on the board
/IAS_LINK/J_LINK_RX_CLK_N: C104.2, J101.8
/IAS_LINK/J_LINK_RX_CLK_P: C103.2, J101.7
/IAS_LINK/J_LINK_RX_D0_N: C102.2, J101.5
/IAS_LINK/J_LINK_RX_D0_P: C101.2, J101.4
/IAS_LINK/J_LINK_RX_D1_N: C106.2, J101.29
/IAS_LINK/J_LINK_RX_D1_P: C105.2, J101.30
/IAS_LINK/J_LINK_TX_CLK_N: C110.2, J101.11
/IAS_LINK/J_LINK_TX_CLK_P: C109.2, J101.10
/IAS_LINK/J_LINK_TX_D0_N: C108.2, J101.26
/IAS_LINK/J_LINK_TX_D0_P: C107.2, J101.27
/LINK_RX_CLK_N: C104.1; also elsewhere on the board
/LINK_RX_CLK_P: C103.1; also elsewhere on the board
/LINK_RX_D0_N: C102.1; also elsewhere on the board
/LINK_RX_D0_P: C101.1; also elsewhere on the board
/LINK_RX_D1_N: C106.1; also elsewhere on the board
/LINK_RX_D1_P: C105.1; also elsewhere on the board
/LINK_TX_CLK_N: C110.1, R104.2; also elsewhere on the board
/LINK_TX_CLK_P: C109.1, R103.1; also elsewhere on the board
/LINK_TX_D0_N: C108.1, R102.2; also elsewhere on the board
/LINK_TX_D0_P: C107.1, R101.1; also elsewhere on the board
GND: C111.2, C112.2, J101.2, J101.3, J101.6, J101.9, J101.12, J101.16, J101.19, J101.25, J101.28, J101.31, J101.33, J102.2, J102.3, J102.6, J102.9, J102.12, J102.16, J102.19, J102.25, J102.28, J102.31, J102.33; also elsewhere on the board

Notes on the sheet:
J101: IAS1 (KV260 J8), the link. Pins per INTERFACE_SPEC §2-4.
J102: IAS0 (KV260 J7), mechanical only: grounds, nothing else.
LINK_RX_D0: FPGA -> Kria
LINK_RX_CLK: FPGA -> Kria
LINK_RX_D1: FPGA -> Kria
LINK_TX_D0: Kria -> FPGA, terminated here
LINK_TX_CLK: Kria -> FPGA, terminated here
IAS_LINK - how this sheet works
1. Five LVDS pairs to the Kria's HPA bank at 1.2 V: every pair AC-coupled (INTERFACE_SPEC 6.1).
2. Kria -> FPGA pairs: 10k to +1V2 re-bias them; 100 ohm across each pair at the FPGA (R105, R106) terminates them.
3. FPGA -> Kria pairs: terminated and biased inside the SOM (DIFF_TERM_ADV, DQS_BIAS).
4. Pins 26/27 and 29/30 are N before P on the connector and on the carrier alike (3.2).
5. HK_SCL/SDA, FPGA_PROG_B, FPGA_IRQ are the carrier's 1.8 V levels: CONTROL translates.
