PabloSoage/kv260-ias2rf/CSI2-KRIA-KV260_Rev01.kicad_pcb

## KiCad design CSI2-KRIA-KV260_Rev01.kicad_pcb (continued)

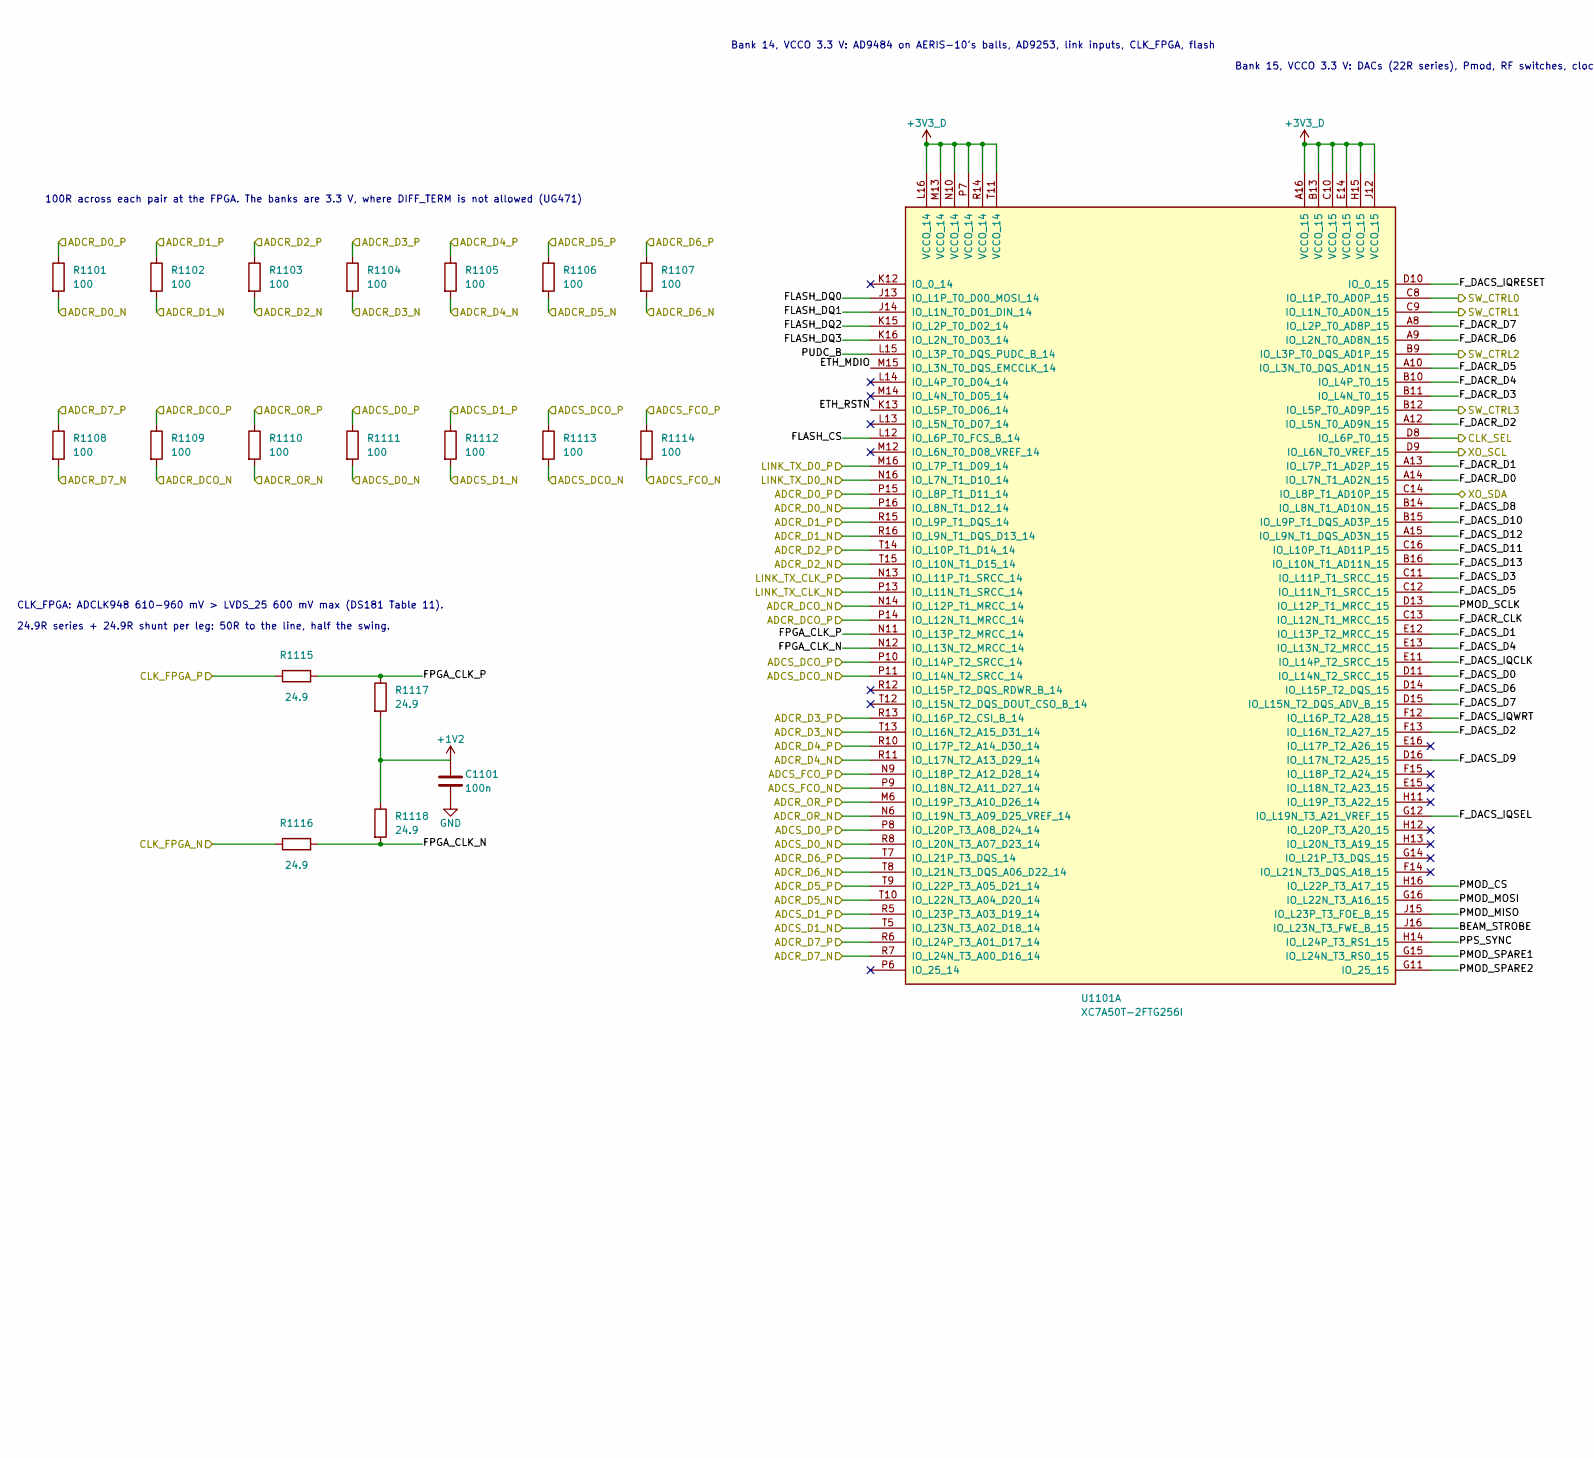
[picture p118: schematic CONTROL.kicad_sch, CONTROL - XC7A50T front-end FPGA, configuration, Pmod, AERI…, part in row 1, column 1]

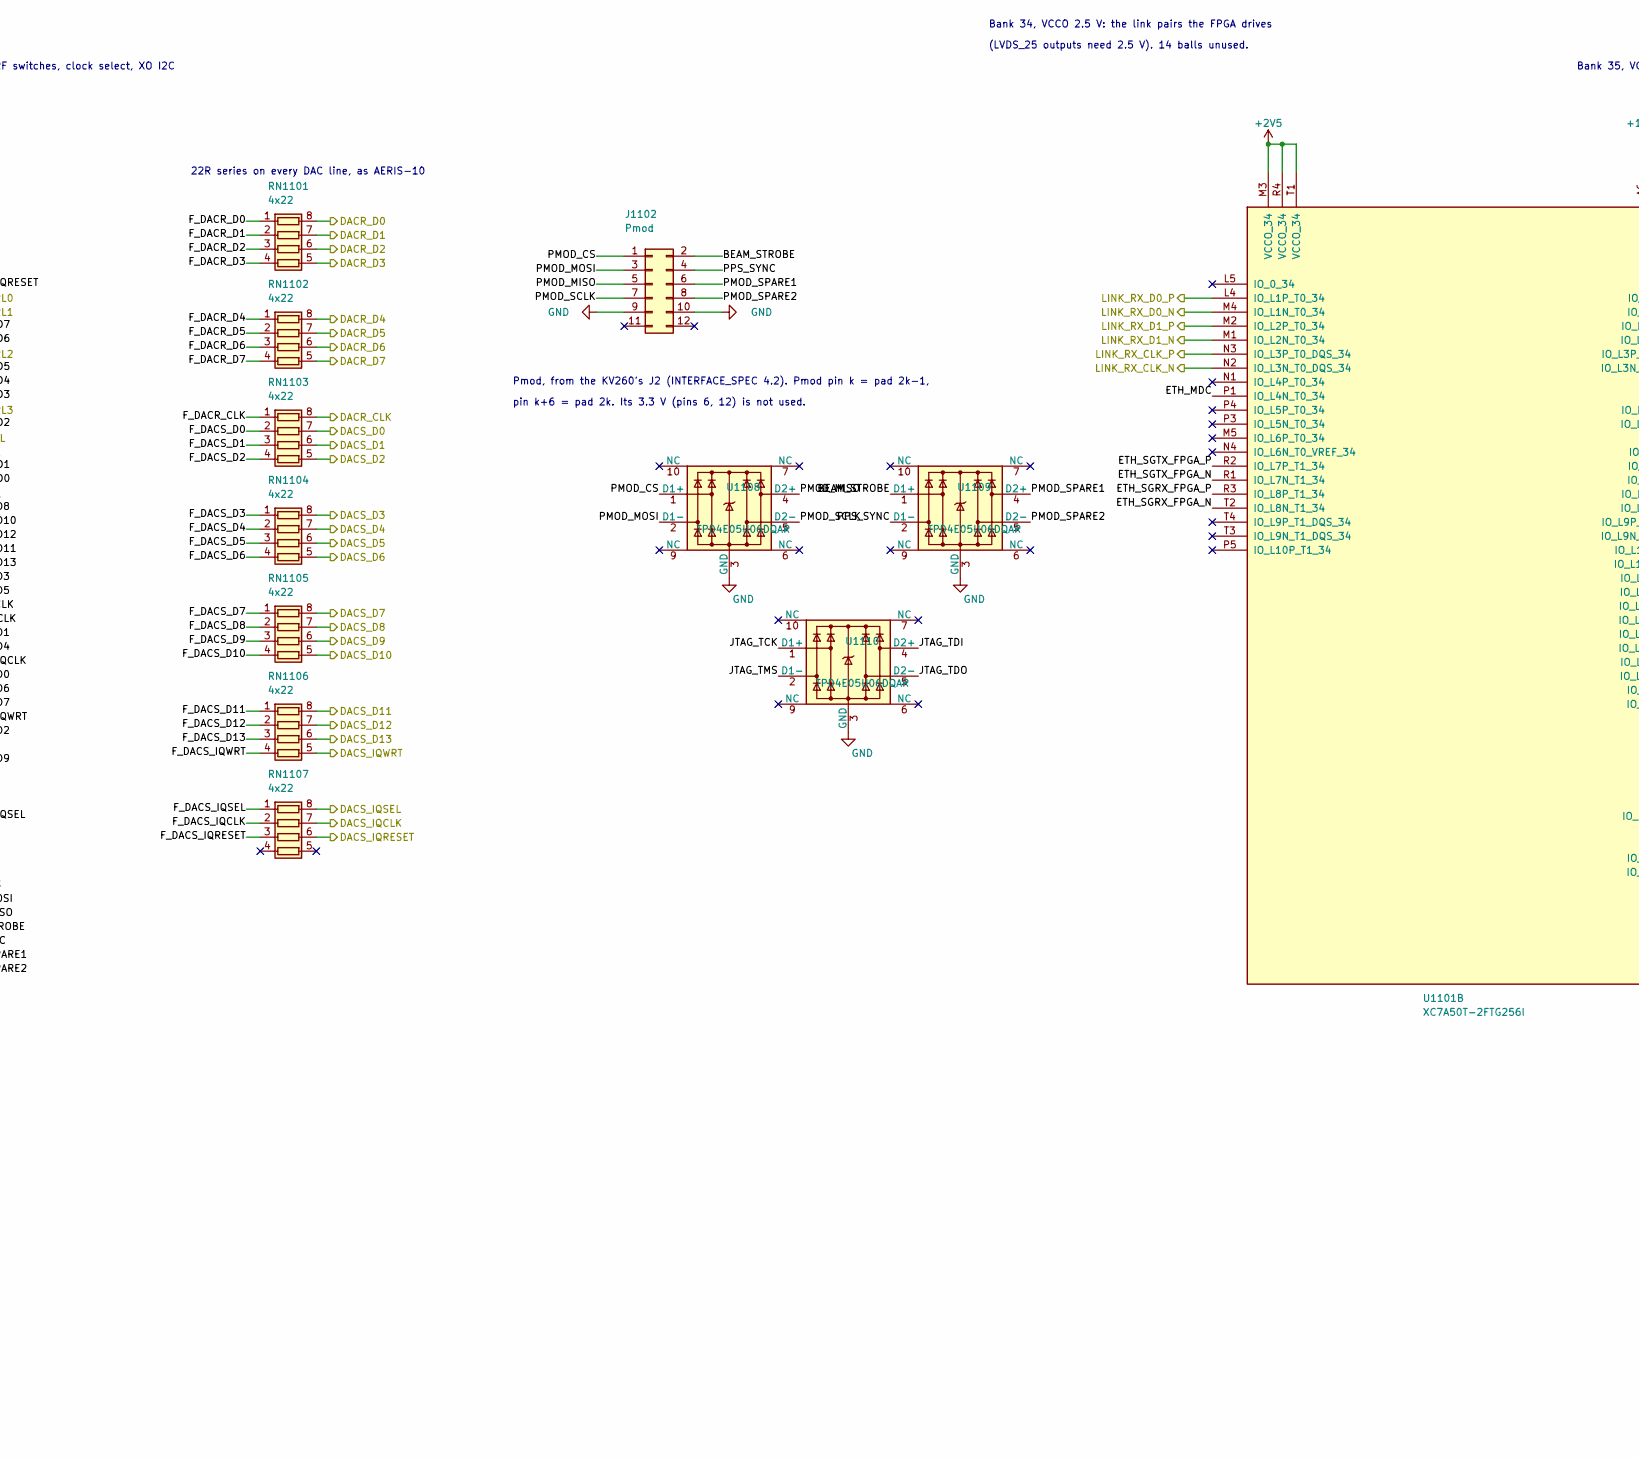
[picture p119: schematic CONTROL.kicad_sch, CONTROL - XC7A50T front-end FPGA, configuration, Pmod, AERI…, part in row 1, column 2]

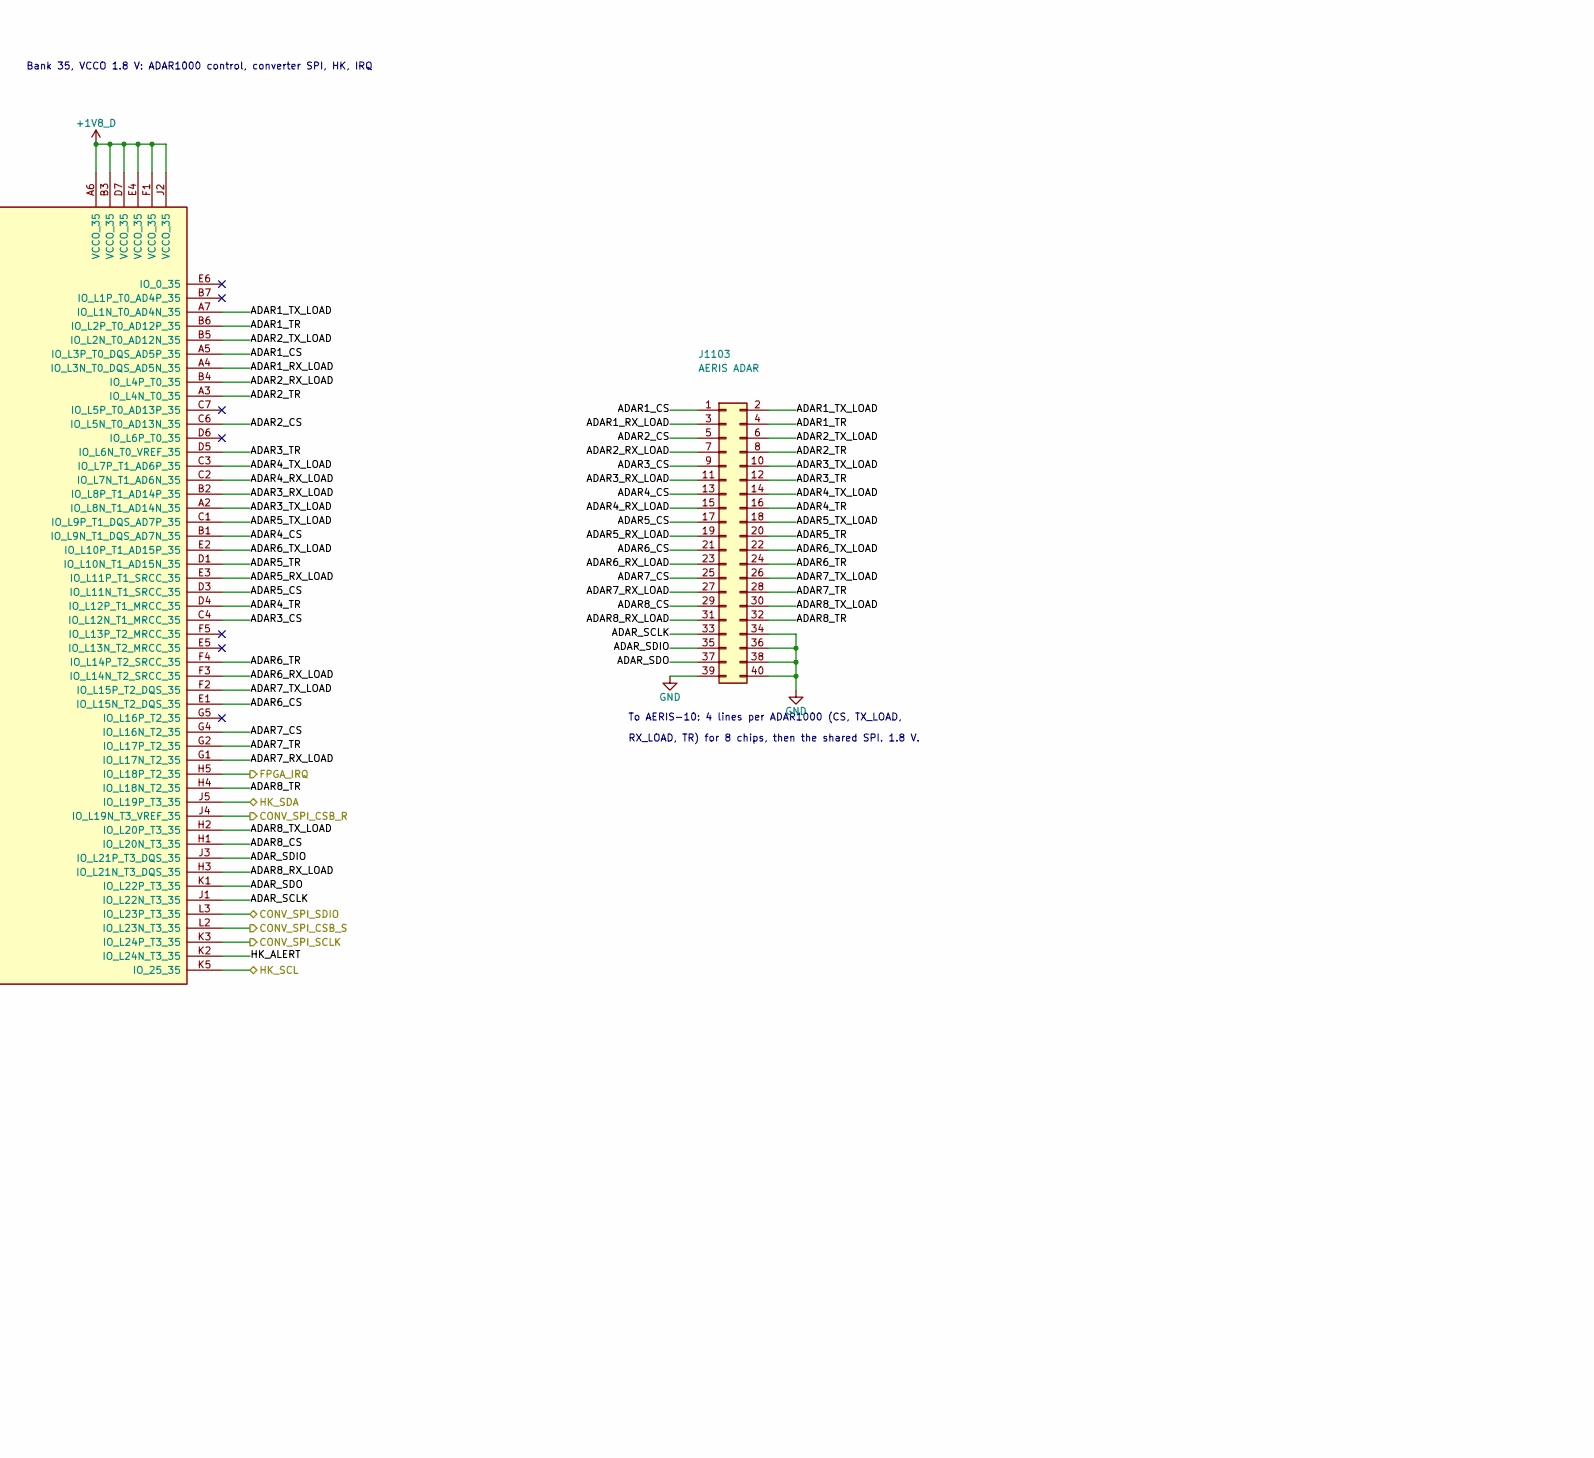
[picture p120: schematic CONTROL.kicad_sch, CONTROL - XC7A50T front-end FPGA, configuration, Pmod, AERI…, part in row 1, column 3]

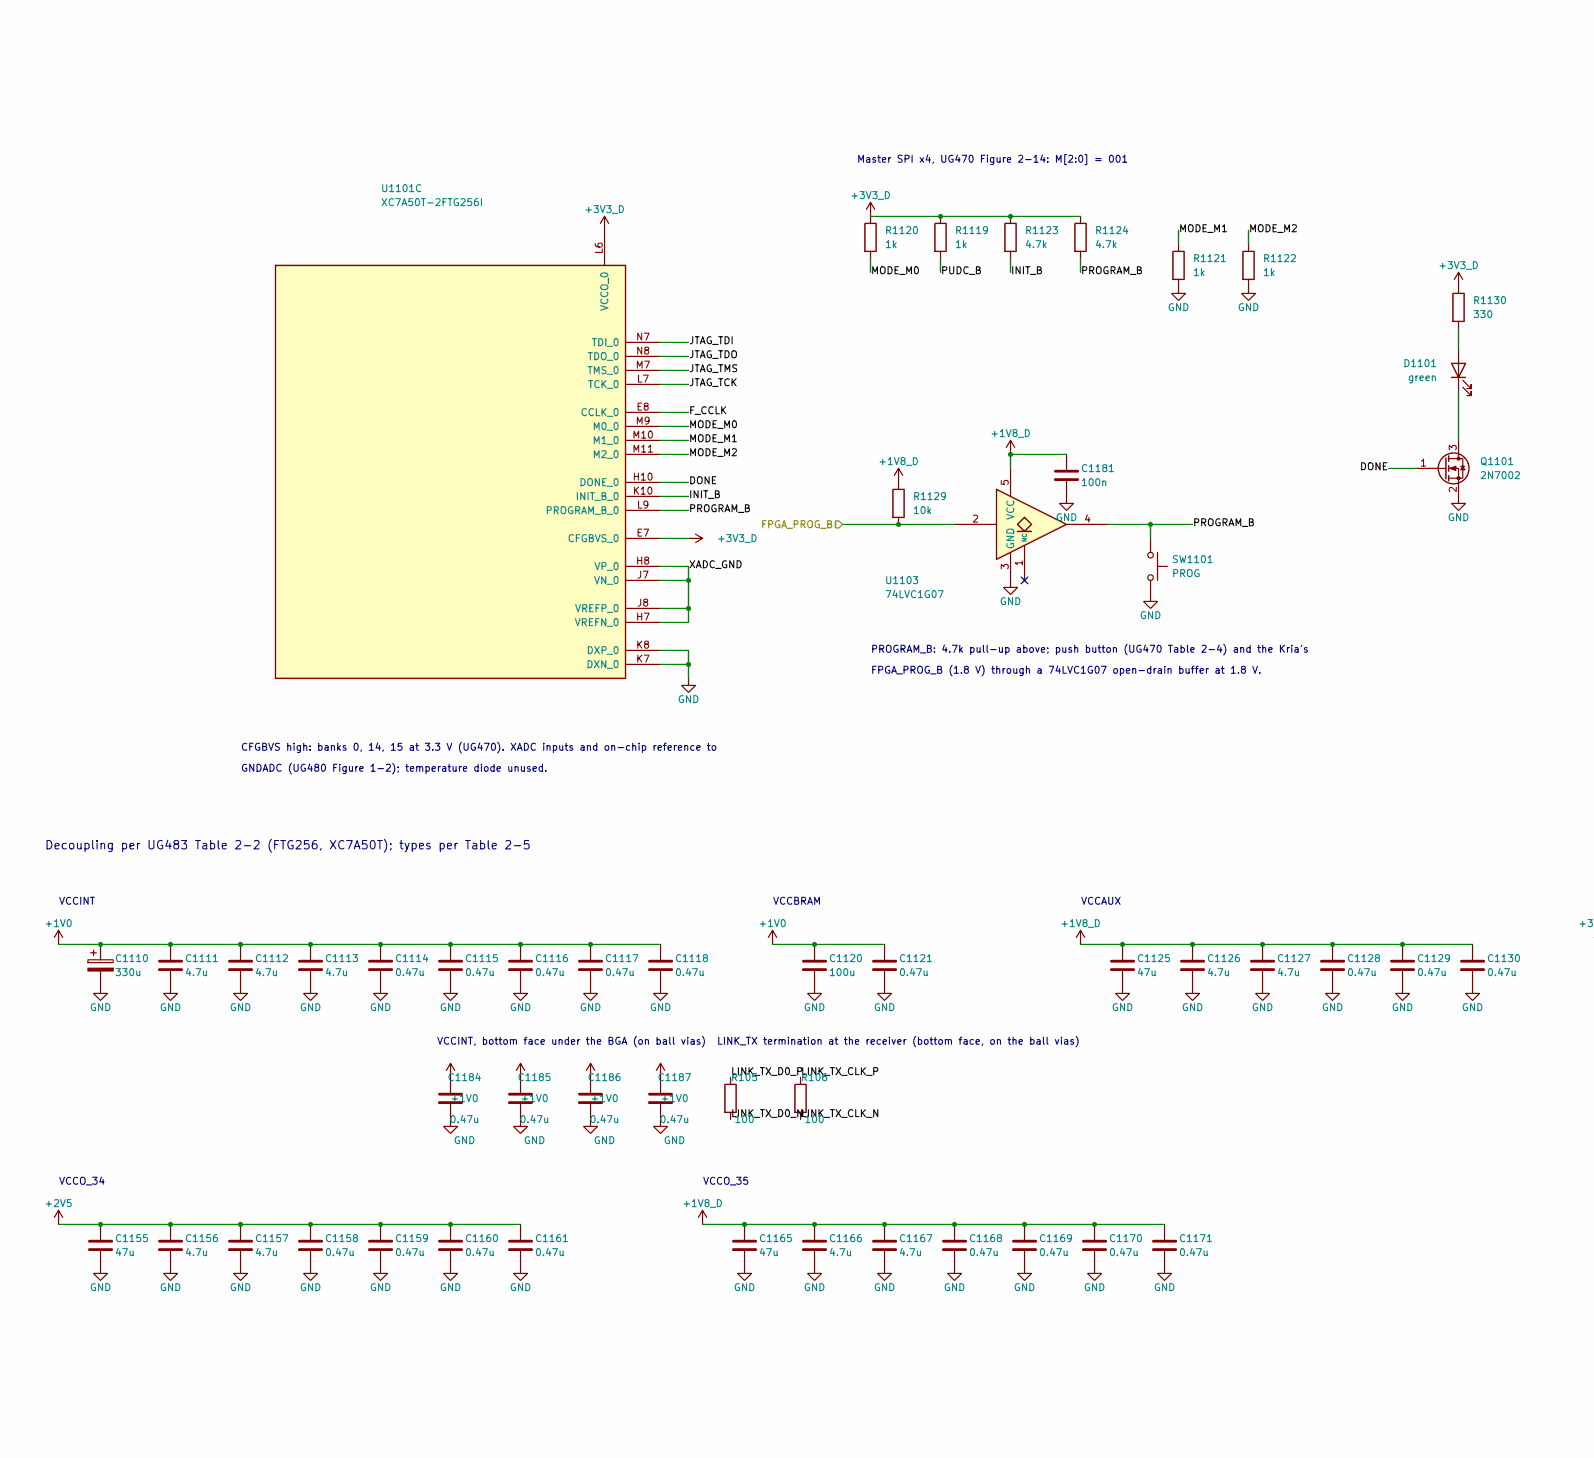
[picture p121: schematic CONTROL.kicad_sch, CONTROL - XC7A50T front-end FPGA, configuration, Pmod, AERI…, part in row 2, column 1]

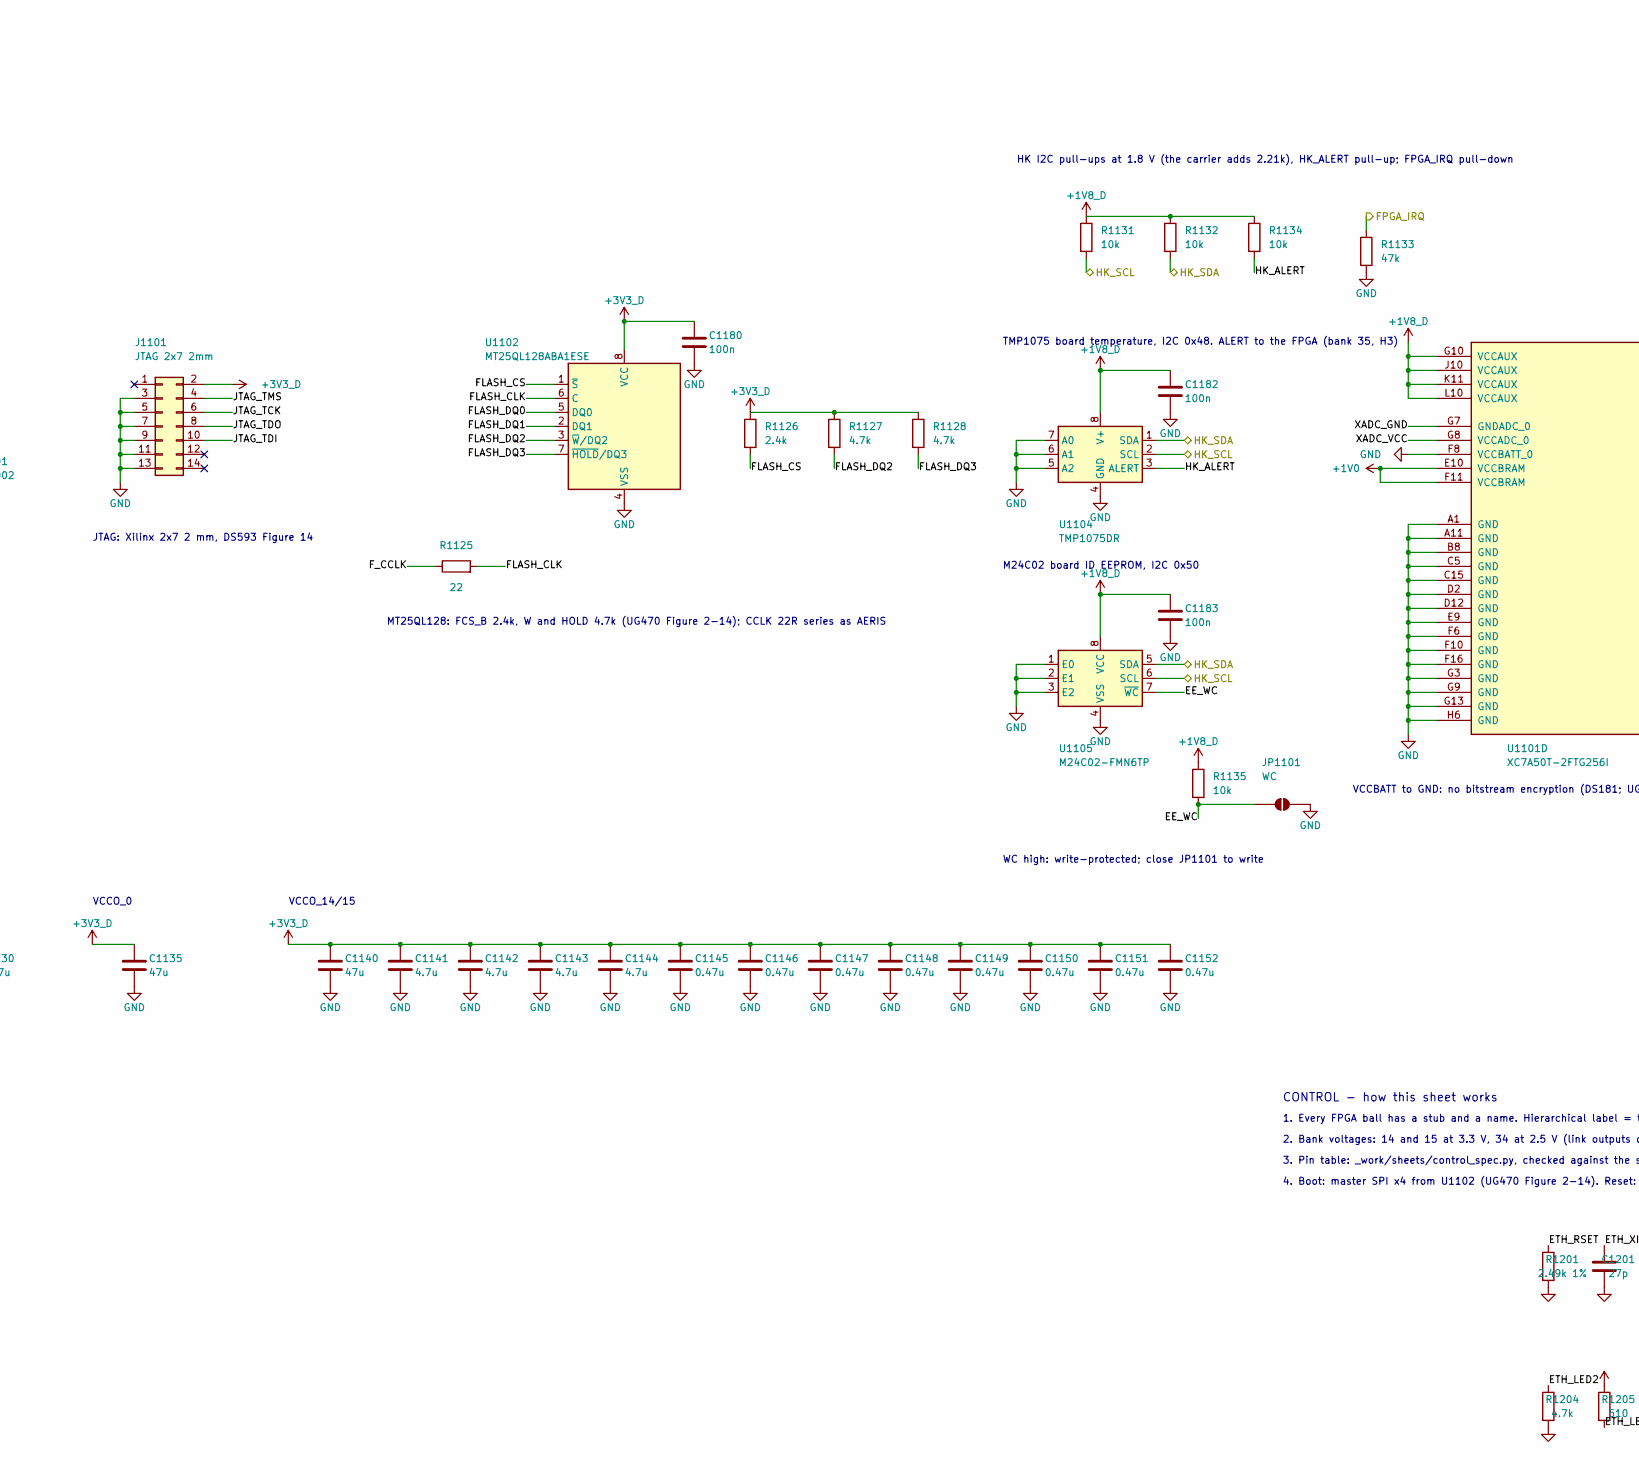
[picture p122: schematic CONTROL.kicad_sch, CONTROL - XC7A50T front-end FPGA, configuration, Pmod, AERI…, part in row 2, column 2]

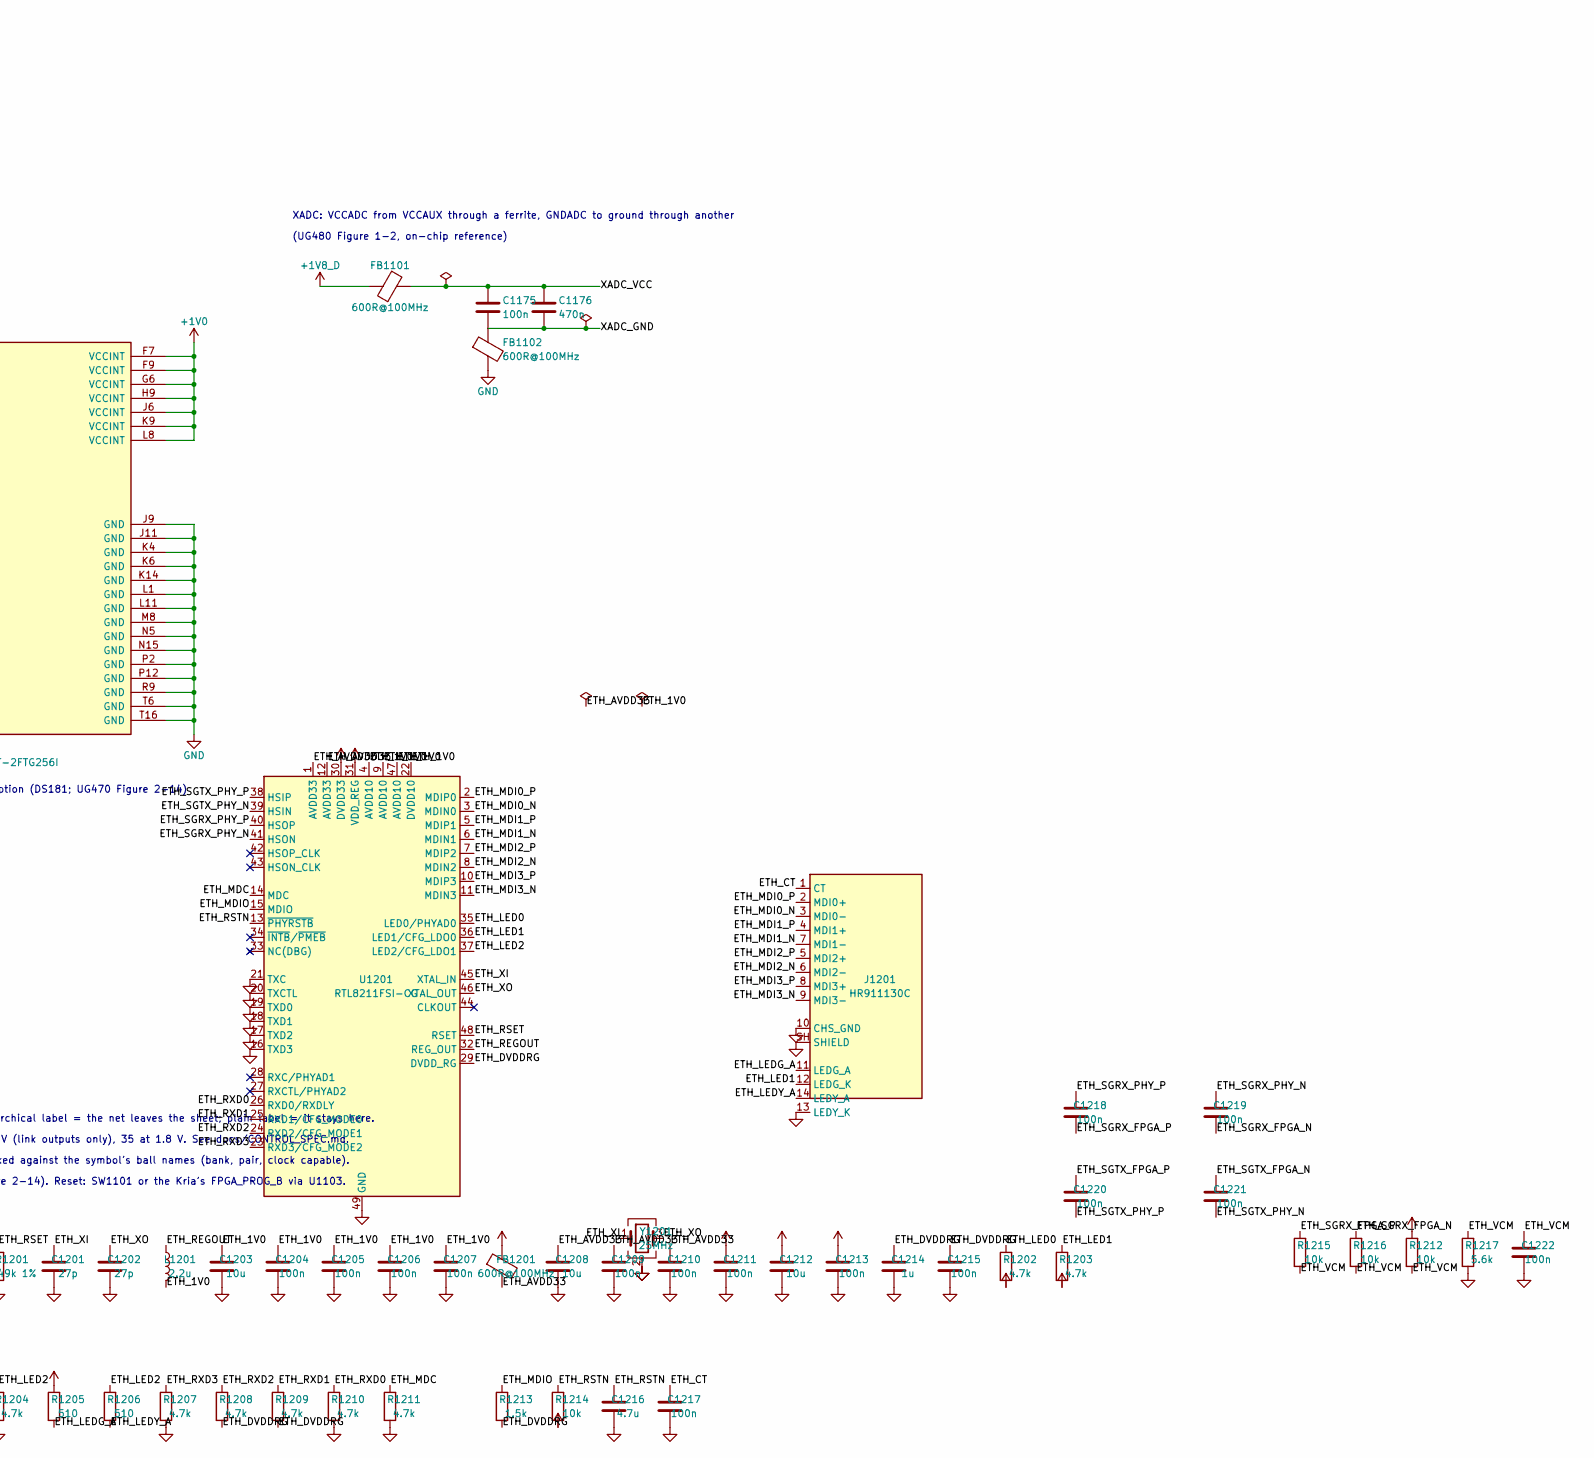
[picture p123: schematic CONTROL.kicad_sch, CONTROL - XC7A50T front-end FPGA, configuration, Pmod, AERI…, part in row 2, column 3]

Parts:
C1101, C1175, C1180, C1181, C1182, C1183, C1204, C1205, C1206, C1207, C1209, C1210, C1211, C1213, C1215, C1217, C1218, C1219, C1220, C1221, C1222: 100n; C_0402_1005Metric
C1110: 330u; CP_EIA-7343-20_Kemet-V
C1111, C1112, C1113, C1126, C1127, C1141, C1142, C1143, C1144, C1156, C1157, C1166, C1167: 4.7u; C_0805_2012Metric
C1114, C1115, C1116, C1117, C1118, C1121, C1128, C1129, C1130, C1145, C1146, C1147, C1148, C1149, C1150, C1151, C1152, C1158, C1159, C1160, C1161, C1168, C1169, C1170, C1171: 0.47u; C_0603_1608Metric
C1120: 100u; C_1210_3225Metric
C1125, C1135, C1140, C1155, C1165: 47u; C_1210_3225Metric
C1176: 470n; C_0603_1608Metric
C1184, C1185, C1186, C1187: 0.47u; C_0402_1005Metric
C1201, C1202: 27p; C_0402_1005Metric
C1203, C1208, C1212: 10u; C_0805_2012Metric
C1214: 1u; C_0402_1005Metric
C1216: 4.7u; C_0402_1005Metric
D1101: green; LED_0603_1608Metric
FB1101, FB1102, FB1201: 600R@100MHz; L_0603_1608Metric
J1101: JTAG 2x7 2mm; PinHeader_2x07_P2.00mm_Vertical
J1102: Pmod; PinHeader_2x06_P2.54mm_Vertical
J1103: AERIS ADAR; IDC-Header_2x20_P2.54mm_Vertical
J1201: HR911130C; RJ45_Hanrun_HR911130C
JP1101: WC; SolderJumper-2_P1.3mm_Open_RoundedPad1.0x1.5mm
L1201: 2.2u; L_0805_2012Metric
Q1101: 2N7002; SOT-23
R105, R106, R1101, R1102, R1103, R1104, R1105, R1106, R1107, R1108, R1109, R1110, R1111, R1112, R1113, R1114: 100; R_0402_1005Metric
R1115, R1116, R1117, R1118: 24.9; R_0402_1005Metric
R1119, R1120, R1121, R1122: 1k; R_0402_1005Metric
R1123, R1124, R1127, R1128, R1202, R1203, R1204, R1207, R1208, R1209, R1210, R1211: 4.7k; R_0402_1005Metric
R1125: 22; R_0402_1005Metric
R1126: 2.4k; R_0402_1005Metric
R1129, R1131, R1132, R1134, R1135, R1212, R1214, R1215, R1216: 10k; R_0402_1005Metric
R1130: 330; R_0402_1005Metric
R1133: 47k; R_0402_1005Metric
R1201: 2.49k 1%; R_0402_1005Metric
R1205, R1206: 510; R_0402_1005Metric
R1213: 1.5k; R_0402_1005Metric
R1217: 5.6k; R_0402_1005Metric
RN1101, RN1102, RN1103, RN1104, RN1105, RN1106, RN1107: 4x22; R_Array_Convex_4x0402
SW1101: PROG; SW_SPST_TL3342
U1101: XC7A50T-2FTG256I; Xilinx_FTG256
U1102: MT25QL128ABA1ESE; SOIC-8_5.3x5.3mm_P1.27mm
U1103: 74LVC1G07; SOT-23-5
U1104: TMP1075DR; SOIC-8_3.9x4.9mm_P1.27mm
U1105: M24C02-FMN6TP; SOIC-8_3.9x4.9mm_P1.27mm
U1108, U1109, U1110: TPD4E05U06DQAR; USON-10_2.5x1.0mm_P0.5mm
U1201: RTL8211FSI-CG; QFN-48-1EP_6x6mm_P0.4mm_EP4.4x4.4mm
Y1201: 25MHz; Crystal_SMD_3225-4Pin_3.2x2.5mm

Connections:
+1V0: C1110.1, C1111.1, C1112.1, C1113.1, C1114.1, C1115.1, C1116.1, C1117.1, C1118.1, C1120.1, C1121.1, C1184.1, C1185.1, C1186.1, C1187.1, U1101.E10 (VCCBRAM), U1101.F7 (VCCINT), U1101.F9 (VCCINT), U1101.F11 (VCCBRAM), U1101.G6 (VCCINT), U1101.H9 (VCCINT), U1101.J6 (VCCINT), U1101.K9 (VCCINT), U1101.L8 (VCCINT); also elsewhere on the board
+1V2: C1101.1, R1117.2, R1118.1; also elsewhere on the board
+1V8_D: C1125.1, C1126.1, C1127.1, C1128.1, C1129.1, C1130.1, C1165.1, C1166.1, C1167.1, C1168.1, C1169.1, C1170.1, C1171.1, C1181.1, C1182.1, C1183.1, FB1101.1, R1129.1, R1131.1, R1132.1, R1134.1, R1135.1, U1101.A6 (VCCO_35), U1101.B3 (VCCO_35), U1101.D7 (VCCO_35), U1101.E4 (VCCO_35), U1101.F1 (VCCO_35), U1101.G10 (VCCAUX), U1101.J2 (VCCO_35), U1101.J10 (VCCAUX), U1101.K11 (VCCAUX), U1101.L10 (VCCAUX), U1103.5 (VCC), U1104.8 (V+), U1105.8 (VCC); also elsewhere on the board
+2V5: C1155.1, C1156.1, C1157.1, C1158.1, C1159.1, C1160.1, C1161.1, U1101.M3 (VCCO_34), U1101.R4 (VCCO_34), U1101.T1 (VCCO_34); also elsewhere on the board
+3V3_D: C1135.1, C1140.1, C1141.1, C1142.1, C1143.1, C1144.1, C1145.1, C1146.1, C1147.1, C1148.1, C1149.1, C1150.1, C1151.1, C1152.1, C1180.1, C1211.1, C1212.1, C1213.1, FB1201.1, J1101.2, R1119.1, R1120.1, R1123.1, R1124.1, R1126.1, R1127.1, R1128.1, R1130.1, R1202.2, R1203.2, R1205.1, R1212.1, R1214.2, U1101.A16 (VCCO_15), U1101.B13 (VCCO_15), U1101.C10 (VCCO_15), U1101.E7 (CFGBVS_0), U1101.E14 (VCCO_15), U1101.H15 (VCCO_15), U1101.J12 (VCCO_15), U1101.L6 (VCCO_0), U1101.L16 (VCCO_14), U1101.M13 (VCCO_14), U1101.N10 (VCCO_14), U1101.P7 (VCCO_14), U1101.R14 (VCCO_14), U1101.T11 (VCCO_14), U1102.8 (VCC), U1201.30 (DVDD33), U1201.31 (VDD_REG); also elsewhere on the board
/ADCR_D0_N: R1101.2, U1101.P16 (IO_L8N_T1_D12_14); also elsewhere on the board
/ADCR_D0_P: R1101.1, U1101.P15 (IO_L8P_T1_D11_14); also elsewhere on the board
/ADCR_D1_N: R1102.2, U1101.R16 (IO_L9N_T1_DQS_D13_14); also elsewhere on the board
/ADCR_D1_P: R1102.1, U1101.R15 (IO_L9P_T1_DQS_14); also elsewhere on the board
/ADCR_D2_N: R1103.2, U1101.T15 (IO_L10N_T1_D15_14); also elsewhere on the board
/ADCR_D2_P: R1103.1, U1101.T14 (IO_L10P_T1_D14_14); also elsewhere on the board
/ADCR_D3_N: R1104.2, U1101.T13 (IO_L16N_T2_A15_D31_14); also elsewhere on the board
/ADCR_D3_P: R1104.1, U1101.R13 (IO_L16P_T2_CSI_B_14); also elsewhere on the board
/ADCR_D4_N: R1105.2, U1101.R11 (IO_L17N_T2_A13_D29_14); also elsewhere on the board
/ADCR_D4_P: R1105.1, U1101.R10 (IO_L17P_T2_A14_D30_14); also elsewhere on the board
/ADCR_D5_N: R1106.2, U1101.T10 (IO_L22N_T3_A04_D20_14); also elsewhere on the board
/ADCR_D5_P: R1106.1, U1101.T9 (IO_L22P_T3_A05_D21_14); also elsewhere on the board
/ADCR_D6_N: R1107.2, U1101.T8 (IO_L21N_T3_DQS_A06_D22_14); also elsewhere on the board
/ADCR_D6_P: R1107.1, U1101.T7 (IO_L21P_T3_DQS_14); also elsewhere on the board
/ADCR_D7_N: R1108.2, U1101.R7 (IO_L24N_T3_A00_D16_14); also elsewhere on the board
/ADCR_D7_P: R1108.1, U1101.R6 (IO_L24P_T3_A01_D17_14); also elsewhere on the board
/ADCR_DCO_N: R1109.2, U1101.N14 (IO_L12P_T1_MRCC_14); also elsewhere on the board
/ADCR_DCO_P: R1109.1, U1101.P14 (IO_L12N_T1_MRCC_14); also elsewhere on the board
/ADCR_OR_N: R1110.2, U1101.N6 (IO_L19N_T3_A09_D25_VREF_14); also elsewhere on the board
/ADCR_OR_P: R1110.1, U1101.M6 (IO_L19P_T3_A10_D26_14); also elsewhere on the board
/ADCS_D0_N: R1111.2, U1101.R8 (IO_L20N_T3_A07_D23_14); also elsewhere on the board
/ADCS_D0_P: R1111.1, U1101.P8 (IO_L20P_T3_A08_D24_14); also elsewhere on the board
/ADCS_D1_N: R1112.2, U1101.T5 (IO_L23N_T3_A02_D18_14); also elsewhere on the board
/ADCS_D1_P: R1112.1, U1101.R5 (IO_L23P_T3_A03_D19_14); also elsewhere on the board
/ADCS_DCO_N: R1113.2, U1101.P11 (IO_L14N_T2_SRCC_14); also elsewhere on the board
/ADCS_DCO_P: R1113.1, U1101.P10 (IO_L14P_T2_SRCC_14); also elsewhere on the board
/ADCS_FCO_N: R1114.2, U1101.P9 (IO_L18N_T2_A11_D27_14); also elsewhere on the board
/ADCS_FCO_P: R1114.1, U1101.N9 (IO_L18P_T2_A12_D28_14); also elsewhere on the board
/CLK_FPGA_N: R1116.1; also elsewhere on the board
/CLK_FPGA_P: R1115.1; also elsewhere on the board
/CLK_SEL: U1101.D8 (IO_L6P_T0_15); also elsewhere on the board
/CONTROL/ADAR1_CS: J1103.1, U1101.A5 (IO_L3P_T0_DQS_AD5P_35)
/CONTROL/ADAR1_RX_LOAD: J1103.3, U1101.A4 (IO_L3N_T0_DQS_AD5N_35)
/CONTROL/ADAR1_TR: J1103.4, U1101.B6 (IO_L2P_T0_AD12P_35)
/CONTROL/ADAR1_TX_LOAD: J1103.2, U1101.A7 (IO_L1N_T0_AD4N_35)
/CONTROL/ADAR2_CS: J1103.5, U1101.C6 (IO_L5N_T0_AD13N_35)
/CONTROL/ADAR2_RX_LOAD: J1103.7, U1101.B4 (IO_L4P_T0_35)
/CONTROL/ADAR2_TR: J1103.8, U1101.A3 (IO_L4N_T0_35)
/CONTROL/ADAR2_TX_LOAD: J1103.6, U1101.B5 (IO_L2N_T0_AD12N_35)
/CONTROL/ADAR3_CS: J1103.9, U1101.C4 (IO_L12N_T1_MRCC_35)
/CONTROL/ADAR3_RX_LOAD: J1103.11, U1101.B2 (IO_L8P_T1_AD14P_35)
/CONTROL/ADAR3_TR: J1103.12, U1101.D5 (IO_L6N_T0_VREF_35)
/CONTROL/ADAR3_TX_LOAD: J1103.10, U1101.A2 (IO_L8N_T1_AD14N_35)
/CONTROL/ADAR4_CS: J1103.13, U1101.B1 (IO_L9N_T1_DQS_AD7N_35)
/CONTROL/ADAR4_RX_LOAD: J1103.15, U1101.C2 (IO_L7N_T1_AD6N_35)
/CONTROL/ADAR4_TR: J1103.16, U1101.D4 (IO_L12P_T1_MRCC_35)
/CONTROL/ADAR4_TX_LOAD: J1103.14, U1101.C3 (IO_L7P_T1_AD6P_35)
/CONTROL/ADAR5_CS: J1103.17, U1101.D3 (IO_L11N_T1_SRCC_35)
/CONTROL/ADAR5_RX_LOAD: J1103.19, U1101.E3 (IO_L11P_T1_SRCC_35)
/CONTROL/ADAR5_TR: J1103.20, U1101.D1 (IO_L10N_T1_AD15N_35)
/CONTROL/ADAR5_TX_LOAD: J1103.18, U1101.C1 (IO_L9P_T1_DQS_AD7P_35)
/CONTROL/ADAR6_CS: J1103.21, U1101.E1 (IO_L15N_T2_DQS_35)
/CONTROL/ADAR6_RX_LOAD: J1103.23, U1101.F3 (IO_L14N_T2_SRCC_35)
/CONTROL/ADAR6_TR: J1103.24, U1101.F4 (IO_L14P_T2_SRCC_35)
/CONTROL/ADAR6_TX_LOAD: J1103.22, U1101.E2 (IO_L10P_T1_AD15P_35)
/CONTROL/ADAR7_CS: J1103.25, U1101.G4 (IO_L16N_T2_35)
/CONTROL/ADAR7_RX_LOAD: J1103.27, U1101.G1 (IO_L17N_T2_35)
/CONTROL/ADAR7_TR: J1103.28, U1101.G2 (IO_L17P_T2_35)
/CONTROL/ADAR7_TX_LOAD: J1103.26, U1101.F2 (IO_L15P_T2_DQS_35)
/CONTROL/ADAR8_CS: J1103.29, U1101.H1 (IO_L20N_T3_35)
/CONTROL/ADAR8_RX_LOAD: J1103.31, U1101.H3 (IO_L21N_T3_DQS_35)
/CONTROL/ADAR8_TR: J1103.32, U1101.H4 (IO_L18N_T2_35)
/CONTROL/ADAR8_TX_LOAD: J1103.30, U1101.H2 (IO_L20P_T3_35)
/CONTROL/ADAR_SCLK: J1103.33, U1101.J1 (IO_L22N_T3_35)
/CONTROL/ADAR_SDIO: J1103.35, U1101.J3 (IO_L21P_T3_DQS_35)
/CONTROL/ADAR_SDO: J1103.37, U1101.K1 (IO_L22P_T3_35)
/CONTROL/BEAM_STROBE: J1102.2, U1101.J16 (IO_L23N_T3_FWE_B_15), U1109.1 (D1+)
/CONTROL/DONE: Q1101.1 (G), U1101.H10 (DONE_0); also elsewhere on the board
/CONTROL/EE_WC: JP1101.1 (A), R1135.2, U1105.7 (~WC)
/CONTROL/ETH_1V0: C1203.1, C1204.1, C1205.1, C1206.1, C1207.1, L1201.2, U1201.4 (AVDD10), U1201.9 (AVDD10), U1201.22 (DVDD10), U1201.47 (AVDD10)
/CONTROL/ETH_AVDD33: C1208.1, C1209.1, C1210.1, FB1201.2, U1201.1 (AVDD33), U1201.12 (AVDD33)
/CONTROL/ETH_CT: C1217.1, J1201.1 (CT)
/CONTROL/ETH_DVDDRG: C1214.1, C1215.1, R1208.2, R1209.2, R1213.2, U1201.29 (DVDD_RG)
/CONTROL/ETH_LED0: R1202.1, U1201.35 (LED0/PHYAD0)
/CONTROL/ETH_LED1: J1201.12 (LEDG_K), R1203.1, U1201.36 (LED1/CFG_LDO0)
/CONTROL/ETH_LED2: R1204.1, R1206.1, U1201.37 (LED2/CFG_LDO1)
/CONTROL/ETH_LEDG_A: J1201.11 (LEDG_A), R1205.2
/CONTROL/ETH_LEDY_A: J1201.14 (LEDY_A), R1206.2
/CONTROL/ETH_MDC: R1211.1, U1101.P1 (IO_L4N_T0_34), U1201.14 (MDC); also elsewhere on the board
/CONTROL/ETH_MDI0_N: J1201.3 (MDI0-), U1201.3 (MDIN0)
/CONTROL/ETH_MDI0_P: J1201.2 (MDI0+), U1201.2 (MDIP0)
/CONTROL/ETH_MDI1_N: J1201.7 (MDI1-), U1201.6 (MDIN1)
/CONTROL/ETH_MDI1_P: J1201.4 (MDI1+), U1201.5 (MDIP1)
/CONTROL/ETH_MDI2_N: J1201.6 (MDI2-), U1201.8 (MDIN2)
/CONTROL/ETH_MDI2_P: J1201.5 (MDI2+), U1201.7 (MDIP2)
/CONTROL/ETH_MDI3_N: J1201.9 (MDI3-), U1201.11 (MDIN3)
/CONTROL/ETH_MDI3_P: J1201.8 (MDI3+), U1201.10 (MDIP3)
/CONTROL/ETH_MDIO: R1213.1, U1101.M15 (IO_L3N_T0_DQS_EMCCLK_14), U1201.15 (MDIO); also elsewhere on the board
/CONTROL/ETH_REGOUT: L1201.1, U1201.32 (REG_OUT)
/CONTROL/ETH_RSET: R1201.1, U1201.48 (RSET)
/CONTROL/ETH_RSTN: C1216.1, R1214.1, U1101.K13 (IO_L5P_T0_D06_14), U1201.13 (~PHYRSTB)
/CONTROL/ETH_RXD0: R1210.1, U1201.26 (RXD0/RXDLY)
/CONTROL/ETH_RXD1: R1209.1, U1201.25 (RXD1/CFG_MODE0)
/CONTROL/ETH_RXD2: R1208.1, U1201.24 (RXD2/CFG_MODE1)
/CONTROL/ETH_RXD3: R1207.1, U1201.23 (RXD3/CFG_MODE2)
/CONTROL/ETH_SGRX_FPGA_N: C1219.2, R1216.1, U1101.T2 (IO_L8N_T1_34)
/CONTROL/ETH_SGRX_FPGA_P: C1218.2, R1215.1, U1101.R3 (IO_L8P_T1_34)
/CONTROL/ETH_SGRX_PHY_N: C1219.1, U1201.41 (HSON)
/CONTROL/ETH_SGRX_PHY_P: C1218.1, U1201.40 (HSOP)
/CONTROL/ETH_SGTX_FPGA_N: C1221.1, U1101.R1 (IO_L7N_T1_34)
/CONTROL/ETH_SGTX_FPGA_P: C1220.1, U1101.R2 (IO_L7P_T1_34)
/CONTROL/ETH_SGTX_PHY_N: C1221.2, U1201.39 (HSIN)
/CONTROL/ETH_SGTX_PHY_P: C1220.2, U1201.38 (HSIP)
/CONTROL/ETH_VCM: C1222.1, R1212.2, R1215.2, R1216.2, R1217.1
/CONTROL/ETH_XI: C1201.1, U1201.45 (XTAL_IN), Y1201.1
/CONTROL/ETH_XO: C1202.1, U1201.46 (XTAL_OUT), Y1201.3
/CONTROL/FLASH_CLK: R1125.2, U1102.6 (C)
/CONTROL/FLASH_CS: R1126.2, U1101.L12 (IO_L6P_T0_FCS_B_14), U1102.1 (~S)
/CONTROL/FLASH_DQ0: U1101.J13 (IO_L1P_T0_D00_MOSI_14), U1102.5 (DQ0)
/CONTROL/FLASH_DQ1: U1101.J14 (IO_L1N_T0_D01_DIN_14), U1102.2 (DQ1)
/CONTROL/FLASH_DQ2: R1127.2, U1101.K15 (IO_L2P_T0_D02_14), U1102.3 (~W/DQ2)
/CONTROL/FLASH_DQ3: R1128.2, U1101.K16 (IO_L2N_T0_D03_14), U1102.7 (~HOLD/DQ3)
/CONTROL/FPGA_CLK_N: R1116.2, R1118.2, U1101.N12 (IO_L13N_T2_MRCC_14)
/CONTROL/FPGA_CLK_P: R1115.2, R1117.1, U1101.N11 (IO_L13P_T2_MRCC_14)
/CONTROL/F_CCLK: R1125.1, U1101.E8 (CCLK_0)
/CONTROL/F_DACR_CLK: RN1103.1 (R1.1), U1101.C13 (IO_L12N_T1_MRCC_15)
/CONTROL/F_DACR_D0: RN1101.1 (R1.1), U1101.A14 (IO_L7N_T1_AD2N_15)
/CONTROL/F_DACR_D1: RN1101.2 (R2.1), U1101.A13 (IO_L7P_T1_AD2P_15)
/CONTROL/F_DACR_D2: RN1101.3 (R3.1), U1101.A12 (IO_L5N_T0_AD9N_15)
/CONTROL/F_DACR_D3: RN1101.4 (R4.1), U1101.B11 (IO_L4N_T0_15)
/CONTROL/F_DACR_D4: RN1102.1 (R1.1), U1101.B10 (IO_L4P_T0_15)
/CONTROL/F_DACR_D5: RN1102.2 (R2.1), U1101.A10 (IO_L3N_T0_DQS_AD1N_15)
/CONTROL/F_DACR_D6: RN1102.3 (R3.1), U1101.A9 (IO_L2N_T0_AD8N_15)
/CONTROL/F_DACR_D7: RN1102.4 (R4.1), U1101.A8 (IO_L2P_T0_AD8P_15)
/CONTROL/F_DACS_D0: RN1103.2 (R2.1), U1101.D11 (IO_L14N_T2_SRCC_15)
/CONTROL/F_DACS_D1: RN1103.3 (R3.1), U1101.E12 (IO_L13P_T2_MRCC_15)
/CONTROL/F_DACS_D2: RN1103.4 (R4.1), U1101.F13 (IO_L16N_T2_A27_15)
/CONTROL/F_DACS_D3: RN1104.1 (R1.1), U1101.C11 (IO_L11P_T1_SRCC_15)
/CONTROL/F_DACS_D4: RN1104.2 (R2.1), U1101.E13 (IO_L13N_T2_MRCC_15)
/CONTROL/F_DACS_D5: RN1104.3 (R3.1), U1101.C12 (IO_L11N_T1_SRCC_15)
/CONTROL/F_DACS_D6: RN1104.4 (R4.1), U1101.D14 (IO_L15P_T2_DQS_15)
/CONTROL/F_DACS_D7: RN1105.1 (R1.1), U1101.D15 (IO_L15N_T2_DQS_ADV_B_15)
/CONTROL/F_DACS_D8: RN1105.2 (R2.1), U1101.B14 (IO_L8N_T1_AD10N_15)
/CONTROL/F_DACS_D9: RN1105.3 (R3.1), U1101.D16 (IO_L17N_T2_A25_15)
/CONTROL/F_DACS_D10: RN1105.4 (R4.1), U1101.B15 (IO_L9P_T1_DQS_AD3P_15)
/CONTROL/F_DACS_D11: RN1106.1 (R1.1), U1101.C16 (IO_L10P_T1_AD11P_15)
/CONTROL/F_DACS_D12: RN1106.2 (R2.1), U1101.A15 (IO_L9N_T1_DQS_AD3N_15)
/CONTROL/F_DACS_D13: RN1106.3 (R3.1), U1101.B16 (IO_L10N_T1_AD11N_15)
/CONTROL/F_DACS_IQCLK: RN1107.2 (R2.1), U1101.E11 (IO_L14P_T2_SRCC_15)
/CONTROL/F_DACS_IQRESET: RN1107.3 (R3.1), U1101.D10 (IO_0_15)
/CONTROL/F_DACS_IQSEL: RN1107.1 (R1.1), U1101.G12 (IO_L19N_T3_A21_VREF_15)
/CONTROL/F_DACS_IQWRT: RN1106.4 (R4.1), U1101.F12 (IO_L16P_T2_A28_15)
/CONTROL/HK_ALERT: R1134.2, U1101.K2 (IO_L24N_T3_35), U1104.3 (ALERT)
/CONTROL/INIT_B: R1123.2, U1101.K10 (INIT_B_0)
/CONTROL/JTAG_TCK: J1101.6, U1101.L7 (TCK_0), U1110.1 (D1+)
/CONTROL/JTAG_TDI: J1101.10, U1101.N7 (TDI_0), U1110.4 (D2+)
/CONTROL/JTAG_TDO: J1101.8, U1101.N8 (TDO_0), U1110.5 (D2-)
/CONTROL/JTAG_TMS: J1101.4, U1101.M7 (TMS_0), U1110.2 (D1-)
/CONTROL/MODE_M0: R1120.2, U1101.M9 (M0_0)
/CONTROL/MODE_M1: R1121.1, U1101.M10 (M1_0)
/CONTROL/MODE_M2: R1122.1, U1101.M11 (M2_0)
/CONTROL/PMOD_CS: J1102.1, U1101.H16 (IO_L22P_T3_A17_15), U1108.1 (D1+)
/CONTROL/PMOD_MISO: J1102.5, U1101.J15 (IO_L23P_T3_FOE_B_15), U1108.4 (D2+)
/CONTROL/PMOD_MOSI: J1102.3, U1101.G16 (IO_L22N_T3_A16_15), U1108.2 (D1-)
/CONTROL/PMOD_SCLK: J1102.7, U1101.D13 (IO_L12P_T1_MRCC_15), U1108.5 (D2-)
/CONTROL/PMOD_SPARE1: J1102.6, U1101.G15 (IO_L24N_T3_RS0_15), U1109.4 (D2+)
/CONTROL/PMOD_SPARE2: J1102.8, U1101.G11 (IO_25_15), U1109.5 (D2-)
/CONTROL/PPS_SYNC: J1102.4, U1101.H14 (IO_L24P_T3_RS1_15), U1109.2 (D1-)
/CONTROL/PROGRAM_B: R1124.2, SW1101.1, U1101.L9 (PROGRAM_B_0), U1103.4
/CONTROL/PUDC_B: R1119.2, U1101.L15 (IO_L3P_T0_DQS_PUDC_B_14)
/CONTROL/XADC_GND: C1175.2, C1176.2, FB1102.1, U1101.G7 (GNDADC_0), U1101.H7 (VREFN_0), U1101.H8 (VP_0), U1101.J7 (VN_0), U1101.J8 (VREFP_0)
/CONTROL/XADC_VCC: C1175.1, C1176.1, FB1101.2, U1101.G8 (VCCADC_0)
/CONV_SPI_CSB_R: U1101.J4 (IO_L19N_T3_VREF_35); also elsewhere on the board
/CONV_SPI_CSB_S: U1101.L2 (IO_L23N_T3_35); also elsewhere on the board
/CONV_SPI_SCLK: U1101.K3 (IO_L24P_T3_35); also elsewhere on the board
/CONV_SPI_SDIO: U1101.L3 (IO_L23P_T3_35); also elsewhere on the board
/DACR_CLK: RN1103.8 (R1.2); also elsewhere on the board
/DACR_D0: RN1101.8 (R1.2); also elsewhere on the board
/DACR_D1: RN1101.7 (R2.2); also elsewhere on the board
/DACR_D2: RN1101.6 (R3.2); also elsewhere on the board
/DACR_D3: RN1101.5 (R4.2); also elsewhere on the board
/DACR_D4: RN1102.8 (R1.2); also elsewhere on the board
/DACR_D5: RN1102.7 (R2.2); also elsewhere on the board
/DACR_D6: RN1102.6 (R3.2); also elsewhere on the board
/DACR_D7: RN1102.5 (R4.2); also elsewhere on the board
/DACS_D0: RN1103.7 (R2.2); also elsewhere on the board
/DACS_D1: RN1103.6 (R3.2); also elsewhere on the board
/DACS_D2: RN1103.5 (R4.2); also elsewhere on the board
/DACS_D3: RN1104.8 (R1.2); also elsewhere on the board
/DACS_D4: RN1104.7 (R2.2); also elsewhere on the board
/DACS_D5: RN1104.6 (R3.2); also elsewhere on the board
/DACS_D6: RN1104.5 (R4.2); also elsewhere on the board
/DACS_D7: RN1105.8 (R1.2); also elsewhere on the board
/DACS_D8: RN1105.7 (R2.2); also elsewhere on the board
/DACS_D9: RN1105.6 (R3.2); also elsewhere on the board
/DACS_D10: RN1105.5 (R4.2); also elsewhere on the board
/DACS_D11: RN1106.8 (R1.2); also elsewhere on the board
/DACS_D12: RN1106.7 (R2.2); also elsewhere on the board
/DACS_D13: RN1106.6 (R3.2); also elsewhere on the board
/DACS_IQCLK: RN1107.7 (R2.2); also elsewhere on the board
/DACS_IQRESET: RN1107.6 (R3.2); also elsewhere on the board
/DACS_IQSEL: RN1107.8 (R1.2); also elsewhere on the board
/DACS_IQWRT: RN1106.5 (R4.2); also elsewhere on the board
/FPGA_IRQ: R1133.1, U1101.H5 (IO_L18P_T2_35); also elsewhere on the board
/FPGA_PROG_B: R1129.2, U1103.2; also elsewhere on the board
/HK_SCL: R1131.2, U1101.K5 (IO_25_35), U1104.2 (SCL), U1105.6 (SCL); also elsewhere on the board
/HK_SDA: R1132.2, U1101.J5 (IO_L19P_T3_35), U1104.1 (SDA), U1105.5 (SDA); also elsewhere on the board
/LINK_RX_CLK_N: U1101.N2 (IO_L3N_T0_DQS_34); also elsewhere on the board
/LINK_RX_CLK_P: U1101.N3 (IO_L3P_T0_DQS_34); also elsewhere on the board
/LINK_RX_D0_N: U1101.M4 (IO_L1N_T0_34); also elsewhere on the board
/LINK_RX_D0_P: U1101.L4 (IO_L1P_T0_34); also elsewhere on the board
/LINK_RX_D1_N: U1101.M1 (IO_L2N_T0_34); also elsewhere on the board
/LINK_RX_D1_P: U1101.M2 (IO_L2P_T0_34); also elsewhere on the board
/LINK_TX_CLK_N: R106.2, U1101.P13 (IO_L11N_T1_SRCC_14); also elsewhere on the board
/LINK_TX_CLK_P: R106.1, U1101.N13 (IO_L11P_T1_SRCC_14); also elsewhere on the board
/LINK_TX_D0_N: R105.2, U1101.N16 (IO_L7N_T1_D10_14); also elsewhere on the board
/LINK_TX_D0_P: R105.1, U1101.M16 (IO_L7P_T1_D09_14); also elsewhere on the board
/SW_CTRL0: U1101.C8 (IO_L1P_T0_AD0P_15); also elsewhere on the board
/SW_CTRL1: U1101.C9 (IO_L1N_T0_AD0N_15); also elsewhere on the board
/SW_CTRL2: U1101.B9 (IO_L3P_T0_DQS_AD1P_15); also elsewhere on the board
/SW_CTRL3: U1101.B12 (IO_L5P_T0_AD9P_15); also elsewhere on the board
/XO_SCL: U1101.D9 (IO_L6N_T0_VREF_15); also elsewhere on the board
/XO_SDA: U1101.C14 (IO_L8P_T1_AD10P_15); also elsewhere on the board
GND: C1101.2, C1110.2, C1111.2, C1112.2, C1113.2, C1114.2, C1115.2, C1116.2, C1117.2, C1118.2, C1120.2, C1121.2, C1125.2, C1126.2, C1127.2, C1128.2, C1129.2, C1130.2, C1135.2, C1140.2, C1141.2, C1142.2, C1143.2, C1144.2, C1145.2, C1146.2, C1147.2, C1148.2, C1149.2, C1150.2, C1151.2, C1152.2, C1155.2, C1156.2, C1157.2, C1158.2, C1159.2, C1160.2, C1161.2, C1165.2, C1166.2, C1167.2, C1168.2, C1169.2, C1170.2, C1171.2, C1180.2, C1181.2, C1182.2, C1183.2, C1184.2, C1185.2, C1186.2, C1187.2, C1201.2, C1202.2, C1203.2, C1204.2, C1205.2, C1206.2, C1207.2, C1208.2, C1209.2, C1210.2, C1211.2, C1212.2, C1213.2, C1214.2, C1215.2, C1216.2, C1217.2, C1222.2, FB1102.2, J1101.3, J1101.5, J1101.7, J1101.9, J1101.11, J1101.13, J1102.9, J1102.10, J1103.34, J1103.36, J1103.38, J1103.39, J1103.40, J1201.10 (CHS_GND), J1201.13 (LEDY_K), J1201.SH (SHIELD), JP1101.2 (B), Q1101.2 (S), R1121.2, R1122.2, R1133.2, R1201.2, R1204.2, R1207.2, R1210.2, R1211.2, R1217.2, SW1101.2, U1101.A1 (GND), U1101.A11 (GND), U1101.B8 (GND), U1101.C5 (GND), U1101.C15 (GND), U1101.D2 (GND), U1101.D12 (GND), U1101.E9 (GND), U1101.F6 (GND), U1101.F8 (VCCBATT_0), U1101.F10 (GND), U1101.F16 (GND), U1101.G3 (GND), U1101.G9 (GND), U1101.G13 (GND), U1101.H6 (GND), U1101.J9 (GND), U1101.J11 (GND), U1101.K4 (GND), U1101.K6 (GND), U1101.K7 (DXN_0), U1101.K8 (DXP_0), U1101.K14 (GND), U1101.L1 (GND), U1101.L11 (GND), U1101.M8 (GND), U1101.N5 (GND), U1101.N15 (GND), U1101.P2 (GND), U1101.P12 (GND), U1101.R9 (GND), U1101.T6 (GND), U1101.T16 (GND), U1102.4 (VSS), U1103.3 (GND), U1104.4 (GND), U1104.5 (A2), U1104.6 (A1), U1104.7 (A0), U1105.1 (E0), U1105.2 (E1), U1105.3 (E2), U1105.4 (VSS), U1108.3 (GND), U1108.8 (GND), U1109.3 (GND), U1109.8 (GND), U1110.3 (GND), U1110.8 (GND), U1201.16 (TXD3), U1201.17 (TXD2), U1201.18 (TXD1), U1201.19 (TXD0), U1201.20 (TXCTL), U1201.21 (TXC), U1201.49 (GND), Y1201.2 (G), Y1201.4 (G); also elsewhere on the board
unnamed: D1101.2 (A), R1130.2
unnamed: D1101.1 (K), Q1101.3 (D)

Notes on the sheet:
Bank 14, VCCO 3.3 V: AD9484 on AERIS-10's balls, AD9253, link inputs, CLK_FPGA, flash
Bank 15, VCCO 3.3 V: DACs (22R series), Pmod, RF switches, clock select, XO I2C
100R across each pair at the FPGA. The banks are 3.3 V, where DIFF_TERM is not allowed (UG471)
CLK_FPGA: ADCLK948 610-960 mV > LVDS_25 600 mV max (DS181 Table 11).
24.9R series + 24.9R shunt per leg: 50R to the line, half the swing.
22R series on every DAC line, as AERIS-10
Pmod, from the KV260's J2 (INTERFACE_SPEC 4.2). Pmod pin k = pad 2k-1,
pin k+6 = pad 2k. Its 3.3 V (pins 6, 12) is not used.
Bank 34, VCCO 2.5 V: the link pairs the FPGA drives
(LVDS_25 outputs need 2.5 V). 14 balls unused.
Bank 35, VCCO 1.8 V: ADAR1000 control, converter SPI, HK, IRQ
To AERIS-10: 4 lines per ADAR1000 (CS, TX_LOAD,
RX_LOAD, TR) for 8 chips, then the shared SPI. 1.8 V.
CFGBVS high: banks 0, 14, 15 at 3.3 V (UG470). XADC inputs and on-chip reference to
GNDADC (UG480 Figure 1-2); temperature diode unused.
Master SPI x4, UG470 Figure 2-14: M[2:0] = 001
PROGRAM_B: 4.7k pull-up above; push button (UG470 Table 2-4) and the Kria's
FPGA_PROG_B (1.8 V) through a 74LVC1G07 open-drain buffer at 1.8 V.
JTAG: Xilinx 2x7 2 mm, DS593 Figure 14
MT25QL128: FCS_B 2.4k, W and HOLD 4.7k (UG470 Figure 2-14); CCLK 22R series as AERIS
HK I2C pull-ups at 1.8 V (the carrier adds 2.21k), HK_ALERT pull-up; FPGA_IRQ pull-down
TMP1075 board temperature, I2C 0x48. ALERT to the FPGA (bank 35, H3)
M24C02 board ID EEPROM, I2C 0x50
WC high: write-protected; close JP1101 to write
VCCBATT to GND: no bitstream encryption (DS181; UG470 Figure 2-14)
XADC: VCCADC from VCCAUX through a ferrite, GNDADC to ground through another
(UG480 Figure 1-2, on-chip reference)
Decoupling per UG483 Table 2-2 (FTG256, XC7A50T); types per Table 2-5
VCCINT
VCCBRAM
VCCAUX
VCCO_0
VCCO_14/15
VCCO_34
VCCO_35
CONTROL - how this sheet works
1. Every FPGA ball has a stub and a name. Hierarchical label = the net leaves the sheet; plain label = it stays here.
2. Bank voltages: 14 and 15 at 3.3 V, 34 at 2.5 V (link outputs only), 35 at 1.8 V. See docs/CONTROL_SPEC.md.
3. Pin table: _work/sheets/control_spec.py, checked against the symbol's ball names (bank, pair, clock capable).
4. Boot: master SPI x4 from U1102 (UG470 Figure 2-14). Reset: SW1101 or the Kria's FPGA_PROG_B via U1103.
VCCINT, bottom face under the BGA (on ball vias)
LINK_TX termination at the receiver (bottom face, on the ball vias)
