PabloSoage/kv260-ias2rf/CSI2-KRIA-KV260_Rev01.kicad_pcb

## KiCad design CSI2-KRIA-KV260_Rev01.kicad_pcb (continued)

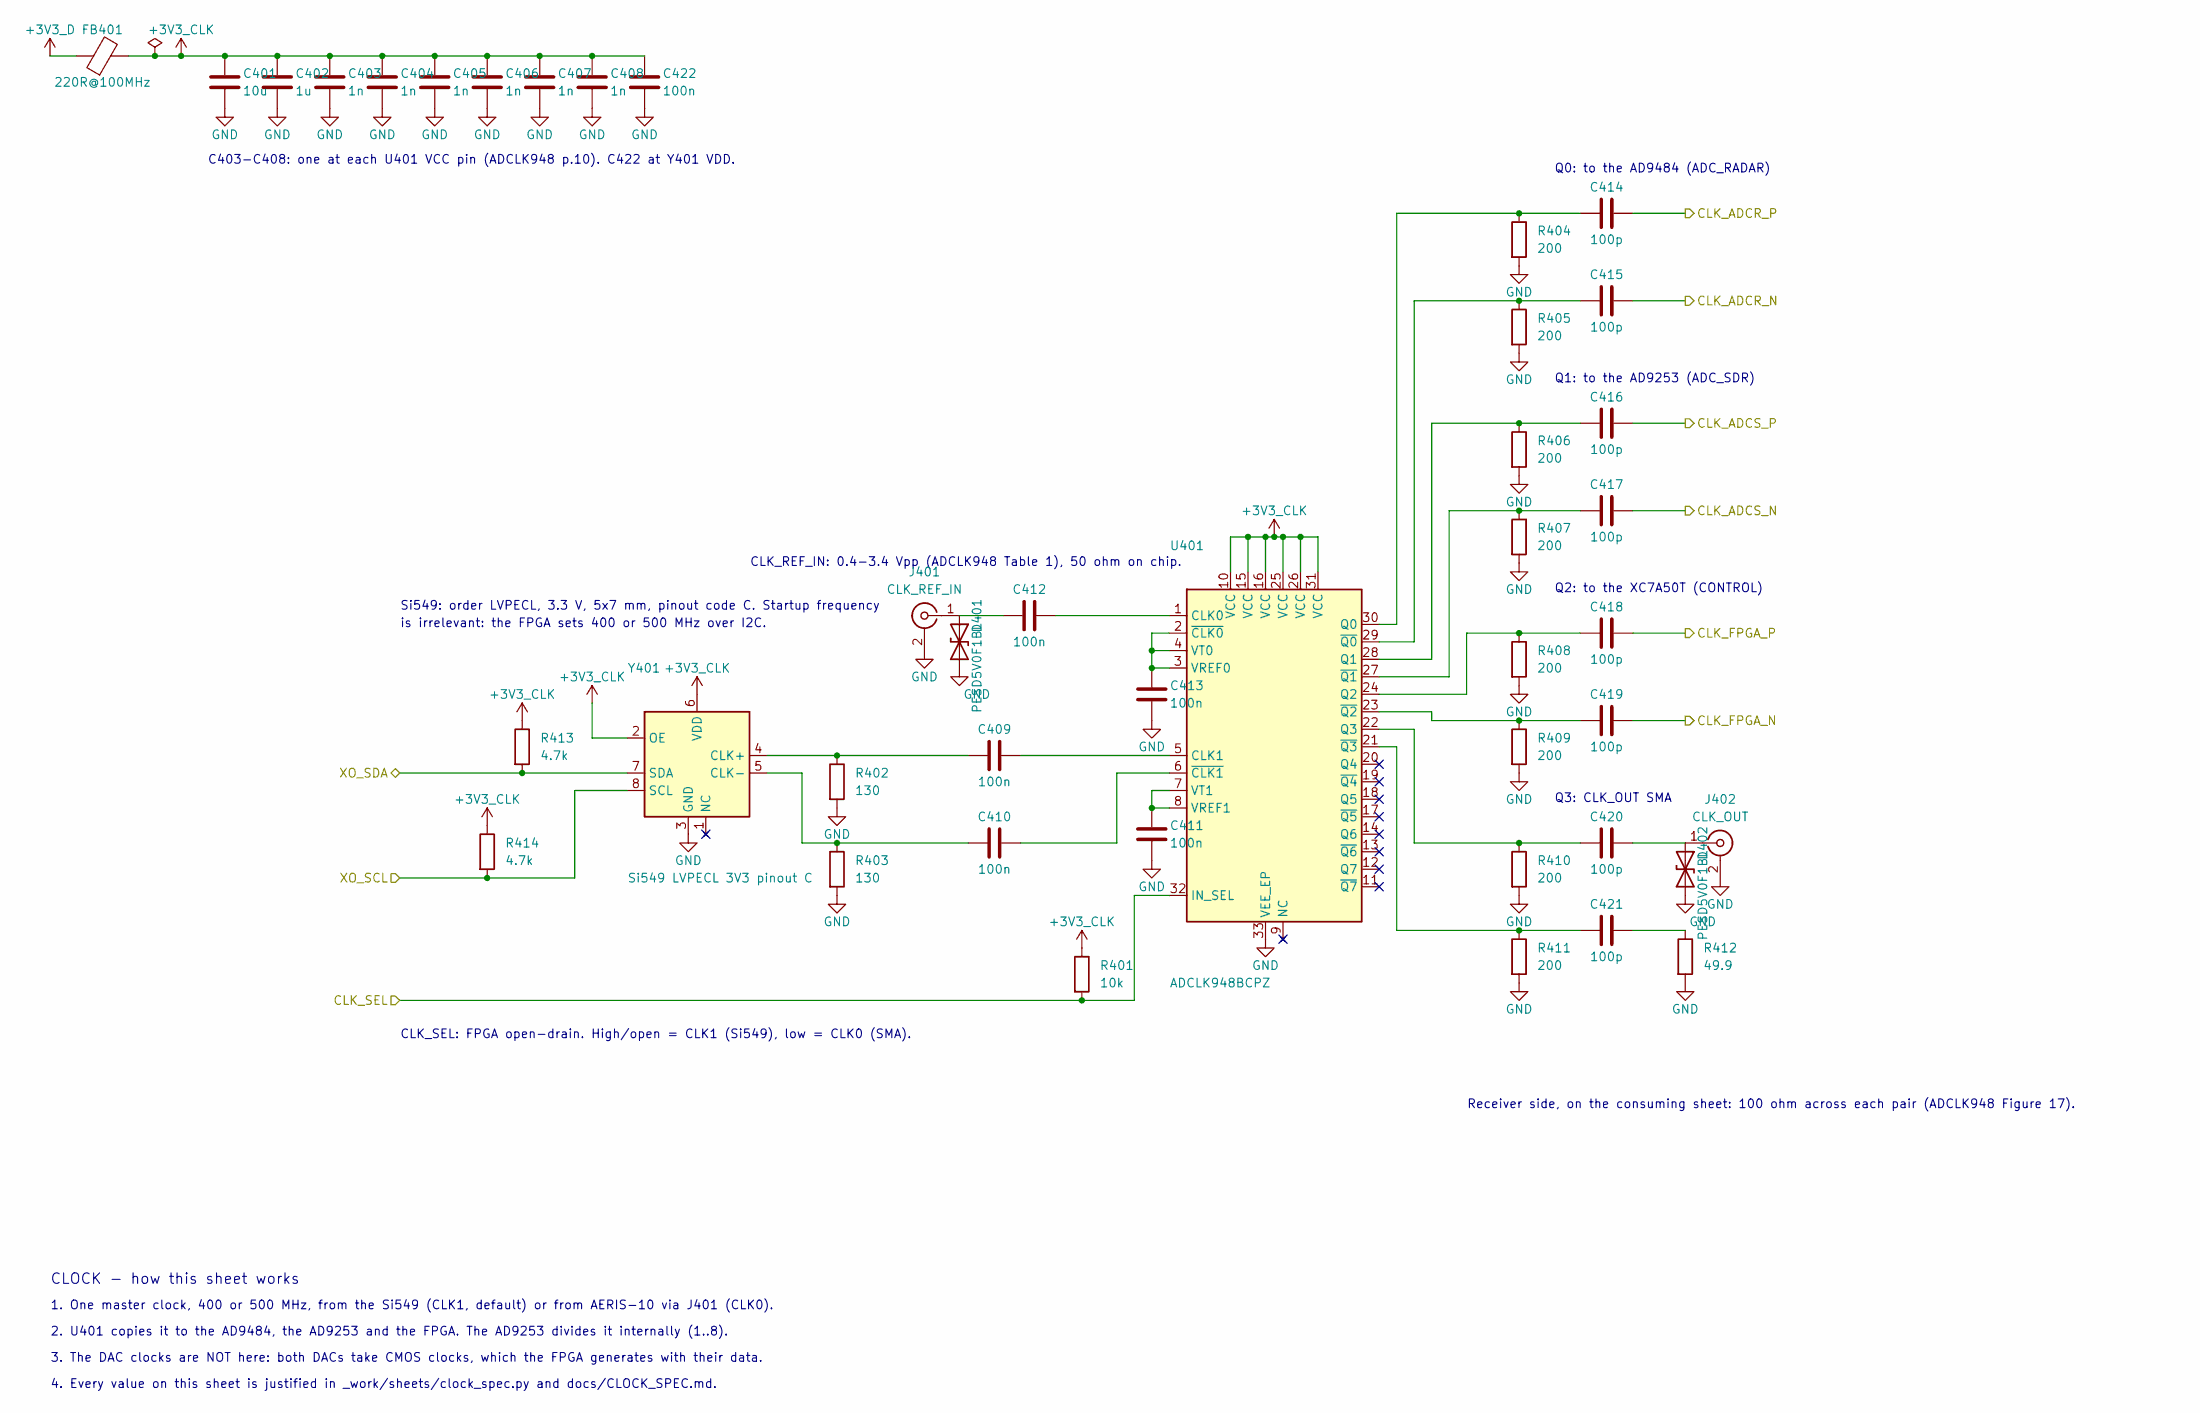
[picture p124: schematic CLOCK.kicad_sch, CLOCK - master XO, reference select, fan-out]

Parts:
C401: 10u; C_0805_2012Metric
C402: 1u; C_0402_1005Metric
C403, C404, C405, C406, C407, C408: 1n; C_0402_1005Metric
C409, C410, C411, C412, C413, C422: 100n; C_0402_1005Metric
C414, C415, C416, C417, C418, C419, C420, C421: 100p; C_0402_1005Metric
D401, D402: PESD5V0F1BL; D_SOD-882
FB401: 220R@100MHz; L_0603_1608Metric
J401: CLK_REF_IN; SMA_Samtec_SMA-J-P-H-ST-EM1_EdgeMount
J402: CLK_OUT; SMA_Samtec_SMA-J-P-H-ST-EM1_EdgeMount
R401: 10k; R_0402_1005Metric
R402, R403: 130; R_0402_1005Metric
R404, R405, R406, R407, R408, R409, R410, R411: 200; R_0402_1005Metric
R412: 49.9; R_0402_1005Metric
R413, R414: 4.7k; R_0402_1005Metric
U401: ADCLK948BCPZ; LFCSP-32-1EP_5x5mm_P0.5mm_EP2.7x2.7mm
Y401: Si549 LVPECL 3V3 pinout C; Oscillator_SMD_SI570_SI571_Standard

Connections:
+3V3_CLK: C401.1, C402.1, C403.1, C404.1, C405.1, C406.1, C407.1, C408.1, C422.1, FB401.2, R401.1, R413.1, R414.1, U401.10 (VCC), U401.15 (VCC), U401.16 (VCC), U401.25 (VCC), U401.26 (VCC), U401.31 (VCC), Y401.2 (OE), Y401.6 (VDD); also elsewhere on the board
+3V3_D: FB401.1; also elsewhere on the board
/CLK_ADCR_N: C415.2; also elsewhere on the board
/CLK_ADCR_P: C414.2; also elsewhere on the board
/CLK_ADCS_N: C417.2; also elsewhere on the board
/CLK_ADCS_P: C416.2; also elsewhere on the board
/CLK_FPGA_N: C419.2; also elsewhere on the board
/CLK_FPGA_P: C418.2; also elsewhere on the board
/CLK_SEL: R401.2, U401.32 (IN_SEL); also elsewhere on the board
/XO_SCL: R414.2, Y401.8 (SCL); also elsewhere on the board
/XO_SDA: R413.2, Y401.7 (SDA); also elsewhere on the board
GND: C401.2, C402.2, C403.2, C404.2, C405.2, C406.2, C407.2, C408.2, C411.2, C413.2, C422.2, D401.2 (A2), D402.2 (A2), J401.2 (Ext), J402.2 (Ext), R402.2, R403.2, R404.2, R405.2, R406.2, R407.2, R408.2, R409.2, R410.2, R411.2, R412.2, U401.33 (VEE_EP), Y401.3 (GND); also elsewhere on the board
unnamed: C421.2, R412.1
unnamed: C412.1, D401.1 (A1), J401.1 (In)
unnamed: C420.2, D402.1 (A1), J402.1 (In)
unnamed: C412.2, U401.1 (CLK0)
unnamed: C409.2, U401.5 (CLK1)
unnamed: C414.1, R404.1, U401.30 (Q0)
unnamed: C416.1, R406.1, U401.28 (Q1)
unnamed: C418.1, R408.1, U401.24 (Q2)
unnamed: C420.1, R410.1, U401.22 (Q3)
unnamed: C413.1, U401.2 (~CLK0), U401.3 (VREF0), U401.4 (VT0)
unnamed: C411.1, U401.7 (VT1), U401.8 (VREF1)
unnamed: C410.2, U401.6 (~CLK1)
unnamed: C415.1, R405.1, U401.29 (~Q0)
unnamed: C417.1, R407.1, U401.27 (~Q1)
unnamed: C419.1, R409.1, U401.23 (~Q2)
unnamed: C421.1, R411.1, U401.21 (~Q3)
unnamed: C409.1, R402.1, Y401.4 (CLK+)
unnamed: C410.1, R403.1, Y401.5 (CLK-)

Notes on the sheet:
C403-C408: one at each U401 VCC pin (ADCLK948 p.10). C422 at Y401 VDD.
CLK_REF_IN: 0.4-3.4 Vpp (ADCLK948 Table 1), 50 ohm on chip.
Si549: order LVPECL, 3.3 V, 5x7 mm, pinout code C. Startup frequency
is irrelevant: the FPGA sets 400 or 500 MHz over I2C.
CLK_SEL: FPGA open-drain. High/open = CLK1 (Si549), low = CLK0 (SMA).
Q0: to the AD9484 (ADC_RADAR)
Q1: to the AD9253 (ADC_SDR)
Q2: to the XC7A50T (CONTROL)
Q3: CLK_OUT SMA
Receiver side, on the consuming sheet: 100 ohm across each pair (ADCLK948 Figure 17).
CLOCK - how this sheet works
1. One master clock, 400 or 500 MHz, from the Si549 (CLK1, default) or from AERIS-10 via J401 (CLK0).
2. U401 copies it to the AD9484, the AD9253 and the FPGA. The AD9253 divides it internally (1..8).
3. The DAC clocks are NOT here: both DACs take CMOS clocks, which the FPGA generates with their data.
4. Every value on this sheet is justified in _work/sheets/clock_spec.py and docs/CLOCK_SPEC.md.

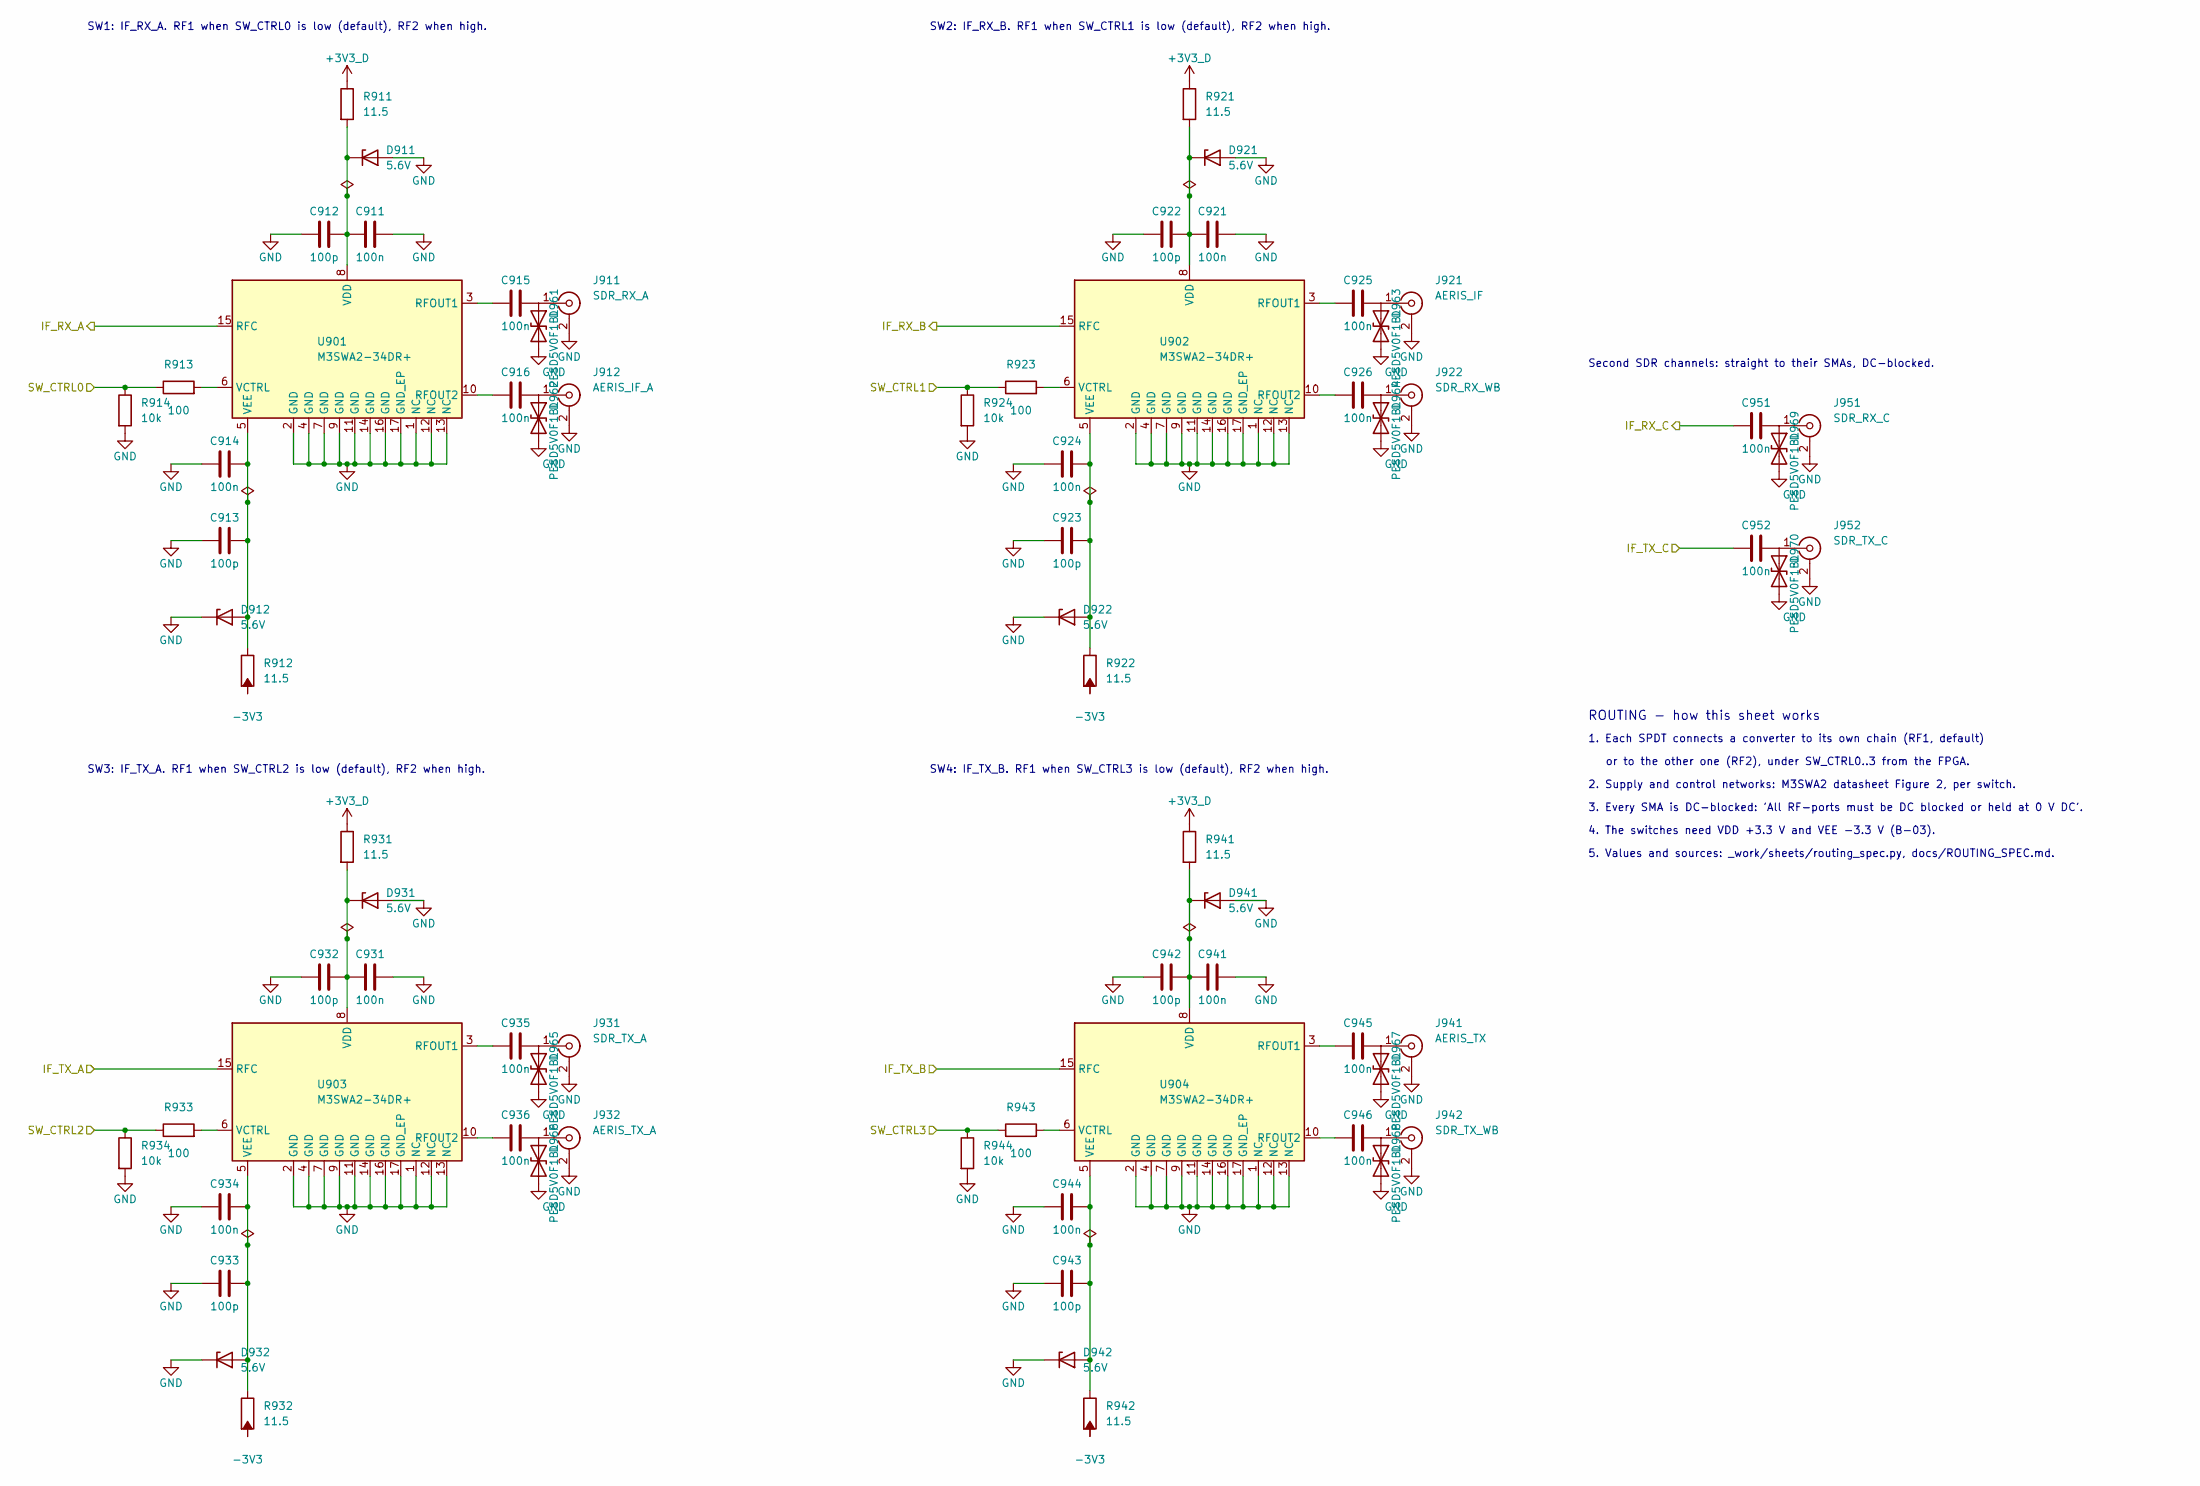
[picture p125: schematic ROUTING.kicad_sch, ROUTING - 4 x M3SWA2 SPDT channel routing, IF SMAs]

Parts:
C911, C914, C915, C916, C921, C924, C925, C926, C931, C934, C935, C936, C941, C944, C945, C946, C951, C952: 100n; C_0402_1005Metric
C912, C913, C922, C923, C932, C933, C942, C943: 100p; C_0402_1005Metric
D911, D912, D921, D922, D931, D932, D941, D942: 5.6V; D_SOD-123
D961, D962, D963, D964, D965, D966, D967, D968, D969, D970: PESD5V0F1BL; D_SOD-882
J911: SDR_RX_A; SMA_Samtec_SMA-J-P-H-ST-EM1_EdgeMount
J912: AERIS_IF_A; SMA_Samtec_SMA-J-P-H-ST-EM1_EdgeMount
J921: AERIS_IF; SMA_Samtec_SMA-J-P-H-ST-EM1_EdgeMount
J922: SDR_RX_WB; SMA_Samtec_SMA-J-P-H-ST-EM1_EdgeMount
J931: SDR_TX_A; SMA_Samtec_SMA-J-P-H-ST-EM1_EdgeMount
J932: AERIS_TX_A; SMA_Samtec_SMA-J-P-H-ST-EM1_EdgeMount
J941: AERIS_TX; SMA_Samtec_SMA-J-P-H-ST-EM1_EdgeMount
J942: SDR_TX_WB; SMA_Samtec_SMA-J-P-H-ST-EM1_EdgeMount
J951: SDR_RX_C; SMA_Samtec_SMA-J-P-H-ST-EM1_EdgeMount
J952: SDR_TX_C; SMA_Samtec_SMA-J-P-H-ST-EM1_EdgeMount
R911, R912, R921, R922, R931, R932, R941, R942: 11.5; R_0402_1005Metric
R913, R923, R933, R943: 100; R_0402_1005Metric
R914, R924, R934, R944: 10k; R_0402_1005Metric
U901, U902, U903, U904: M3SWA2-34DR+; MiniCircuits_DQ3005

Connections:
+3V3_D: R911.1, R921.1, R931.1, R941.1; also elsewhere on the board
-3V3: R912.2, R922.2, R932.2, R942.2; also elsewhere on the board
/IF_RX_A: U901.15 (RFC); also elsewhere on the board
/IF_RX_B: U902.15 (RFC); also elsewhere on the board
/IF_RX_C: C951.1; also elsewhere on the board
/IF_TX_A: U903.15 (RFC); also elsewhere on the board
/IF_TX_B: U904.15 (RFC); also elsewhere on the board
/IF_TX_C: C952.1; also elsewhere on the board
/SW_CTRL0: R913.1, R914.1; also elsewhere on the board
/SW_CTRL1: R923.1, R924.1; also elsewhere on the board
/SW_CTRL2: R933.1, R934.1; also elsewhere on the board
/SW_CTRL3: R943.1, R944.1; also elsewhere on the board
GND: C911.2, C912.2, C913.1, C914.1, C921.2, C922.2, C923.1, C924.1, C931.2, C932.2, C933.1, C934.1, C941.2, C942.2, C943.1, C944.1, D911.2 (A), D912.1 (K), D921.2 (A), D922.1 (K), D931.2 (A), D932.1 (K), D941.2 (A), D942.1 (K), D961.2 (A2), D962.2 (A2), D963.2 (A2), D964.2 (A2), D965.2 (A2), D966.2 (A2), D967.2 (A2), D968.2 (A2), D969.2 (A2), D970.2 (A2), J911.2 (Ext), J912.2 (Ext), J921.2 (Ext), J922.2 (Ext), J931.2 (Ext), J932.2 (Ext), J941.2 (Ext), J942.2 (Ext), J951.2 (Ext), J952.2 (Ext), R914.2, R924.2, R934.2, R944.2, U901.1 (NC), U901.2 (GND), U901.4 (GND), U901.7 (GND), U901.9 (GND), U901.11 (GND), U901.12 (NC), U901.13 (NC), U901.14 (GND), U901.16 (GND), U901.17 (GND_EP), U902.1 (NC), U902.2 (GND), U902.4 (GND), U902.7 (GND), U902.9 (GND), U902.11 (GND), U902.12 (NC), U902.13 (NC), U902.14 (GND), U902.16 (GND), U902.17 (GND_EP), U903.1 (NC), U903.2 (GND), U903.4 (GND), U903.7 (GND), U903.9 (GND), U903.11 (GND), U903.12 (NC), U903.13 (NC), U903.14 (GND), U903.16 (GND), U903.17 (GND_EP), U904.1 (NC), U904.2 (GND), U904.4 (GND), U904.7 (GND), U904.9 (GND), U904.11 (GND), U904.12 (NC), U904.13 (NC), U904.14 (GND), U904.16 (GND), U904.17 (GND_EP); also elsewhere on the board
unnamed: C911.1, C912.1, D911.1 (K), R911.2, U901.8 (VDD)
unnamed: C913.2, C914.2, D912.2 (A), R912.1, U901.5 (VEE)
unnamed: C921.1, C922.1, D921.1 (K), R921.2, U902.8 (VDD)
unnamed: C923.2, C924.2, D922.2 (A), R922.1, U902.5 (VEE)
unnamed: C931.1, C932.1, D931.1 (K), R931.2, U903.8 (VDD)
unnamed: C933.2, C934.2, D932.2 (A), R932.1, U903.5 (VEE)
unnamed: C941.1, C942.1, D941.1 (K), R941.2, U904.8 (VDD)
unnamed: C943.2, C944.2, D942.2 (A), R942.1, U904.5 (VEE)
unnamed: C915.2, D961.1 (A1), J911.1 (In)
unnamed: C916.2, D962.1 (A1), J912.1 (In)
unnamed: C925.2, D963.1 (A1), J921.1 (In)
unnamed: C926.2, D964.1 (A1), J922.1 (In)
unnamed: C935.2, D965.1 (A1), J931.1 (In)
unnamed: C936.2, D966.1 (A1), J932.1 (In)
unnamed: C945.2, D967.1 (A1), J941.1 (In)
unnamed: C946.2, D968.1 (A1), J942.1 (In)
unnamed: C951.2, D969.1 (A1), J951.1 (In)
unnamed: C952.2, D970.1 (A1), J952.1 (In)
unnamed: C915.1, U901.3 (RFOUT1)
unnamed: C916.1, U901.10 (RFOUT2)
unnamed: R913.2, U901.6 (VCTRL)
unnamed: C925.1, U902.3 (RFOUT1)
unnamed: C926.1, U902.10 (RFOUT2)
unnamed: R923.2, U902.6 (VCTRL)
unnamed: C935.1, U903.3 (RFOUT1)
unnamed: C936.1, U903.10 (RFOUT2)
unnamed: R933.2, U903.6 (VCTRL)
unnamed: C945.1, U904.3 (RFOUT1)
unnamed: C946.1, U904.10 (RFOUT2)
unnamed: R943.2, U904.6 (VCTRL)

Notes on the sheet:
SW1: IF_RX_A. RF1 when SW_CTRL0 is low (default), RF2 when high.
SW2: IF_RX_B. RF1 when SW_CTRL1 is low (default), RF2 when high.
SW3: IF_TX_A. RF1 when SW_CTRL2 is low (default), RF2 when high.
SW4: IF_TX_B. RF1 when SW_CTRL3 is low (default), RF2 when high.
Second SDR channels: straight to their SMAs, DC-blocked.
ROUTING - how this sheet works
1. Each SPDT connects a converter to its own chain (RF1, default)
or to the other one (RF2), under SW_CTRL0..3 from the FPGA.
2. Supply and control networks: M3SWA2 datasheet Figure 2, per switch.
3. Every SMA is DC-blocked: 'All RF-ports must be DC blocked or held at 0 V DC'.
4. The switches need VDD +3.3 V and VEE -3.3 V (B-03).
5. Values and sources: _work/sheets/routing_spec.py, docs/ROUTING_SPEC.md.

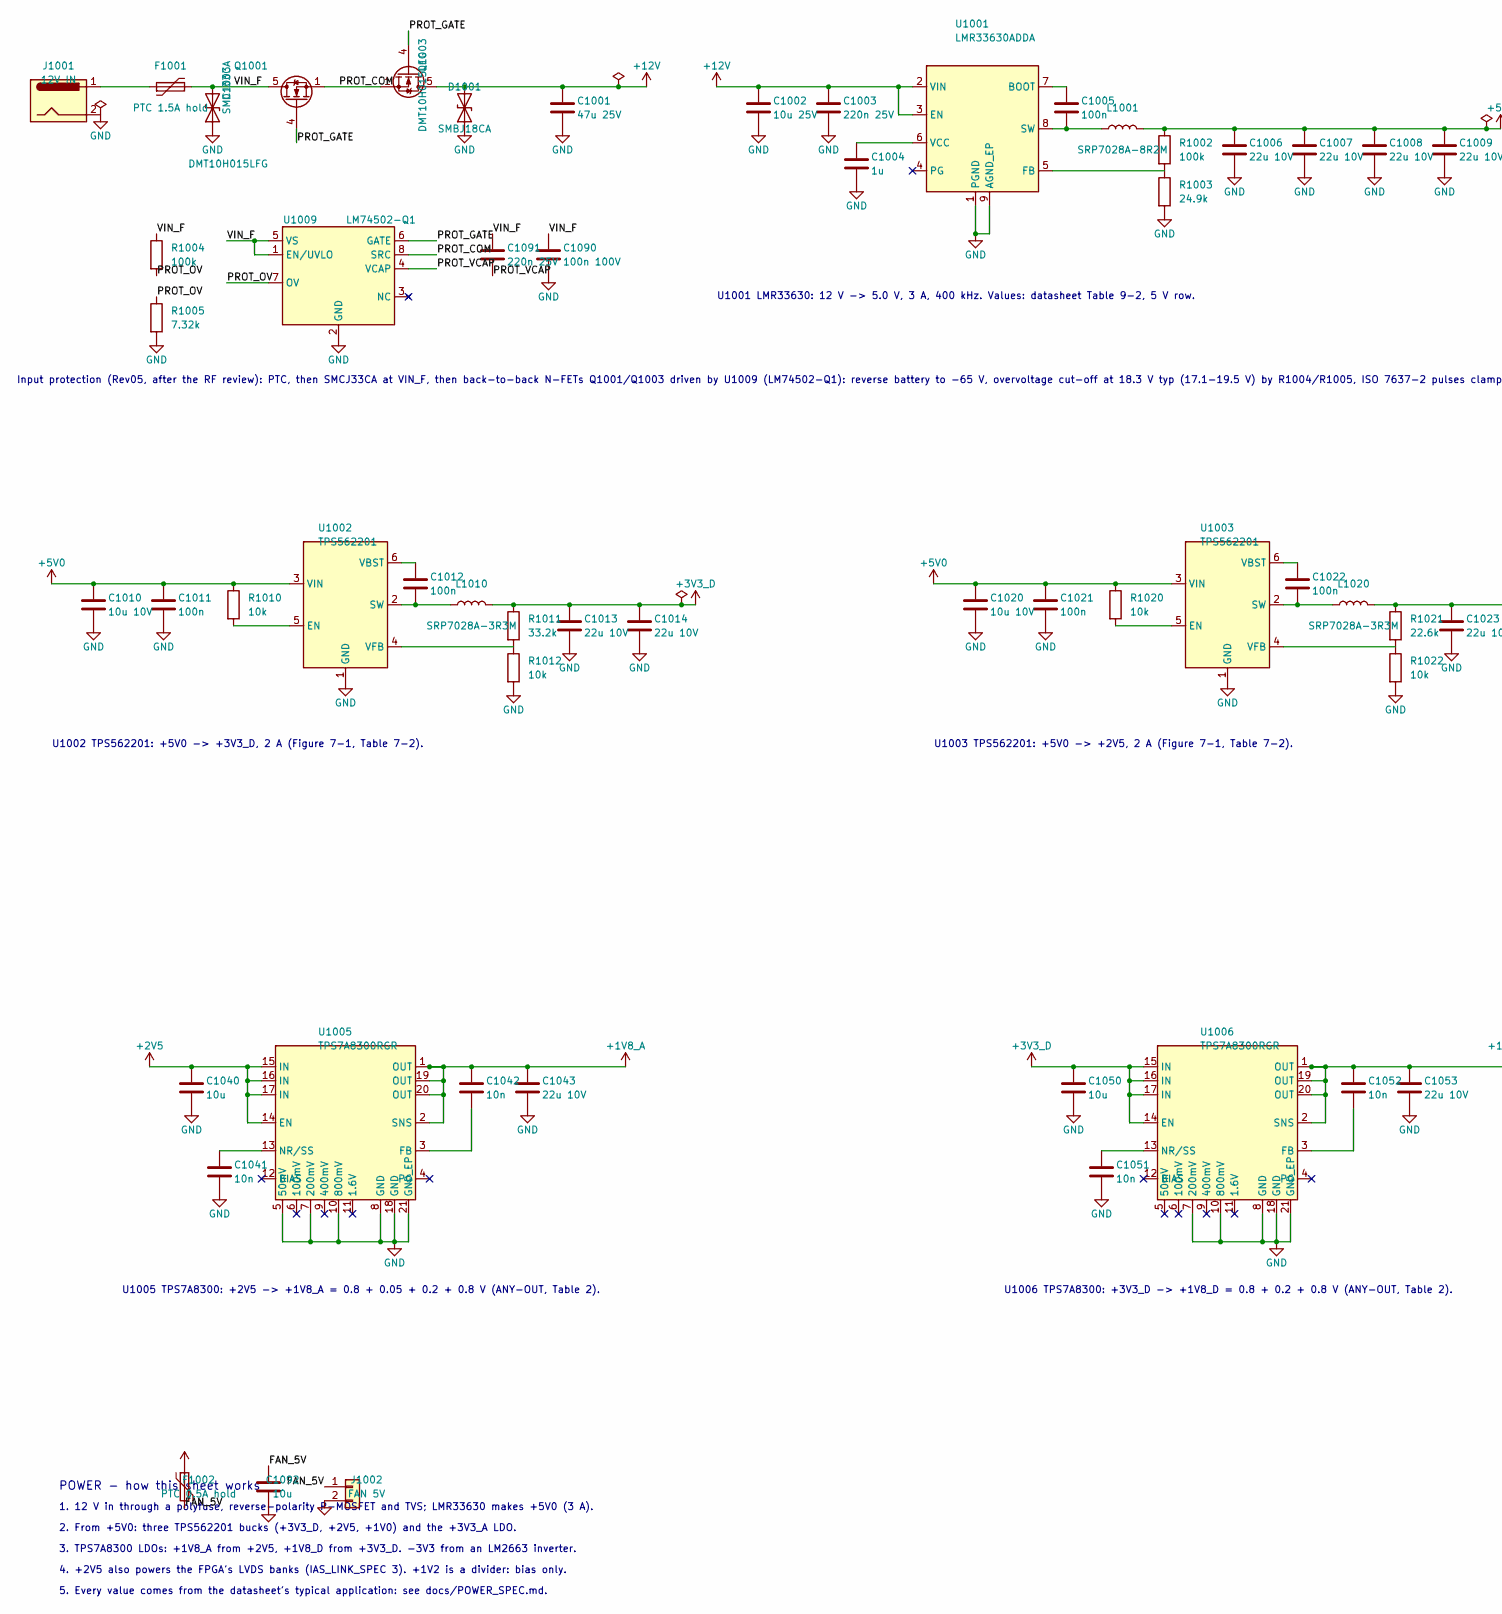
[picture p126: schematic POWER.kicad_sch, POWER - 12 V input, protection, bucks, LDOs, -3V3, part in row 1, column 1]

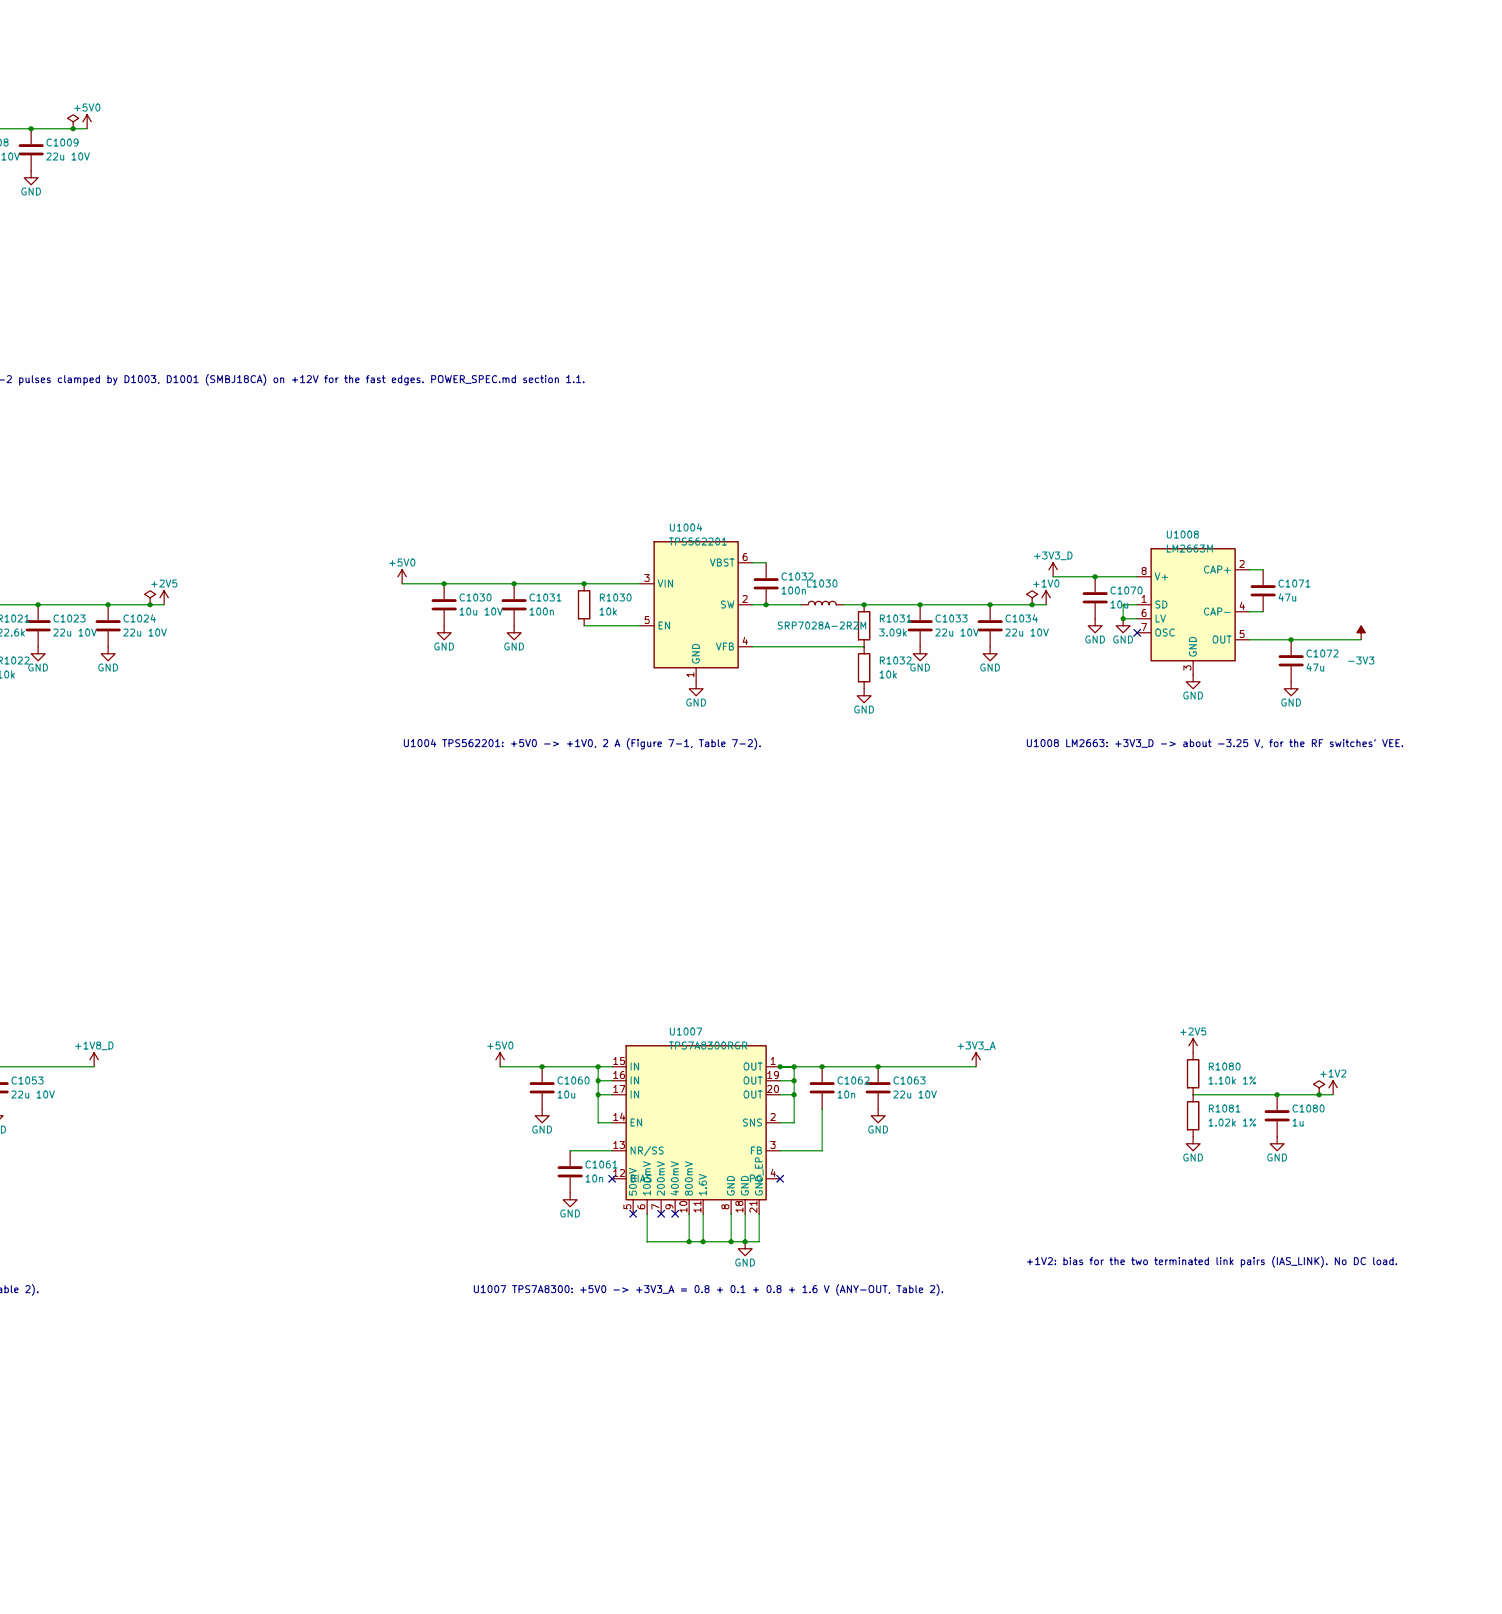
[picture p127: schematic POWER.kicad_sch, POWER - 12 V input, protection, bucks, LDOs, -3V3, part in row 1, column 2]

Parts:
C1001: 47u 25V; C_1210_3225Metric
C1002: 10u 25V; C_1206_3216Metric
C1003, C1091: 220n 25V; C_0603_1608Metric
C1004, C1080: 1u; C_0402_1005Metric
C1005, C1011, C1012, C1021, C1022, C1031, C1032: 100n; C_0402_1005Metric
C1006, C1007, C1008, C1009, C1013, C1014, C1023, C1024, C1033, C1034, C1043, C1053, C1063: 22u 10V; C_0805_2012Metric
C1010, C1020, C1030: 10u 10V; C_0805_2012Metric
C1040, C1050, C1060, C1070, C1092: 10u; C_0805_2012Metric
C1041, C1042, C1051, C1052, C1061, C1062: 10n; C_0402_1005Metric
C1071, C1072: 47u; C_1206_3216Metric
C1090: 100n 100V; C_0603_1608Metric
D1001: SMBJ18CA; D_SMB
D1003: SMCJ33CA; D_SMC
F1001: PTC 1.5A hold; Fuse_1812_4532Metric
F1002: PTC 0.5A hold; Fuse_1206_3216Metric
J1001: 12V IN; BarrelJack_CUI_PJ-102AH_Horizontal
J1002: FAN 5V; JST_PH_B2B-PH-K_1x02_P2.00mm_Vertical
L1001: SRP7028A-8R2M; L_Bourns_SRP7028A_7.3x6.6mm
L1010, L1020: SRP7028A-3R3M; L_Bourns_SRP7028A_7.3x6.6mm
L1030: SRP7028A-2R2M; L_Bourns_SRP7028A_7.3x6.6mm
Q1001, Q1003: DMT10H015LFG; Diodes_PowerDI3333-8
R1002: 100k; R_0402_1005Metric
R1003: 24.9k; R_0402_1005Metric
R1004: 100k; R_0603_1608Metric
R1005: 7.32k; R_0603_1608Metric
R1010, R1012, R1020, R1022, R1030, R1032: 10k; R_0402_1005Metric
R1011: 33.2k; R_0402_1005Metric
R1021: 22.6k; R_0402_1005Metric
R1031: 3.09k; R_0402_1005Metric
R1080: 1.10k 1%; R_0402_1005Metric
R1081: 1.02k 1%; R_0402_1005Metric
U1001: LMR33630ADDA; Texas_HSOP-8-1EP_3.9x4.9mm_P1.27mm
U1002, U1003, U1004: TPS562201; SOT-23-6
U1005, U1006, U1007: TPS7A8300RGR; QFN-20-1EP_3.5x3.5mm_P0.5mm_EP2x2mm
U1008: LM2663M; SOIC-8_3.9x4.9mm_P1.27mm
U1009: LM74502-Q1; SOT-23-8

Connections:
+1V0: C1033.1, C1034.1, L1030.2, R1031.1; also elsewhere on the board
+1V2: C1080.1, R1080.2, R1081.1; also elsewhere on the board
+1V8_A: C1042.1, C1043.1, U1005.1 (OUT), U1005.2 (SNS), U1005.19 (OUT), U1005.20 (OUT); also elsewhere on the board
+1V8_D: C1052.1, C1053.1, U1006.1 (OUT), U1006.2 (SNS), U1006.19 (OUT), U1006.20 (OUT); also elsewhere on the board
+2V5: C1023.1, C1024.1, C1040.1, L1020.2, R1021.1, R1080.1, U1005.14 (EN), U1005.15 (IN), U1005.16 (IN), U1005.17 (IN); also elsewhere on the board
+3V3_A: C1062.1, C1063.1, U1007.1 (OUT), U1007.2 (SNS), U1007.19 (OUT), U1007.20 (OUT); also elsewhere on the board
+3V3_D: C1013.1, C1014.1, C1050.1, C1070.1, L1010.2, R1011.1, U1006.14 (EN), U1006.15 (IN), U1006.16 (IN), U1006.17 (IN), U1008.8 (V+); also elsewhere on the board
+5V0: C1006.1, C1007.1, C1008.1, C1009.1, C1010.1, C1011.1, C1020.1, C1021.1, C1030.1, C1031.1, C1060.1, F1002.1, L1001.2, R1002.1, R1010.1, R1020.1, R1030.1, U1002.3 (VIN), U1003.3 (VIN), U1004.3 (VIN), U1007.14 (EN), U1007.15 (IN), U1007.16 (IN), U1007.17 (IN); also elsewhere on the board
+12V: C1001.1, C1002.1, C1003.1, D1001.2 (A2), Q1003.5 (D), U1001.2 (VIN), U1001.3 (EN)
-3V3: C1072.1, U1008.5 (OUT); also elsewhere on the board
/POWER/FAN_5V: C1092.1, F1002.2, J1002.1
/POWER/PROT_COM: Q1001.1 (S), Q1001.2 (S), Q1001.3 (S), Q1003.1 (S), Q1003.2 (S), Q1003.3 (S), U1009.8 (SRC)
/POWER/PROT_GATE: Q1001.4 (G), Q1003.4 (G), U1009.6 (GATE)
/POWER/PROT_OV: R1004.2, R1005.1, U1009.7 (OV)
/POWER/PROT_VCAP: C1091.2, U1009.4 (VCAP)
/POWER/VIN_F: C1090.1, C1091.1, D1003.2 (A2), F1001.2, Q1001.5 (D), R1004.1, U1009.1 (EN/UVLO), U1009.5 (VS)
GND: C1001.2, C1002.2, C1003.2, C1004.2, C1006.2, C1007.2, C1008.2, C1009.2, C1010.2, C1011.2, C1013.2, C1014.2, C1020.2, C1021.2, C1023.2, C1024.2, C1030.2, C1031.2, C1033.2, C1034.2, C1040.2, C1041.2, C1043.2, C1050.2, C1051.2, C1053.2, C1060.2, C1061.2, C1063.2, C1070.2, C1072.2, C1080.2, C1090.2, C1092.2, D1001.1 (A1), D1003.1 (A1), J1001.2, J1002.2, R1003.2, R1005.2, R1012.2, R1022.2, R1032.2, R1081.2, U1001.1 (PGND), U1001.9 (AGND_EP), U1002.1 (GND), U1003.1 (GND), U1004.1 (GND), U1005.5 (50mV), U1005.7 (200mV), U1005.8 (GND), U1005.10 (800mV), U1005.18 (GND), U1005.21 (GND_EP), U1006.7 (200mV), U1006.8 (GND), U1006.10 (800mV), U1006.18 (GND), U1006.21 (GND_EP), U1007.6 (100mV), U1007.8 (GND), U1007.10 (800mV), U1007.11 (1.6V), U1007.18 (GND), U1007.21 (GND_EP), U1008.1 (SD), U1008.3 (GND), U1008.6 (LV), U1009.2 (GND); also elsewhere on the board
unnamed: F1001.1, J1001.1
unnamed: C1005.1, U1001.7 (BOOT)
unnamed: R1002.2, R1003.1, U1001.5 (FB)
unnamed: C1005.2, L1001.1, U1001.8 (SW)
unnamed: C1004.1, U1001.6 (VCC)
unnamed: R1010.2, U1002.5 (EN)
unnamed: C1012.2, L1010.1, U1002.2 (SW)
unnamed: C1012.1, U1002.6 (VBST)
unnamed: R1011.2, R1012.1, U1002.4 (VFB)
unnamed: R1020.2, U1003.5 (EN)
unnamed: C1022.2, L1020.1, U1003.2 (SW)
unnamed: C1022.1, U1003.6 (VBST)
unnamed: R1021.2, R1022.1, U1003.4 (VFB)
unnamed: R1030.2, U1004.5 (EN)
unnamed: C1032.2, L1030.1, U1004.2 (SW)
unnamed: C1032.1, U1004.6 (VBST)
unnamed: R1031.2, R1032.1, U1004.4 (VFB)
unnamed: C1042.2, U1005.3 (FB)
unnamed: C1041.1, U1005.13 (NR/SS)
unnamed: C1052.2, U1006.3 (FB)
unnamed: C1051.1, U1006.13 (NR/SS)
unnamed: C1062.2, U1007.3 (FB)
unnamed: C1061.1, U1007.13 (NR/SS)
unnamed: C1071.1, U1008.2 (CAP+)
unnamed: C1071.2, U1008.4 (CAP-)

Notes on the sheet:
U1001 LMR33630: 12 V -> 5.0 V, 3 A, 400 kHz. Values: datasheet Table 9-2, 5 V row.
U1002 TPS562201: +5V0 -> +3V3_D, 2 A (Figure 7-1, Table 7-2).
U1003 TPS562201: +5V0 -> +2V5, 2 A (Figure 7-1, Table 7-2).
U1004 TPS562201: +5V0 -> +1V0, 2 A (Figure 7-1, Table 7-2).
U1005 TPS7A8300: +2V5 -> +1V8_A = 0.8 + 0.05 + 0.2 + 0.8 V (ANY-OUT, Table 2).
U1006 TPS7A8300: +3V3_D -> +1V8_D = 0.8 + 0.2 + 0.8 V (ANY-OUT, Table 2).
U1007 TPS7A8300: +5V0 -> +3V3_A = 0.8 + 0.1 + 0.8 + 1.6 V (ANY-OUT, Table 2).
U1008 LM2663: +3V3_D -> about -3.25 V, for the RF switches' VEE.
+1V2: bias for the two terminated link pairs (IAS_LINK). No DC load.
POWER - how this sheet works
1. 12 V in through a polyfuse, reverse-polarity P-MOSFET and TVS; LMR33630 makes +5V0 (3 A).
2. From +5V0: three TPS562201 bucks (+3V3_D, +2V5, +1V0) and the +3V3_A LDO.
3. TPS7A8300 LDOs: +1V8_A from +2V5, +1V8_D from +3V3_D. -3V3 from an LM2663 inverter.
4. +2V5 also powers the FPGA's LVDS banks (IAS_LINK_SPEC 3). +1V2 is a divider: bias only.
5. Every value comes from the datasheet's typical application: see docs/POWER_SPEC.md.
Input protection (Rev05, after the RF review): PTC, then SMCJ33CA at VIN_F, then back-to-back N-FETs Q1001/Q1003 driven by U1009 (LM74502-Q1): reverse battery to -65 V, overvoltage cut-off at 18.3 V typ (17.1-19.5 V) by R1004/R1005, ISO 7637-2 pulses clamped by D1003, D1001 (SMBJ18CA) on +12V for t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
