PabloSoage/kv260-ias2rf/CSI2-KRIA-KV260_Rev01.kicad_pcb

## KiCad design CSI2-KRIA-KV260_Rev01.kicad_pcb (continued)

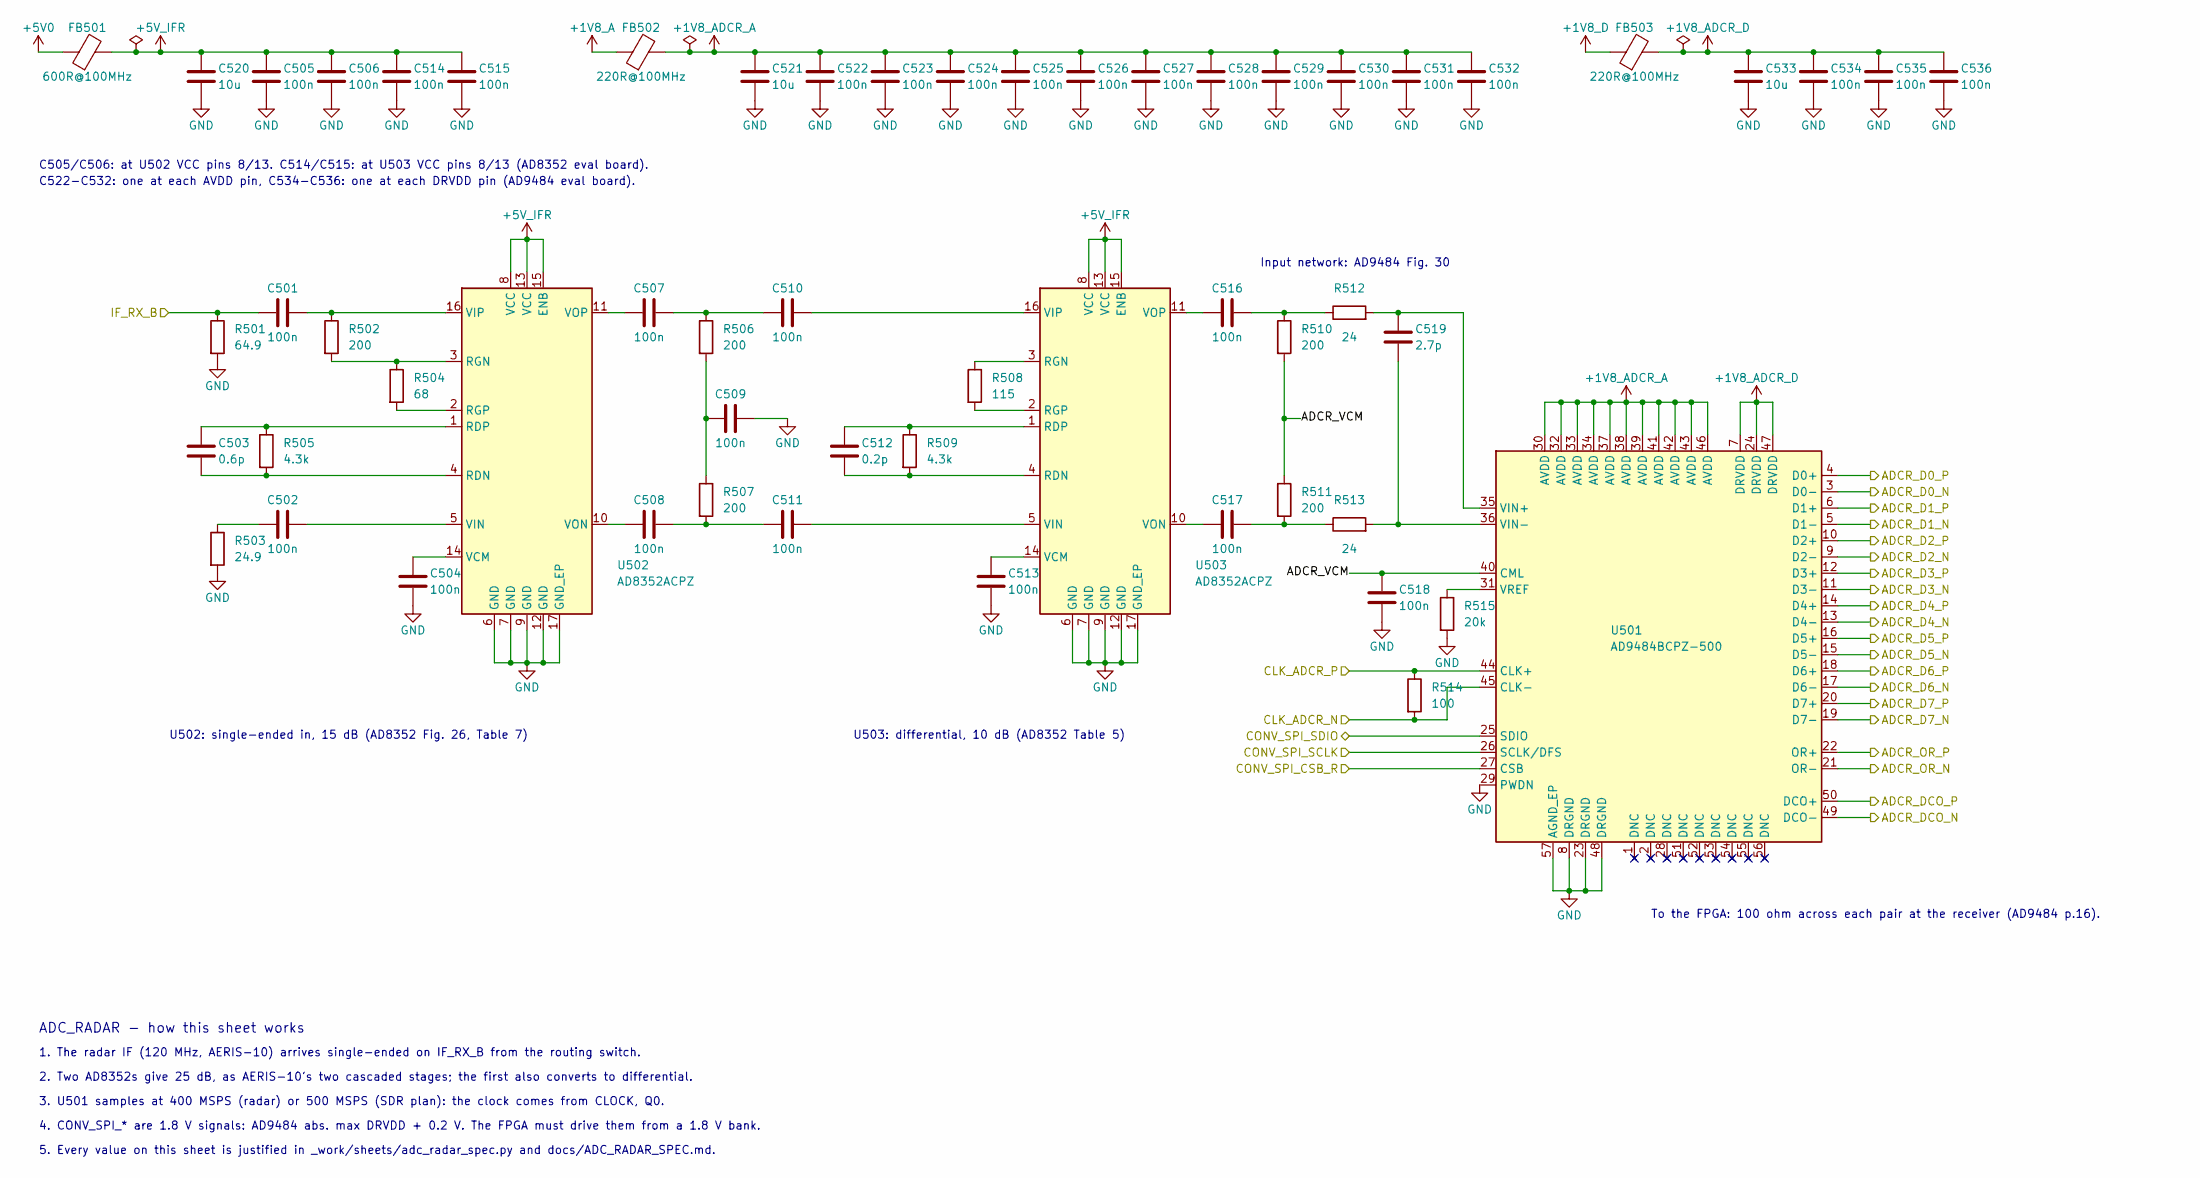
[picture p128: schematic ADC_RADAR.kicad_sch, ADC_RADAR - AD9484 radar ADC and its AD8352 drivers]

Parts:
C501, C502, C504, C505, C506, C507, C508, C509, C510, C511, C513, C514, C515, C516, C517, C518, C522, C523, C524, C525, C526, C527, C528, C529, C530, C531, C532, C534, C535, C536: 100n; C_0402_1005Metric
C503: 0.6p; C_0402_1005Metric
C512: 0.2p; C_0402_1005Metric
C519: 2.7p; C_0402_1005Metric
C520, C521, C533: 10u; C_0805_2012Metric
FB501: 600R@100MHz; L_0603_1608Metric
FB502, FB503: 220R@100MHz; L_0603_1608Metric
R501: 64.9; R_0402_1005Metric
R502, R506, R507, R510, R511: 200; R_0402_1005Metric
R503: 24.9; R_0402_1005Metric
R504: 68; R_0402_1005Metric
R505, R509: 4.3k; R_0402_1005Metric
R508: 115; R_0402_1005Metric
R512, R513: 24; R_0402_1005Metric
R514: 100; R_0402_1005Metric
R515: 20k; R_0402_1005Metric
U501: AD9484BCPZ-500; LFCSP-56-1EP_8x8mm_P0.5mm_EP5.1x5.1mm
U502, U503: AD8352ACPZ; LFCSP-16-1EP_3x3mm_P0.5mm_EP1.6x1.6mm

Connections:
+1V8_A: FB502.1; also elsewhere on the board
+1V8_ADCR_A: C521.1, C522.1, C523.1, C524.1, C525.1, C526.1, C527.1, C528.1, C529.1, C530.1, C531.1, C532.1, FB502.2, U501.30 (AVDD), U501.32 (AVDD), U501.33 (AVDD), U501.34 (AVDD), U501.37 (AVDD), U501.38 (AVDD), U501.39 (AVDD), U501.41 (AVDD), U501.42 (AVDD), U501.43 (AVDD), U501.46 (AVDD)
+1V8_ADCR_D: C533.1, C534.1, C535.1, C536.1, FB503.2, U501.7 (DRVDD), U501.24 (DRVDD), U501.47 (DRVDD)
+1V8_D: FB503.1; also elsewhere on the board
+5V0: FB501.1; also elsewhere on the board
+5V_IFR: C505.1, C506.1, C514.1, C515.1, C520.1, FB501.2, U502.8 (VCC), U502.13 (VCC), U502.15 (ENB), U503.8 (VCC), U503.13 (VCC), U503.15 (ENB)
/ADCR_D0_N: U501.3 (D0-); also elsewhere on the board
/ADCR_D0_P: U501.4 (D0+); also elsewhere on the board
/ADCR_D1_N: U501.5 (D1-); also elsewhere on the board
/ADCR_D1_P: U501.6 (D1+); also elsewhere on the board
/ADCR_D2_N: U501.9 (D2-); also elsewhere on the board
/ADCR_D2_P: U501.10 (D2+); also elsewhere on the board
/ADCR_D3_N: U501.11 (D3-); also elsewhere on the board
/ADCR_D3_P: U501.12 (D3+); also elsewhere on the board
/ADCR_D4_N: U501.13 (D4-); also elsewhere on the board
/ADCR_D4_P: U501.14 (D4+); also elsewhere on the board
/ADCR_D5_N: U501.15 (D5-); also elsewhere on the board
/ADCR_D5_P: U501.16 (D5+); also elsewhere on the board
/ADCR_D6_N: U501.17 (D6-); also elsewhere on the board
/ADCR_D6_P: U501.18 (D6+); also elsewhere on the board
/ADCR_D7_N: U501.19 (D7-); also elsewhere on the board
/ADCR_D7_P: U501.20 (D7+); also elsewhere on the board
/ADCR_DCO_N: U501.49 (DCO-); also elsewhere on the board
/ADCR_DCO_P: U501.50 (DCO+); also elsewhere on the board
/ADCR_OR_N: U501.21 (OR-); also elsewhere on the board
/ADCR_OR_P: U501.22 (OR+); also elsewhere on the board
/ADC_RADAR/ADCR_VCM: C518.1, R510.2, R511.1, U501.40 (CML)
/CLK_ADCR_N: R514.2, U501.45 (CLK-); also elsewhere on the board
/CLK_ADCR_P: R514.1, U501.44 (CLK+); also elsewhere on the board
/CONV_SPI_CSB_R: U501.27 (CSB); also elsewhere on the board
/CONV_SPI_SCLK: U501.26 (SCLK/DFS); also elsewhere on the board
/CONV_SPI_SDIO: U501.25 (SDIO); also elsewhere on the board
/IF_RX_B: C501.1, R501.1; also elsewhere on the board
GND: C504.2, C505.2, C506.2, C509.2, C513.2, C514.2, C515.2, C518.2, C520.2, C521.2, C522.2, C523.2, C524.2, C525.2, C526.2, C527.2, C528.2, C529.2, C530.2, C531.2, C532.2, C533.2, C534.2, C535.2, C536.2, R501.2, R503.2, R515.2, U501.8 (DRGND), U501.23 (DRGND), U501.29 (PWDN), U501.48 (DRGND), U501.57 (AGND_EP), U502.6 (GND), U502.7 (GND), U502.9 (GND), U502.12 (GND), U502.17 (GND_EP), U503.6 (GND), U503.7 (GND), U503.9 (GND), U503.12 (GND), U503.17 (GND_EP); also elsewhere on the board
unnamed: C502.1, R503.1
unnamed: C507.2, C510.1, R506.1
unnamed: C508.2, C511.1, R507.2
unnamed: C509.1, R506.2, R507.1
unnamed: C516.2, R510.1, R512.1
unnamed: C517.2, R511.2, R513.1
unnamed: C519.1, R512.2, U501.35 (VIN+)
unnamed: C519.2, R513.2, U501.36 (VIN-)
unnamed: R515.1, U501.31 (VREF)
unnamed: C503.2, R505.2, U502.4 (RDN)
unnamed: C503.1, R505.1, U502.1 (RDP)
unnamed: R502.2, R504.1, U502.3 (RGN)
unnamed: R504.2, U502.2 (RGP)
unnamed: C504.1, U502.14 (VCM)
unnamed: C502.2, U502.5 (VIN)
unnamed: C501.2, R502.1, U502.16 (VIP)
unnamed: C508.1, U502.10 (VON)
unnamed: C507.1, U502.11 (VOP)
unnamed: C512.2, R509.2, U503.4 (RDN)
unnamed: C512.1, R509.1, U503.1 (RDP)
unnamed: R508.1, U503.3 (RGN)
unnamed: R508.2, U503.2 (RGP)
unnamed: C513.1, U503.14 (VCM)
unnamed: C511.2, U503.5 (VIN)
unnamed: C510.2, U503.16 (VIP)
unnamed: C517.1, U503.10 (VON)
unnamed: C516.1, U503.11 (VOP)

Notes on the sheet:
C505/C506: at U502 VCC pins 8/13. C514/C515: at U503 VCC pins 8/13 (AD8352 eval board).
C522-C532: one at each AVDD pin, C534-C536: one at each DRVDD pin (AD9484 eval board).
U502: single-ended in, 15 dB (AD8352 Fig. 26, Table 7)
U503: differential, 10 dB (AD8352 Table 5)
Input network: AD9484 Fig. 30
To the FPGA: 100 ohm across each pair at the receiver (AD9484 p.16).
ADC_RADAR - how this sheet works
1. The radar IF (120 MHz, AERIS-10) arrives single-ended on IF_RX_B from the routing switch.
2. Two AD8352s give 25 dB, as AERIS-10's two cascaded stages; the first also converts to differential.
3. U501 samples at 400 MSPS (radar) or 500 MSPS (SDR plan): the clock comes from CLOCK, Q0.
4. CONV_SPI_* are 1.8 V signals: AD9484 abs. max DRVDD + 0.2 V. The FPGA must drive them from a 1.8 V bank.
5. Every value on this sheet is justified in _work/sheets/adc_radar_spec.py and docs/ADC_RADAR_SPEC.md.

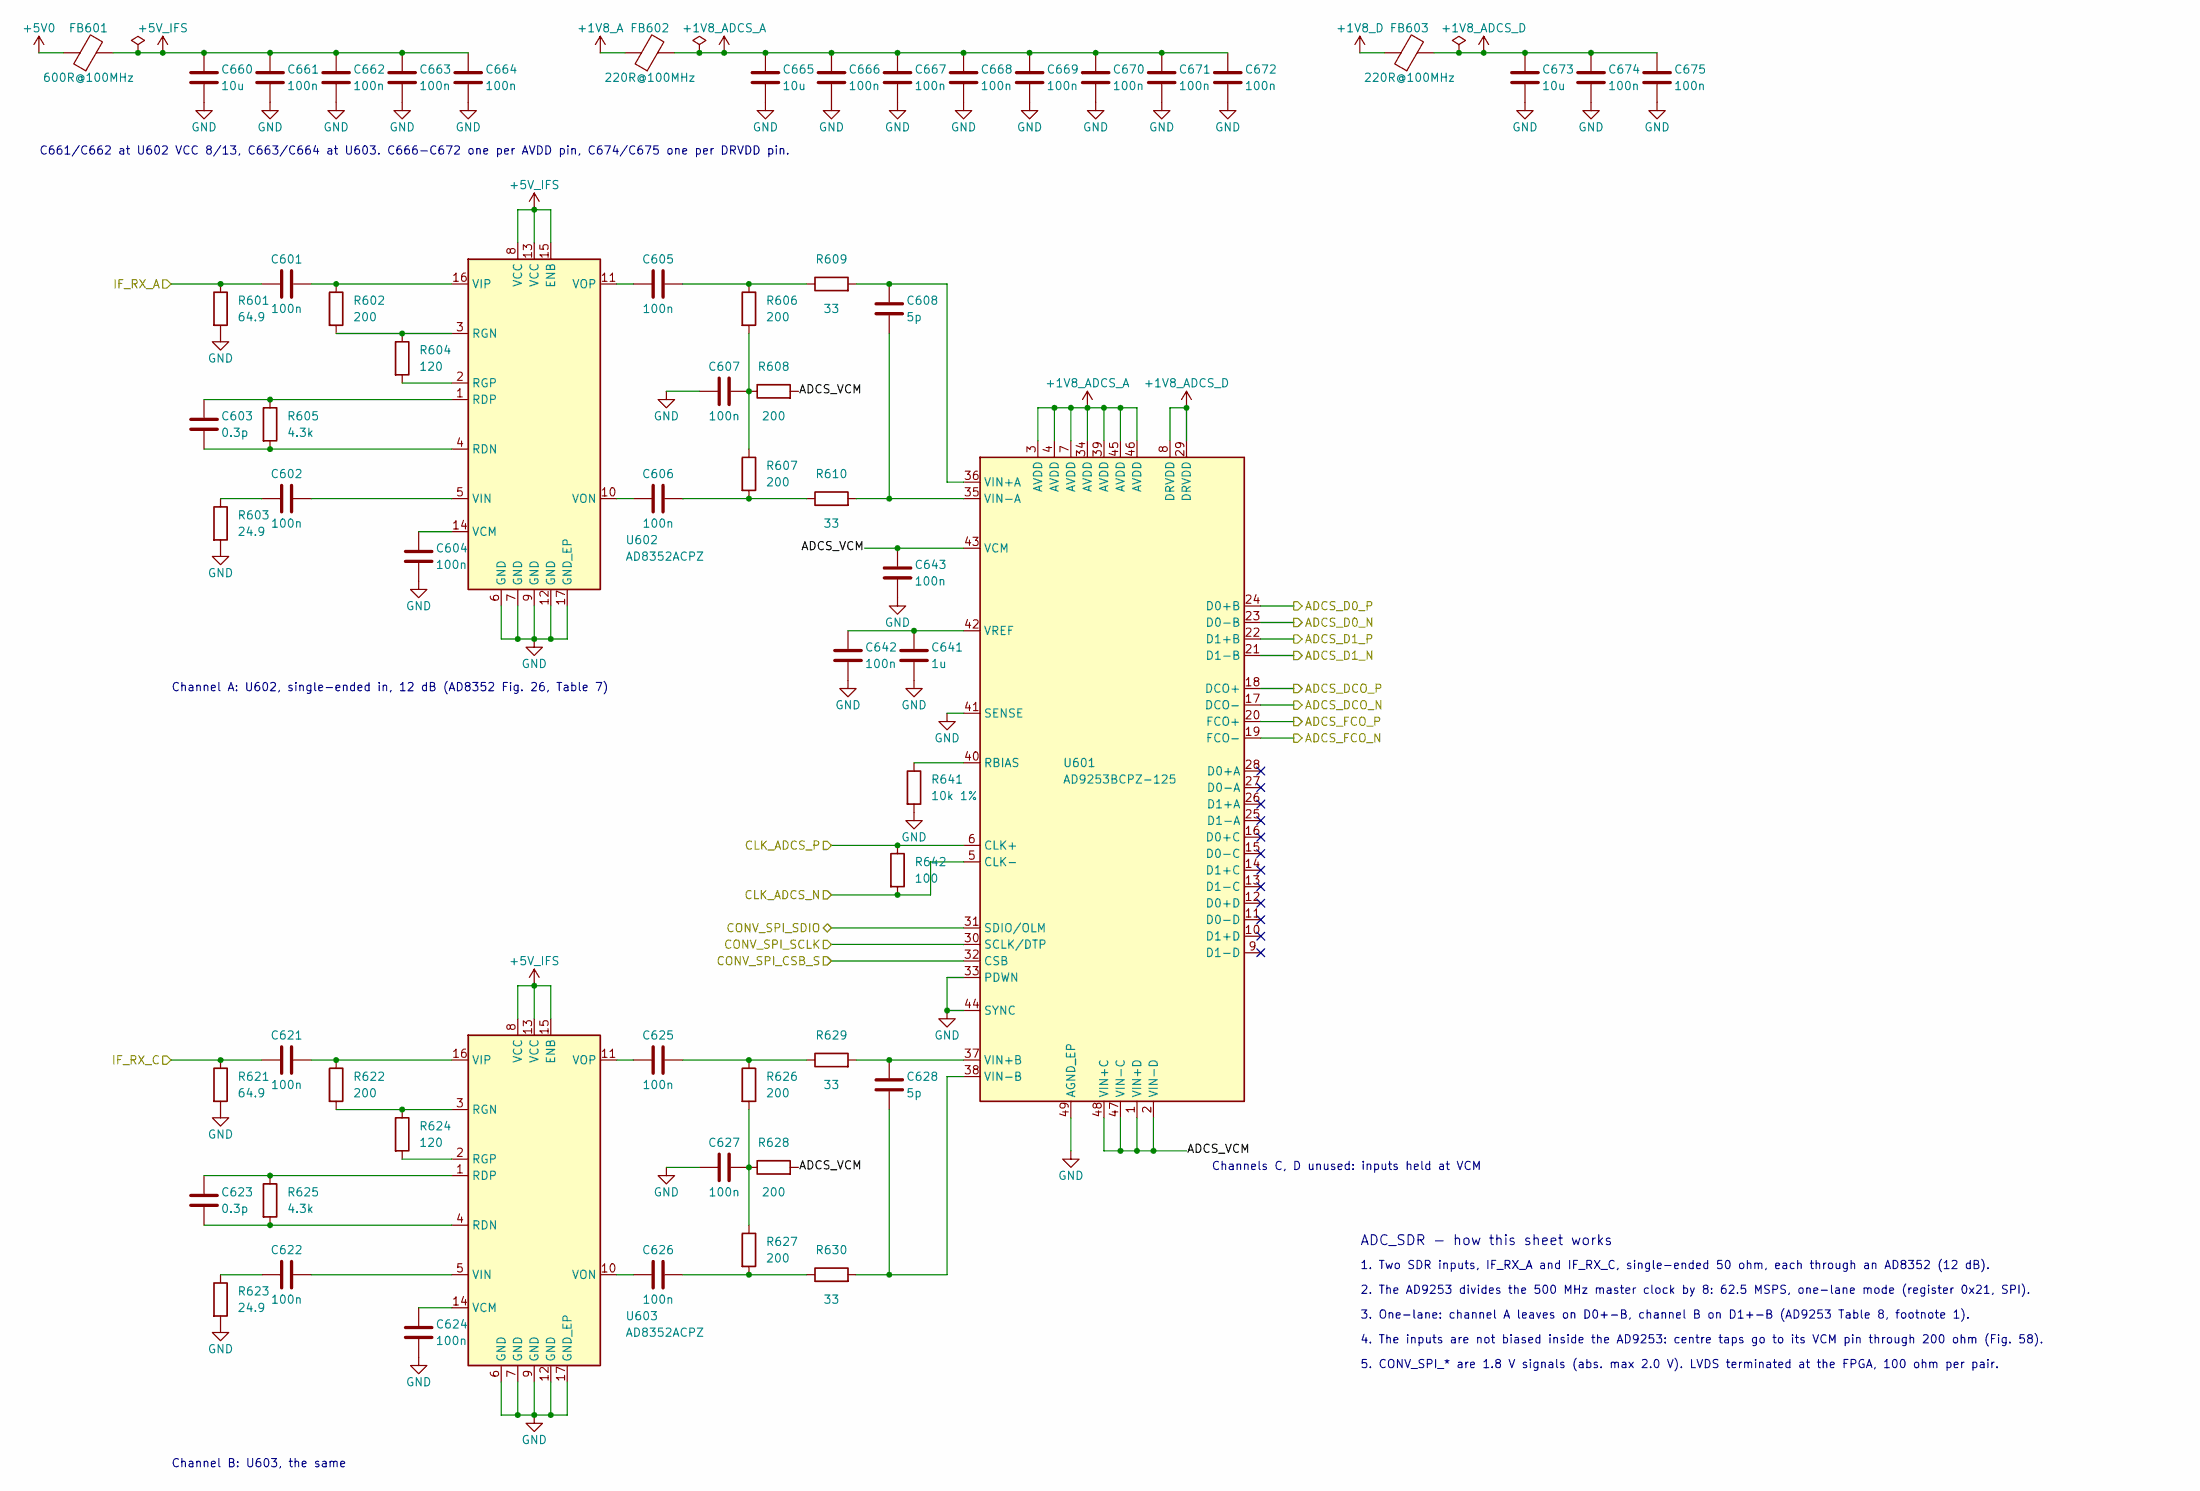
[picture p129: schematic ADC_SDR.kicad_sch, ADC_SDR - AD9253 SDR ADC, two channels, AD8352 drivers]

Parts:
C601, C602, C604, C605, C606, C607, C621, C622, C624, C625, C626, C627, C642, C643, C661, C662, C663, C664, C666, C667, C668, C669, C670, C671, C672, C674, C675: 100n; C_0402_1005Metric
C603, C623: 0.3p; C_0402_1005Metric
C608, C628: 5p; C_0402_1005Metric
C641: 1u; C_0402_1005Metric
C660, C665, C673: 10u; C_0805_2012Metric
FB601: 600R@100MHz; L_0603_1608Metric
FB602, FB603: 220R@100MHz; L_0603_1608Metric
R601, R621: 64.9; R_0402_1005Metric
R602, R606, R607, R608, R622, R626, R627, R628: 200; R_0402_1005Metric
R603, R623: 24.9; R_0402_1005Metric
R604, R624: 120; R_0402_1005Metric
R605, R625: 4.3k; R_0402_1005Metric
R609, R610, R629, R630: 33; R_0402_1005Metric
R641: 10k 1%; R_0402_1005Metric
R642: 100; R_0402_1005Metric
U601: AD9253BCPZ-125; QFN-48-1EP_7x7mm_P0.5mm_EP5.6x5.6mm
U602, U603: AD8352ACPZ; LFCSP-16-1EP_3x3mm_P0.5mm_EP1.6x1.6mm

Connections:
+1V8_A: FB602.1; also elsewhere on the board
+1V8_ADCS_A: C665.1, C666.1, C667.1, C668.1, C669.1, C670.1, C671.1, C672.1, FB602.2, U601.3 (AVDD), U601.4 (AVDD), U601.7 (AVDD), U601.34 (AVDD), U601.39 (AVDD), U601.45 (AVDD), U601.46 (AVDD)
+1V8_ADCS_D: C673.1, C674.1, C675.1, FB603.2, U601.8 (DRVDD), U601.29 (DRVDD)
+1V8_D: FB603.1; also elsewhere on the board
+5V0: FB601.1; also elsewhere on the board
+5V_IFS: C660.1, C661.1, C662.1, C663.1, C664.1, FB601.2, U602.8 (VCC), U602.13 (VCC), U602.15 (ENB), U603.8 (VCC), U603.13 (VCC), U603.15 (ENB)
/ADCS_D0_N: U601.23 (D0-B); also elsewhere on the board
/ADCS_D0_P: U601.24 (D0+B); also elsewhere on the board
/ADCS_D1_N: U601.21 (D1-B); also elsewhere on the board
/ADCS_D1_P: U601.22 (D1+B); also elsewhere on the board
/ADCS_DCO_N: U601.17 (DCO-); also elsewhere on the board
/ADCS_DCO_P: U601.18 (DCO+); also elsewhere on the board
/ADCS_FCO_N: U601.19 (FCO-); also elsewhere on the board
/ADCS_FCO_P: U601.20 (FCO+); also elsewhere on the board
/ADC_SDR/ADCS_VCM: C643.1, R608.2, R628.2, U601.1 (VIN+D), U601.2 (VIN-D), U601.43 (VCM), U601.47 (VIN-C), U601.48 (VIN+C)
/CLK_ADCS_N: R642.2, U601.5 (CLK-); also elsewhere on the board
/CLK_ADCS_P: R642.1, U601.6 (CLK+); also elsewhere on the board
/CONV_SPI_CSB_S: U601.32 (CSB); also elsewhere on the board
/CONV_SPI_SCLK: U601.30 (SCLK/DTP); also elsewhere on the board
/CONV_SPI_SDIO: U601.31 (SDIO/OLM); also elsewhere on the board
/IF_RX_A: C601.1, R601.1; also elsewhere on the board
/IF_RX_C: C621.1, R621.1; also elsewhere on the board
GND: C604.2, C607.1, C624.2, C627.1, C641.2, C642.2, C643.2, C660.2, C661.2, C662.2, C663.2, C664.2, C665.2, C666.2, C667.2, C668.2, C669.2, C670.2, C671.2, C672.2, C673.2, C674.2, C675.2, R601.2, R603.2, R621.2, R623.2, R641.2, U601.33 (PDWN), U601.41 (SENSE), U601.44 (SYNC), U601.49 (AGND_EP), U602.6 (GND), U602.7 (GND), U602.9 (GND), U602.12 (GND), U602.17 (GND_EP), U603.6 (GND), U603.7 (GND), U603.9 (GND), U603.12 (GND), U603.17 (GND_EP); also elsewhere on the board
unnamed: C602.1, R603.1
unnamed: C605.2, R606.1, R609.1
unnamed: C606.2, R607.2, R610.1
unnamed: C607.2, R606.2, R607.1, R608.1
unnamed: C622.1, R623.1
unnamed: C625.2, R626.1, R629.1
unnamed: C626.2, R627.2, R630.1
unnamed: C627.2, R626.2, R627.1, R628.1
unnamed: R641.1, U601.40 (RBIAS)
unnamed: C608.1, R609.2, U601.36 (VIN+A)
unnamed: C628.1, R629.2, U601.37 (VIN+B)
unnamed: C608.2, R610.2, U601.35 (VIN-A)
unnamed: C628.2, R630.2, U601.38 (VIN-B)
unnamed: C641.1, C642.1, U601.42 (VREF)
unnamed: C603.2, R605.2, U602.4 (RDN)
unnamed: C603.1, R605.1, U602.1 (RDP)
unnamed: R602.2, R604.1, U602.3 (RGN)
unnamed: R604.2, U602.2 (RGP)
unnamed: C604.1, U602.14 (VCM)
unnamed: C602.2, U602.5 (VIN)
unnamed: C601.2, R602.1, U602.16 (VIP)
unnamed: C606.1, U602.10 (VON)
unnamed: C605.1, U602.11 (VOP)
unnamed: C623.2, R625.2, U603.4 (RDN)
unnamed: C623.1, R625.1, U603.1 (RDP)
unnamed: R622.2, R624.1, U603.3 (RGN)
unnamed: R624.2, U603.2 (RGP)
unnamed: C624.1, U603.14 (VCM)
unnamed: C622.2, U603.5 (VIN)
unnamed: C621.2, R622.1, U603.16 (VIP)
unnamed: C626.1, U603.10 (VON)
unnamed: C625.1, U603.11 (VOP)

Notes on the sheet:
C661/C662 at U602 VCC 8/13, C663/C664 at U603. C666-C672 one per AVDD pin, C674/C675 one per DRVDD pin.
Channel A: U602, single-ended in, 12 dB (AD8352 Fig. 26, Table 7)
Channel B: U603, the same
Channels C, D unused: inputs held at VCM
ADC_SDR - how this sheet works
1. Two SDR inputs, IF_RX_A and IF_RX_C, single-ended 50 ohm, each through an AD8352 (12 dB).
2. The AD9253 divides the 500 MHz master clock by 8: 62.5 MSPS, one-lane mode (register 0x21, SPI).
3. One-lane: channel A leaves on D0+-B, channel B on D1+-B (AD9253 Table 8, footnote 1).
4. The inputs are not biased inside the AD9253: centre taps go to its VCM pin through 200 ohm (Fig. 58).
5. CONV_SPI_* are 1.8 V signals (abs. max 2.0 V). LVDS terminated at the FPGA, 100 ohm per pair.

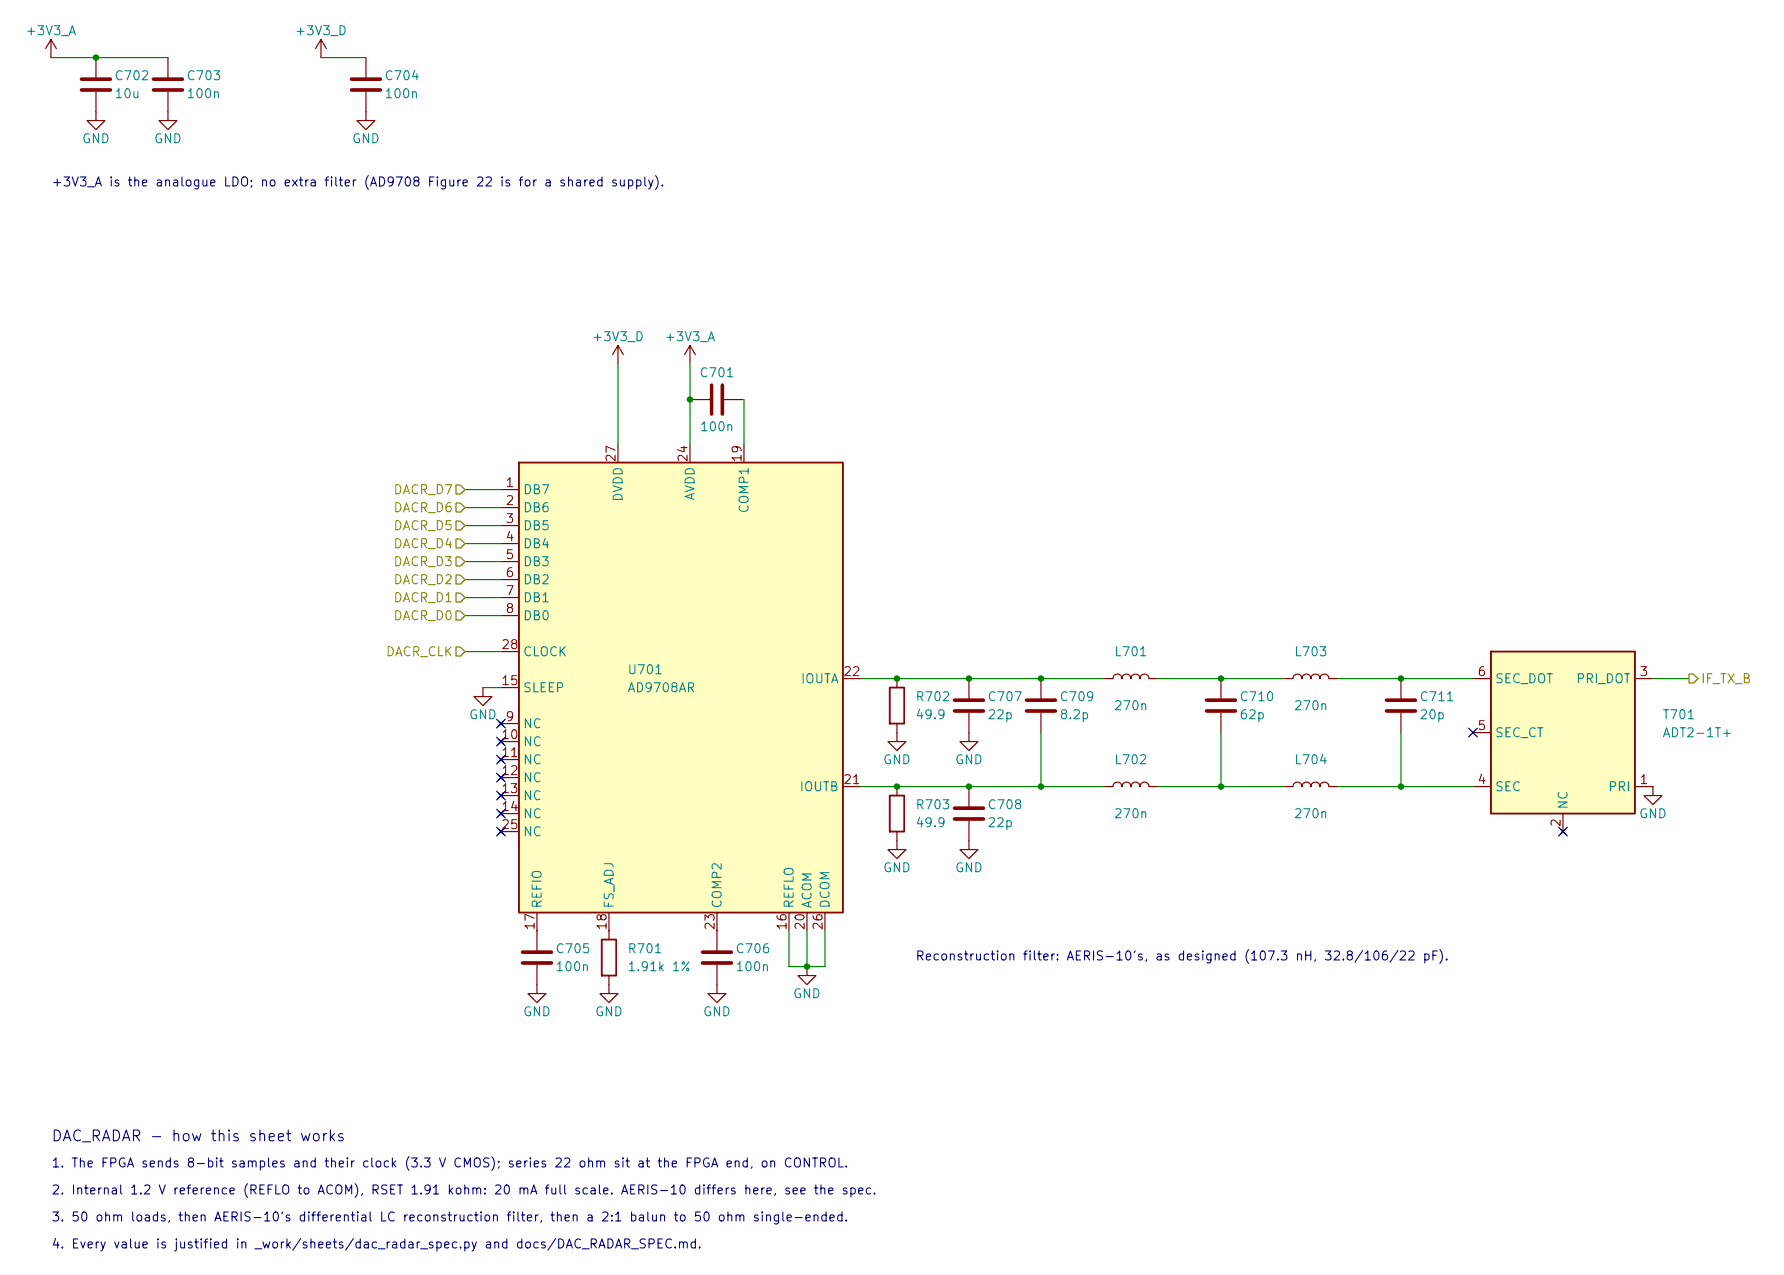
[picture p130: schematic DAC_RADAR.kicad_sch, DAC_RADAR - AD9708 radar chirp DAC, reconstruction filter, …]

Parts:
C701, C703, C704, C705, C706: 100n; C_0402_1005Metric
C702: 10u; C_0805_2012Metric
C707, C708: 22p; C_0402_1005Metric
C709: 8.2p; C_0402_1005Metric
C710: 62p; C_0402_1005Metric
C711: 20p; C_0402_1005Metric
L701, L702, L703, L704: 270n; L_0603_1608Metric
R701: 1.91k 1%; R_0402_1005Metric
R702, R703: 49.9; R_0402_1005Metric
T701: ADT2-1T+; Mini-Circuits_CD542_H2.84mm
U701: AD9708AR; SOIC-28W_7.5x17.9mm_P1.27mm

Connections:
+3V3_A: C701.1, C702.1, C703.1, U701.24 (AVDD); also elsewhere on the board
+3V3_D: C704.1, U701.27 (DVDD); also elsewhere on the board
/DACR_CLK: U701.28 (CLOCK); also elsewhere on the board
/DACR_D0: U701.8 (DB0); also elsewhere on the board
/DACR_D1: U701.7 (DB1); also elsewhere on the board
/DACR_D2: U701.6 (DB2); also elsewhere on the board
/DACR_D3: U701.5 (DB3); also elsewhere on the board
/DACR_D4: U701.4 (DB4); also elsewhere on the board
/DACR_D5: U701.3 (DB5); also elsewhere on the board
/DACR_D6: U701.2 (DB6); also elsewhere on the board
/DACR_D7: U701.1 (DB7); also elsewhere on the board
/IF_TX_B: T701.3 (PRI_DOT); also elsewhere on the board
GND: C702.2, C703.2, C704.2, C705.2, C706.2, C707.2, C708.2, R701.2, R702.2, R703.2, T701.1 (PRI), U701.15 (SLEEP), U701.16 (REFLO), U701.20 (ACOM), U701.26 (DCOM); also elsewhere on the board
unnamed: C710.1, L701.2, L703.1
unnamed: C710.2, L702.2, L704.1
unnamed: C711.2, L704.2, T701.4 (SEC)
unnamed: C711.1, L703.2, T701.6 (SEC_DOT)
unnamed: C701.2, U701.19 (COMP1)
unnamed: C706.1, U701.23 (COMP2)
unnamed: R701.1, U701.18 (FS_ADJ)
unnamed: C707.1, C709.1, L701.1, R702.1, U701.22 (IOUTA)
unnamed: C708.1, C709.2, L702.1, R703.1, U701.21 (IOUTB)
unnamed: C705.1, U701.17 (REFIO)

Notes on the sheet:
+3V3_A is the analogue LDO; no extra filter (AD9708 Figure 22 is for a shared supply).
Reconstruction filter: AERIS-10's, as designed (107.3 nH, 32.8/106/22 pF).
DAC_RADAR - how this sheet works
1. The FPGA sends 8-bit samples and their clock (3.3 V CMOS); series 22 ohm sit at the FPGA end, on CONTROL.
2. Internal 1.2 V reference (REFLO to ACOM), RSET 1.91 kohm: 20 mA full scale. AERIS-10 differs here, see the spec.
3. 50 ohm loads, then AERIS-10's differential LC reconstruction filter, then a 2:1 balun to 50 ohm single-ended.
4. Every value is justified in _work/sheets/dac_radar_spec.py and docs/DAC_RADAR_SPEC.md.

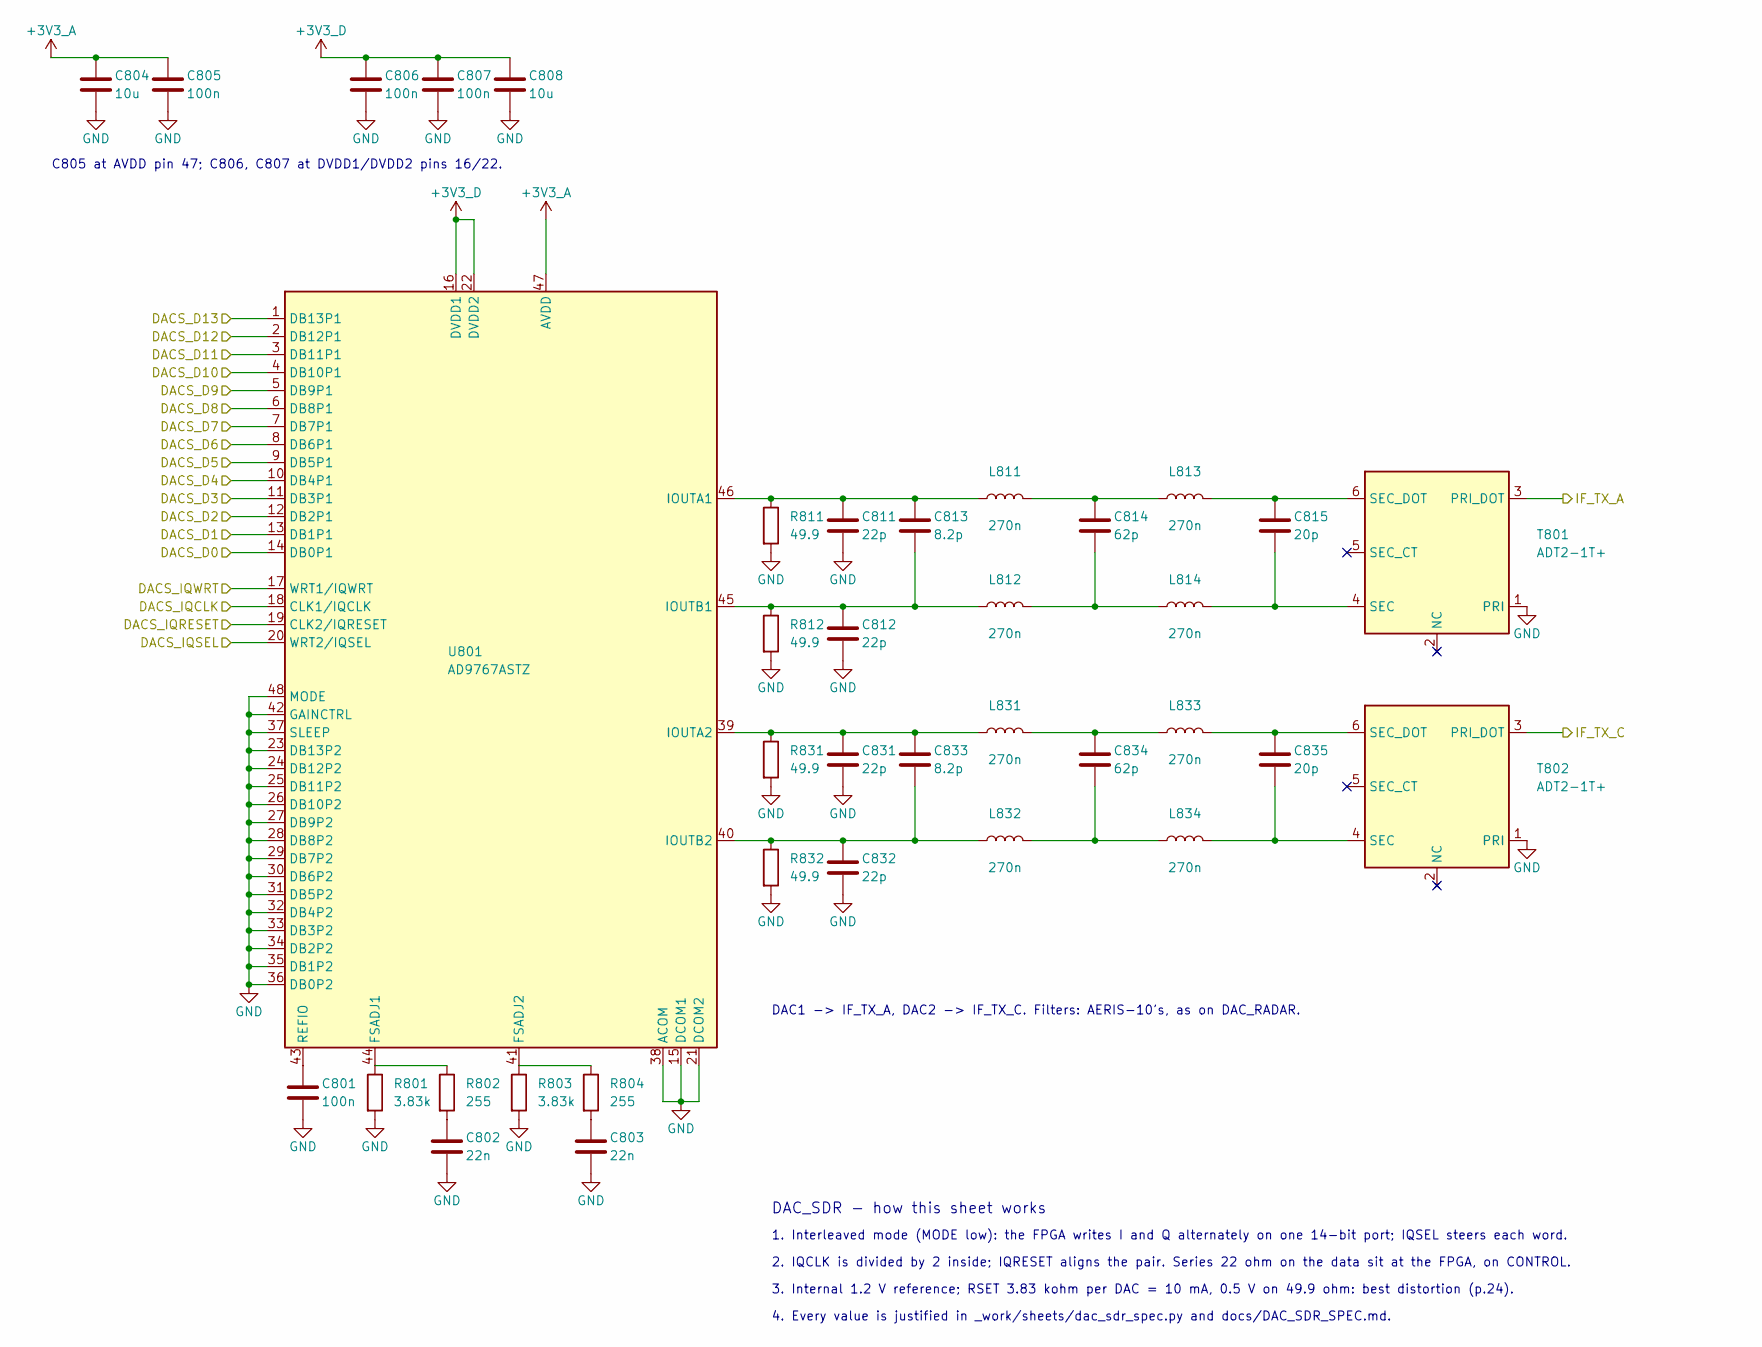
[picture p131: schematic DAC_SDR.kicad_sch, DAC_SDR - AD9767 dual SDR DAC, interleaved, filters and bal…]

Parts:
C801, C805, C806, C807: 100n; C_0402_1005Metric
C802, C803: 22n; C_0402_1005Metric
C804, C808: 10u; C_0805_2012Metric
C811, C812, C831, C832: 22p; C_0402_1005Metric
C813, C833: 8.2p; C_0402_1005Metric
C814, C834: 62p; C_0402_1005Metric
C815, C835: 20p; C_0402_1005Metric
L811, L812, L813, L814, L831, L832, L833, L834: 270n; L_0603_1608Metric
R801, R803: 3.83k; R_0402_1005Metric
R802, R804: 255; R_0402_1005Metric
R811, R812, R831, R832: 49.9; R_0402_1005Metric
T801, T802: ADT2-1T+; Mini-Circuits_CD542_H2.84mm
U801: AD9767ASTZ; LQFP-48_7x7mm_P0.5mm

Connections:
+3V3_A: C804.1, C805.1, U801.47 (AVDD); also elsewhere on the board
+3V3_D: C806.1, C807.1, C808.1, U801.16 (DVDD1), U801.22 (DVDD2); also elsewhere on the board
/DACS_D0: U801.14 (DB0P1); also elsewhere on the board
/DACS_D1: U801.13 (DB1P1); also elsewhere on the board
/DACS_D2: U801.12 (DB2P1); also elsewhere on the board
/DACS_D3: U801.11 (DB3P1); also elsewhere on the board
/DACS_D4: U801.10 (DB4P1); also elsewhere on the board
/DACS_D5: U801.9 (DB5P1); also elsewhere on the board
/DACS_D6: U801.8 (DB6P1); also elsewhere on the board
/DACS_D7: U801.7 (DB7P1); also elsewhere on the board
/DACS_D8: U801.6 (DB8P1); also elsewhere on the board
/DACS_D9: U801.5 (DB9P1); also elsewhere on the board
/DACS_D10: U801.4 (DB10P1); also elsewhere on the board
/DACS_D11: U801.3 (DB11P1); also elsewhere on the board
/DACS_D12: U801.2 (DB12P1); also elsewhere on the board
/DACS_D13: U801.1 (DB13P1); also elsewhere on the board
/DACS_IQCLK: U801.18 (CLK1/IQCLK); also elsewhere on the board
/DACS_IQRESET: U801.19 (CLK2/IQRESET); also elsewhere on the board
/DACS_IQSEL: U801.20 (WRT2/IQSEL); also elsewhere on the board
/DACS_IQWRT: U801.17 (WRT1/IQWRT); also elsewhere on the board
/IF_TX_A: T801.3 (PRI_DOT); also elsewhere on the board
/IF_TX_C: T802.3 (PRI_DOT); also elsewhere on the board
GND: C801.2, C802.2, C803.2, C804.2, C805.2, C806.2, C807.2, C808.2, C811.2, C812.2, C831.2, C832.2, R801.2, R803.2, R811.2, R812.2, R831.2, R832.2, T801.1 (PRI), T802.1 (PRI), U801.15 (DCOM1), U801.21 (DCOM2), U801.23 (DB13P2), U801.24 (DB12P2), U801.25 (DB11P2), U801.26 (DB10P2), U801.27 (DB9P2), U801.28 (DB8P2), U801.29 (DB7P2), U801.30 (DB6P2), U801.31 (DB5P2), U801.32 (DB4P2), U801.33 (DB3P2), U801.34 (DB2P2), U801.35 (DB1P2), U801.36 (DB0P2), U801.37 (SLEEP), U801.38 (ACOM), U801.42 (GAINCTRL), U801.48 (MODE); also elsewhere on the board
unnamed: C802.1, R802.2
unnamed: C803.1, R804.2
unnamed: C814.1, L811.2, L813.1
unnamed: C814.2, L812.2, L814.1
unnamed: C834.1, L831.2, L833.1
unnamed: C834.2, L832.2, L834.1
unnamed: C815.2, L814.2, T801.4 (SEC)
unnamed: C815.1, L813.2, T801.6 (SEC_DOT)
unnamed: C835.2, L834.2, T802.4 (SEC)
unnamed: C835.1, L833.2, T802.6 (SEC_DOT)
unnamed: R801.1, R802.1, U801.44 (FSADJ1)
unnamed: R803.1, R804.1, U801.41 (FSADJ2)
unnamed: C811.1, C813.1, L811.1, R811.1, U801.46 (IOUTA1)
unnamed: C831.1, C833.1, L831.1, R831.1, U801.39 (IOUTA2)
unnamed: C812.1, C813.2, L812.1, R812.1, U801.45 (IOUTB1)
unnamed: C832.1, C833.2, L832.1, R832.1, U801.40 (IOUTB2)
unnamed: C801.1, U801.43 (REFIO)

Notes on the sheet:
C805 at AVDD pin 47; C806, C807 at DVDD1/DVDD2 pins 16/22.
DAC1 -> IF_TX_A, DAC2 -> IF_TX_C. Filters: AERIS-10's, as on DAC_RADAR.
DAC_SDR - how this sheet works
1. Interleaved mode (MODE low): the FPGA writes I and Q alternately on one 14-bit port; IQSEL steers each word.
2. IQCLK is divided by 2 inside; IQRESET aligns the pair. Series 22 ohm on the data sit at the FPGA, on CONTROL.
3. Internal 1.2 V reference; RSET 3.83 kohm per DAC = 10 mA, 0.5 V on 49.9 ohm: best distortion (p.24).
4. Every value is justified in _work/sheets/dac_sdr_spec.py and docs/DAC_SDR_SPEC.md.
