PabloSoage/kv260-ias2rf/CSI2-KRIA-KV260_Rev01.kicad_pcb

## KiCad design CSI2-KRIA-KV260_Rev01.kicad_pcb (continued)

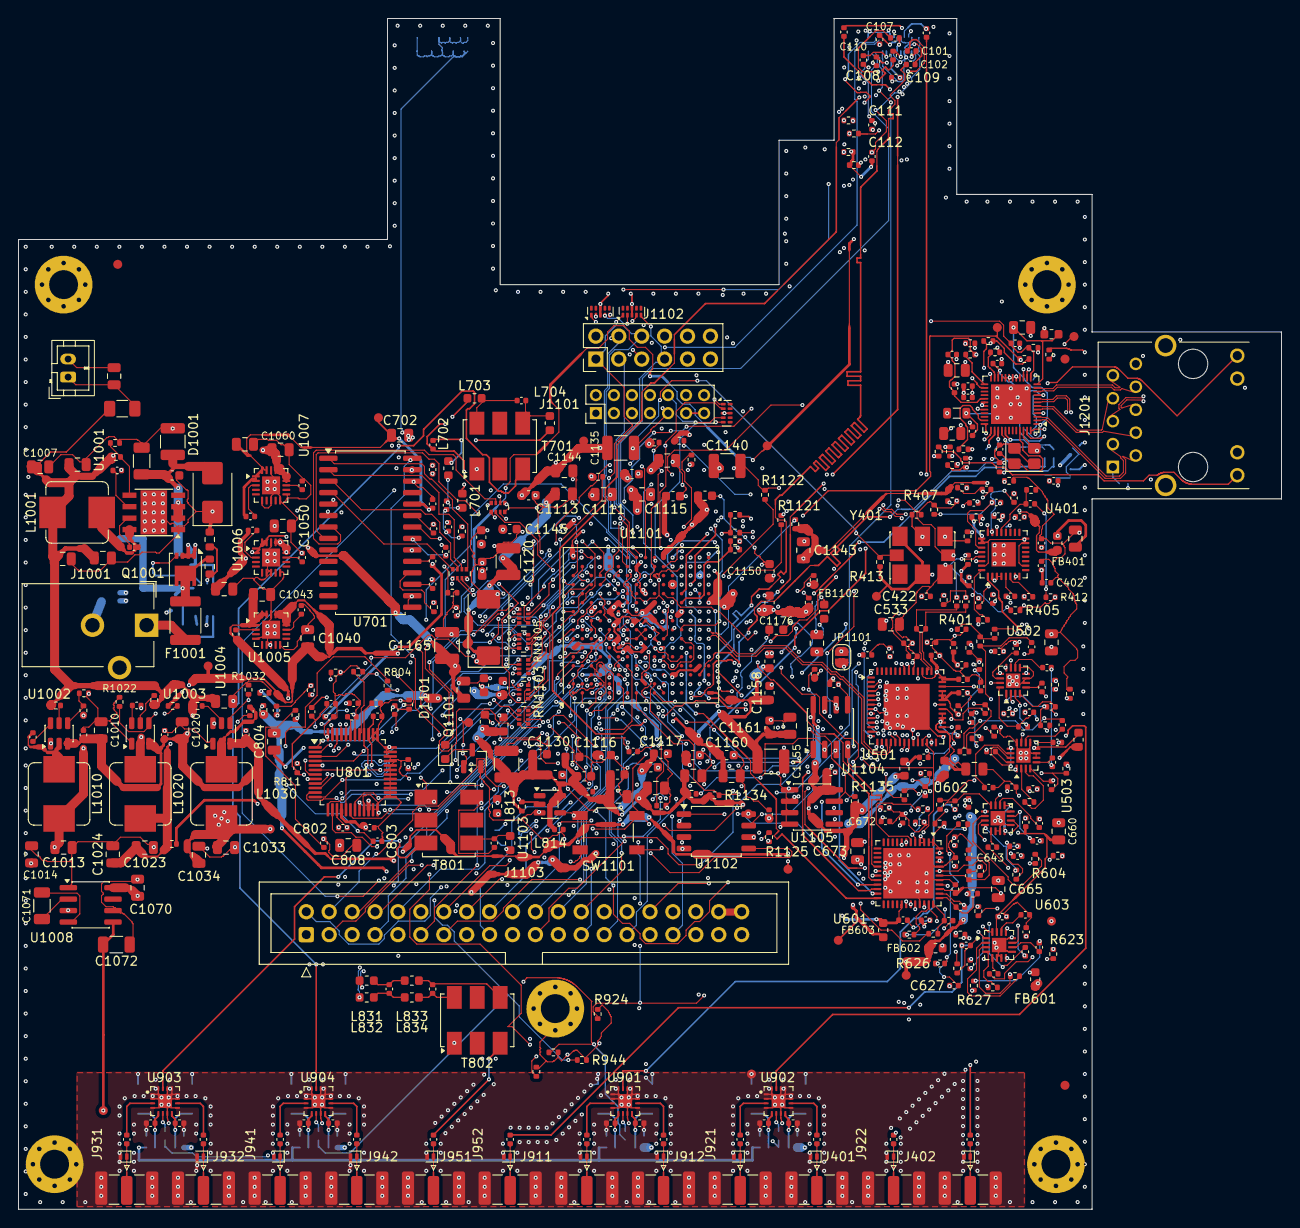
[picture p132: board CSI2-KRIA-KV260_Rev01.kicad_pcb from above]

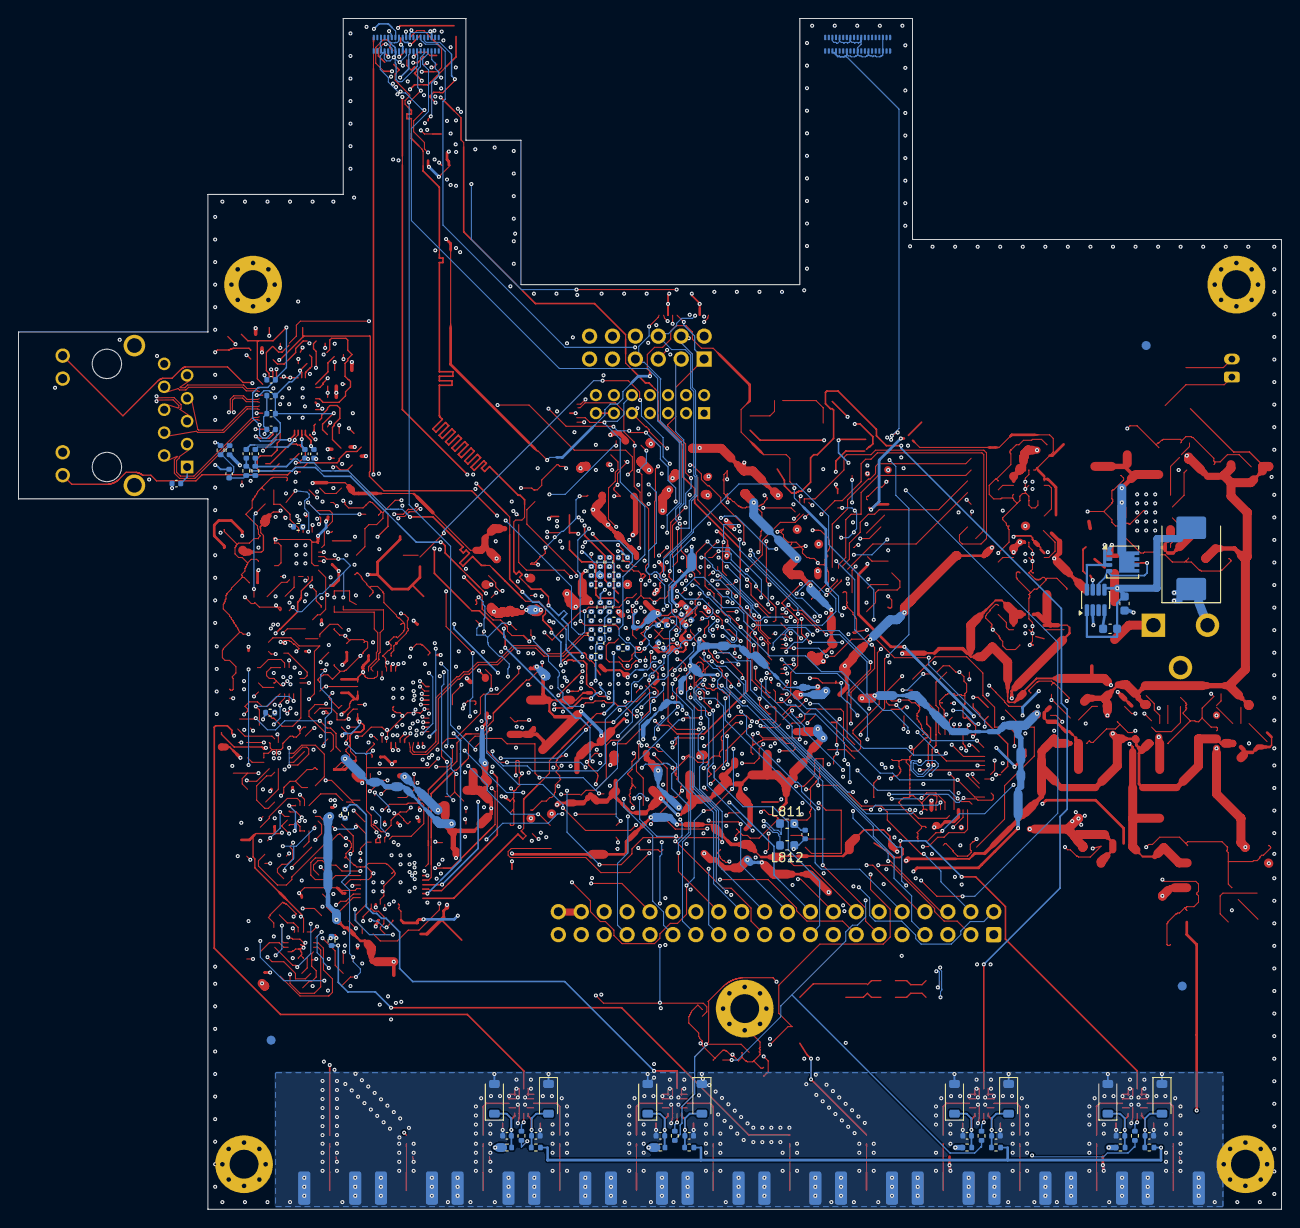
[picture p133: board CSI2-KRIA-KV260_Rev01.kicad_pcb from below]

Board: 8 copper layers, 140.0 x 132.0 mm, 578 parts (79 on the bottom side), 420 nets.

Other parts of the board:
FID1, FID2, FID3, FID4, FID5, FID6: Fiducial_1mm_Mask2mm
H1, H2, H3, H4, H5: MountingHole_3.2mm_M3_Pad_Via
TP1: +5V0; TestPad_D1.0mm_BoardOnly
TP2: +3V3_D; TestPad_D1.0mm_BoardOnly
TP3: +3V3_A; TestPad_D1.0mm_BoardOnly
TP4: +2V5; TestPad_D1.0mm_BoardOnly
TP5: +1V8_D; TestPad_D1.0mm_BoardOnly
TP6: +1V8_A; TestPad_D1.0mm_BoardOnly
TP7: +1V2; TestPad_D1.0mm_BoardOnly
TP8: +1V0; TestPad_D1.0mm_BoardOnly
TP9: -3V3; TestPad_D1.0mm_BoardOnly
TP10: +3V3_CLK; TestPad_D1.0mm_BoardOnly
TP11: DONE; TestPad_D1.0mm_BoardOnly
TP12, TP13: GND; TestPad_D1.0mm_BoardOnly
TP14: MDC; TestPad_D1.0mm_BoardOnly
TP15: MDIO; TestPad_D1.0mm_BoardOnly

Their connections:
+1V0: TP8.1; also elsewhere on the board
+1V2: TP7.1; also elsewhere on the board
+1V8_A: TP6.1; also elsewhere on the board
+1V8_D: TP5.1; also elsewhere on the board
+2V5: TP4.1; also elsewhere on the board
+3V3_A: TP3.1; also elsewhere on the board
+3V3_CLK: TP10.1; also elsewhere on the board
+3V3_D: TP2.1; also elsewhere on the board
+5V0: TP1.1; also elsewhere on the board
-3V3: TP9.1; also elsewhere on the board
/CONTROL/DONE: TP11.1; also elsewhere on the board
/CONTROL/ETH_MDC: TP14.1; also elsewhere on the board
/CONTROL/ETH_MDIO: TP15.1; also elsewhere on the board
GND: H1.1, H2.1, H3.1, H4.1, H5.1, TP12.1, TP13.1; also elsewhere on the board
