PabloSoage/kv260-ias2rf/_backup_original/CSI2-KRIA-KV260_Rev01.kicad_pcb

## KiCad design _backup_original/CSI2-KRIA-KV260_Rev01.kicad_pcb (2026-08-14)

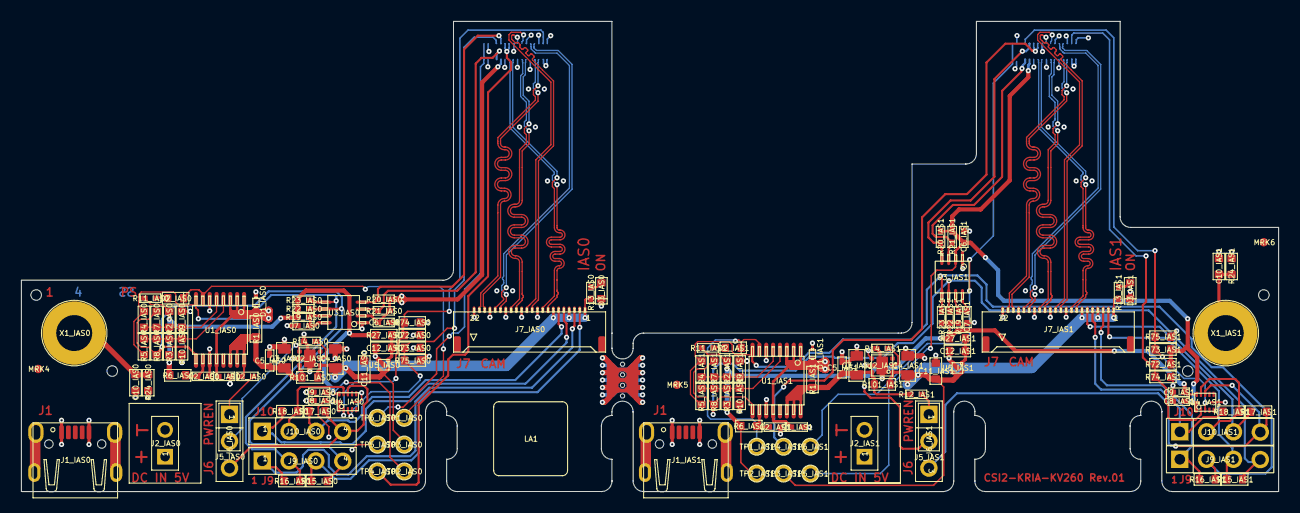
[picture p134: board _backup_original/CSI2-KRIA-KV260_Rev01.kicad_pcb from above]

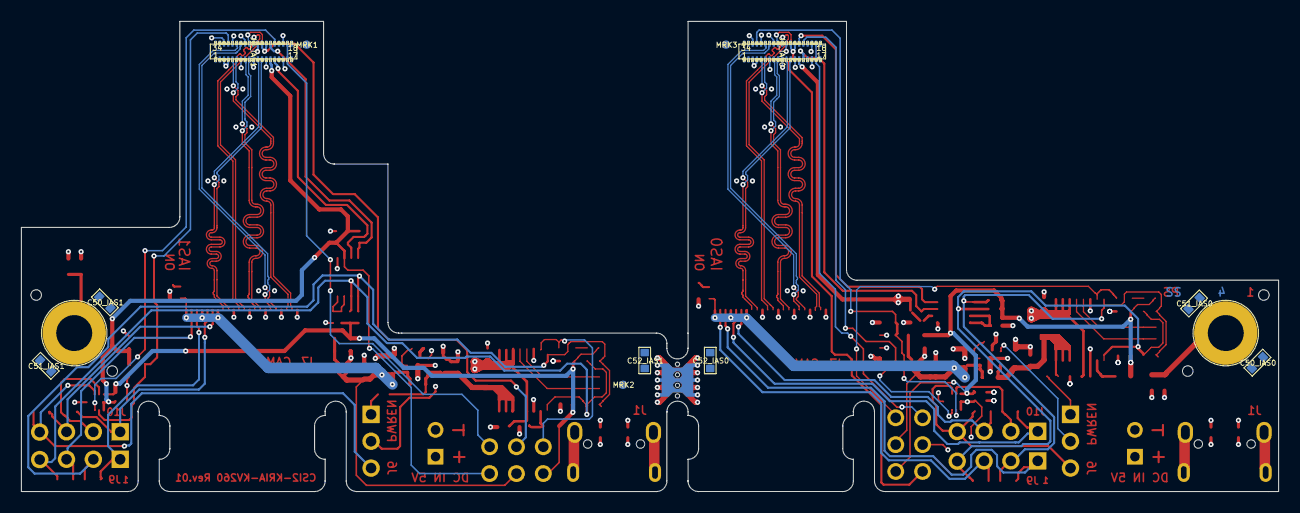
[picture p135: board _backup_original/CSI2-KRIA-KV260_Rev01.kicad_pcb from below]

Board: 4 copper layers, 119.0 x 44.5 mm, 145 parts (12 on the bottom side), 82 nets.

Parts:
C1_IAS0, C1_IAS1, C2_IAS0, C2_IAS1: NL; C-0402_0.55
C3_IAS0, C3_IAS1, C4_IAS0, C4_IAS1: 10u; C-0805_1.4
C5_IAS0, C5_IAS1, C6_IAS0, C6_IAS1, C8_IAS0, C8_IAS1, C9_IAS0, C9_IAS1: 100n; C-0402_0.55
C7_IAS0, C7_IAS1: 100p; C-0402_0.55
C10_IAS0, C10_IAS1: NL; C-0603_1.0
C11_IAS0, C11_IAS1, C12_IAS0, C12_IAS1, C50_IAS0, C50_IAS1, C51_IAS0, C51_IAS1, C52_IAS0, C52_IAS1: 4u7; C-0603_1.0
D1_IAS0, D1_IAS1: ESD9B5.0ST5G; D-SOD923
D2_IAS0, D2_IAS1: RED; D-0603-LED
D3_IAS0, D3_IAS1: GREEN; D-0603-LED
J1_IAS0, J1_IAS1: USB 2.0 Typ B 90°; J-629105150521
J2_IAS0, J2_IAS1: CON1x2; CON 1x2 RM2.54
J5_IAS0, J5_IAS1: Jumper; J-JUMPER-2.54
J6_IAS0, J6_IAS1: CON1x3; CON 1x3 RM2.54
J7_IAS0, J7_IAS1: CON FFC22_Inverted; J-FH55-22S-0.5SH - Inverted Pins
J8_IAS0, J8_IAS1: BM20B(0.8)-34DP-0.4V(51); J-BM20B(0.8)-34DP
J9_IAS0, J9_IAS1, J10_IAS0, J10_IAS1: CON1x4; CON 1x4 RM2.54
LA1: LABEL 7x7mm; PCB LABEL 7x7
MRK1, MRK2, MRK3: Marker Single Layer; PCB_Marker_Pad_top
MRK4, MRK5, MRK6: Marker Single Layer; PCB_MARKER_PAD_TOP
R1_IAS0, R1_IAS1, R3_IAS0, R3_IAS1, R9_IAS0, R9_IAS1, R15_IAS0, R15_IAS1, R16_IAS0, R16_IAS1, R24_IAS0, R24_IAS1, R27_IAS0, R27_IAS1: 0R0; R-0603_0.6
R2_IAS0, R2_IAS1, R4_IAS0, R4_IAS1, R5_IAS0, R5_IAS1, R6_IAS0, R6_IAS1, R7_IAS0, R7_IAS1, R8_IAS0, R8_IAS1, R10_IAS0, R10_IAS1, R17_IAS0, R17_IAS1, R18_IAS0, R18_IAS1, R72_IAS0, R72_IAS1, R73_IAS0, R73_IAS1, R74_IAS0, R74_IAS1, R75_IAS0, R75_IAS1, R101_IAS0, R101_IAS1: NL; R-0603_0.6
R11_IAS0, R11_IAS1: NL; R-0402_0.4
R12_IAS0: 270k; R-0402_0.4
R12_IAS1: 270K; R-0402_0.4
R13_IAS0, R13_IAS1: 3k3; R-0402_0.4
R14_IAS0, R14_IAS1: 51k; R-0402_0.4
R19_IAS0, R19_IAS1: 200k; R-0402_0.4
R20_IAS0, R20_IAS1, R21_IAS0, R21_IAS1, R22_IAS0, R22_IAS1, R23_IAS0, R23_IAS1: 2k0; R-0402_0.4
T1: PCB Text TOP; PCB TEXTFIELD TOP 2
T2: PCB Text BOT; PCB TEXTFIELD BOT 2
TP1_IAS0, TP1_IAS1, TP2_IAS0, TP2_IAS1, TP3_IAS0, TP3_IAS1, TP4_IAS0, TP4_IAS1, TP5_IAS0, TP5_IAS1, TP6_IAS0, TP6_IAS1: TP; TP_16_10
U1_IAS0, U1_IAS1: INA260AIPWR; IC-TSSOP16 6.4x5.1x1.2
U2_IAS0, U2_IAS1: TPS25200DRVT; IC-DFN06_2.0x2.0x0.8
U3_IAS0, U3_IAS1: PCA9306DCTR; IC-TSSOP8_3.15x4.25x1.3
U4_IAS0, U4_IAS1: NTB0104GU12,115; IC-XQFN12_1.7x2x0.5
U5_IAS0, U5_IAS1: NCP114AMX330TCG; IC-XDFN4_1.0x1.0x0.6
X1_IAS0, X1_IAS1: Hole; HOLE-3.4-6.0-DK

Connections:
B7-CSI2-TXC_IAS0_N: J7_IAS0.14, J8_IAS0.8
B7-CSI2-TXC_IAS0_P: J7_IAS0.15, J8_IAS0.7
B7-CSI2-TXC_IAS1_N: J7_IAS1.14, J8_IAS1.8
B7-CSI2-TXC_IAS1_P: J7_IAS1.15, J8_IAS1.7
B7-CSI2-TXD0_IAS0_N: J7_IAS0.20, J8_IAS0.5
B7-CSI2-TXD0_IAS0_P: J7_IAS0.21, J8_IAS0.4
B7-CSI2-TXD0_IAS1_N: J7_IAS1.20, J8_IAS1.5
B7-CSI2-TXD0_IAS1_P: J7_IAS1.21, J8_IAS1.4
B7-CSI2-TXD1_IAS0_N: J7_IAS0.17, J8_IAS0.29
B7-CSI2-TXD1_IAS0_P: J7_IAS0.18, J8_IAS0.30
B7-CSI2-TXD1_IAS1_N: J7_IAS1.17, J8_IAS1.29
B7-CSI2-TXD1_IAS1_P: J7_IAS1.18, J8_IAS1.30
B7-CSI2-TXD2_IAS0_N: J7_IAS0.11, J8_IAS0.26
B7-CSI2-TXD2_IAS0_P: J7_IAS0.12, J8_IAS0.27
B7-CSI2-TXD2_IAS1_N: J7_IAS1.11, J8_IAS1.26
B7-CSI2-TXD2_IAS1_P: J7_IAS1.12, J8_IAS1.27
B7-CSI2-TXD3_IAS0_N: J7_IAS0.8, J8_IAS0.11
B7-CSI2-TXD3_IAS0_P: J7_IAS0.9, J8_IAS0.10
B7-CSI2-TXD3_IAS1_N: J7_IAS1.8, J8_IAS1.11
B7-CSI2-TXD3_IAS1_P: J7_IAS1.9, J8_IAS1.10
C-GND_IAS0: C10_IAS0.2, J1_IAS0.6, J1_IAS0.7, J1_IAS0.8, J1_IAS0.9, R24_IAS0.1, X1_IAS0.1
C-GND_IAS1: C10_IAS1.2, J1_IAS1.6, J1_IAS1.7, J1_IAS1.8, J1_IAS1.9, R24_IAS1.1, X1_IAS1.1
EXT-GPIO0-I2C-SCL_IAS0: J7_IAS0.2, J9_IAS0.3, R15_IAS0.1
EXT-GPIO0-I2C-SCL_IAS1: J7_IAS1.2, J9_IAS1.3, R15_IAS1.1
EXT-GPIO1-I2C-SDA_IAS0: J7_IAS0.3, J9_IAS0.1, R16_IAS0.1
EXT-GPIO1-I2C-SDA_IAS1: J7_IAS1.3, J9_IAS1.1, R16_IAS1.1
EXT-GPIO2_IAS0: J7_IAS0.5, J10_IAS0.1, R18_IAS0.1
EXT-GPIO2_IAS1: J7_IAS1.5, J10_IAS1.1, R18_IAS1.1
EXT-GPIO3_IAS0: J7_IAS0.6, J10_IAS0.3, R17_IAS0.1
EXT-GPIO3_IAS1: J7_IAS1.6, J10_IAS1.3, R17_IAS1.1
GND: C1_IAS0.2, C1_IAS1.2, C2_IAS0.2, C2_IAS1.2, C3_IAS0.2, C3_IAS1.2, C4_IAS0.2, C4_IAS1.2, C5_IAS0.2, C5_IAS1.2, C6_IAS0.2, C6_IAS1.2, C7_IAS0.2, C7_IAS1.2, C8_IAS0.2, C8_IAS1.2, C9_IAS0.2, C9_IAS1.2, C10_IAS0.1, C10_IAS1.1, C11_IAS0.2, C11_IAS1.2, C12_IAS0.2, C12_IAS1.2, D1_IAS0.A, D1_IAS1.A, D3_IAS0.K, D3_IAS1.K, J1_IAS0.5, J1_IAS1.5, J2_IAS0.2, J2_IAS1.2, J7_IAS0.10, J7_IAS0.13, J7_IAS0.16, J7_IAS0.19, J7_IAS0.22, J7_IAS1.10, J7_IAS1.13, J7_IAS1.16, J7_IAS1.19, J7_IAS1.22, J8_IAS0.2, J8_IAS0.3, J8_IAS0.6, J8_IAS0.9, J8_IAS0.12, J8_IAS0.16, J8_IAS0.19, J8_IAS0.25, J8_IAS0.28, J8_IAS0.31, J8_IAS0.33, J8_IAS1.2, J8_IAS1.3, J8_IAS1.6, J8_IAS1.9, J8_IAS1.12, J8_IAS1.16, J8_IAS1.19, J8_IAS1.25, J8_IAS1.28, J8_IAS1.31, J8_IAS1.33, R9_IAS0.1, R9_IAS1.1, R10_IAS0.1, R10_IAS1.1, R14_IAS0.1, R14_IAS1.1, R24_IAS0.2, R24_IAS1.2, R74_IAS0.1, R74_IAS1.1, R75_IAS0.1, R75_IAS1.1, U1_IAS0.6, U1_IAS0.11, U1_IAS1.6, U1_IAS1.11, U2_IAS0.5, U2_IAS0.7, U2_IAS1.5, U2_IAS1.7, U3_IAS0.1, U3_IAS1.1, U4_IAS0.6, U4_IAS1.6, U5_IAS0.2, U5_IAS0.5, U5_IAS1.2, U5_IAS1.5
GPIO2_3V3_IAS0: J10_IAS0.2, R18_IAS0.2, U4_IAS0.10
GPIO2_3V3_IAS1: J10_IAS1.2, R18_IAS1.2, U4_IAS1.10
GPIO2_IAS0: J8_IAS0.32, R72_IAS0.1, R74_IAS0.2, U4_IAS0.2
GPIO2_IAS1: J8_IAS1.32, R72_IAS1.1, R74_IAS1.2, U4_IAS1.2
GPIO3_3V3_IAS0: J6_IAS0.3, J10_IAS0.4, R17_IAS0.2, U4_IAS0.9
GPIO3_3V3_IAS1: J6_IAS1.3, J10_IAS1.4, R17_IAS1.2, U4_IAS1.9
I2C_SCL_3V3_IAS0: J9_IAS0.4, R7_IAS0.1, R8_IAS0.1, R15_IAS0.2, R22_IAS0.1, U1_IAS0.9, U3_IAS0.6
I2C_SCL_3V3_IAS1: J9_IAS1.4, R7_IAS1.1, R8_IAS1.1, R15_IAS1.2, R22_IAS1.1, U1_IAS1.9, U3_IAS1.6
I2C_SCL_IAS0: J8_IAS0.14, R21_IAS0.2, U3_IAS0.3
I2C_SCL_IAS1: J8_IAS1.14, R21_IAS1.2, U3_IAS1.3
I2C_SDA_3V3_IAS0: J9_IAS0.2, R4_IAS0.1, R5_IAS0.1, R16_IAS0.2, R23_IAS0.1, U1_IAS0.8, U3_IAS0.5
I2C_SDA_3V3_IAS1: J9_IAS1.2, R4_IAS1.1, R5_IAS1.1, R16_IAS1.2, R23_IAS1.1, U1_IAS1.8, U3_IAS1.5
I2C_SDA_IAS0: J8_IAS0.22, R20_IAS0.2, U3_IAS0.4
I2C_SDA_IAS1: J8_IAS1.22, R20_IAS1.2, U3_IAS1.4
INA260-A0_IAS0: R2_IAS0.2, R4_IAS0.2, R7_IAS0.2, R9_IAS0.2, U1_IAS0.5
INA260-A0_IAS1: R2_IAS1.2, R4_IAS1.2, R7_IAS1.2, R9_IAS1.2, U1_IAS1.5
INA260-A1_IAS0: R3_IAS0.2, R5_IAS0.2, R8_IAS0.2, R10_IAS0.2, U1_IAS0.4
INA260-A1_IAS1: R3_IAS1.2, R5_IAS1.2, R8_IAS1.2, R10_IAS1.2, U1_IAS1.4
NetC2_IAS0_1: C2_IAS0.1, R6_IAS0.2, U1_IAS0.10
NetC2_IAS1_1: C2_IAS1.1, R6_IAS1.2, U1_IAS1.10
NetC7_IAS0_1: C7_IAS0.1, R19_IAS0.1, U3_IAS0.7, U3_IAS0.8
NetC7_IAS1_1: C7_IAS1.1, R19_IAS1.1, U3_IAS1.7, U3_IAS1.8
NetC12_IAS0_1: C12_IAS0.1, R27_IAS0.1, U5_IAS0.1
NetC12_IAS1_1: C12_IAS1.1, R27_IAS1.1, U5_IAS1.1
NetD2_IAS0_A: D2_IAS0.A, R11_IAS0.2
NetD2_IAS0_K: D2_IAS0.K, TP1_IAS0.1, U1_IAS0.7
NetD2_IAS1_A: D2_IAS1.A, R11_IAS1.2
NetD2_IAS1_K: D2_IAS1.K, TP1_IAS1.1, U1_IAS1.7
NetD3_IAS0_A: D3_IAS0.A, R13_IAS0.2
NetD3_IAS1_A: D3_IAS1.A, R13_IAS1.2
NetJ6_IAS0_1: J6_IAS0.1, R12_IAS0.2
NetJ6_IAS0_2: J6_IAS0.2, U2_IAS0.4
NetJ6_IAS1_1: J6_IAS1.1, R12_IAS1.2
NetJ6_IAS1_2: J6_IAS1.2, U2_IAS1.4
NetR14_IAS0_2: R14_IAS0.2, U2_IAS0.2
NetR14_IAS1_2: R14_IAS1.2, U2_IAS1.2
PWDN_IAS0: J8_IAS0.21, R73_IAS0.1, R75_IAS0.2, U4_IAS0.3
PWDN_IAS1: J8_IAS1.21, R73_IAS1.1, R75_IAS1.2, U4_IAS1.3
VCC1V2_IAS0: J8_IAS0.23, J8_IAS0.24, TP4_IAS0.1
VCC1V2_IAS1: J8_IAS1.23, J8_IAS1.24, TP4_IAS1.1
VCC1V8_IAS0: C6_IAS0.1, C8_IAS0.1, J8_IAS0.13, R20_IAS0.1, R21_IAS0.1, R72_IAS0.2, R73_IAS0.2, TP5_IAS0.1, U3_IAS0.2, U4_IAS0.1, U4_IAS0.12
VCC1V8_IAS1: C6_IAS1.1, C8_IAS1.1, J8_IAS1.13, R20_IAS1.1, R21_IAS1.1, R72_IAS1.2, R73_IAS1.2, TP5_IAS1.1, U3_IAS1.2, U4_IAS1.1, U4_IAS1.12
VCC2V75_IAS0: J8_IAS0.17, J8_IAS0.18, TP6_IAS0.1
VCC2V75_IAS1: J8_IAS1.17, J8_IAS1.18, TP6_IAS1.1
VCC3V3_IAS0: C9_IAS0.1, R2_IAS0.1, R3_IAS0.1, R6_IAS0.1, R11_IAS0.1, R19_IAS0.2, R22_IAS0.2, R23_IAS0.2, R27_IAS0.2, TP2_IAS0.1, U4_IAS0.11
VCC3V3_IAS1: C9_IAS1.1, R2_IAS1.1, R3_IAS1.1, R6_IAS1.1, R11_IAS1.1, R19_IAS1.2, R22_IAS1.2, R23_IAS1.2, R27_IAS1.2, TP2_IAS1.1, U4_IAS1.11
VCC5V-CAM_IAS0: C3_IAS0.1, C5_IAS0.1, R1_IAS0.1, R12_IAS0.1, R101_IAS0.2, U1_IAS0.14, U1_IAS0.15, U1_IAS0.16, U2_IAS0.6
VCC5V-CAM_IAS1: C3_IAS1.1, C5_IAS1.1, R1_IAS1.1, R12_IAS1.1, R101_IAS1.2, U1_IAS1.14, U1_IAS1.15, U1_IAS1.16, U2_IAS1.6
VCC5V-EXT: C1_IAS0.1, C1_IAS1.1, D1_IAS0.K, D1_IAS1.K, J1_IAS0.1, J1_IAS1.1, J2_IAS0.1, J2_IAS1.1, R1_IAS0.2, R1_IAS1.2, U1_IAS0.1, U1_IAS0.2, U1_IAS0.3, U1_IAS0.12, U1_IAS1.1, U1_IAS1.2, U1_IAS1.3, U1_IAS1.12
VCC-EXT-IN_IAS0: C4_IAS0.1, C11_IAS0.1, J7_IAS0.1, J7_IAS0.4, J7_IAS0.7, R13_IAS0.1, R101_IAS0.1, TP3_IAS0.1, U2_IAS0.1, U5_IAS0.3, U5_IAS0.4
VCC-EXT-IN_IAS1: C4_IAS1.1, C11_IAS1.1, J7_IAS1.1, J7_IAS1.4, J7_IAS1.7, R13_IAS1.1, R101_IAS1.1, TP3_IAS1.1, U2_IAS1.1, U5_IAS1.3, U5_IAS1.4
