PabloSoage/kv260-ias2rf/(commit log)

2026-08-14 Initial commit: KV260 IAS2RF adapter - SDR+Radar
    [CSI2-KRIA-KV260_Rev01(standard)_BOM.xlsx, CSI2-KRIA-KV260_Rev01(standard)_PnP.xlsx, CSI2-KRIA-KV260_Rev01-1.SchDoc, CSI2-KRIA-KV260_Rev01-2.SchDoc, CSI2-KRIA-KV260_Rev01-2.kicad_sch, CSI2-KRIA-KV260_Rev01-2_postA1.kicad_sch, CSI2-KRIA-KV260_Rev01-2_postA2.kicad_sch, CSI2-KRIA-KV260_Rev01.PcbDoc]
2026-08-14 Rev03: arquitectura con FPGA de front-end tras cerrar los 5 bloqueantes
    Investigacion de bloqueantes (docs/RIESGOS.md), con fuentes:
    - B-01 EN CONTRA: IAS0 (J7) no llega a la logica programable, entra en el
    ISP AP1302 de la carrier. La KV260 no tiene cabecera RPi de 40 pines
    (J9 es un conector de camara de 15 pines). Los GTH no son accesibles.
    Presupuesto real: 8 pares diferenciales + ~14 senales sueltas.
    - B-02 EN CONTRA: AD9253 en 1-lane limitado a 62.5 MSPS (16 b x fs / lanes,
    max 1000 Mbps/lane), no 125.
    - B-03 A FAVOR: M3SWA2-34DR+ con driver interno, control positivo 3.3 V.
    Se elimina el rail negativo.
    - B-04 A FAVOR: IF de AERIS-10 = 120 MHz (ddc_400m.v). Sus filtros BPF2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
    [CSI2-KRIA-KV260_Rev01.kicad_pcb, CSI2-KRIA-KV260_Rev01_preRev02cleanup.kicad_pcb]
2026-08-14 Documenta la plataforma 4x4 completa y la lista de material
    El objetivo real no es la placa adaptadora: es una plataforma de sensores y
    comunicaciones para un 4x4 de expedicion (Montero V80). Ese encuadre cambia
    las prioridades del proyecto.
    Nuevos documentos:
    - docs/PLATAFORMA_4X4.md: vision de sistema. Subsistemas (LiDAR, SDR RX/TX,
    radiogoniometria, radar, OBD2/CAN), legalidad por banda, entorno
    automovilistico (ISO 7637-2), presupuesto de potencia, orden recomendado.
    - docs/LISTA_COMPRA.md: material y checklist por etapas, con costes
    orientativos y resumen economico.
    Tres conclusiones de sistema:
    - Hay 4 etapas de alto valor que NO requieren disenar hardware (SDR comercial
    por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
2026-08-14 fpga/scanner64: escaner multicanal en tiempo real para la PL de la KV260
    Banco de N canales DDC (NCO + mezclador complejo + CIC decimador) que vigilan
    N frecuencias simultaneamente, muestra a muestra. Es el primer bloque real del
    SDR del proyecto, reutilizable en las etapas 0, 4 y 7.
    Verificado con lo que hay en esta maquina (solo Python, sin simulador Verilog):
    - model/ddc_model.py: modelo bit-exacto con autotest. 4 pruebas pasando.
    Tono en banda -12.04 dBFS (valor teorico exacto), rechazo fuera de banda
    72.7 dB, dos canales midiendo identico, entrada nula -> salida nula.
    - model/rtl_check.py: transcribe la semantica del RTL (asignaciones no
    bloqueantes) y la compara contra los vecto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
2026-09-21 Prepare for publication: English documentation, dead sheets removed, repo cleaned
    Documentation translated to English and renamed. The old project name is gone
    from every publishable file.
    Readme.md -> README.md
    ARCHITECTURE_draft_es.md -> ARCHITECTURE.md
    docs/RIESGOS.md -> docs/BLOCKERS_AND_RISKS.md
    docs/AUDITORIA_Rev01.md -> docs/AUDIT_Rev01.md
    docs/HISTORIAL_Rev01.md -> docs/HISTORY_Rev01.md
    docs/PLATAFORMA_4X4.md -> docs/VEHICLE_PLATFORM.md
    docs/LISTA_COMPRA.md -> docs/SHOPPING_LIST.md
    docs/ROADMAP.md, HANDOFF.md translated in place
    Design work, verified with kicad-cli 10.0.1 (now available on this machine):
    - Removed FRONTEND.kicad_sch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
    [CSI2-KRIA-KV260_Rev01.kicad_sch, FRONTEND.kicad_sch, PHASED_ARRAY.kicad_sch]
2026-09-21 Architecture approved; netlist export unblocked
    Decisions recorded (21 Sep 2026):
    - Front-end FPGA ACCEPTED. Reason unchanged from phase 0: the KV260 does not
    expose enough pins for a converter to connect directly.
    - The radar is AERIS-10, surveillance at range, as a project rather than
    something to be operated on air.
    - Obstacle detection leaves this board: a commercial automotive radar over
    USB, licence-free at 76-77 GHz and cheaper. Nothing in the schematic has to
    account for it.
    Netlist export fixed. It had TWO independent causes, both found by measuring
    with kicad-cli rather than by reasoning about the files:
    1. Duplicate instance references. CSI2-KRIA-KV260_Rev01-2.kicad_sch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
    [CSI2-KRIA-KV260_Rev01-2.kicad_sch, CSI2-KRIA-KV260_Rev01-2_preAnnotation.kicad_sch, CSI2-KRIA-KV260_Rev01.kicad_sch]
2026-09-21 Phase 1: freeze the pin map, measure the KV260 mechanical envelope
    New: docs/INTERFACE_SPEC.md, the phase 1 freeze.
    Link allocation on J8 / IAS1, frozen against the verified Hirose pinout:
    LINK_RX_D0+/- TXD0 pins 4/5 FPGA -> Kria
    LINK_RX_D1+/- TXD1 pins 29/30 FPGA -> Kria
    LINK_RX_CLK+/- TXC pins 7/8 FPGA -> Kria
    LINK_TX_D0+/- TXD2 pins 26/27 Kria -> FPGA
    LINK_TX_CLK+/- TXD3 pins 10/11 Kria -> FPGA
    The clock goes on TXC because it was the MIPI clock lane, so it is the pair
    most likely to land on a clock-capable SOM pin - which a source-synchronous
    receiver needs. Flagged for confirmation against XTP682.
    Also noted: two of the five pairs are wired _N/_P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
2026-09-21 Confirm the SOM-side interface against the carrier card schematic (XTP682)
    The KV260 carrier card schematic closes the last electrical unknown of phase 1
    and confirms, from the primary source, what had until now been inference.
    Cross-check of all five differential pairs against XTP682 sheet 13, where the
    IAS1 connector is designator J8, a BM20B_0.8_-34DS-0.4V. Every pair matches,
    polarity included:
    adapter pins 4/5 TXD0_P/_N -> HPA06_P / HPA06_N
    adapter pins 7/8 TXC_P/_N -> HPA05_CC_P / HPA05_CC_N <- clock capable
    adapter pins 10/11 TXD3_P/_N -> HPA09_P / HPA09_N
    adapter pins 26/27 TXD2_N/_P -> HPA08_N / HPA08_P
    adapter pins 29/30 TXD1_N/_P -> HPA07_N / HPA0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
2026-09-21 Phase 1: current budget and 6-layer stackup
    New: docs/POWER_AND_STACKUP.md, driven by two scripts in _work/ so that
    re-running either after a change is one command.
    POWER BUDGET (_work/power_budget.py)
    The budget earned its keep on the first run by flagging two rails that cannot
    work as drawn:
    +1V8_A 600mA ldo from +3V3_A 0.90W too hot for an LDO
    +3V3_A 840mA ldo from +5V0 1.43W too hot for an LDO
    That is the same class of mistake the Rev01 design made with its ADP151
    dropping 5 V to 1.8 V at 1.6 W in a TSOT-23-5. Easy to repeat: the tree looks
    reasonable until you multiply the drop by the current.
    Fixed with a pre-regulating buck in front of each analogue LDO, which k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
    [power_budget.py, stackup_impedance.py]
2026-09-21 Record the negative result on parsing the Allegro .brd
    The IAS connector coordinates cannot be recovered from XTP681's binary .brd,
    and the attempt is recorded so it is not repeated.
    The approach used a strong signature: the two mating Hirose connectors are
    50.040 mm apart with identical Y, measured from the adapter's own .kicad_pcb.
    Finding J7/J8 as delimited refdes strings worked. Scanning int32s at matching
    relative offsets produced a tempting hit - 86.609 mm and 36.566 mm, separated
    by 50.043 mm against 50.040 expected, a 3 um discrepancy inside one unit of
    quantisation.
    The confirmation step killed it: zero candidates had both the correct X
    separation and a matching Y at contiguous of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
2026-09-21 Phase 2: build the Rev03 sheet hierarchy and make it consistent
    Two scripts, both verified with kicad-cli.
    HIERARCHY SKELETON (_work/rev03_build_hierarchy.py)
    Six sheets under rev03/, 108 interface signals wired into the root:
    IAS_LINK 14 Hirose IAS1, AC coupling, link terminations
    CONTROL 40 Front-end FPGA, Pmod, AERIS-10 control IDC
    CONVERTERS 37 AD9484, AD9253, AD9708, AD9767, AD8352 drivers
    CLOCK 8 Reference selector, TCXO, ADCLK944 fan-out
    ROUTING 9 4x SPDT channel routing, IF and clock SMAs
    POWER 0 12 V input, protection, buck/LDO tree
    The interface is the one frozen in docs/INTERFACE_SPEC.md.
    This does not contradict the au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
    [CLOCK.kicad_sch, CONTROL.kicad_sch, CONVERTERS.kicad_sch, CSI2-KRIA-KV260_Rev01.kicad_sch, CSI2-KRIA-KV260_Rev01_preRev03hier.kicad_sch, IAS_LINK.kicad_sch, POWER.kicad_sch, ROUTING.kicad_sch]
2026-09-21 Phase 2: symbol libraries with correct pin electrical types
    A symbol whose pins are all `unspecified` makes ERC blind - that is what
    produced the 48 uninterpretable pin_to_pin conflicts in the Rev01 work. This
    step fixes the cause.
    FOUND IN KICAD'S OWN LIBRARIES - verified, maintained, not rebuilt:
    XC7A50T-FTG256 FPGA_Xilinx_Artix7 256 pins, 4 units, 188 bidirectional
    + 68 power_in. Exactly the package
    AERIS-10 uses
    AD9708AR Video radar DAC, exact part match
    ADF4351 RF SDR synthesiser for board B
    The hardest symbol in the design, a 256-ball BGA, was a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
    [make_symbols.py]
2026-09-21 Retype M3SWA2 and LTC5552 from datasheets; B-03 was wrong and is corrected
    The two datasheets turned out to be sitting in the AERIS-10 repository's own
    component folder - M3SWA2-34DR+.pdf and LTC5552f.pdf - so they could be read
    locally despite analog.com still being unreachable.
    B-03 WAS CLOSED WRONGLY, AND THE POWER TREE WAS CHANGED ON IT
    B-03 asked whether the RF switches need a negative rail. It was closed "in
    favour" on a web search snippet reporting "supply voltage requirement is 3.3V ~
    3.6V", and the charge-pump inverter was struck from the power tree on that
    basis.
    The datasheet says otherwise. M3SWA2-34DR+, DC ELECTRICAL SPECIFICATIONS:
    Positive Supply Voltage, VDD +3.3 ..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
    [make_symbols.py, power_budget.py]
2026-09-21 Verify power figures and rebuild AD9484/AD8352 from datasheets
    The AERIS-10 repository's component folder turned out to hold several of the
    datasheets analog.com would not serve, including AD9484/AD9484.pdf and
    AD9484/ad8352.pdf. That closed most of what was outstanding.
    POWER BUDGET: 2 verified loads -> 7 of 21
    AD9484 AVDD 300 mA max AD9484.pdf, POWER SUPPLY table (283 typ)
    AD9484 DRVDD 100 mA max same table (89 typ, SDR mode)
    AD9708 AVDD 25 mA AD9708.pdf, Analog Supply Current
    AD9708 DVDD 3 mA same, Digital Supply Current
    AD8352 x2 80 mA ad8352.pdf Rev. C, 39 mA max each
    M3SWA2 x4 VDD 12 mA already verified last commit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
2026-09-23 Obtain the missing datasheets; 8 of 10 symbols and 12 of 21 loads verified
    analog.com still refuses this machine, but the Internet Archive holds its
    own URLs. _work/fetch_datasheets.py fetches AD9523, AD9253, AD9767 (in the
    joint AD9763/65/67 sheet) and ADCLK944 in Range chunks, because downloads
    here are silently cut at 1 MiB, and checks each ends in %%EOF.
    Symbols: AD9523 retyped, AD9253/AD9767/ADCLK944 created, all from tables
    read on the rendered page (text extraction drops overbars).
    _work/crosscheck_pinouts.py compares every datasheet table against an
    independent source (Eagle or EasyEDA): no conflicts; the ten disagreements
    were all errors in the second source, each recorded with its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
    [crosscheck_pinouts.py, fetch_datasheets.py, make_symbols.py, power_budget.py]
2026-09-23 Register the adapter on the KV260 model; answer the growth direction
    The STEP model names every part, where the STL could not. Two instances of
    CONN_928X90X80_38P sit 50.038 mm apart (adapter: 50.040), and the XTP681
    plot's rendered silkscreen says which is J7. _work/kv260_register_adapter.py
    builds the transform (-90.00 deg, 2 um residual) and checks it three ways:
    pin 1 lands on the marked end; the original outline clears the carrier; and
    the adapter's two M3 holes land on the carrier's corner holes within 5 um.
    Result: the board can grow outward, off the carrier's side edge, and in no
    other direction (1.5-8.5 mm). The 0.8 mm stack height forbids underside
    parts. The original notch for J1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
2026-09-23 Use scanner64's measured KV260 power; fix stale B-03 note in the shopping list
    The vehicle budget carried the KV260 at 36 W, the brick's rating. scanner64
    measured 3.24 W idle and 4.30 W with 64 channels running (carrier INA260, on
    a 5 V rail); budgeted now at ~10 W, plus the adapter's 7.3 W. The shopping
    list still said the RF switches need no negative rail; they need VEE -3.3 V.
2026-09-23 Draw the CLOCK sheet: Si549 master XO, ADCLK948 select and fan-out
    First Rev03 sheet with circuits, drawn by a generator (_work/schgen.py,
    _work/sheets/clock.py) from coordinates, with real wires on grid, and
    checked by _work/check_sheet.py against a connection list written
    separately (_work/sheets/clock_spec.py): 30 nets exact, 119 pins accounted
    for, PASS. A deliberately deleted wire is reported by pin, so the check can
    see errors. ERC on the sheet: only "power not driven" on +3V3_D and GND
    (POWER not drawn) and isolated labels on the outputs (receivers not drawn).
    Drawing it corrected the clock plan, each point against a datasheet:
    - a fan-out copies one frequency; the AD9253 divides int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
    [CLOCK.kicad_sch, CONTROL.kicad_sch, CONVERTERS.kicad_sch, CSI2-KRIA-KV260_Rev01.kicad_sch]
2026-09-24 Draw the ADC_RADAR sheet; split CONVERTERS in four
    CLOCK was reviewed and accepted. Next sheet: the radar receive path, AERIS-10's
    AD9484 with two cascaded AD8352 drivers, rebuilt from the datasheets and
    checked against AERIS's schematic (_work/aeris_reference_circuit.py).
    - CONVERTERS -> ADC_RADAR, ADC_SDR, DAC_RADAR, DAC_SDR, each reviewable in
    one sitting (_work/rev03_split_converters.py). Root page now A2.
    - IF interface single-ended (IF_RX_A/B, IF_TX_A/B): the SPDT switches and
    SMAs are single-ended, and the AD8352 takes a single-ended input.
    - ADCR data bus -> one label per line.
    - AD8352s on 5 V (the only supply their datasheet characterises); power
    budget 8.9 W, 13 of 22 loads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
    [ADC_RADAR.kicad_sch, ADC_SDR.kicad_sch, CLOCK.kicad_sch, CONTROL.kicad_sch, CONVERTERS.kicad_sch, CSI2-KRIA-KV260_Rev01.kicad_sch, DAC_RADAR.kicad_sch, DAC_SDR.kicad_sch]
2026-09-24 Draw the ADC_SDR sheet: AD9253, two channels, AD8352 drivers
    Channels A and B of the AD9253 in one-lane mode (A on D0+-B, B on D1+-B,
    Table 8), each driven by an AD8352 at 12 dB from a single-ended input.
    Inputs biased from the ADC's VCM through the centre tap (Figure 58).
    IF_RX_C and IF_TX_C added to the interface for the second SDR channel.
    Shared drawing helpers in _work/sheets/kit.py; _work/render_sheet.py renders
    a sheet for visual review. check_sheet.py adc_sdr: PASS (55 nets, 63 parts).
    Power budget: 14 of 22 loads verified.
    [ADC_SDR.kicad_sch, CSI2-KRIA-KV260_Rev01.kicad_sch, DAC_SDR.kicad_sch, ROUTING.kicad_sch]
2026-09-24 Draw the DAC_RADAR sheet: AD9708, AERIS-10's filter, balun
    AD9708 with its internal 1.2 V reference and RSET 1.91 kohm (20 mA). AERIS-10
    ties REFLO to AVDD and REFIO to 3.3 V, outside the 0.1-1.25 V reference
    input range; not copied, and noted for the AERIS author. Output: 50 ohm
    loads, AERIS's differential LC reconstruction filter, then a 2:1 balun
    (part still to choose) to single-ended IF_TX_B.
    New project symbol AD9708AR from the datasheet (the stock Video symbol omits
    the NC pins); agrees with KiCad's on all 21 shared pins. DAC data buses
    split into one label per line. check_sheet.py dac_radar: PASS.
    [CONTROL.kicad_sch, CSI2-KRIA-KV260_Rev01.kicad_sch, DAC_RADAR.kicad_sch, DAC_SDR.kicad_sch]
2026-09-24 Draw the DAC_SDR sheet: AD9767 interleaved, two output chains
    AD9767 in interleaved mode (MODE low) on one 14-bit port, port 2 tied low,
    independent gain with RSET 3.83 kohm per DAC (10 mA: 0.5 V on 49.9 ohm, the
    datasheet's best-distortion level, p.24) and the 256 ohm + 22 nF network it
    asks for on each FSADJ (p.22). Each DAC through the DAC_RADAR output
    network, now shared as kit.dac_output. check_sheet.py dac_sdr: PASS.
    [DAC_SDR.kicad_sch]
2026-09-24 Draw the ROUTING sheet: four M3SWA2 SPDTs, ten DC-blocked SMAs
    Each converter port to its own chain by default (RF1, control pulled low)
    or to the other chain (RF2). Per switch, the datasheet's Figure 2 network:
    11.5 ohm + 0.1 uF + 100 pF + 5.6 V zener on VDD and VEE, 100 ohm on VCTRL,
    NC pads grounded. Every SMA DC-blocked (note 3: RF ports must be DC blocked
    or at 0 V). SW_CTRL bus split into one label per line. Negative power
    symbols now carry their name below. check_sheet.py routing: PASS.
    [CONTROL.kicad_sch, CSI2-KRIA-KV260_Rev01.kicad_sch, ROUTING.kicad_sch]
2026-09-24 Draw the IAS_LINK sheet: Hirose IAS1/IAS0, AC coupling, terminations
    J101 on IAS1 with the frozen, carrier-verified allocation (INTERFACE_SPEC
    §2-4); J102 on IAS0, grounds only. All ten link lines AC-coupled (§6.1); the
    two pairs the FPGA receives terminated 2 x 49.9 ohm to +1V2, which also
    restores their common mode. Notes that the FPGA's link bank must be 2.5 V
    for LVDS_25 outputs. check_sheet.py ias_link: PASS.
    [IAS_LINK.kicad_sch]
2026-09-24 POWER groundwork: regulator symbols from datasheets, TI fetch
    Four project symbols transcribed from their datasheets for the POWER sheet:
    LMR33630ADDA (12 V -> 5 V, 3 A), TPS562201 (5 V -> 3V3/2V5/1V0),
    TPS7A8300RGR (ANY-OUT LDO for +1V8_A, +1V8_D, +3V3_A), LM2663M (-3V3).
    fetch_datasheets.py gains a direct list for ti.com, which serves this
    machine; LMR33630.pdf fetched. The POWER sheet itself is not drawn yet.
2026-09-25 Draw the POWER sheet: LMR33630, 3x TPS562201, 3x TPS7A8300, LM2663
    The whole tree on one A2 sheet, each regulator its datasheet's typical
    application with values from its own table (LMR33630 Table 9-2, TPS562201
    Table 7-2, TPS7A8300 Figure 51 and Table 2, LM2663 Pin Functions). Input:
    jack, polyfuse, reverse-polarity P-MOSFET, TVS. The +3V6 pre-regulator is
    dropped (+3V3_A now carries 100 mA); +2V5 also feeds the FPGA's LVDS banks;
    +1V2 becomes a divider for the link terminations. Every Rev03 rail is now
    driven in ERC. TPS562201 and LMR33630 agree with KiCad's family symbols.
    Budget: 743 mA at 12 V, 15 of 23 loads verified. check_sheet.py power: PASS.
    [POWER.kicad_sch]
2026-09-25 Draw the CONTROL sheet: XC7A50T, config flash, JTAG, Pmod, AERIS ribbon
    The front-end FPGA with its four banks, master SPI x4 configuration per
    UG470 Figure 2-14, UG483 decoupling, the XADC on its on-chip reference,
    LVDS terminations, 22 ohm DAC series arrays, the Pmod and an IDC 2x20 for
    eight ADAR1000s. check_sheet PASS; the pin table proves itself against the
    symbol's ball names on import.
    Bank plan revised on reading the package: FTG256 bank 34 has 20 I/O and
    no clock pins, so it holds only the 2.5 V link outputs; bank 35 is 1.8 V.
    CLK_FPGA gets a matched 24.9 ohm pad (ADCLK948 swing exceeds LVDS_25's
    600 mV). PROG_B goes through a 74LVC1G07.
    The Xilinx guides (UG470/471/480/483, DS181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
    [CONTROL.kicad_sch]
2026-09-25 Wire the Rev03 root; remove the Rev01 IAS0/IAS1 sheets
    Every sheet pin now has a wire and a net label, inputs on the left and
    outputs on the right; pages are numbered 1-10. The Rev01 IAS0/IAS1 blocks
    and their shared child (now in _deprecated/) are gone, as are ten Altium
    import symbols with no library or footprint (PCB1, MRK1-6, T1, T2, LA1).
    _work/check_root.py joins every sheet's own connection list across the
    root and compares it with KiCad's netlist: all 92 interface nets exact,
    every sheet PASS; a renamed root label is caught. ERC: 9 warnings, no
    errors (672 before).
    [CSI2-KRIA-KV260_Rev01-2.kicad_sch, CSI2-KRIA-KV260_Rev01.kicad_sch]
2026-09-25 CONTROL_SPEC: mark the carrier's 1.8 V single-ended level as an estimate
2026-09-25 Root: remove the Altium title frame and logo, use KiCad's title block
    Attribution to the original Allied Vision design stays in README and
    LICENSE; the title block's comment points there.
    [CSI2-KRIA-KV260_Rev01.kicad_sch]
2026-09-25 Choose the remaining parts; project footprint library
    Every one of the 471 parts now has a footprint that exists:
    - ADT2-1T+ baluns (T701, T801, T802): new symbol from the Mini-Circuits
    datasheet, 100 ohm secondary to the DAC; CD542 / PL-052 footprint.
    DAC_RADAR and DAC_SDR regenerated, both PASS.
    - DMP3013SFV for Q1001 (-30 V, 9.5 mohm, VGSS +-25 V); Bourns SRP7028A
    for the four power inductors (Isat 7.5-14 A).
    - footprints/kv260-ias2rf.pretty from _work/make_footprints.py: the
    ADCLK948 and AD9484 LFCSPs with their real exposed pads, Mini-Circuits
    DQ3005 for the M3SWA2, and the Hirose BM20B taken from the original
    board and returned to the top face.
    - Datasheets for all of them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
    [ADC_RADAR.kicad_sch, CLOCK.kicad_sch, DAC_RADAR.kicad_sch, DAC_SDR.kicad_sch, IAS_LINK.kicad_sch, POWER.kicad_sch, ROUTING.kicad_sch]
2026-09-25 Layout: build the Rev03 board, 119 x 120 mm, first placement
    _work/layout/build_board.py writes the board from the netlist, as text
    (KiCad's python pops dialogs on Windows): outline kept from the original
    where it registers on the KV260, grown outward to 120 mm; 6-layer stackup
    from POWER_AND_STACKUP; LVDS100/RF50/Power net classes; GND planes on L2
    and L5; five M3 holes and three fiducials; all 471 footprints with their
    nets and symbol links. J101/J102 are copied from the original board and
    checked identical. A first placement puts each sheet in its region and
    legalises courtyards; no through-hole part over the carrier.
    DRC: 0 schematic-parity problems, no shorts, clearance or courtyard
    vi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
    [CSI2-KRIA-KV260_Rev01.kicad_pcb, CSI2-KRIA-KV260_Rev01_AlliedVision.kicad_pcb, DAC_RADAR.kicad_sch, DAC_SDR.kicad_sch]
2026-09-25 Check J8's single-ended pins against the carrier; move FPGA_IRQ to pin 15
    The KV260 carrier schematic (XTP682 sheets 8 and 13) shows what drives
    each single-ended pin of IAS1. Pin 32, where FPGA_IRQ was, is the
    Si5332's 48 MHz camera clock (IAS1_EXTCLK): it never reaches the SOM,
    and an FPGA output there would fight a clock driver. Pin 15
    (HPA13_FLASH) is the one input to the SOM, through an SN74AVC4T245 at
    1.8 V. FPGA_IRQ moves there; pin 32 is left unconnected.
    - IAS_LINK: FPGA_IRQ on J101.15, pin 32 no-connect; carrier function of
    every free pin recorded in the spec.
    - CONTROL: R1133 47k pull-down on FPGA_IRQ (PUDC_B high leaves the pin
    floating until configuration; the translator in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
    [CONTROL.kicad_sch, CSI2-KRIA-KV260_Rev01.kicad_pcb, IAS_LINK.kicad_sch]
2026-09-25 Layout: every passive at its pin, BGA escape ring, clean silkscreen, L4 split
    Placement (build_board.py):
    - Each passive is attached to the pin it serves, found from the netlist:
    decoupling to the supply pin of the nearest chip on its rail, anything
    on a signal to that pin (own sheet only: terminations at the receiver,
    series arrays at the driver). On POWER the buck inductors go to their
    SW pin first and their output capacitors to the inductor.
    - Placed in the order a person would: a chip, then its passives, then
    the next chip.
    - 2.5 mm keep-out ring around the FPGA for escape routing and fan-out.
    - SMA row reordered by signal source (TX under the DACs, RX under the
    ADCs, clock n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
    [CSI2-KRIA-KV260_Rev01.kicad_pcb]
2026-09-25 JLCPCB stackup and field-solver widths, fabrication outputs, power floorplan
    Stackup: JLCPCB JLC06161H-2116A (layer data from JLCPCB's stackup API
    via gsuberland/jlcpcb_autogenerated_stackups; Er from jlcpcb.com). The
    only 1.6 mm six-layer JLC stack with the shape of POWER_AND_STACKUP 2.1:
    L3 0.13 mm from L2 (GND), 0.93 mm from L4 (split PWR). JLC's default
    3313 stack would put L3 0.116 mm from the power layer.
    Widths: new _work/field_solver.py, a 2D finite-difference solver of the
    cross-section with JLC's solder mask. Checked against Cohn's exact
    stripline (1.0 % low) and Hammerstad-Jensen microstrip (2.4 % low); mesh
    halving moves results 0.3 %. L1: 100 ohm diff 117/150 um, 50 ohm
    183 um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
    [CSI2-KRIA-KV260_Rev01.kicad_pcb]
2026-09-25 Check the TPS7A8300 footprint against TI's RGR0020A land pattern
2026-09-29 Stage 0: bladeRF 2.0 micro (or AntSDR E200) plus RSPdx-R2 instead of HackRF One
    An AD9361-class transceiver gives 12-bit, ~3x the bandwidth, full duplex and
    two coherent channels; the RSPdx-R2 covers 1 kHz - 2 GHz with better
    sensitivity and replaces the HF upconverter. Adds a sourced comparison of the
    alternatives (HackRF One/Pro, bladeRF, AntSDR, B210, RSPdx-R2, KrakenSDR,
    Flipper Zero) and updates the stage-0 subtotal and the cumulative costs.
2026-10-02 CONTROL: housekeeping devices on the HK bus
    U1104 TMP1075DR temperature sensor at 0x48, its ALERT to FPGA ball H3
    (HK_ALERT, 10k pull-up); U1105 M24C02-FMN6TP board ID EEPROM at 0x50,
    write-protected by a WC pull-up unless solder jumper JP1101 is closed.
    The carrier's TCA9546A channel 1 reaches only J8, so both addresses are free.
    The EEPROM is chosen for its drive at 1.8 V (0.2 V at 0.7 mA, DS9398
    Table 14). The AT24CS02 first drawn guarantees only 0.15 mA at 1.7 V,
    and this bus needs about 1 mA, so the HK pull-ups also go from 4.7k to
    10k (1.81k with the carrier's 2.21k). The sensor is SOIC: the VSSOP's
    0.65 mm pitch broke the Power class clearance between V+ and A0.
    schgen flattens deri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
    [CONTROL.kicad_sch, CSI2-KRIA-KV260_Rev01.kicad_pcb]
2026-10-02 LCSC codes for 109 of 110 BOM lines; DSN export and SES import for routing
    _work/fab/lcsc_select.py picks a JLCPCB/LCSC part for every BOM line from
    JLCPCB's parts search, by rule (value, package, exact model; C0G below 1 nF,
    X7R/X5R above with a voltage rating for the line's highest rail; 1 %
    resistors; basic before extended, then stock) and writes lcsc_parts.csv,
    which make_fab.py copies into the BOM. Three lines differ from the drawn
    value because it is not made (106 pF, 107.3 nH, the 2.5 V T520); the Si549
    has no catalogue code.
    _work/layout/dsn_export.py writes the board as Specctra DSN from the board
    text (no pcbnew): per-footprint images in board coordinates, GND planes on
    In1/In4, t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
    [lcsc_parts.csv]
2026-10-02 Autoroute the board: 99 connections left
    _work/layout/route_krt.sh runs the autorouter (MIT, parses the board
    text, no pcbnew) on a copy: BGA fan-out of U1101 dog-bone only at the
    standard fab floor (146/147 nets, no via-in-pad), the LVDS pairs coupled
    at 117/150 um, then every other net. Only tracks and vias come back:
    9,310 segments, 1,322 vias of 0.45/0.2 mm; footprints and zones are
    byte-identical.
    DRC with zones refilled: 0 schematic-parity problems, 99 unrouted
    (68 signal, 18 LVDS legs, 13 power/ground), 33 clearance errors all on
    RF50, 113 dangling ends, 2 hole-to-hole. Left for KiCad by hand, with
    the LVDS pairs (5 of 26 coupled end to end) and the RF lines to review.
    Power class c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
    [CSI2-KRIA-KV260_Rev01.kicad_pcb]
2026-10-03 Routing: RF lines rerouted clean, dangling copper removed, POFV vias
    The six IF lines were ripped up and routed last at 0.183 mm, after a
    second pass over the rest: the router keeps the routed net's own class
    clearance, so routed last they keep RF50's 0.2 mm from everything
    (33 clearance errors -> 1, at 0.197 mm). _work/layout/drop_dangling.py
    removes what KiCad's DRC reports as dangling (zones refilled), by UUID,
    round after round: 445 items, with no change in the unrouted count.
    DRC: 0 parity problems, 100 unrouted, 1 RF50 clearance, 2 same-net
    hole-to-hole via pairs (each via needed; merge by hand).
    About 400 of the 1,278 vias sit in pads. JLCPCB fills and caps vias in
    pad (POFV) free a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
    [CSI2-KRIA-KV260_Rev01.kicad_pcb]
2026-10-05 Routing: 100 -> 89 unrouted with every complete net protected
    _work/layout/route_finish.sh writes every net that is already complete into
    the project as protected (kicad_routing_tools.protected_nets), then routes
    only the incomplete nets on a 0.05 mm grid with a large search budget, so
    the router can only use free space. 100 -> 89 unrouted, no net worse; the
    non-copper content of the board is unchanged.
    Letting it rip up existing nets instead lowered the count but broke the
    link pair LINK_RX_D0 and the IF_RX_B line, and its own improvement gate
    still accepted that; those runs were discarded.
    route_krt.sh: export MSYS_NO_PATHCONV=1. Git Bash turned net names that
    start with "/" into Windows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
    [CSI2-KRIA-KV260_Rev01.kicad_pcb]
2026-10-05 Routing: second protected finishing pass, 89 -> 87 unrouted
    route_finish.sh run again on the committed board: 75 incomplete nets routed with every complete net protected. Two more connections; no complete net broken (three already-incomplete DAC nets near RN1107 split into one more piece each).
    [CSI2-KRIA-KV260_Rev01.kicad_pcb]
2026-10-06 Routing: L4 opened to tracks outside the power islands, +1V0 island shrunk; 87 -> 68 unrouted
    Tracks-only keep-out rule areas over every In3 island; the +1V0 island under
    the BGA is now a band to the top bulk vias and a block over the VCCINT balls.
    Same-net hole-to-hole via pairs merged. DRC: 0 parity, 68 unrouted, 1 RF50
    clearance.
    [CSI2-KRIA-KV260_Rev01.kicad_pcb]
2026-10-06 Routing: slow nets allowed on L5, 68 -> 60 unrouted
    route_finish.sh gains GRID, ONLY and PROTECT. A 0.025 mm grid pass and a
    pass with fewer nets protected gave nothing (the second was rejected by the
    router's own gate). In4.Cu opened at cost 5 to the ADAR bus, JTAG, CONV_SPI,
    SW_CTRL and XO_SCL only: 125 mm of track on the L5 plane, nine fast tracks
    cross it (listed in LAYOUT 6.1). DRC: 0 parity, 60 unrouted, 1 RF50.
    [CSI2-KRIA-KV260_Rev01.kicad_pcb]
2026-10-10 Routing: re-placed and pin-swapped, routed again; 60 -> 49 unrouted, 0 DRC errors
    Bank 35 and the AD9767 lines of bank 15 re-assigned by a minimum-length
    matching (no crossings within either bus); AERIS ribbon under CONTROL, DAC
    series arrays left of the BGA, board 12 mm longer, 0.5 mm between parts
    (build_board.py defaults). route_all.sh runs the whole sequence; its IF step
    now reads the original project (RF50 at 0.2). rip_violations.py removes the
    copper behind DRC errors for a re-route. Power tracks the router put on the
    ground planes are documented as left to fix (LAYOUT 6.2-6.3).
    [CONTROL.kicad_sch, CSI2-KRIA-KV260_Rev01.kicad_pcb]
2026-10-10 Routing: supply tracks taken off the ground planes; 50 unrouted, 0 errors
    the autorouter' plane finalize was handed the forbidden layers too and
    routed +1V0, +1V8_ADCS_A and +3V3_D on L2 and L5. krt_finalize_layers.patch
    gives it only the allowed ones; the nets were ripped and routed again, and
    the last 16 mm that came back on L2 moved to L4. L2 and L5 now carry only
    GND and two slow tracks.
    [CSI2-KRIA-KV260_Rev01.kicad_pcb]
2026-10-11 Routing: Default clearance 0.10 mm and a finishing pass at 0.10 mm; 50 -> 39 unrouted, 0 errors
    route_finish.sh takes CLR, TW, PW and RIP; fix_gap.py joins two islands
    of a net with a short path and at most one via.
    [CSI2-KRIA-KV260_Rev01.kicad_pcb]
2026-10-13 Routing: DACS bus routed first in a region re-route left of the BGA; 39 -> 30 unrouted, 0 errors
    Ten DACS balls of the BGA had no copper: routed late, they found the left
    side of the BGA full of slow tracks. route_region.sh rips every slow net
    with copper in that box (109 nets), protects the rest, and routes them again
    with the 15 DACS nets first, at 0.10 mm. A temporary L4 keep-out under the
    BGA keeps the +3V3_D plane whole. DRC: 0 errors, 30 unrouted.
    [CSI2-KRIA-KV260_Rev01.kicad_pcb]
2026-10-13 build_board.py: BB_ADC=mirror and BB_ROT placement knobs; Default clearance 0.10 mm as in the project
    BB_ADC=mirror places the two ADC sheets mirrored in x, the ADC next to the
    FPGA and its front end outboard at the ADC's input side, so the ADCs' LVDS
    pairs no longer cross the front ends. BB_ROT fixes a part's rotation. Both
    off by default: the default placement is unchanged.
2026-10-14 Routing: ADCs placed next to the FPGA, front ends outboard; 30 -> 24 unrouted, 0 errors
    The ADCs' LVDS pairs ran over their own front ends, which sat between each
    ADC and the BGA: the front ends' analogue nets could not be routed and fast
    lines crossed the amplifier inputs. build_board.py now places both ADC sheets
    mirrored (BB_ADC=mirror, BB_ROT=U501:0,U601:270, the defaults). Of three
    variants routed in parallel, this one reached 23 with 3 errors; one +1V8_D
    track redrawn clear of ball A3, supply tracks the router put on L2 moved to
    L4 (three removed, one +3V3_D connection left open). Every front-end net is
    routed. fix_gap.py: --nozones.
    [CSI2-KRIA-KV260_Rev01.kicad_pcb]
2026-10-14 Routing: DACS region pass with the open DACS nets first; 24 -> 20 unrouted, 0 errors
    Three region passes in parallel; the one that routed the six still-open DACS
    nets first, then the rest of the bus, won. It also closed the open +3V3_D
    connection and took XADC_GND off L5: L2 and L5 carry only GND.
    [CSI2-KRIA-KV260_Rev01.kicad_pcb]
2026-10-19 Routing: 3.5 mm ring round the BGA, region pass over the whole BGA; 20 -> 15 unrouted, 0 errors
    The wider part-free ring (BB_RING=3.5, now the default) routed best of three
    placements. Its third finishing pass was taken after nudge_vias.py fixed four
    0.1493/0.15 mm rounding errors; the +3V3_D tracks on L2 removed, a region pass
    over the whole BGA with an L4 keep-out, a supplies-only finishing pass, one
    ADCR_D1_N leg moved off L2 and a duplicate ADCR_D4_N via merged. L2 and L5
    carry only GND; 0 parity problems.
    [CSI2-KRIA-KV260_Rev01.kicad_pcb]
2026-10-19 Routing: supplies-only finishing pass on a 0.025 mm grid; 15 -> 14 unrouted, 0 errors
    [CSI2-KRIA-KV260_Rev01.kicad_pcb]
2026-10-26 Tool paths found per machine instead of fixed E: paths
    _work/toolpaths.py and _work/layout/toolpaths.sh find kicad-cli (KICAD_CLI, PATH, the KiCad 10
    install folders) and take router from the environment (mise.local.toml). setup_krt.sh clones
    the autorouter at the routed commit, applies the local patch, makes its venv and builds it.
    planechk.py checks the GND planes and L4 under the BGA after a routing pass.
    [check_sheet.py, render_sheet.py, toolpaths.py]
2026-10-26 Routing: 38 supply stubs in L4 keep-outs removed (KiCad 10.0.6 DRC); 14 unrouted, 0 errors
    drop_dangling.py now also removes supply tracks the DRC reports as items not allowed.
    [CSI2-KRIA-KV260_Rev01.kicad_pcb]
2026-10-27 Routing: escape vias for the stuck BGA balls, blockers re-routed; 14 -> 13 unrouted, 0 errors
    [CSI2-KRIA-KV260_Rev01.kicad_pcb]
2026-10-27 Routing: a second escape round; 13 -> 12 unrouted, 0 errors
    Docs corrected: 28 vias sit in BGA ball pads (25 placed by the router before), all filled and capped.
    [CSI2-KRIA-KV260_Rev01.kicad_pcb]
2026-10-27 Routing: a third escape round; 12 -> 11 unrouted, 0 errors
    [CSI2-KRIA-KV260_Rev01.kicad_pcb]
2026-10-27 Routing: local region pass for MODE_M1, HK_SCL re-closed on L4; 11 -> 10 unrouted, 0 errors
    [CSI2-KRIA-KV260_Rev01.kicad_pcb]
2026-10-27 Routing: a closing pass (escapes, local region pass, finishing); 10 -> 9 unrouted, 0 errors
    [CSI2-KRIA-KV260_Rev01.kicad_pcb]
2026-10-27 Routing: local pass at J101 may rip LVDS copper (CLASSES); HK_SDA closed, 9 -> 8 unrouted, 0 errors
    [CSI2-KRIA-KV260_Rev01.kicad_pcb]
2026-10-27 Routing: ADCS_D1_P closed with a local LVDS pass, PROGRAM_B re-closed; 8 -> 7 unrouted, 0 errors
    [CSI2-KRIA-KV260_Rev01.kicad_pcb]
2026-10-27 Routing: ADCS_FCO_P closed with a local LVDS pass; 7 -> 6 unrouted, 0 errors
    [CSI2-KRIA-KV260_Rev01.kicad_pcb]
2026-10-28 Routing: beam search on a compute cluster closes F_DACS_D10 and a +3V3_D connection (SW_CTRL1 opens); 6 -> 5 unrouted, 0 errors
    [CSI2-KRIA-KV260_Rev01.kicad_pcb]
2026-11-03 Routing: +3V3_D closed by a search pass (J_LINK_TX_D0_P closed, D0_N opened at J101 before); duplicate U401 Q2 via merged; 5 -> 4 unrouted, 0 errors
    [CSI2-KRIA-KV260_Rev01.kicad_pcb]
2026-11-03 Routing: LINK_RX_D1_P closed after moving C105 off the J101 pad field and a fan-out/diff-pair pass (CONV_SPI_SDIO opened), then CONV_SPI_SDIO closed by a beam search round; 4 -> 3 unrouted, 0 errors
    LINK_RX_D1 now runs as two single tracks with 43 mm of skew: to be checked or re-routed as a pair (docs/LAYOUT.md 6.2).
    [CSI2-KRIA-KV260_Rev01.kicad_pcb]
2026-11-09 Routing: ADCS_D1_N closed by ripping its corridor to U601 and routing it first, then a beam search on a compute cluster re-closed the five nets it opened but J_LINK_TX_D0_N and SW_CTRL1; 3 -> 2 unrou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
    [CSI2-KRIA-KV260_Rev01.kicad_pcb]
2026-11-10 Routing: J_LINK_TX_D0_N routed by hand (A* over F.Cu/In2.Cu/B.Cu with clearance checks): up from J101 pad 26 through a cut in the B.Cu GND track, down In2.Cu to C108; J101 pad 31 given its own GND tr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
    [CSI2-KRIA-KV260_Rev01.kicad_pcb]
2026-11-10 Routing: SW_CTRL1 routed by hand (finding the fewest items to move): GND cut under C9, ADAR6_TR via and an ADAR8_TX_LOAD segment re-routed; ball B8 given a GND via, F_DACR_D6 and SW_CTRL0 re-routed r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
    [CSI2-KRIA-KV260_Rev01.kicad_pcb]
2026-11-10 LAYOUT §6.4: LVDS skew review with lvds_skew.py (per-layer delay, AC-cap legs joined, coupling): LINK_RX_D0/D1 and ADCS_FCO P-N skews to fix before ordering, the rest tolerable or fine; data-to-clock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
2026-11-10 Prepare for publication: README rewritten for the finished board (renders, schematic and layout PDFs, sheet previews, status and open items); HANDOFF given the current state and no local paths; legac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
    [add_wires.py, convert_labels_to_hier.py, debug_coords.py, debug_findblock.py, debug_orphans.py, fix_frontend.py, inventory.py, phaseA1_purge.py]
2026-11-10 Routing history and working notes moved out of the public repository; LAYOUT §6 keeps the routed board's figures, what is left and the LVDS review; comments and links updated
2026-11-10 LAYOUT §6.3: the reviewed board's commit id after the history rewrite
2026-11-10 LVDS skew fixed: LINK_RX_D1 both legs and LINK_RX_D0_N re-routed, ADCS_FCO_N routed through R1114 (fly-by, its 55 mm stub gone), short legs meandered on L1/L6 (LINK_RX_D0_P, ADCS_FCO_P, ADCS_D1_N, AD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
    [CSI2-KRIA-KV260_Rev01.kicad_pcb]
2026-11-10 LVDS termination stubs fixed: R1113, R1109, R1111, R1112 moved next to the FPGA where their pairs part (ADCS_DCO stubs 134/73 -> 9/27 ps, ADCR_DCO 34/79 -> 0/12, ADCS_D0 N 66 -> 7, ADCS_D1 N 56 -> 2;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
    [CSI2-KRIA-KV260_Rev01.kicad_pcb]
2026-11-10 README: why the 2116A stack must be ordered explicitly (the calculator's default 3313 would put the 183 um RF lines at about 45 ohm); LAYOUT 3 and POWER_AND_STACKUP 2.6: the 'run JLCPCB's calculator 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
2026-11-10 JLCPCB quote (not ordered): docs/JLCPCB_QUOTE.md with the bare-board price from JLCPCB's quote page (5 boards, stack 2116A, ENIG, POFV, 0.2 mm vias: $236.88), Standard PCBA fees from its price page (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
    [lcsc_parts.csv, quote.csv]
2026-11-11 RF/high-speed review: RF band rebuilt (183 um switch-SMA legs, bias parts on the bottom, SMA ground vias and L2-L4 cut-out under the SMA pads; openEMS return loss 13.5 -> 24.5 dB at 1 GHz), RF50 net 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
    [CSI2-KRIA-KV260_Rev01.kicad_pcb, lvds_eye.csv, pdn_1V0.csv, pdn_1V8_D.csv, pdn_2V5.csv, pdn_3V3_D.csv, sma_cutout.csv, sma_line.csv]
2026-11-11 ESD protection: PESD5V0F1BL (0.4 pF, bidirectional) on all 12 SMAs (D961-D970, D401, D402), 2.15 mm from the SMA pad with the ground pad on its own via; TPD4E05U06DQAR arrays on the Pmod (U1108, U110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
    [CLOCK.kicad_sch, CONTROL.kicad_sch, CSI2-KRIA-KV260_Rev01.kicad_pcb, ROUTING.kicad_sch, lcsc_parts.csv]
2026-11-11 ESD: D966 and D968 ground pads get their own GND via (0.95 mm, 0.3 mm track); every SMA TVS now returns to the planes within 1 mm. DRC 0/0/0
    [CSI2-KRIA-KV260_Rev01.kicad_pcb]
2026-11-11 ESD arrays: GND vias butted to U1108/U1109 pin 8 (was 1.6-1.8 mm of track to the nearest GND via; U1110 already has one in pin 3). DRC 0/0/0
    [CSI2-KRIA-KV260_Rev01.kicad_pcb]
2026-11-11 Package delays and every simulation re-run on the final board: lvds_skew.py adds each XC7A50T-FTG256 ball's package flight time (Vivado get_package_pins MIN/MAX_DELAY, 35-133 ps, in _work/layout/xc7a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
    [CSI2-KRIA-KV260_Rev01.kicad_pcb, lvds_eye.csv, pdn_1V0.csv, pdn_3V3_D.csv, sma_cutout.csv, sma_line.csv, sma_plain.csv, sma_tvs.csv]
2026-11-11 VCCINT bottom-side decoupling: four 0.47 uF 0402 (C1184-C1187, LCSC C47339) on the bottom face inside the XC7A50T's footprint, each pad on a +1V0 or GND ball via (POFV), loops 0.60-0.71 nH against 1.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
    [CONTROL.kicad_sch, CSI2-KRIA-KV260_Rev01.kicad_pcb, lcsc_parts.csv]
2026-11-11 SMA ESD diodes tuned out: each SMA line is 0.1 mm for 0.76 mm before and 1.4 mm after its PESD5V0F1BL (series L either side of the 0.4-0.5 pF shunt, a pi section near 50 ohm), the pour kept 0.24 mm o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
    [CSI2-KRIA-KV260_Rev01.kicad_pcb, pdn_1V0.csv, sma_tvsn08_14.csv]
2026-11-11 Third review pass: return vias at LVDS layer changes 21 -> 1 beyond 3 mm (18 more ground vias at the class clearance, a +2V5 and an I2C track moved aside for two of them); legs of different LVDS pair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
    [CSI2-KRIA-KV260_Rev01.kicad_pcb]
2026-11-11 8 layers, step 1: board moved to JLC08161H-2116A (L1 SIG, L2 GND, L3 SIG, L4 PWR, L5 GND new, L6 SIG new, L7 GND, L8 SIG); outer layers and their prepreg unchanged, the old power layer's signal track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
    [CSI2-KRIA-KV260_Rev01.kicad_pcb]
2026-11-12 8 layers, step 2: LVDS re-routed on JLC08161H-2116C, 9 of 19 pairs coupled at 100 ohm (0.10/0.15 mm on L3/L6, 0.09/0.12 mm under the FPGA), the other ten as 50 ohm legs matched to +-5 ps; every pair'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
    [CONTROL.kicad_sch, CSI2-KRIA-KV260_Rev01.kicad_pcb, IAS_LINK.kicad_sch]
2026-11-12 Comparisons only as ideal / 6 layers / 8 layers: README simulation section rebuilt on the rev04 plots (eyes, eye penalty, skew, PDN, SMA) with a per-pair eye table, the 10 Nov narrow-leg and 11 Nov-o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
2026-11-12 8-layer bare boards quoted on JLCPCB's page: $282.92 for 5 (JLC08161H-2116C, ENIG, POFV, 0.2 mm vias, +-10 % impedance), $46.04 more than 6 layers (engineering fee 99 against 33, board 11.90 against 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
2026-11-12 ADCR_DCO legs swapped at the FPGA (N14 = DCO_N, P14 = DCO_P; INVERTED in control_spec.py, the gateware inverts the clock) and re-routed coupled: 38.9 mm instead of 51.6, 89 % coupled, P-N +2 ps; ADCR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
    [CONTROL.kicad_sch, CSI2-KRIA-KV260_Rev01.kicad_pcb]
2026-11-12 Title blocks to Rev04 (the 8-layer board): rev 04 on the board and all ten schematic sheets (schgen.py writes 04 from now on), the board's stale 'first pass' comment replaced by its stack-up; schemat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
    [ADC_RADAR.kicad_sch, ADC_SDR.kicad_sch, CLOCK.kicad_sch, CONTROL.kicad_sch, CSI2-KRIA-KV260_Rev01.kicad_pcb, CSI2-KRIA-KV260_Rev01.kicad_sch, DAC_RADAR.kicad_sch, DAC_SDR.kicad_sch]
2026-11-12 Link capacity and limits documented. IAS_LINK_SPEC 7: of the five pairs two are clocks, so 2 Gb/s towards the Kria and 1 Gb/s back; payload under 8b/10b and 64b/66b against the 1.05 Gb/s the radar DD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
2026-11-12 Rest-of-board review; supply tracks widened; Kria side of the link is DIFF_SSTL12
    Supply copper: the router had necked supply tracks and the bucks' switch nodes to 0.1 mm (the
    Power netclass sets a default width, not a minimum, and misses Net-(...) names): 1.6 A through
    0.1 mm at U1001's switch node, 0.75 A on the input path, and 251 mV drop on +1V8_A over 75 mm of
    L3. Every Power track and the four switch nodes widened where clearances allow (Power track at
    >= 0.5 mm: 119 -> 865 mm); +1V8_A drop 74 mV at 0.5 A. U1005's 50 mV ANY-OUT pin grounded:
    +1V8_A starts at 1.85 V, so the ADCs see ~1.74 V at full budget (1.7-1.9 V). POWER sheet and
    power_spec.py updated; DRC 0/0/0 with parity, zones r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
    [CSI2-KRIA-KV260_Rev01.kicad_pcb, POWER.kicad_sch]
2026-11-12 Analogue nodes cleared where tracks could move; DAC filters, thermal map and radar RF budget
    Board: widened supply tracks narrowed back to >= 0.3 mm gap where they ran beside analogue
    nodes (64 pieces); seven tracks shifted 0.15-0.5 mm away (ADAR2_CS, CONV_SPI_SDIO, +2V5, +1V8_D
    aggressors; three analogue legs). Same-layer run beside analogue nodes within 0.3 mm 91 -> 81 mm,
    within 0.2 mm 43 -> 33 mm. What is left needs the SDR DAC filter re-placed. DRC 0/0/0 with parity.
    SIGNAL_INTEGRITY 9: DAC reconstruction filters simulated with each node's copper (cut-off 70 ->
    64-67 MHz, passband unchanged, common mode >= 30 dB down in band); 2-D thermal model (6.9 W:
    +26 C mean, +48 C at the ADCLK948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
    [CSI2-KRIA-KV260_Rev01.kicad_pcb]
2026-11-12 SDR receive budget and junction temperatures: AD9253 (Rev. E) full scale -2.4/-3.0 dBm at the SMA, NF 22 dB with the ADC 80 % of the noise; junctions from ADCLK948 Rev. B, AD9253 Rev. E, AD9767 and U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
2026-11-12 CLK_ADCS re-routed as a coupled 100 ohm pair on L6 (0 -> 74/80 % coupled, neighbours within 0.3 mm 5.0 -> 1.1 mm), DRC 0/0/0 with parity; CLK_FPGA tried and left (needs R1115-R1118 re-placed); coolin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
    [CSI2-KRIA-KV260_Rev01.kicad_pcb]
2026-11-12 3-D full-wave sub-model of an LVDS pair changing layer (L1 to L6, openEMS): Sdd11 under -29 dB to 1.25 GHz with 0, 2 or 4 ground vias, the L6-L8 stub negligible; remaining 3-D sub-models listed
2026-11-12 CLK_FPGA pad resistors re-placed together east of the BGA and the pair re-routed coupled (0 -> 62/56 %, cap to ball 85/71 -> 43/46 mm); SDR DAC2 filter re-placed beside T802 with a matched pair from 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
    [CSI2-KRIA-KV260_Rev01.kicad_pcb]
2026-11-12 3-D sub-models: BGA escape (0.10 mm necks reflect under -24 dB at 1.25 GHz), J101 to the AC capacitors (Sdd11 under -25 dB, 9 % turned into common mode by the legs' different escapes), two pairs side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
2026-11-12 SIGNAL_INTEGRITY 9.6: J101 mates board to board with the KV260, the AERIS-10 ribbon is J1103; the common mode made at J101 has no cable to radiate from
2026-11-12 SIGNAL_INTEGRITY 9.6: drop an unmeasured track length on the carrier side of J101
2026-11-13 Y401 to U401 re-routed as a coupled 100 ohm pair on L3, legs matched (10.5 / 20.8 mm before); the +5V0 track beside the external reference input on L3 narrowed to 0.4 mm (gap 0.26 -> 0.56 mm). DRC 0/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
    [CSI2-KRIA-KV260_Rev01.kicad_pcb]
2026-11-13 Board saved with its zones refilled by kicad-cli (drc --refill-zones --save-board): the stored fills of eaec33a predated the new Y401 vias. DRC 0/0/0 with parity without a refill
    [CSI2-KRIA-KV260_Rev01.kicad_pcb]
2026-11-13 SDR DAC1 filter re-placed: L811, L812 and C814 on the bottom face under L813/L814 beside T801 (filter-internal nodes 51/47 -> 3/1.5 mm, 3/3 -> 2/1 vias); the DAC outputs run from the pins as a pair, 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
    [CSI2-KRIA-KV260_Rev01.kicad_pcb]
2026-11-13 Test pads and bottom fiducials: TP1-TP13, bare 1.0 mm pads on the top face for +5V0, +3V3_D, +3V3_A, +2V5, +1V8_D, +1V8_A, +1V2, +1V0, -3V3, +3V3_CLK, DONE and GND (x2), board-only like the mounting 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
    [CSI2-KRIA-KV260_Rev01.kicad_pcb]
2026-11-13 Docs for 13 Nov: DAC1 filter on the bottom face (common mode -54/-43/-37 dB, worst -24), Y401 pair coupled and matched, the external reference input cleared of +5V0, the SDR ADC input network simulat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
2026-11-13 Gigabit Ethernet as an assembly option: RTL8211FSI-CG SGMII PHY (U1201) and HR911130C RJ45 (J1201) on a tab off the east edge (bounding box 140 x 132 mm). The PHY shares LINK_RX_D0 / LINK_TX_D0 throu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
    [CONTROL.kicad_sch, CSI2-KRIA-KV260_Rev01.kicad_pcb, lcsc_parts.csv, quote.csv]
2026-11-13 C1218 (Ethernet option, DNP) back on the top face, off the underside over the carrier: at (178.9, 98.3) below the notch, a via in each pad, 0.9 mm of L3 to LINK_TX_D0_P. LINK_TX_D0 in IAS1 mode 477-4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
    [CSI2-KRIA-KV260_Rev01.kicad_pcb]
2026-11-13 3D models for every part: 26 footprints that named a model file KiCad 10 does not ship, or none, now point at a library model of the same package (FPGA as the generic 17 x 17 mm 1.0 mm-pitch BGA-256,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
    [CSI2-KRIA-KV260_Rev01.kicad_pcb]
2026-11-13 Revert the generated 3D models on the board (f4f10fa): the renders looked worse with them. Board, project footprints and renders back as before; the box models and their script kept, unused, in _work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
    [CSI2-KRIA-KV260_Rev01.kicad_pcb]
2026-11-13 Printed mount for the KV260 + adapter (docs/MECHANICAL.md): one 254 x 149 mm base whose top is the plane the KV260's rubber feet stood on, with posts under the carrier's corner holes (in place of the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
    [mount_base.stl, mount_rj45_strap.stl]
2026-11-13 IAS_LINK_SPEC 1 and INTERFACE_SPEC 6.3 brought in line with the board: R101-R104 are 10 k bias to +1V2 and the LINK_TX termination is R105/R106 (100 ohm) at the FPGA since 12 Nov; the Kria's RDRV_60_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
2026-11-13 Board renders regenerated with the Ethernet tab (the KiCad library models, as before f4f10fa); eye openings of the Ethernet option's branches as a plot (docs/sim/eth_branches.png, SIGNAL_INTEGRITY 9.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
2026-11-13 Mount renders less glossy: exposure -1.8 (AgX was washing the adapter's green out), solder mask matte and opaque, lifted off the outer copper it was z-fighting with, darker background
2026-11-13 Thermal re-run with the Ethernet PHY (7.5 W, was 6.9): still air +27/+51 C, ADCLK948 84 C, FPGA 63 C, PHY 70 C; with sink and fan every junction under 92 C at 70 C ambient, the board's hottest spot 8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
2026-11-13 Bare boards re-quoted on JLCPCB at the Ethernet tab's 140 x 132 mm bounding box: $287.96 for 5 (was $282.92 at 119 x 132; board line 15.30 vs 11.90, other fees a few cents up). Totals about $2,124 / 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
2026-11-13 docs(link): add end-to-end pin map and polarity check (PINMAP.md)
2026-11-13 rtl(link): add 64b/66b PCS modules, 2-lane deskew, CRC-32 framer, and RX training FSM
2026-11-13 fpga: add Artix Pmod J1102 SPI slave and tb_pmod_spi (Task 5)
2026-11-13 Add end-to-end ADC-DDC-PCS-Kria AXI-Stream simulation bench
2026-11-13 power: vehicle-grade input protection (LM74502-Q1, back-to-back 100 V N-FETs, SMCJ33CA)
    The RF review's finding B1: the -30 V P-FET sat ahead of the TVS, so ISO 7637-2
    pulse 1 landed across it unclamped. The input is now TI's 12 V battery design
    (LM74502-Q1 datasheet Figure 10-1), oversized: SMCJ33CA at VIN_F, DMT10H015LFG
    100 V N-FETs back to back (Q1001 keeps its footprint, Q1003 on the bottom),
    overvoltage cut-off at 18.3 V typ (17.1-19.5 V) by R1004/R1005, D1001 now
    SMBJ18CA. New bottom parts sit under the jack outside the KV260 outline.
    DRC with zones refilled and schematic parity: 0 errors, 0 unconnected,
    0 parity issues. POWER_SPEC.md section 1.1 has the values and the limits.
    [CSI2-KRIA-KV260_Rev01.kicad_pcb, POWER.kicad_sch]
2026-11-13 mech: closed vehicle enclosure with honeycomb supports, TPU bumpers and FEA
    - build_case.py: tray + lid split at the SMA centre line, six lugs closed by
    printed snap pins or stainless M4, honeycomb floor pocketed around every
    underside part (incl. the Rev05 input protection), TPU clamp pads, vents,
    optional slide-on TPU corner bumpers; STLs in mech/.
    - check_case.py: shell vs board clearance check.
    - fea_case.py / post_fea.py: CalculiX modal, 50 g shock, 1 m drop (bare and
    with bumpers) and vibration fatigue for six materials at 23/70 C.
    - render_case.py / render_mount.py: translucent solder mask so copper shows.
    - docs/ENCLOSURE.md and a README section with renders and results.
    [case_bottom.stl, case_bumper_lback.stl, case_bumper_lfront.stl, case_bumper_rback.stl, case_bumper_rfront.stl, case_lid.stl, case_pad_ring.stl, case_pad_rj45.stl]
2026-11-13 docs: re-render mount views with translucent solder mask so copper shows
2026-11-13 docs: matte solder mask in renders (roughness 0.62, alpha 0.9) to match the KV260 green
2026-11-13 Task 13: AD9253 1-lane DDR capture, 3-wire conv SPI, dual-ch SDR DDC, and XSim bench
2026-11-13 Task 15: 8x ADAR1000 SPI beamformer controller, RF switch control, and XSim bench
2026-11-13 board: act on the verified RF review findings
    - U1201 (RTL8211FSI) exposed pad: 9 GND thermal vias added (10 in all),
    clear of the In2/In5/B.Cu tracks under it (review H6).
    - DAC reconstruction filters (radar + both SDR channels): 5th-order
    Butterworth for this board's 100 ohm differential termination, values
    only (8.2p, 270n, 62p, 20p). AERIS-10's values sagged 2.0 dB from 10 to
    45 MHz here (review M1, reproduced with an ABCD model from the netlist).
    - LCSC codes for the new filter parts and for the Rev05 input protection
    (LM74502-Q1, DMT10H015LFG, SMCJ33CA, SMBJ18CA, 100n 100V, 100k, 7.32k).
    - FABRICATION.md: order and impedance tables now describe the 8-layer
    JLC08161H-2116C s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
    [CSI2-KRIA-KV260_Rev01.kicad_pcb, DAC_RADAR.kicad_sch, DAC_SDR.kicad_sch, IAS_LINK.kicad_sch, lcsc_parts.csv]
2026-11-13 rev06 schematic: Ethernet on its own outer-ring bank-34 pins, IAS1 complete; fan header
    - ETH_SGTX T4/T3, ETH_SGRX N1/P1 (+ 10k bias to +1V2, R1215/R1216), MDC R1,
    MDIO T2 (LVCMOS25), RSTN T12 (LVCMOS33). C1218-C1221 fitted as in-line AC
    caps; C101/C102/C107/C108 stay: IAS1 keeps both uplink lanes and its downlink.
    Pins confirmed by Vivado P&R (gateware task 19).
    - J1002 5 V fan header (JST PH 2), F1002 0.5 A PTC, C1092 10 uF, for enclosure v2.
    - Board not updated yet (ERC 0 errors).
    [CONTROL.kicad_sch, POWER.kicad_sch]
2026-11-13 mech: KV260-side render; right-rear bumper kept clear of the KV260's RJ45
    - render_case.py: new 'kria' view of the rear wall with the KV260's connectors.
    - build_case.py: each bumper arm along the front/rear wall stops 4 mm short of
    that wall's openings (right-rear arm 22 -> 11.3 mm); the old one half covered
    the RJ45 opening. case_bumper_rback.stl re-exported, renders refreshed.
    - .gitignore: _scratch/ (board work copies).
    [case_bumper_rback.stl]
2026-11-13 rev06 schematic: final Ethernet pins, set by what the board can escape
    SGTX R2/R1, SGRX R3/T2 (bank 34, LVDS_25), MDC P1 (LVCMOS25), MDIO M15
    (bank 14, LVCMOS33 driven open-drain, pulled up to the PHY's 2.5 V), RSTN K13.
    T4/T3 and N1 were walled in by matched LVDS legs; P5 sat on a +3V3_D run.
    [CONTROL.kicad_sch]
2026-11-14 Add KiCad 3D models, cache mapping, and model audit docs for Rev01 PCB
    [BGA-256_17.0x17.0mm_Layout16x16_P1.0mm_Ball0.5mm_Pad0.4mm_NSMD.step, HSOP-8-1EP_3.9x4.9mm_P1.27mm_EP2.41x3.1mm.step, LFCSP-32-1EP_5x5mm_P0.5mm_EP3.6x3.6mm.step, QFN-56-1EP_8x8mm_P0.5mm_EP4.5x5.2mm.step, TQFN-48-1EP_7x7mm_P0.5mm_EP5.1x5.1mm.step, Texas_VQFN-RGR-20-1EP_3.5x3.5mm_Pitch0.5mm.step, UQFN-48-1EP_6x6mm_P0.4mm_EP4.45x4.45mm.step, WQFN-16-1EP_3x3mm_P0.5mm_EP1.6x1.6mm.step]
2026-11-14 Add Task 16 housekeeping I2C, Si549 XO, XADC/PPS controllers and LINK_PROTOCOL §7.2 registers
2026-11-14 mech: add Enclosure v2 3D CHT CFD study, plots, and thermal report
2026-11-14 docs: 3D_MODELS relative links (no local paths) and KiCad library attribution
2026-11-14 mech: enclosure v2 - adapter fan in a duct under a filtered second grille
    build_case.py --v2: a 50 x 50 x 10 mm 5 V fan centred over the adapter's hot strip
    (U401, Y401, U501, U502/U503, U1201), hung in a 1.2 mm duct 4 mm below the ceiling,
    M3 fan screws into the duct's corner bosses; a second hex grille with a 58 mm recess
    for a 100-mesh stainless filter under a printed frame (case_v2_filter_frame.stl);
    SMA-wall slots closed (the fan runs the box at overpressure); 13 right exhaust slots.
    v1 is unchanged. render_case.py --prefix, fan and frame follow the lid. ENCLOSURE.md
    section 6 with the v2 renders; the as-built geometry goes back to CFD (Gemini).
    [case_v2_bottom.stl, case_v2_filter_frame.stl, case_v2_lid.stl]
2026-11-14 rev06 board: Ethernet on its own pins routed, IAS1 complete; fan header placed
    - SGTX R2/R1 and SGRX R3/T2 from vias in the balls, as 50 ohm legs matched end
    to end (SGTX P-N +2 ps, SGRX -4 ps, stubs <= 9 ps), AC caps on the bottom by
    the PHY. LINK_RX_D0_N's corner meander moved out (pair back to 0 ps).
    - SGRX bias: R1215/R1216 sit on the legs beside C1218/C1219 and go to a local
    ETH_VCM (R1212 10k / R1217 5.6k from +3V3_D = 1.18 V, C1222); +1V2 was 30 mm
    away and hung them off the legs as 75-157 ps stubs (rev06_vcm.py).
    - MDC P1, MDIO M15, RSTN K13 routed. The corner's slow nets and the bank-34 VCCO
    feed were ripped and re-routed around the new legs.
    - J1002 fan header, F1002 PTC,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
    [CONTROL.kicad_sch, CSI2-KRIA-KV260_Rev01.kicad_pcb]
2026-11-14 board: real 3D models for the 26 parts that rendered without a body (Gemini task 20)
    KiCad library STEPs for the BGA, QFNs, LFCSP, HSOP and WQFN parts; EasyEDA models
    (local cache) for the baluns, Si549, PTC, power inductors, barrel jack, IAS
    connectors and RJ45. README board renders regenerated (Rev06 + models).
    [CSI2-KRIA-KV260_Rev01.kicad_pcb]
2026-11-14 rev06: docs, BOM codes, enclosures and renders on the Rev06 board
    - CONTROL_SPEC section 8: Rev06 Ethernet pins and why, the local SGRX bias,
    routing results and the bank-34 VCCO compromise; POWER_SPEC 1.2: fan header.
    - LCSC: PTC 0.5 A (C43379), JST PH 2-pin (C131337), 5.6k (C25908).
    - Assembly rebuilt from the Rev06 board (with its 3D models): case v1 and v2
    honeycomb now pocket the new bottom-side parts (497 -> 514 pockets); all case,
    case v2 and mount renders regenerated.
    [case_bottom.stl, case_v2_bottom.stl, lcsc_parts.csv]
2026-11-14 quote: Rev06 re-priced (parts +$20 for two boards, feeders +$12)
    [quote.csv]
2026-11-14 rev06 board: SGMII legs widened to 50 ohm, +1V8_A 0.1 mm neck removed
    widen.py on the ETH legs (SGTX eye 595 -> 616 mV, SGRX 518 -> 521 mV, jitter
    70 -> 58 ps) and on +2V5/+3V3_D/+1V8_A. The +1V8_A trunk to the ADC drivers'
    ferrites had a 0.1 mm diagonal jog on L3 carrying 0.5 A (inherited from Rev05):
    now a 1.0 mm L. DRC 0 errors, parity 0.
    [CSI2-KRIA-KV260_Rev01.kicad_pcb]
2026-11-14 enclosure + renders: one cut-out per KV260 connector, 12 V jack and ribbon openings, real RJ45, true materials
    - build_case.py:
    - the KV260's rear I/O gets one cut-out per connector (1 mm round each face) with ribs of at least 1.6 mm
    between them, instead of one merged window;
    - a 12 mm round-topped U from the shells' joint for the adapter's J1001, which sits 3.5 mm inside the wall,
    so the plug's moulded body can enter;
    - a 54 x 2.6 mm lid slot over J1103 for the ribbon to AERIS-10's ADAR1000 boards;
    - the rear lug moved from X -40 to -20, clear of the jack;
    - the label moved to Y 96, clear of the slot.
    - v1 and v2 rebuilt, STLs re-exported. check_case: only the intended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
    [case_bottom.stl, case_bumper_rback.stl, case_lid.stl, case_v2_bottom.stl, case_v2_lid.stl]
2026-11-14 enclosure 3-D FEA with both boards, and the Rev06 pre-order review
    - fea3d_export.py / fea3d_case.py / render_fea3d.py / compose_fea3d.py: the printed tray and lid as built, the
    adapter's FR-4 body, the KV260 carrier PCB, the H1/H2 spacers and the Hirose pair, united and meshed by
    fTetWild (C3D10, ~205 k tets). Material per tet. Tets joined to the rest only by an edge or a vertex are dropped
    (they made v2 singular). Loads: 50 g down, sideways and fore-aft; the ears held at the M5 washers.
    Case: von Mises from strain against the across-layer strength. Boards: max principal strain, also at the BGAs.
    - Results (v2; v1 alike), 50 g down:
    - case 99.7th pct 3.6 MPa, safety factor 8.1 at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
2026-11-14 Add full-system XSim co-simulation (tb_system) and fix mux/link RTL bugs
    [ad9253_sdr_model.v, ad9484_radar_model.v, adar1000_array_model.v, board_lvds_channel.v, dac_monitor_models.v, dual_path_mux.v, hk_i2c_periph_models.v, kria_pl_link.v]
2026-11-14 FB401: 2 A, 0.1 ohm bead for the Si549's supply margin; Y1201 crystal model with a nickel lid
    The 600R 1 A bead (0.2 ohm max) dropped up to 97 mV at the clock branch's 483 mA,
    which could take +3V3_CLK to 3.128 V at +3V3_D's low tolerance, under the Si549's
    3.135 V. FB401 is now the 220R 2 A bead already on the BOM (C304314, same 0603
    footprint): 48 mV drop, 42 mV of margin. _work/power/fb401_filter.py models the
    filter with the bead's inductance swept under DC bias: the 580 kHz ripple on
    +3V3_CLK stays at 0.1-2 mVpp, the Si549 spur under -110 dBc.
    Y1201 uses a copy of KiCad's 3225 crystal STEP whose lid is nickel grey instead
    of near-white.
    [CLOCK.kicad_sch, CSI2-KRIA-KV260_Rev01.kicad_pcb, Crystal_SMD_3225-4Pin_3.2x2.5mm.step, lcsc_parts.csv]
2026-11-14 enclosure v2 fan on show, stress and strain rendered on the parts, no white parts left
    - Version 2's fan is a real 5010 model (rounded frame, holes, seven swept blades,
    hub and struts), and a new view case_v2_fan opens the lid like a clamshell so the
    fan faces the camera above the adapter's hot strip.
    - render_fea3d_hero.py / compose_fea3d_hero.py: Cycles renders of the 3-D FEA, the
    case coloured by von Mises stress with its peak called out, the boards by
    principal strain with the three BGAs called out.
    - README shows version 2 and the 3-D strength results.
    - Colours: the Si549 lid, the RJ45 shell (and its amber LED) and the CD542
    transformers are no longer near-white in either ren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
2026-11-14 mech: verify built enclosure v2 3D CHT thermal performance and propose grille/heatsink fixes
2026-11-14 enclosure v2: open intake, wider exhaust, decoupled heatsinks after the built-v2 CFD
    The 3-D CFD of v2 as built (Gemini, task 23) found the Si549 0.5-2 C over its
    limit at 70 C: U401's and Y401's 9 x 9 sinks touched, and the double honeycomb
    intake and 13 exhaust slots held the fan to 2.57 CFM. Adopted its three fixes:
    a 47 mm spoke-ring intake (86 % open) on the lid and the filter frame, 17 right
    wall slots of 3.5 x 21 mm, and the two sinks cut to 9 x 7 mm, 4 mm apart.
    With them every adapter IC passes at 70 C (Si549 101.7 C, XC7A50T 91.3 C).
    Re-ran the 3-D FEA of both cases: the tet-mesh cache was not keyed on the
    geometry and had been reusing an old mesh; it now hashes the surface. Resul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
    [case_v2_filter_frame.stl, case_v2_lid.stl]
