PabloSoage/kv260-ias2rf/(notices)

Notices in the files:
mech/models3d/UQFN-48-1EP_6x6mm_P0.4mm_EP4.45x4.45mm.step:
Copyright (C) 2017, kicad StepUp
This program is free software: you can redistribute it and/or modify
it under the terms of the GNU General Public License as published by
the Free Software Foundation, either version 3 of the License, or
any later version.
itself might be covered by the GNU General Public License.
mech/models3d/QFN-56-1EP_8x8mm_P0.5mm_EP4.5x5.2mm.step:
Copyright (C) 2018, kicad StepUp
This work is licensed under the [Creative Commons CC-BY-SA 4.0 License](https://creativecommons.org/licenses/by-sa/4.0/legalcode),
with the following exception:
To the extent that the creation of electronic designs that use 'Licensed Material' can be considered to be 'Adapted Material',
You are free to use the library data in your own projects without the obligation to share your project files under this or any other license agreement.
mech/models3d/WQFN-16-1EP_3x3mm_P0.5mm_EP1.6x1.6mm.step:
Copyright (C) 2020, kicad StepUp
mech/models3d/TQFN-48-1EP_7x7mm_P0.5mm_EP5.1x5.1mm.step:
Copyright (C) 2024, KiCAD
This work is licensed under the
[Creative Commons CC-BY-SA 4.0 License](https://creativecommons.org/licenses/by-sa/4.0/legalcode),
project files under this or any other license agreement. However, if you wish to distribute
mech/models3d/LFCSP-32-1EP_5x5mm_P0.5mm_EP3.6x3.6mm.step:
Copyright (C) 2022, KiCAD
mech/models3d/HSOP-8-1EP_3.9x4.9mm_P1.27mm_EP2.41x3.1mm.step:
Copyright (C) 2025, KiCAD
mech/models3d/BGA-256_17.0x17.0mm_Layout16x16_P1.0mm_Ball0.5mm_Pad0.4mm_NSMD.step:
Copyright (C) 2026, KiCAD
